iThinkiKhan/gladiator-cad/cad/v2/README.md

# Gladiator v2 frame and body, 2026-10-13 to 2026-10-15 (Claude)

Everything designed in the enclosure/rails chat. Drafts: nothing here has been printed or fitted. Source scripts rebuild every part (`freecadcmd <script>`).
Codex's concept (`cad/enclosure/concept-20261013/`) is the untouched source of the chassis references and stays where it was.

| Folder | What | Status |
|---|---|---|
| `rails/v4-20261015/` | slim arch rails: direct heat-set inserts, deck pegs, shell hard points, switch shelf (right rail) | print-ready plate R |
| `upper-deck/v3-20261015/` | deck that seats on the rail pegs, one retention screw per rail, wire holes, bed-side chamfers | print-ready plate D |
| `print-plates/` | OrcaSlicer plates R (rails) and D (deck), PLA, `START_HERE_v2-plates.txt` | ready for Jim to start |
| `switch-enclosure/v1-20261015/` | open-rear power switch enclosure + bezel, rail-shelf or hood-shelf mount | draft |
| `enclosure/v2-20261013/` | optional shell v2.3: rear hood, two front panels, lens plate; removal sweeps verified | draft |
| `antenna-pylon/v3-20261014/` | replacement SMA pylon (bolt head not recessed) | draft |
| `ina-mount/v3-20261019/` | INA226 upright adapter clipped to the tray's rear wall (header left, terminals right) | draft, plate IM |
| `switch-enclosure/v3-20261016/` | switch holder (rear-open, one M3, M2 side screws) for the rail shelf or the hood cradle | draft, plate SW |
| `upper-deck/v4-20261016/` | deck v4.1 on the measured rails | **printed, fits** |
| `rails/v3-20261014/` | superseded portal rails, kept as record | superseded |
| `images/` (Windows mirror only) | review renders and sections | |

Print order: rails (R), then deck (D). Print the rails first: they carry the inserts and pegs the deck depends on.
