iThinkiKhan/gladiator-cad/cad/mast-base/reprint-20260926/README.md

# Mast base reprint — 2026-09-26

Source: current `cad/master/Gladiator_Master.FCStd`, copied before editing. The master was not changed.

- Spigot below deck: 5.0 → 3.5 mm (1.5 mm shorter); diameter remains 14.0 mm.
- Mast socket upper entry: 0.35 → 0.8 mm by 45°; straight bore remains 20.4 mm.
- Print orientation: upside down with spigot up. The thin collar ring touches the bed; use a brim and support under the outer plate.
- Editable source: `Gladiator_Master_MastBase_short-spigot.FCStd` (whole assembly).
- Print mesh: `Gladiator_MastBase_spigot-3p5_chamfer-0p8_UP.stl`.
- An identical mesh was placed in `~/3D-Printer/Incoming`.
