iThinkiKhan/gladiator-cad/ROUND5_CURRENT.md

# Current Round5 release

cad/v2/enclosure/round5-calibrated-28-20261022/mount-checked-release/DELIVERY/START_HERE.md

Hood9h39m04 and combined panels7h00m34;corrected mounting CAD. Ready files in X:/3D Printer and Incoming Round5_MOUNT_CHECKED_20261022. Earlier hood/CAD superseded. No printer started.
