iThinkiKhan/gladiator-cad/docs/ai/agents/codex-m2-d3-l3-coupon-20261022.md

# M2 D3 L3 coupon — Codex, 2026-10-22

Jim supplied a listing screenshot: M2 x D3 x L3 (100 pcs). Treat 3 mm OD and 3 mm length as nominal listing data pending stock measurement. The listing's 2 mm item diameter / 2.2 mm groove are not pilot-bore dimensions.

New isolated package: cad/coupons/m2-d3-l3-20261022/. 80 x 25 x 9.89 mm coupon, 2.60–3.30 mm diameters in 0.10 steps, 8 vertical + 8 horizontal blind bores, 3.60 depth, 0.15 entry chamfer. Labels over each bore. Existing M2-A and production CAD preserved.

Native/STEP reopen, all 16 bore void/floor/wall checks, manifold STL, 3MF/STL agreement, and OrcaSlicer 2.4.2 slice without warnings passed. EnderNeo PLA profile, 0.20 layers, 4 walls, 25% infill, no supports. New named 3MF copied to Incoming; no print started. Editable builder, README, results CSV and verification JSON included.

Next: check stock OD/length; print and test using intended project material/profile; report separate upright and horizontal winners and installation conditions. Confirm repeatability with fresh inserts before applying bore values. No winner recorded as measured and no project bore changed.

## Simplified at Jim's request, 2026-10-22

Current choice: cad/coupons/m2-d3-l3-mini-20261022/, four upright bores 2.8/2.9/3.0/3.1, depth 3.6, 40 x 13 x 6 mm. Native/STEP/STL and four blind-bore checks pass; Orca slice without warnings. Replaced only the previously generated named Incoming coupon with this smaller version. The earlier full package remains preserved. Physical winner pending; horizontal fit untested by the mini coupon.
