iThinkiKhan/gladiator-cad/cad/v2/switch-enclosure/v2-20261016/README.md

# Switch enclosure v2 - ON HOLD, 2026-10-16

Jim's switch is already wired and cannot be unwired, so the v1 box (switch pushed in from the front, pins through a rear window) cannot take it. I drafted v2 (open top and open rear, wired switch drops in, lid screws over it) and Jim then said he wants the switch box to be
essentially what he already has, with dedicated mount points on the rails and the shell, mounted from the shell interior, and the rails NOT reprinted. v2 is therefore not released: no plate is queued. The geometry is kept (`build_switch_box_v2.py`) in case it is useful.

Superseded by `../v3-20261016/` (the holder Jim already has, slightly stronger, with the new mount).
