iThinkiKhan/gladiator-cad/cad/antenna/v3-screw-access/preview-axo.png

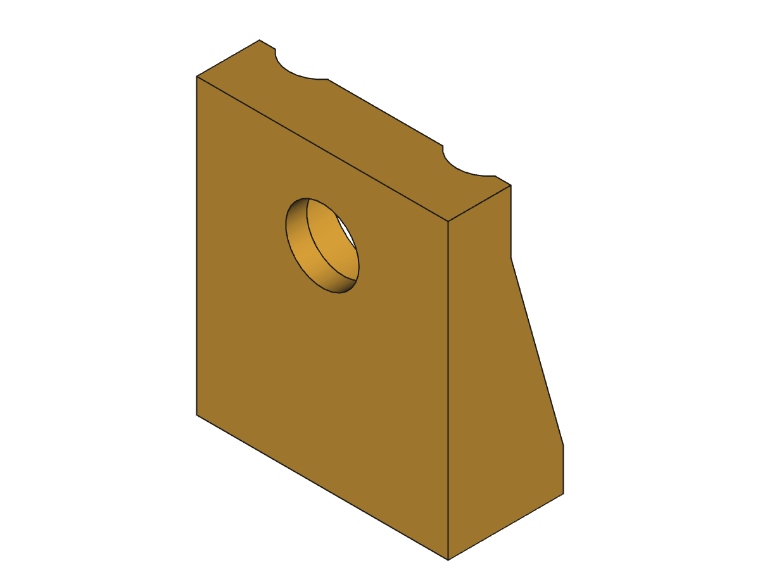
cad/antenna/v3-screw-access/preview-axo.png
