iThinkiKhan/gladiator-cad/cad/antenna/v3-screw-access/preview-screw-access.png

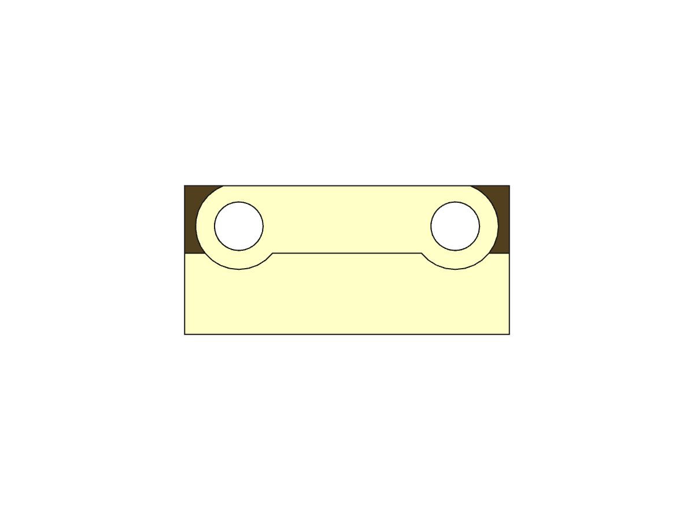
cad/antenna/v3-screw-access/preview-screw-access.png
