iThinkiKhan/gladiator-cad/cad/coupons/m2-d3-l3-20261022/preview.png

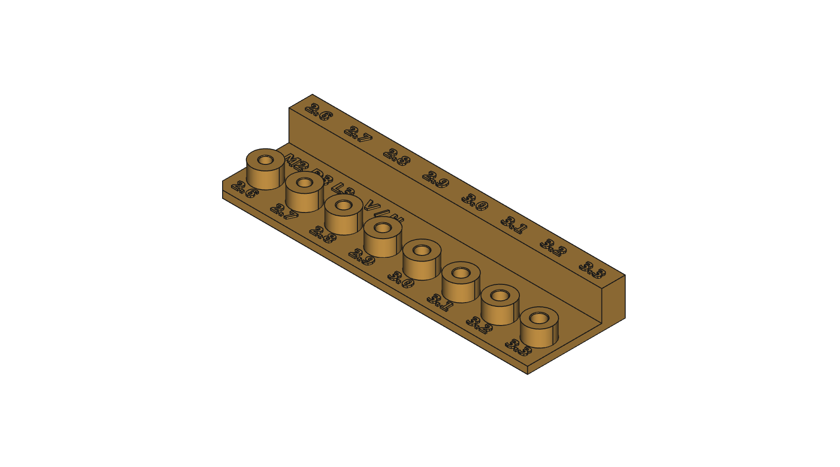
cad/coupons/m2-d3-l3-20261022/preview.png
