iThinkiKhan/gladiator-cad/cad/drivers/v5-interlock/preview-coupon.png

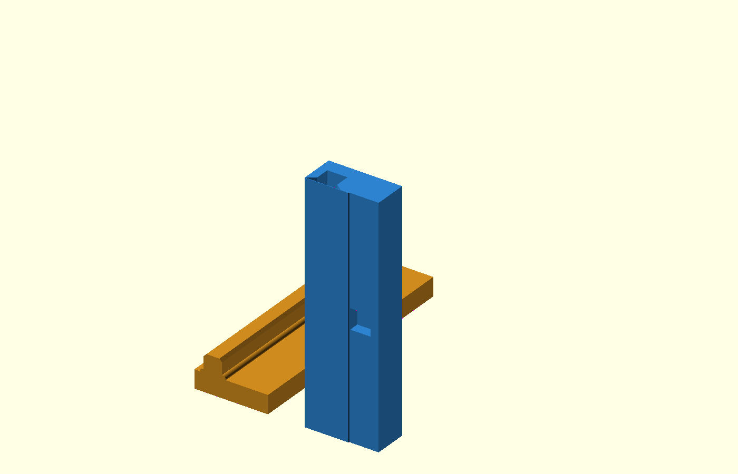
cad/drivers/v5-interlock/preview-coupon.png
