iThinkiKhan/gladiator-cad/cad/drivers/v5-interlock/preview-structural.png

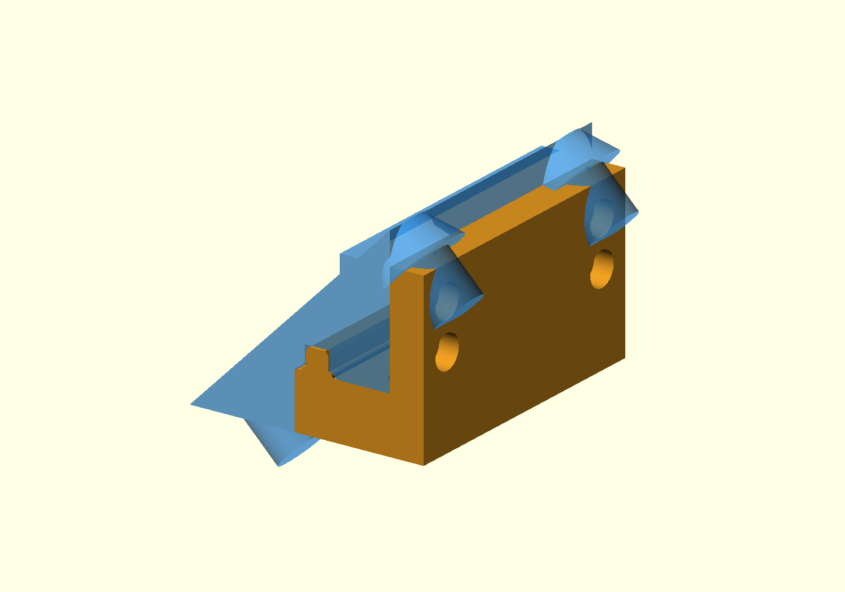
cad/drivers/v5-interlock/preview-structural.png
