iThinkiKhan/gladiator-cad/cad/enclosure/concept-20261013/body.png

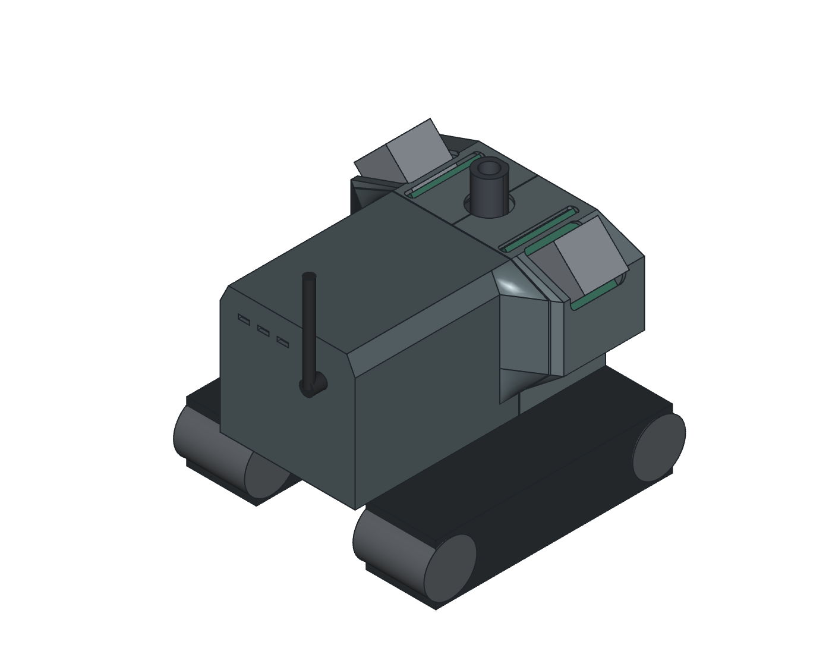
cad/enclosure/concept-20261013/body.png
