iThinkiKhan/gladiator-cad/cad/head/drive-coupons-20260922/preview-section.png

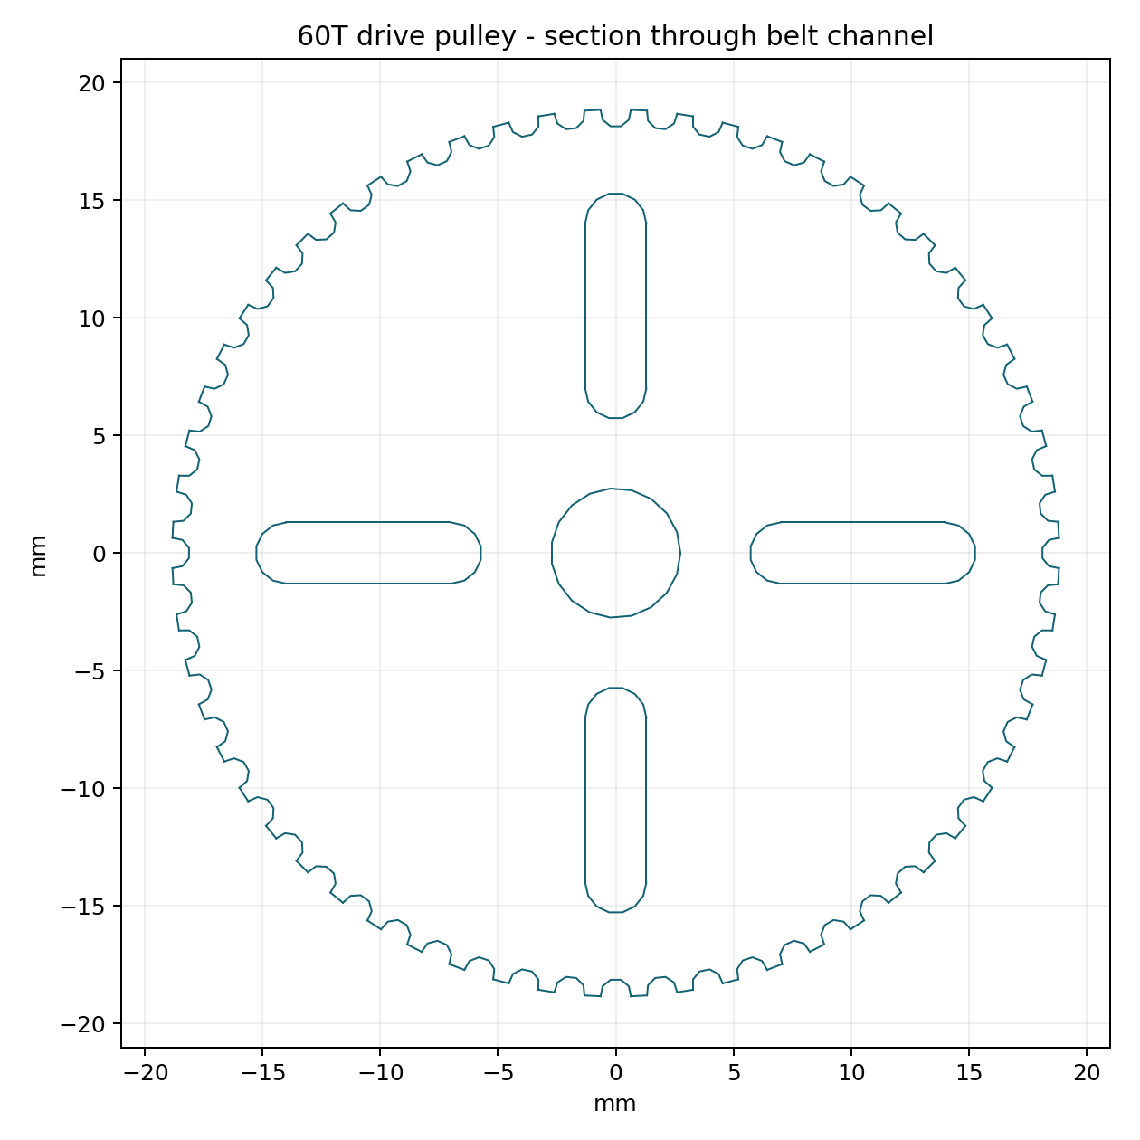
cad/head/drive-coupons-20260922/preview-section.png
