iThinkiKhan/gladiator-cad/cad/head/esp32-cam-case-v4/case_preview.png

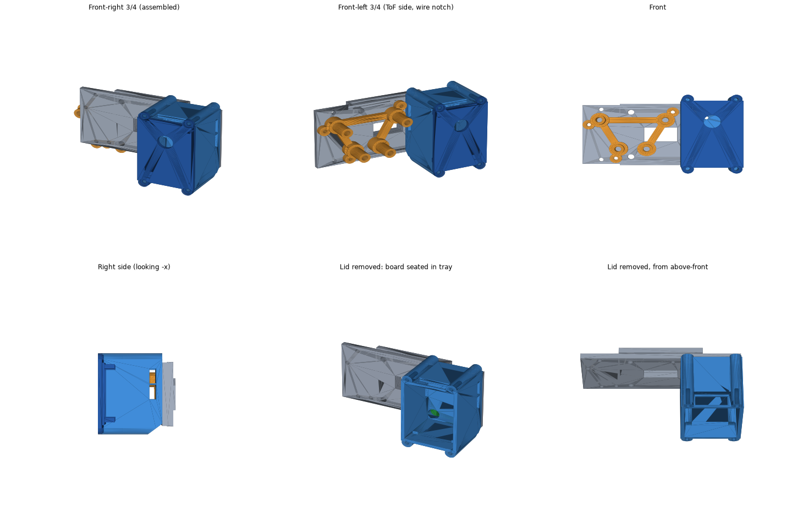
cad/head/esp32-cam-case-v4/case_preview.png
