iThinkiKhan/gladiator-cad/cad/head/master/preview-rear.png

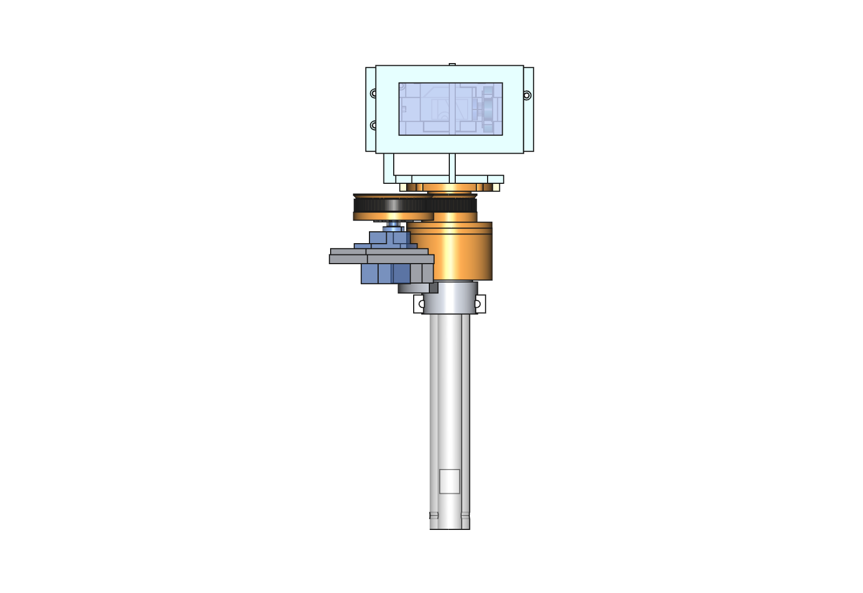
cad/head/master/preview-rear.png
