iThinkiKhan/gladiator-cad/cad/head/master/preview-right.png

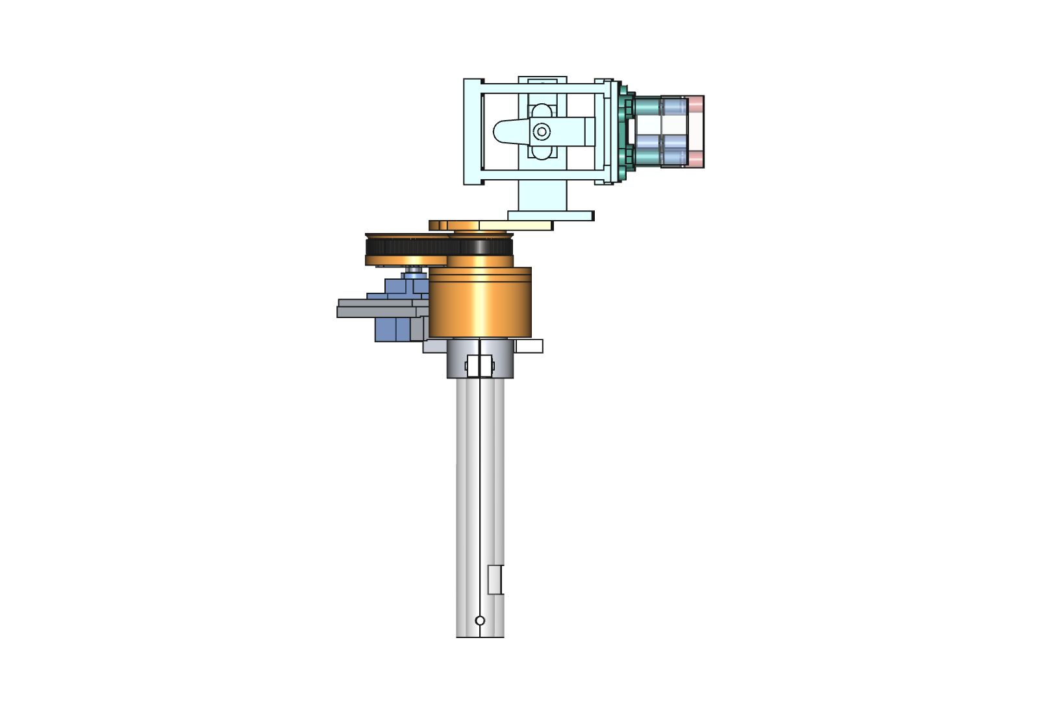
cad/head/master/preview-right.png
