iThinkiKhan/gladiator-cad/cad/head/orca-plates/support-map-A.png

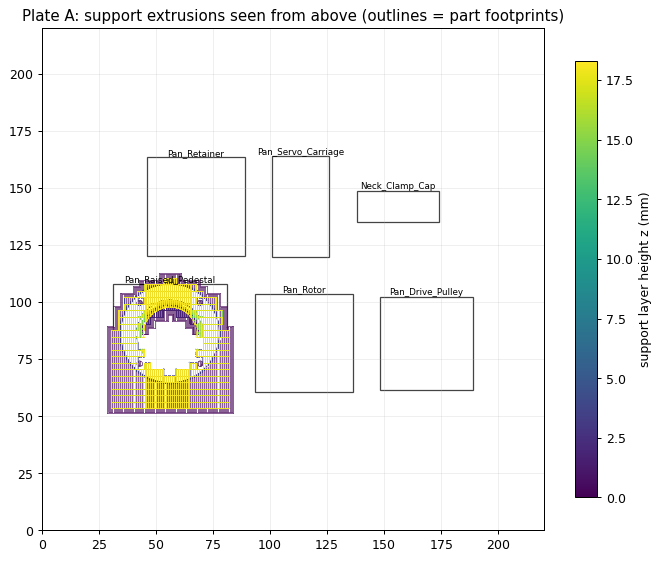
cad/head/orca-plates/support-map-A.png
