iThinkiKhan/gladiator-cad/cad/head/orca-plates/support-map-B.png

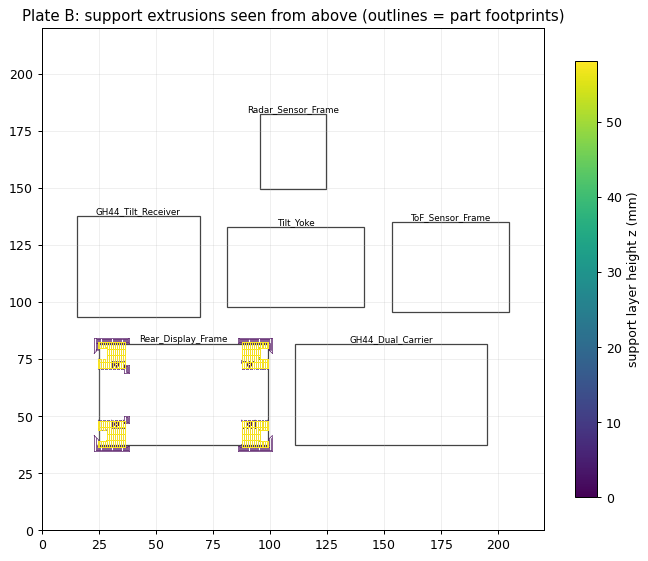
cad/head/orca-plates/support-map-B.png
