iThinkiKhan/gladiator-cad/cad/head/orca-plates/support-map-C.png

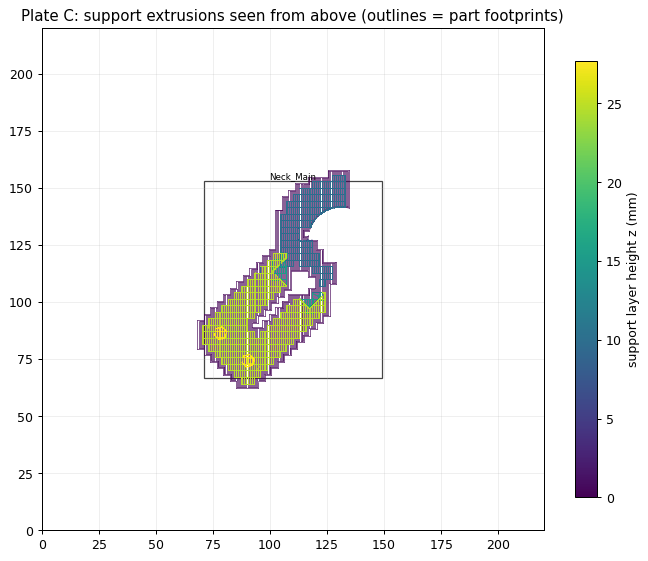
cad/head/orca-plates/support-map-C.png
