iThinkiKhan/gladiator-cad/cad/head/v01/modular-head-preview.png

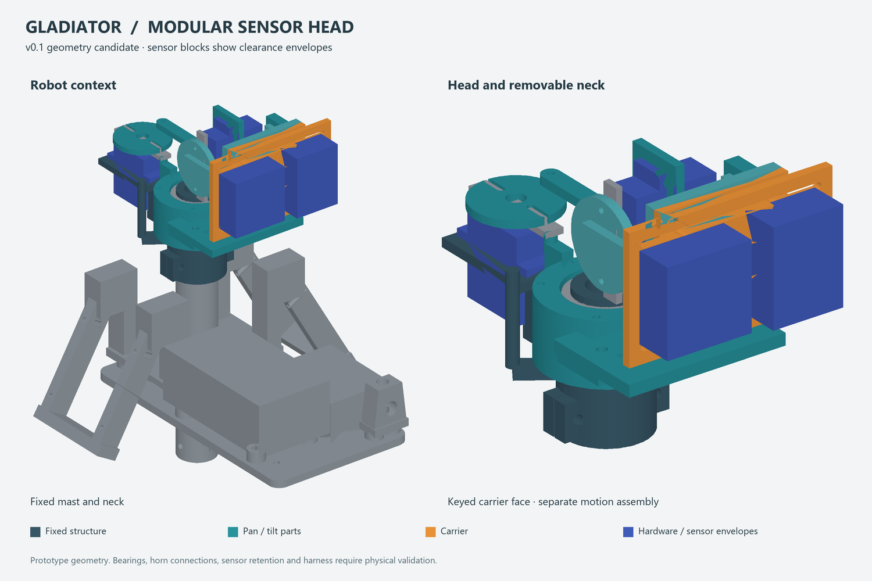
cad/head/v01/modular-head-preview.png
