iThinkiKhan/gladiator-cad/cad/head/v02-screen-180/head-v01-v02-comparison.png

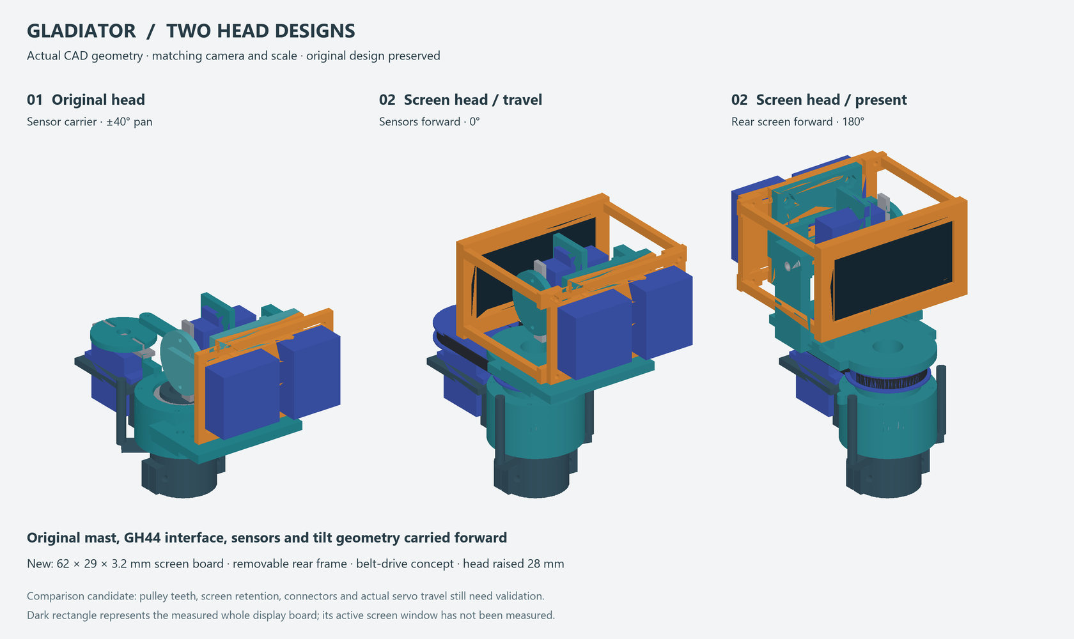
cad/head/v02-screen-180/head-v01-v02-comparison.png
