iThinkiKhan/gladiator-cad/cad/power-board/ina-cassette-v2/ina-cassette-v2.png

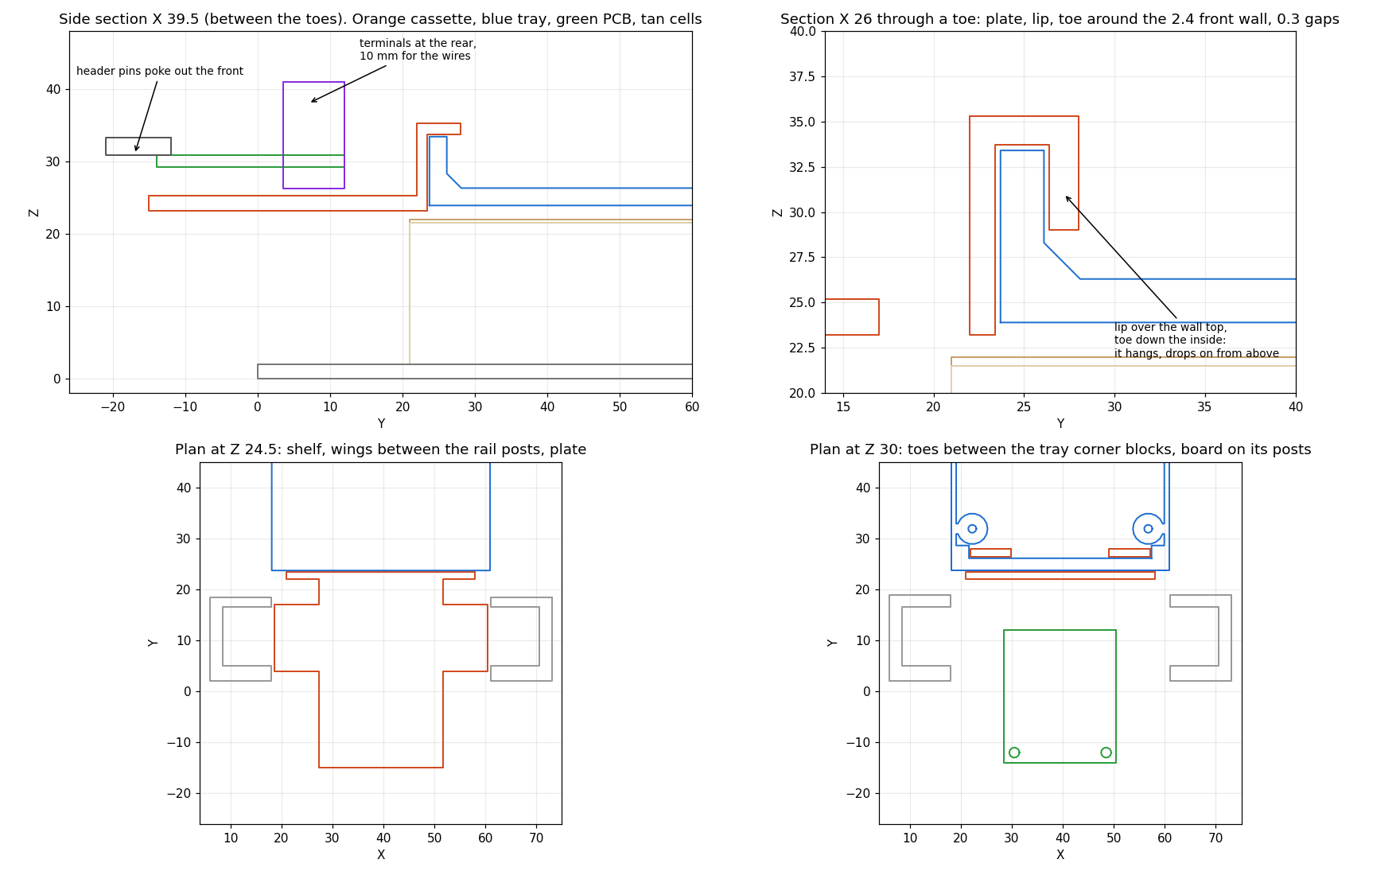
cad/power-board/ina-cassette-v2/ina-cassette-v2.png
