iThinkiKhan/gladiator-cad/cad/power-board/v3-cradle/tray-v3-vs-v2.png

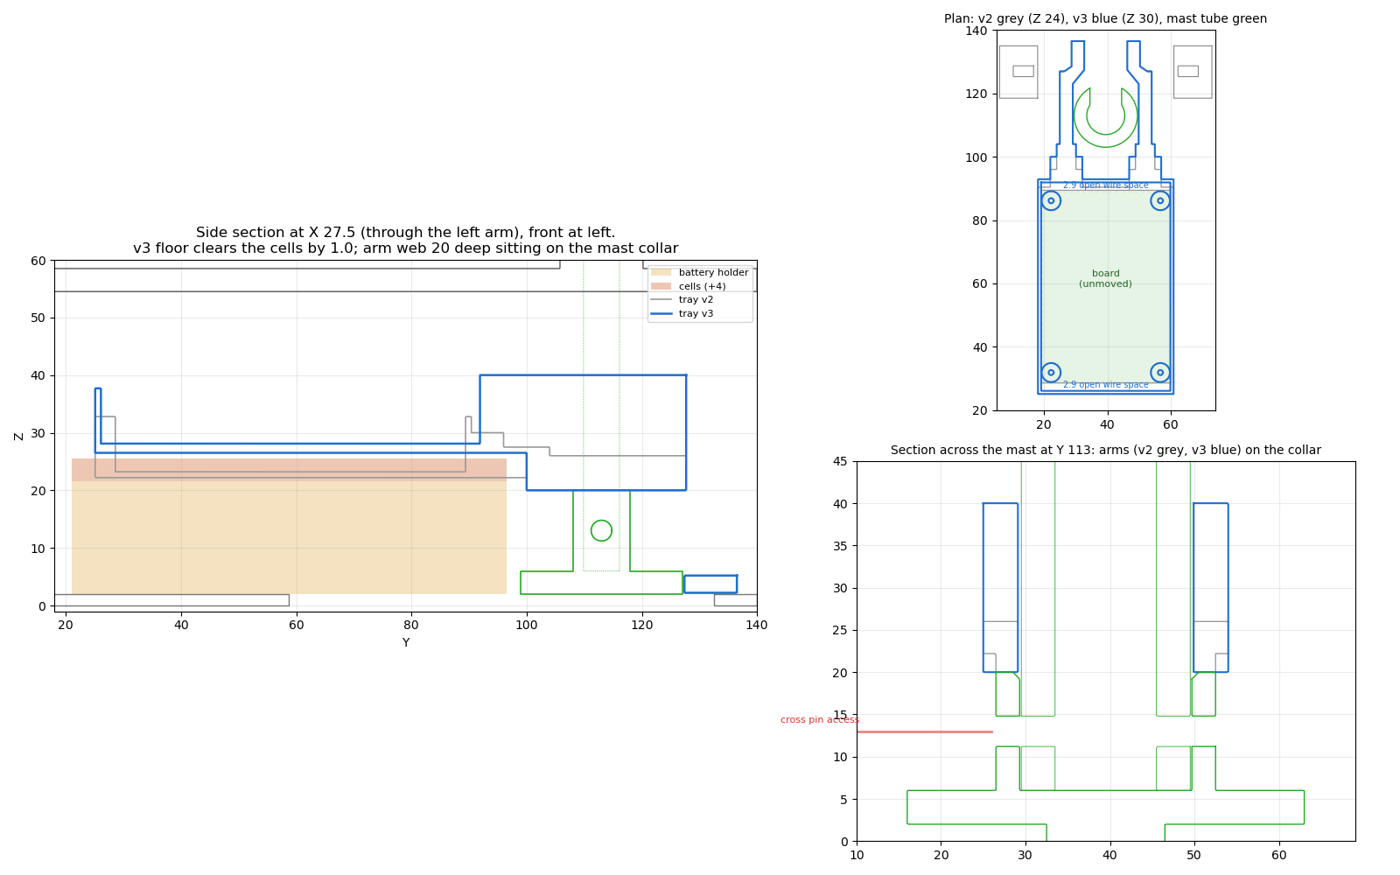
cad/power-board/v3-cradle/tray-v3-vs-v2.png
