iThinkiKhan/gladiator-cad/cad/power-board/v5-tray/tray-v5.png

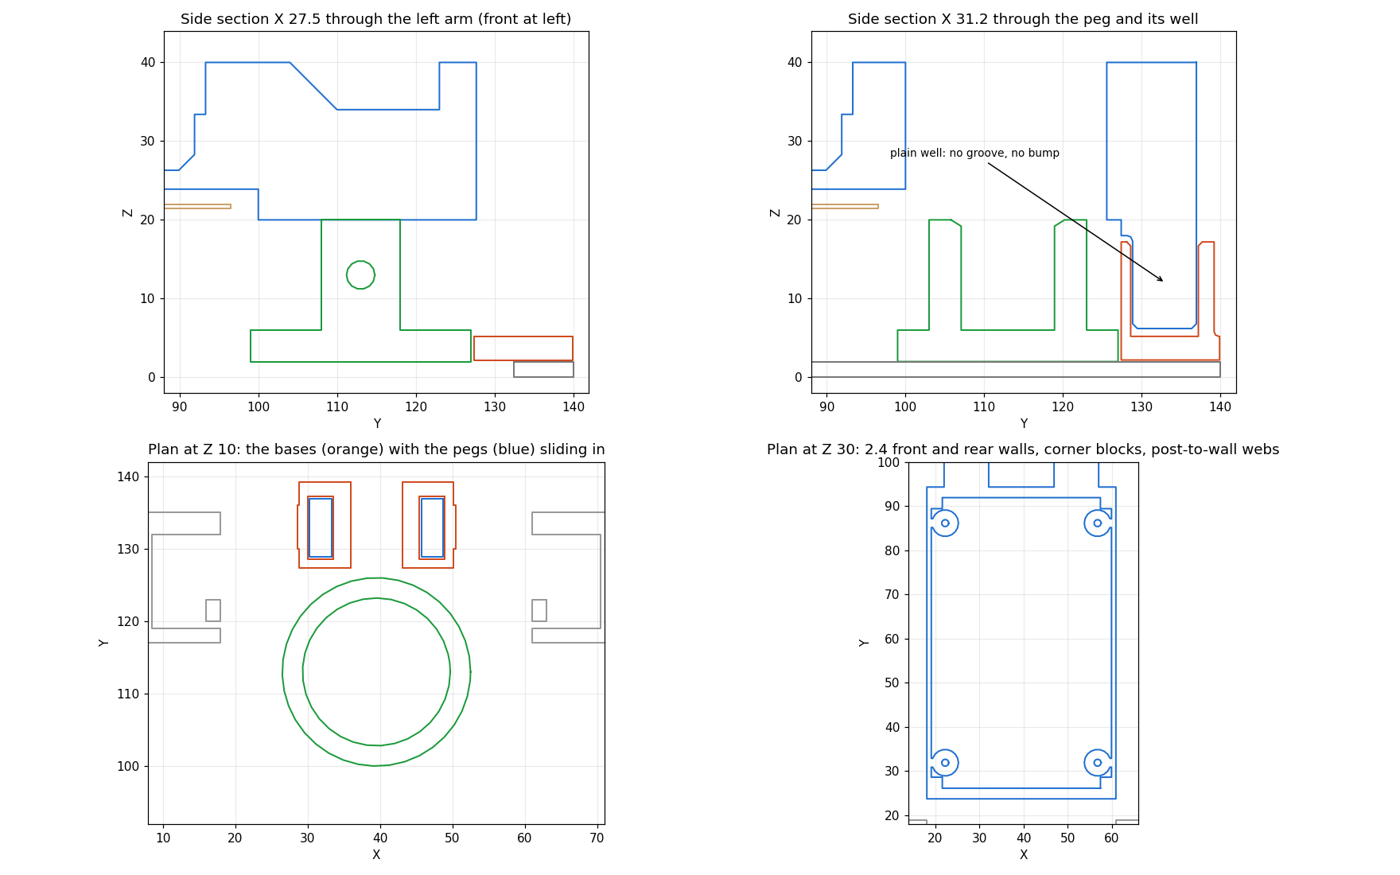
cad/power-board/v5-tray/tray-v5.png
