iThinkiKhan/gladiator-cad/cad/power-switch/v1/switch-holder-v1.png

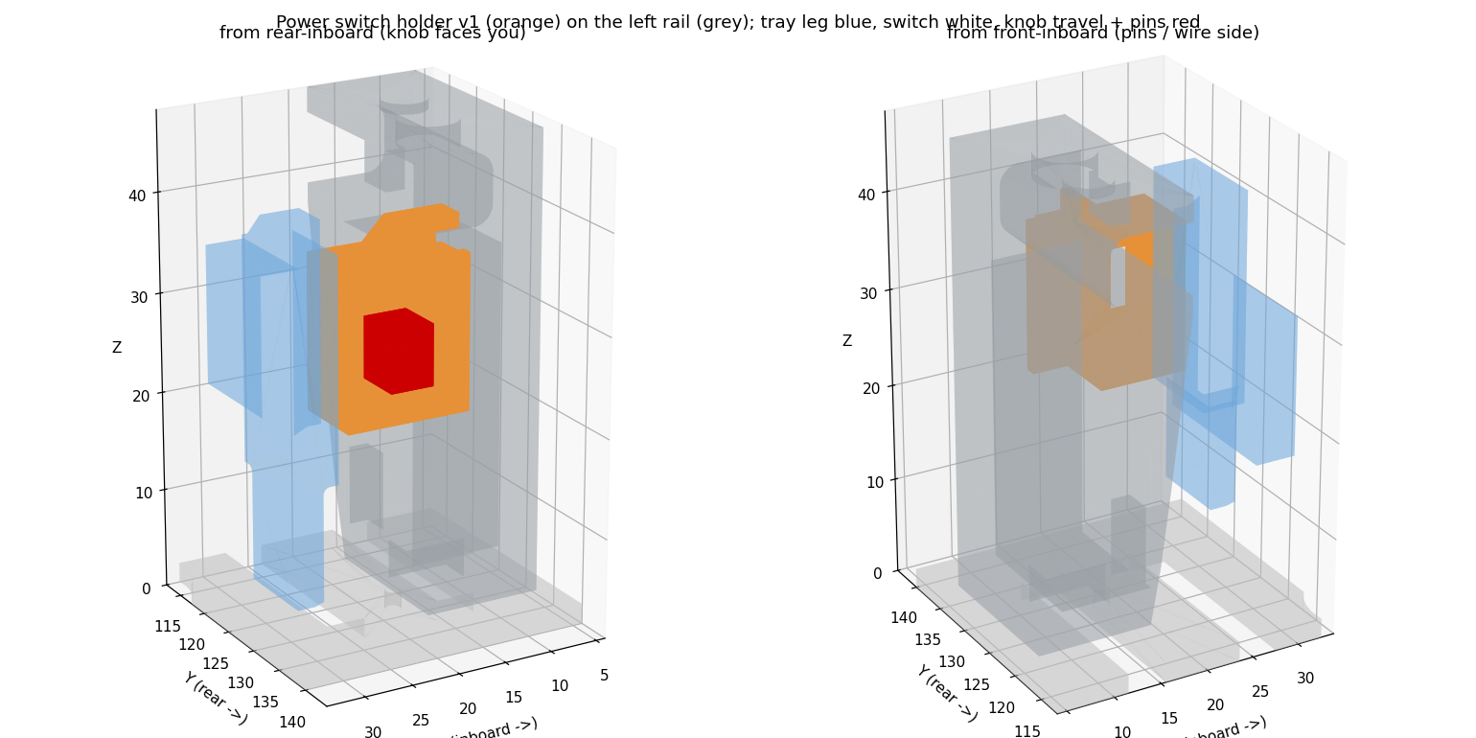
cad/power-switch/v1/switch-holder-v1.png
