iThinkiKhan/gladiator-cad/cad/v2/enclosure/round5-20261021/head-detail.png

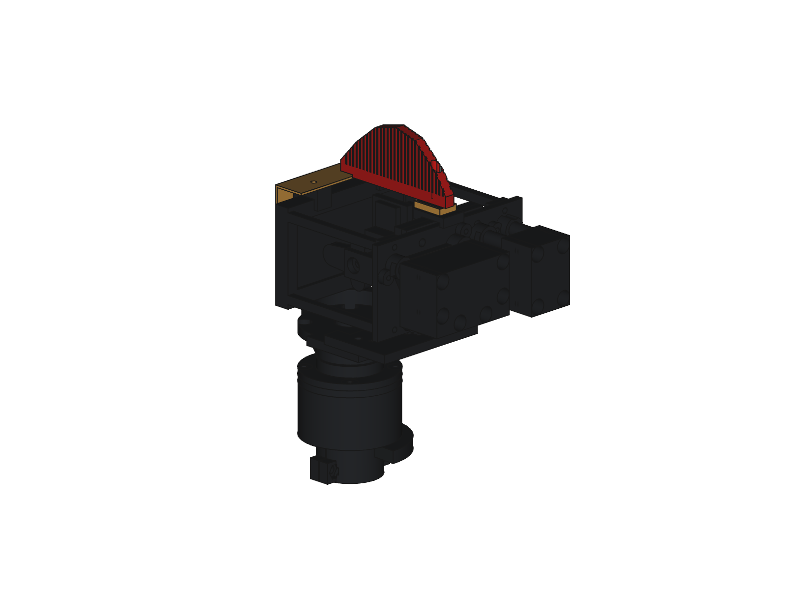
cad/v2/enclosure/round5-20261021/head-detail.png
