iThinkiKhan/gladiator-cad/cad/v2/enclosure/round5-20261021/round5-front.png

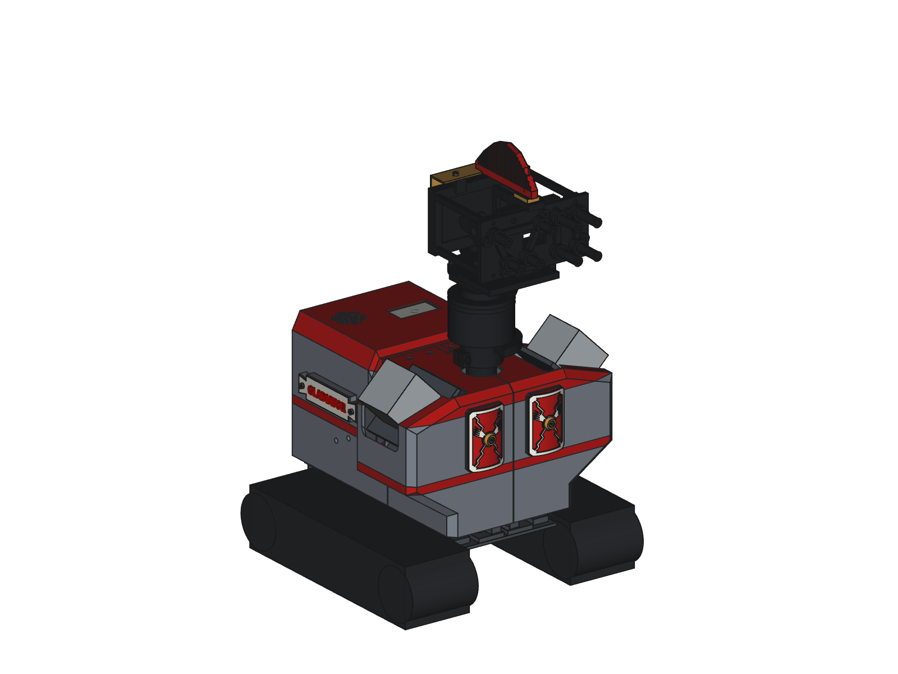
cad/v2/enclosure/round5-20261021/round5-front.png
