iThinkiKhan/gladiator-cad/cad/v2/enclosure/round5-20261021/round5-rear.png

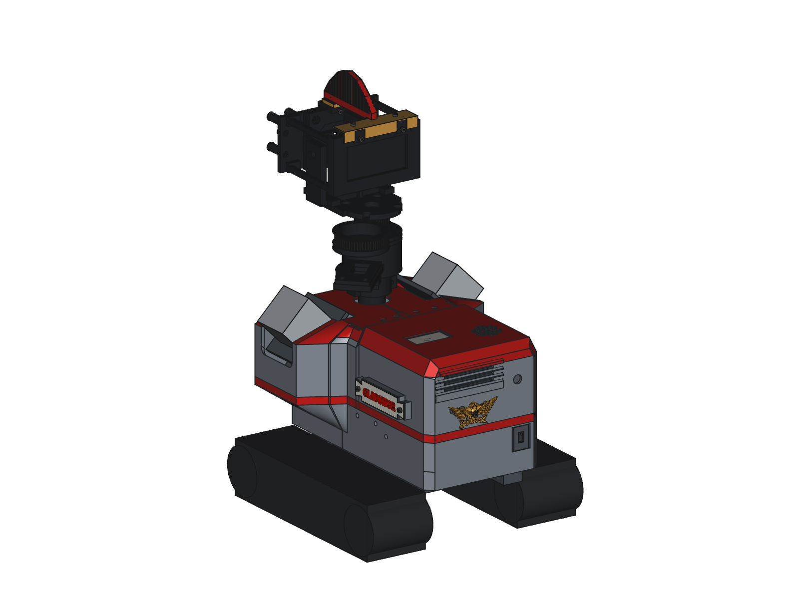
cad/v2/enclosure/round5-20261021/round5-rear.png
