iThinkiKhan/gladiator-cad/cad/v2/enclosure/round5-20261021/round5-side.png

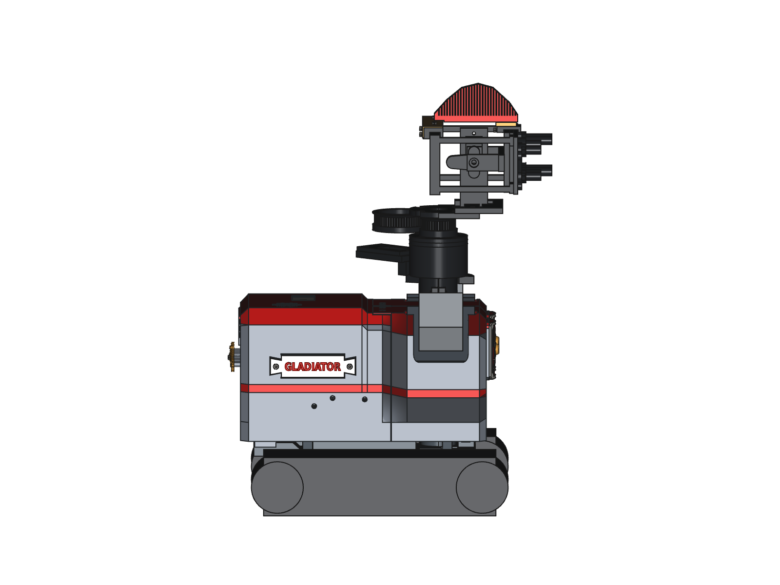
cad/v2/enclosure/round5-20261021/round5-side.png
