iThinkiKhan/gladiator-cad/cad/v2/enclosure/v2-20261013/closeup_left.png

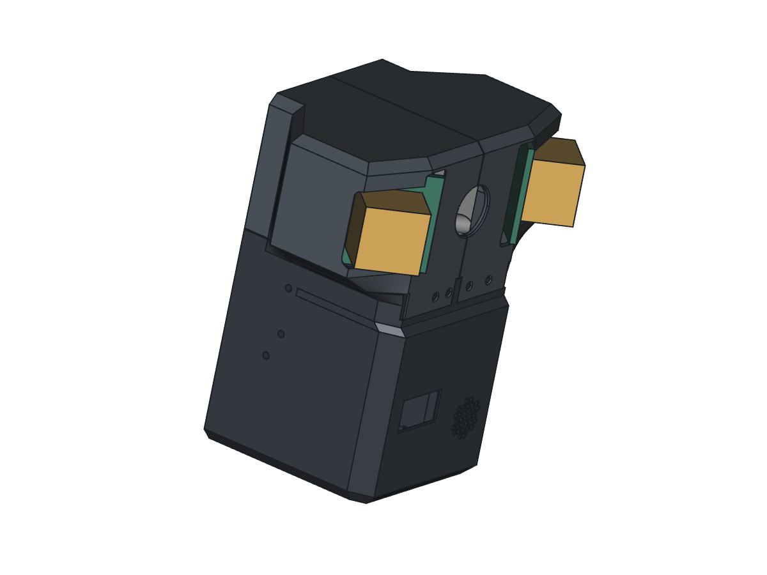
cad/v2/enclosure/v2-20261013/closeup_left.png
