iThinkiKhan/gladiator-cad/cad/v2/enclosure/v2-20261013/closeup_left_low.png

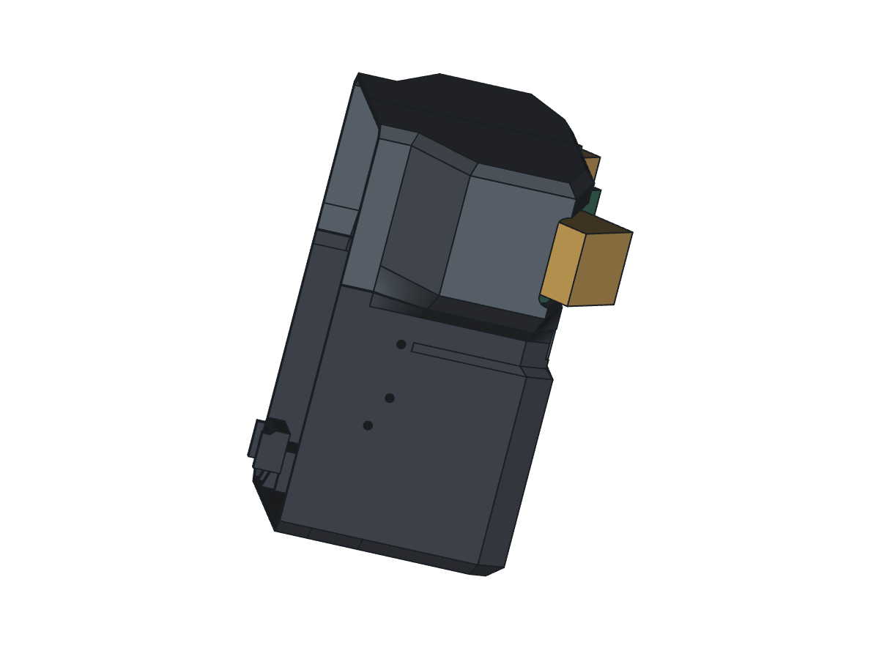
cad/v2/enclosure/v2-20261013/closeup_left_low.png
