iThinkiKhan/gladiator-cad/cad/v2/enclosure/v2-20261013/render_no_head_rear.png

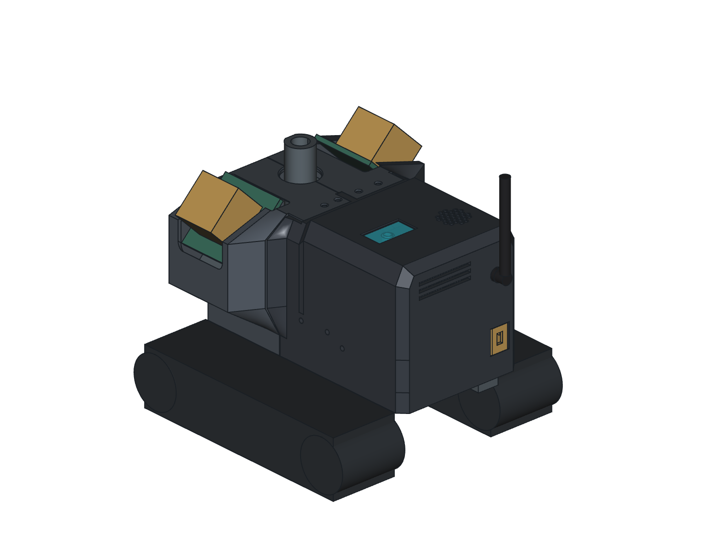
cad/v2/enclosure/v2-20261013/render_no_head_rear.png
