iThinkiKhan/gladiator-cad/cad/v2/enclosure/v2-20261013/render_side_right.png

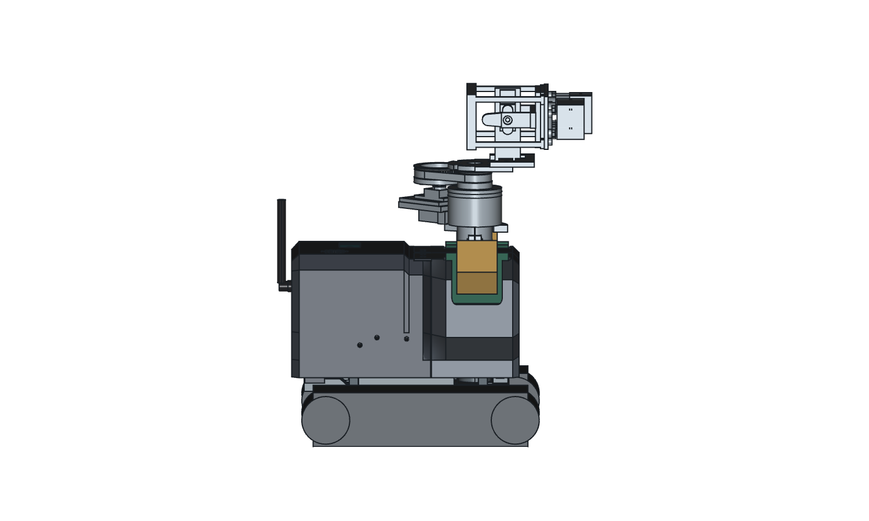
cad/v2/enclosure/v2-20261013/render_side_right.png
