iThinkiKhan/gladiator-cad/cad/v2/enclosure/v2-20261013/render_switch.png

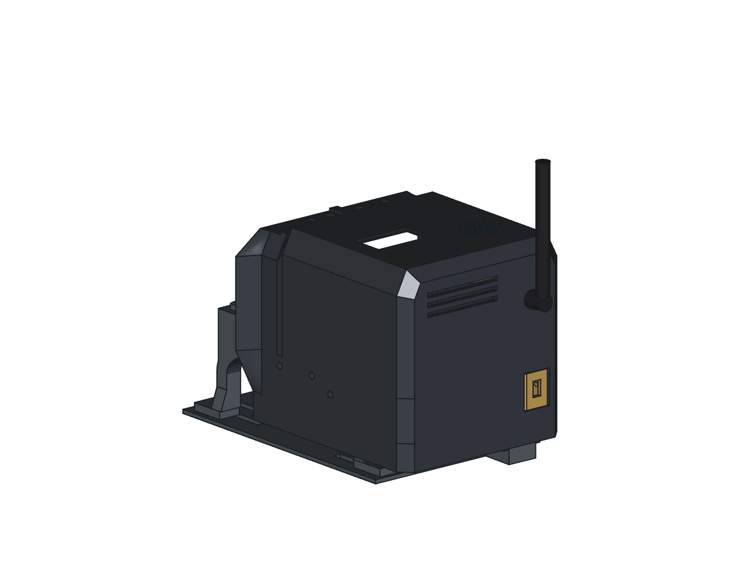
cad/v2/enclosure/v2-20261013/render_switch.png
