iThinkiKhan/gladiator-cad/cad/v2/enclosure/v2-20261013/section_fins_v28.png

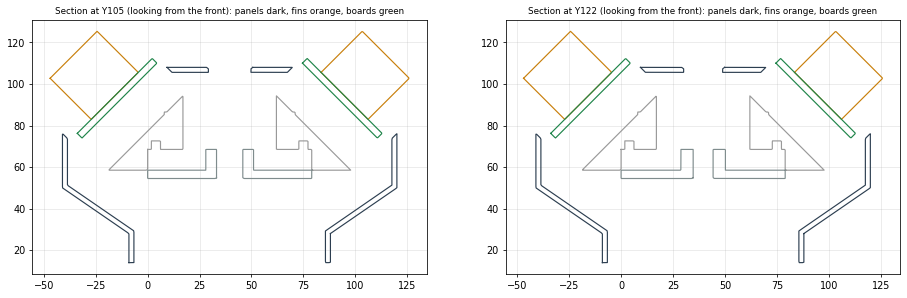
cad/v2/enclosure/v2-20261013/section_fins_v28.png
