iThinkiKhan/gladiator-cad/cad/v2/enclosure/v2-20261013/sections_v2.png

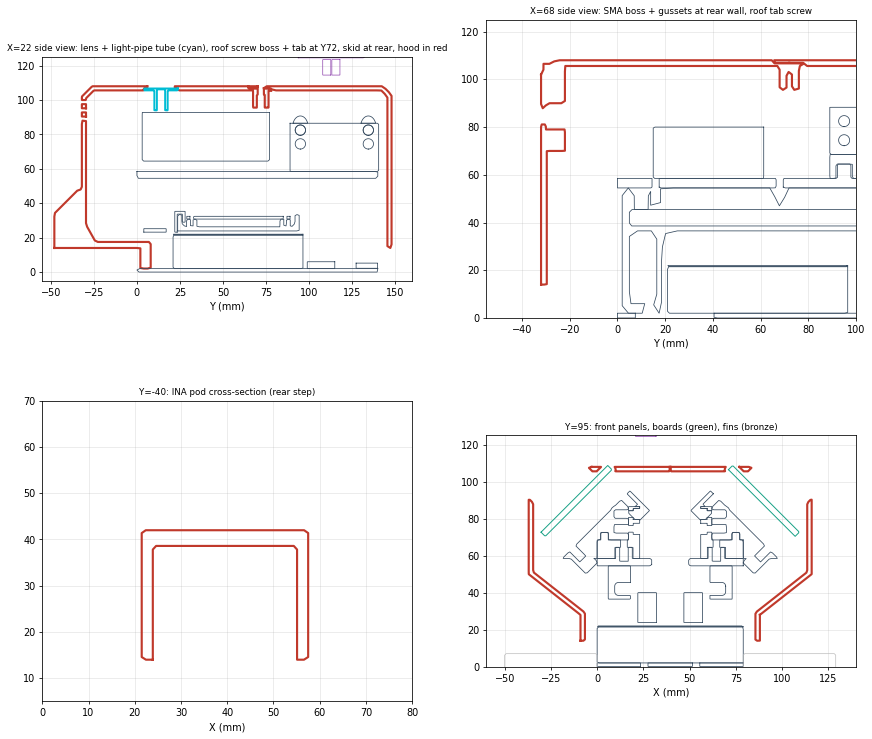
cad/v2/enclosure/v2-20261013/sections_v2.png
