iThinkiKhan/gladiator-cad/cad/v2/enclosure/v2-20261013/sma_mount_v2.png

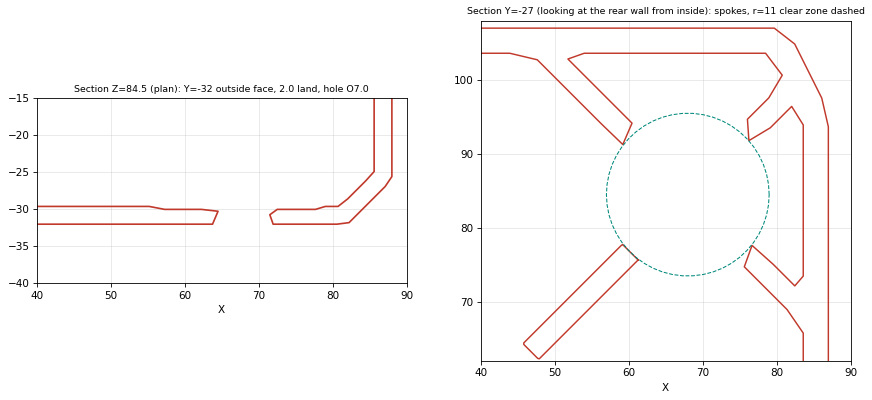
cad/v2/enclosure/v2-20261013/sma_mount_v2.png
