iThinkiKhan/gladiator-cad/cad/v2/ina-mount/v3-20261019/ina_mount_v3_sections.png

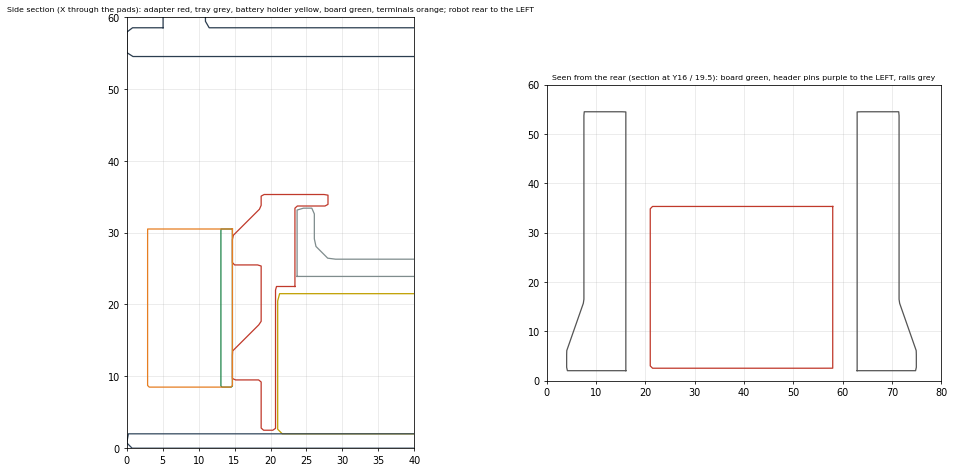
cad/v2/ina-mount/v3-20261019/ina_mount_v3_sections.png
