iThinkiKhan/gladiator-cad/cad/v2/rails/v3-20261014/rails_v3_sections.png

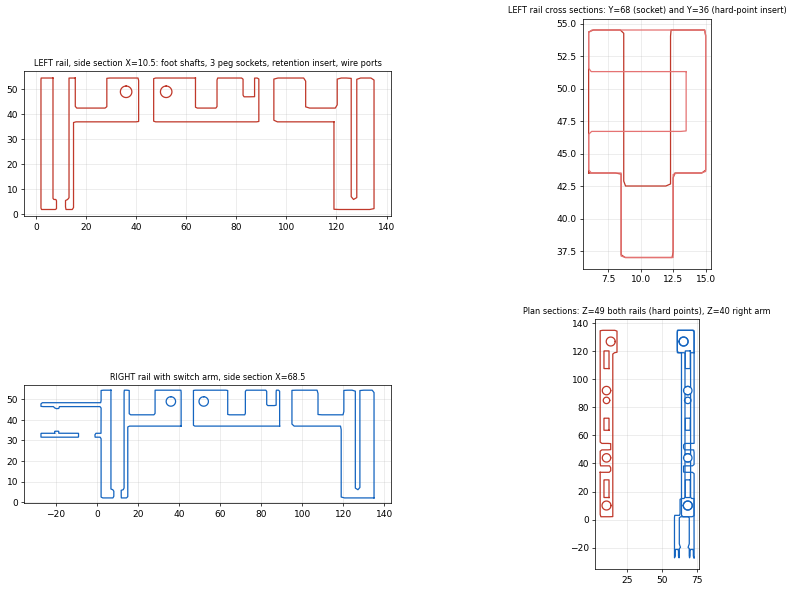
cad/v2/rails/v3-20261014/rails_v3_sections.png
