iThinkiKhan/gladiator-cad/cad/v2/upper-deck/v3-20261015/deck_v3_sections.png

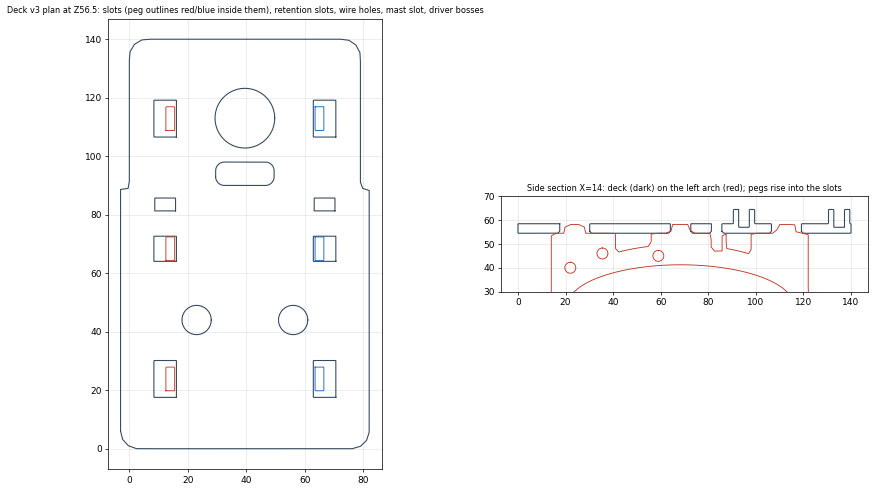
cad/v2/upper-deck/v3-20261015/deck_v3_sections.png
