iThinkiKhan/gladiator-cad/cad/head/camera-service-v2-20261021/preview/assembled_board_local.stl

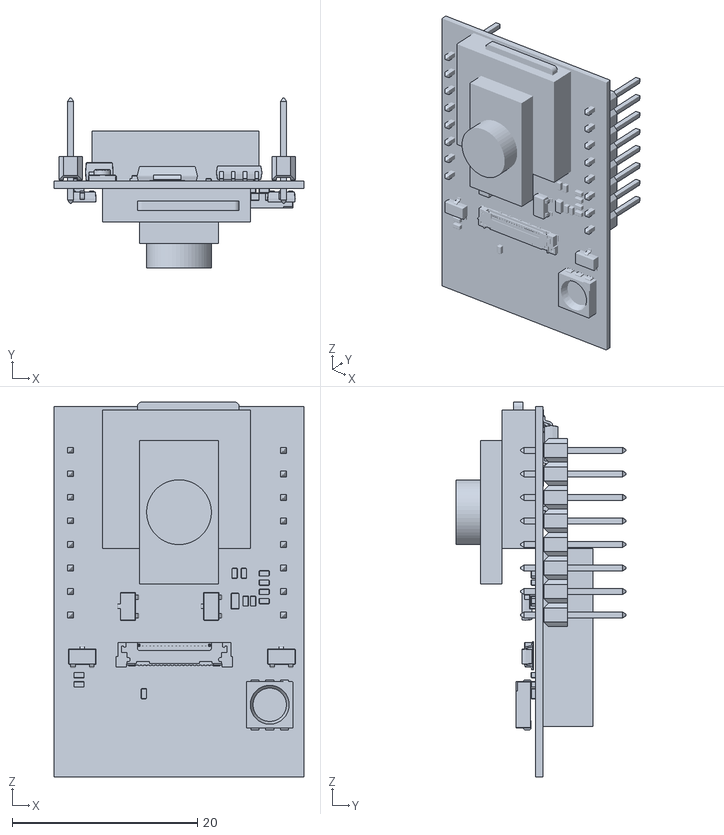
[picture p51: CAD file, 2026-10-22]
cad/head/camera-service-v2-20261021/preview/assembled_board_local.stl
27.0 x 18.4 x 40.5
