iThinkiKhan/gladiator-cad/cad/head/esp32-cam-case-v4/preview/assembled_lid_local.stl

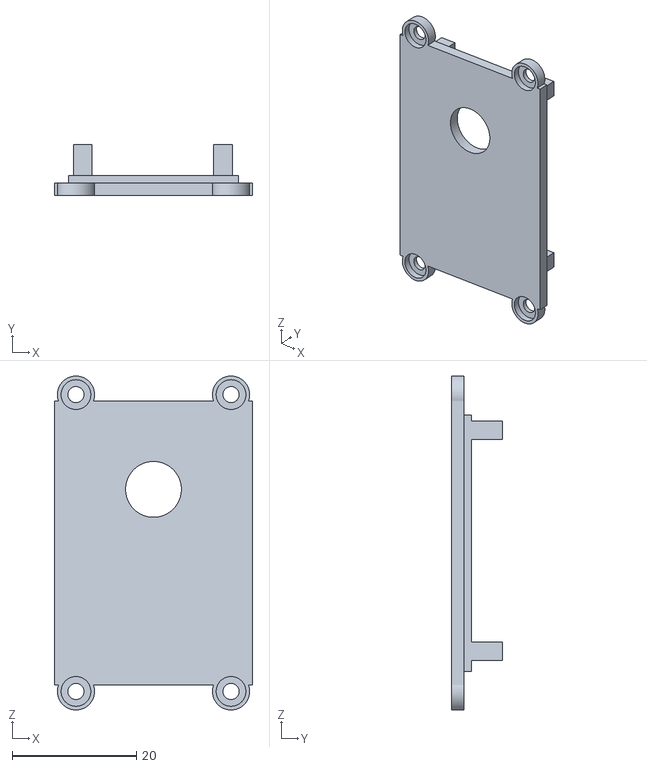
[picture p52: CAD file, 2026-10-22]
cad/head/esp32-cam-case-v4/preview/assembled_lid_local.stl
31.9 x 8.20 x 53.8
