iThinkiKhan/gladiator-cad/cad/head/integration-20261005/delivery/Gladiator_MastHead_v05_20261005/mechanical-plates-v04/Gladiator_Head_v04_PLATE4_Neck_Main.3mf

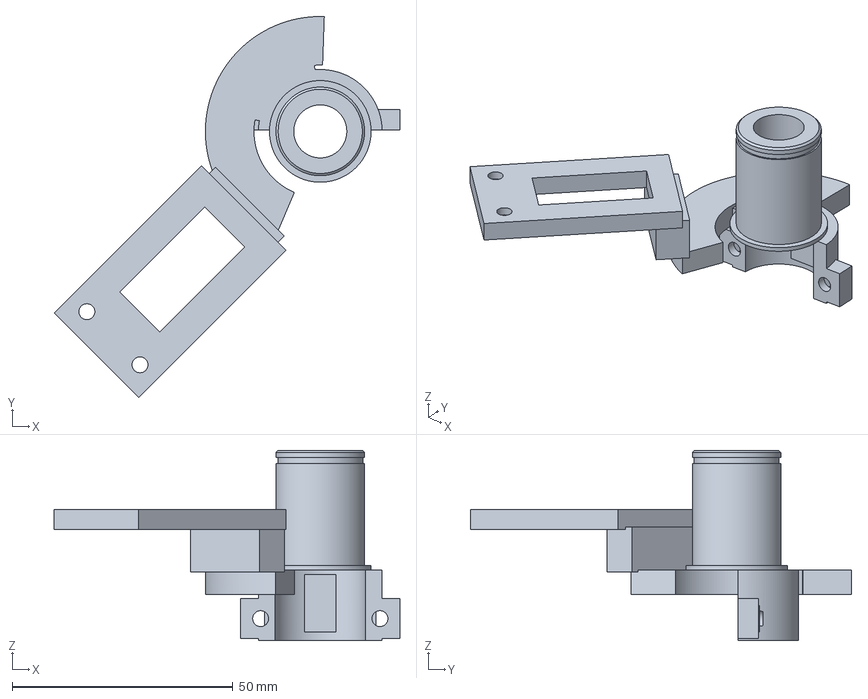
[picture p53: CAD file, 2026-10-22]
cad/head/integration-20261005/delivery/Gladiator_MastHead_v05_20261005/mechanical-plates-v04/Gladiator_Head_v04_PLATE4_Neck_Main.3mf
78.2 x 86.2 x 43.1 mm
