iThinkiKhan/gladiator-cad/cad/head/camera-service-v2-20261021/preview/assembled_tray_local.stl

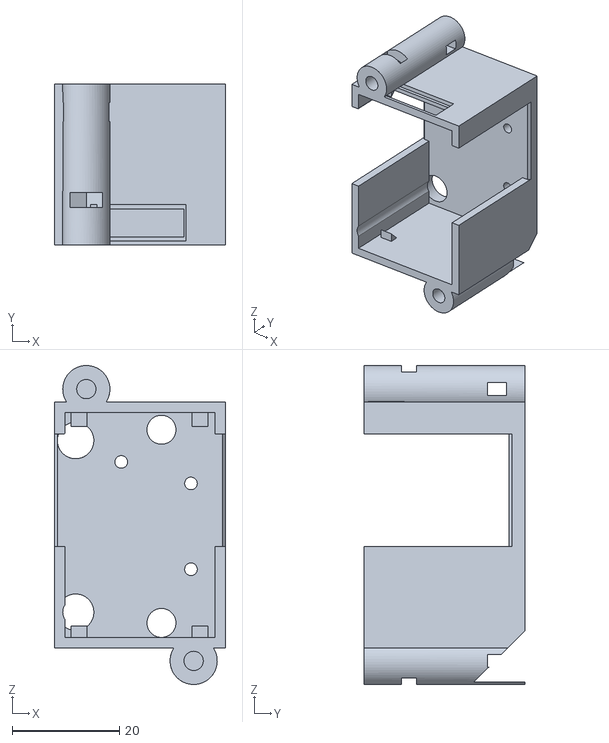
[picture p54: CAD file, 2026-10-22]
cad/head/camera-service-v2-20261021/preview/assembled_tray_local.stl
31.9 x 30.0 x 59.5
