iThinkiKhan/gladiator-cad/cad/enclosure/concept-20261013/Gladiator_Enclosure_Assembly_CONCEPT.step

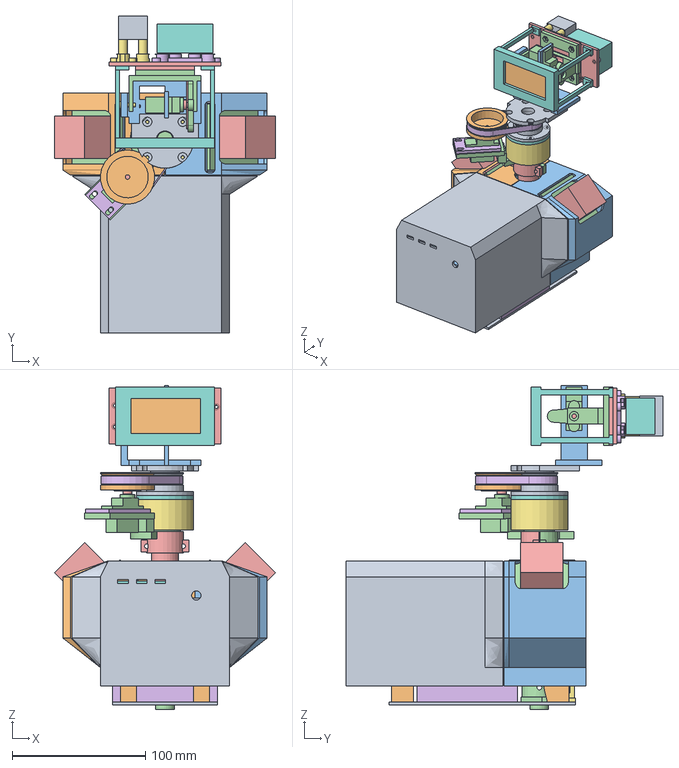
[picture p55: CAD file, 2026-10-21]
cad/enclosure/concept-20261013/Gladiator_Enclosure_Assembly_CONCEPT.step
165.8 x 237.6 x 243.0 mm
