iThinkiKhan/gladiator-cad/cad/head/camera-service-v2-20261021/preview/assembled_lid_local.stl

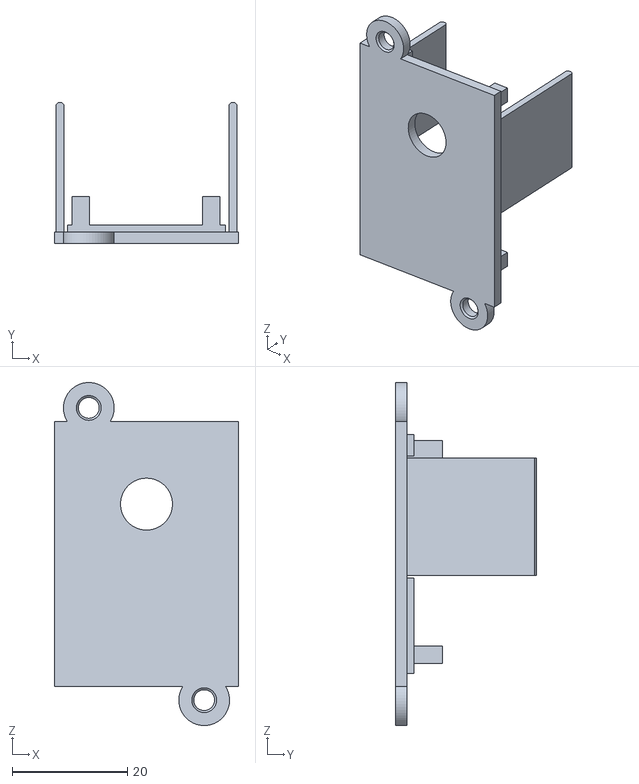
[picture p56: CAD file, 2026-10-22]
cad/head/camera-service-v2-20261021/preview/assembled_lid_local.stl
31.9 x 24.5 x 59.4
