iThinkiKhan/gladiator-cad/cad/head/esp32-cam-case-v4/preview/assembled_tray_local.stl

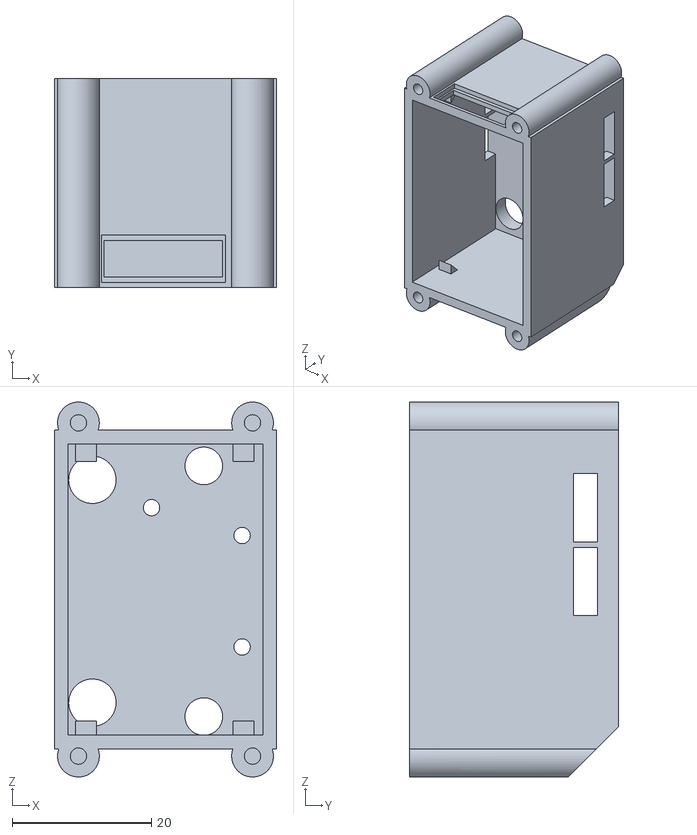
[picture p57: CAD file, 2026-10-22]
cad/head/esp32-cam-case-v4/preview/assembled_tray_local.stl
31.9 x 30.0 x 53.8
