iThinkiKhan/gladiator-cad/cad/head/v03-belt/stl/Gladiator_Head_Neck_Main.stl

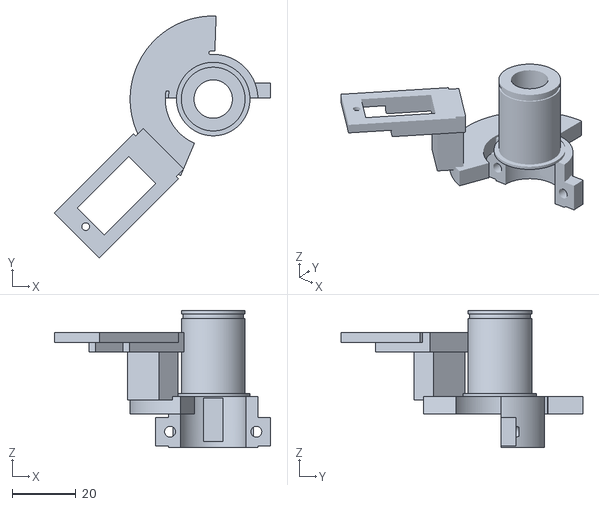
[picture p58: CAD file, 2026-09-19]
cad/head/v03-belt/stl/Gladiator_Head_Neck_Main.stl
67.7 x 75.7 x 43.0
