iThinkiKhan/gladiator-cad/cad/build2-20260927/Gladiator_MastBase_v2-holes-43p4_print-spigot-UP.stl

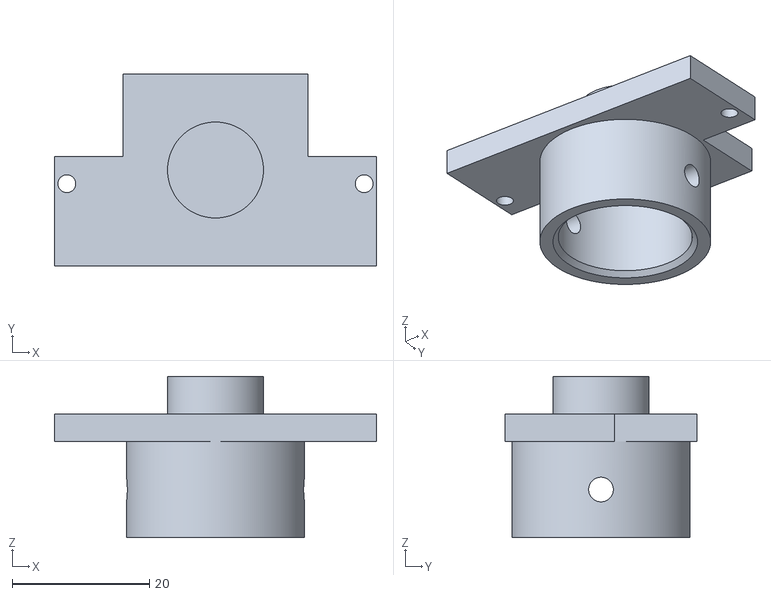
[picture p59: CAD file, 2026-09-27]
cad/build2-20260927/Gladiator_MastBase_v2-holes-43p4_print-spigot-UP.stl
47.0 x 28.0 x 23.5
