iThinkiKhan/gladiator-cad/cad/coupons/Gladiator_Coupon_D_SmaBore.FCStd

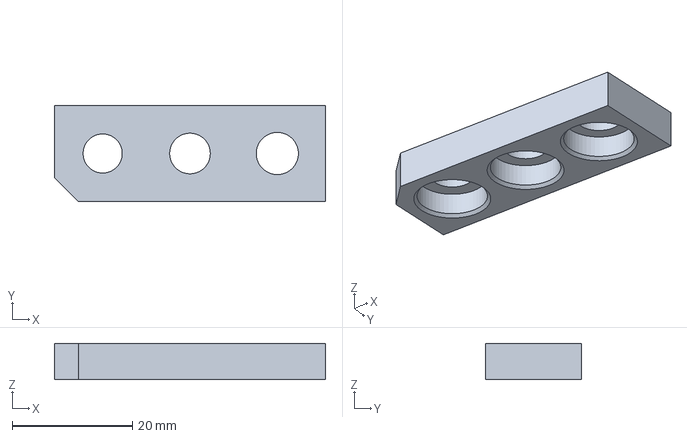
[picture p60: CAD file, 2026-09-20]
cad/coupons/Gladiator_Coupon_D_SmaBore.FCStd
45.0 x 16.0 x 6.00 mm
