iThinkiKhan/gladiator-cad/cad/coupons/m2-d3-l3-20261022/M2_D3_L3_Coupon.step

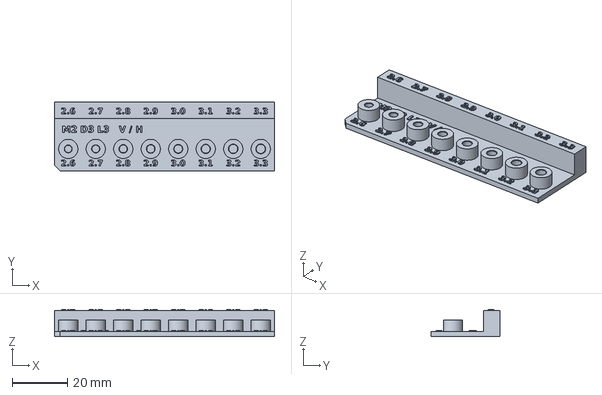
[picture p61: CAD file, 2026-10-22]
cad/coupons/m2-d3-l3-20261022/M2_D3_L3_Coupon.step
80.0 x 25.0 x 9.89 mm
