iThinkiKhan/gladiator-cad/cad/coupons/m2-d3-l3-mini-20261022/M2_D3_L3_Coupon.step

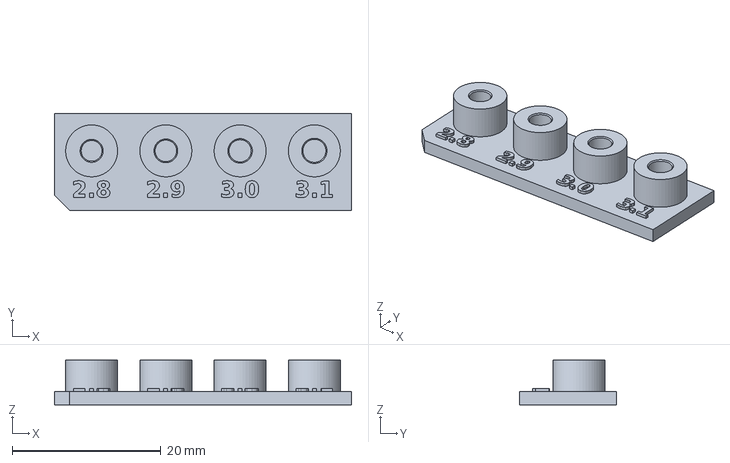
[picture p62: CAD file, 2026-10-22]
cad/coupons/m2-d3-l3-mini-20261022/M2_D3_L3_Coupon.step
40.0 x 13.0 x 6.00 mm
