iThinkiKhan/gladiator-cad/cad/coupons/m2-insert-v1/Gladiator_Coupon_M2_Inserts.FCStd

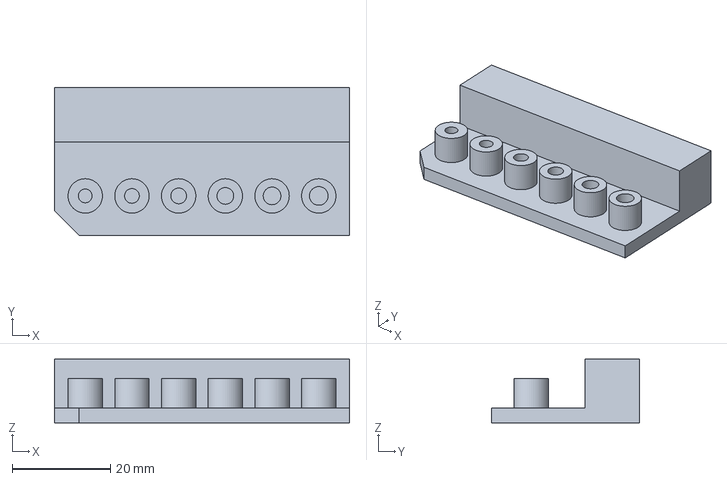
[picture p63: CAD file, 2026-10-22]
cad/coupons/m2-insert-v1/Gladiator_Coupon_M2_Inserts.FCStd
60.0 x 30.0 x 13.0 mm
