iThinkiKhan/gladiator-cad/cad/drivers/v2-standoff/DriverMount_v2.step

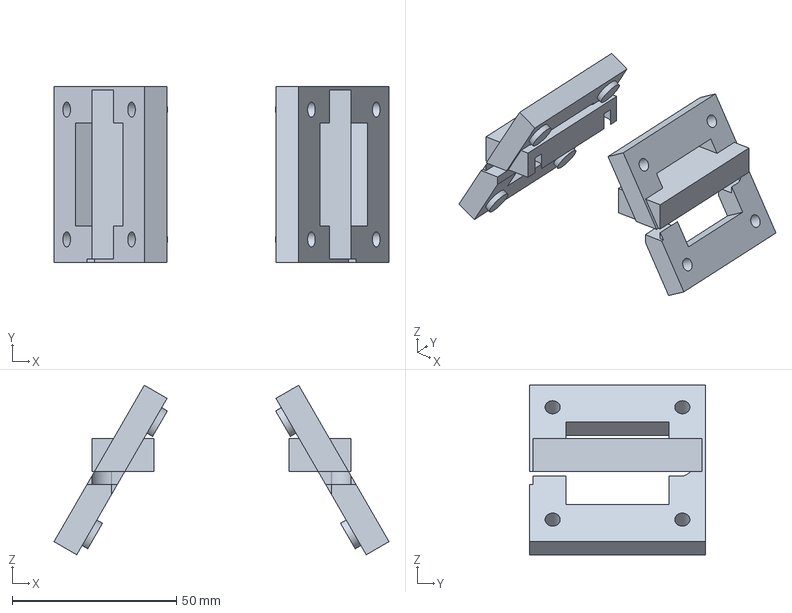
[picture p64: CAD file, 2026-09-21]
cad/drivers/v2-standoff/DriverMount_v2.step
102.0 x 53.5 x 51.6 mm
