iThinkiKhan/gladiator-cad/cad/drivers/v2-standoff/stl/DriverMount_v2_Right.stl

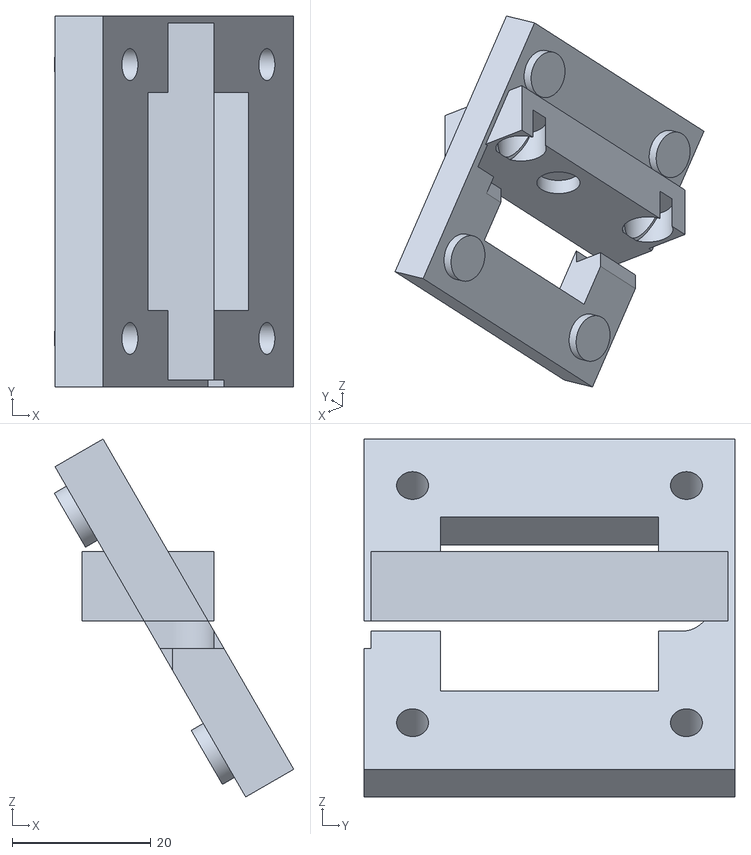
[picture p65: CAD file, 2026-09-21]
cad/drivers/v2-standoff/stl/DriverMount_v2_Right.stl
34.5 x 53.5 x 51.6
