iThinkiKhan/gladiator-cad/cad/drivers/v3-wedge45/DriverMount_v3.step

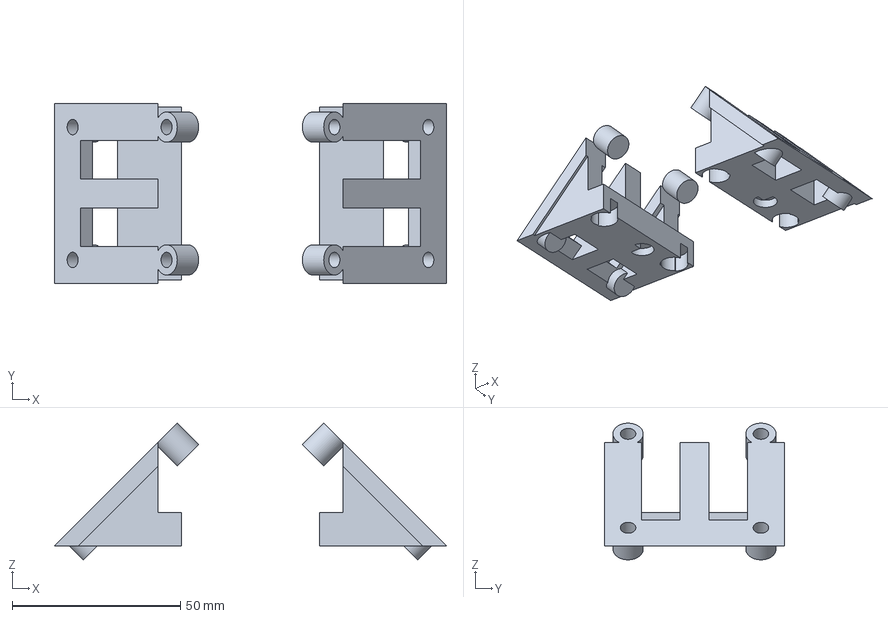
[picture p66: CAD file, 2026-09-21]
cad/drivers/v3-wedge45/DriverMount_v3.step
116.6 x 53.5 x 40.7 mm
