iThinkiKhan/gladiator-cad/cad/drivers/v3-wedge45/stl/DriverMount_v3_Right.stl

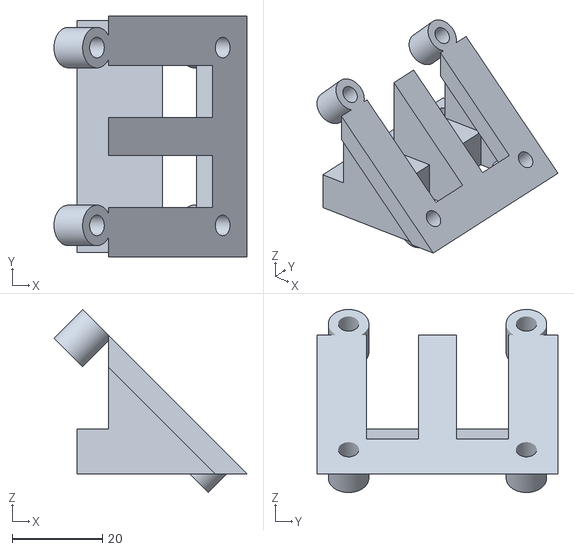
[picture p67: CAD file, 2026-09-21]
cad/drivers/v3-wedge45/stl/DriverMount_v3_Right.stl
42.9 x 53.5 x 40.7
