iThinkiKhan/gladiator-cad/cad/drivers/v5-interlock/DriverMount_v5.step

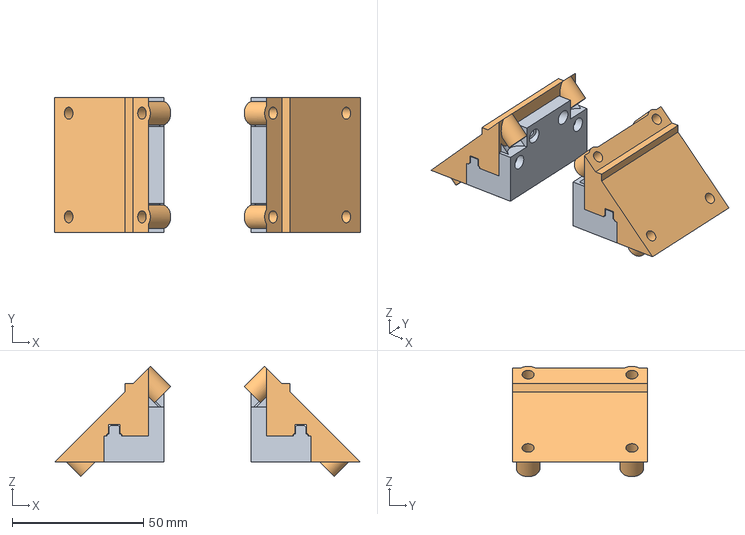
[picture p68: CAD file, 2026-10-22]
cad/drivers/v5-interlock/DriverMount_v5.step
116.6 x 51.5 x 42.1 mm
