iThinkiKhan/gladiator-cad/cad/drivers/v5-interlock/stl/Base_Left.stl

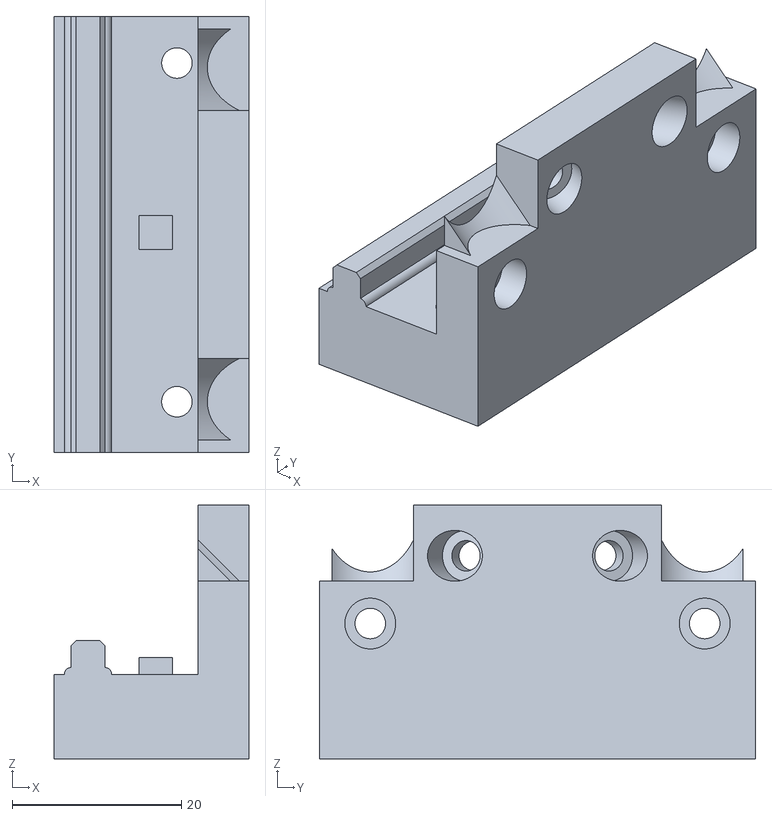
[picture p69: CAD file, 2026-09-24]
cad/drivers/v5-interlock/stl/Base_Left.stl
23.0 x 51.5 x 30.0
