iThinkiKhan/gladiator-cad/cad/head/camera-service-v2-20261021/Gladiator_Camera_Service_v2_EXPLODED.FCStd

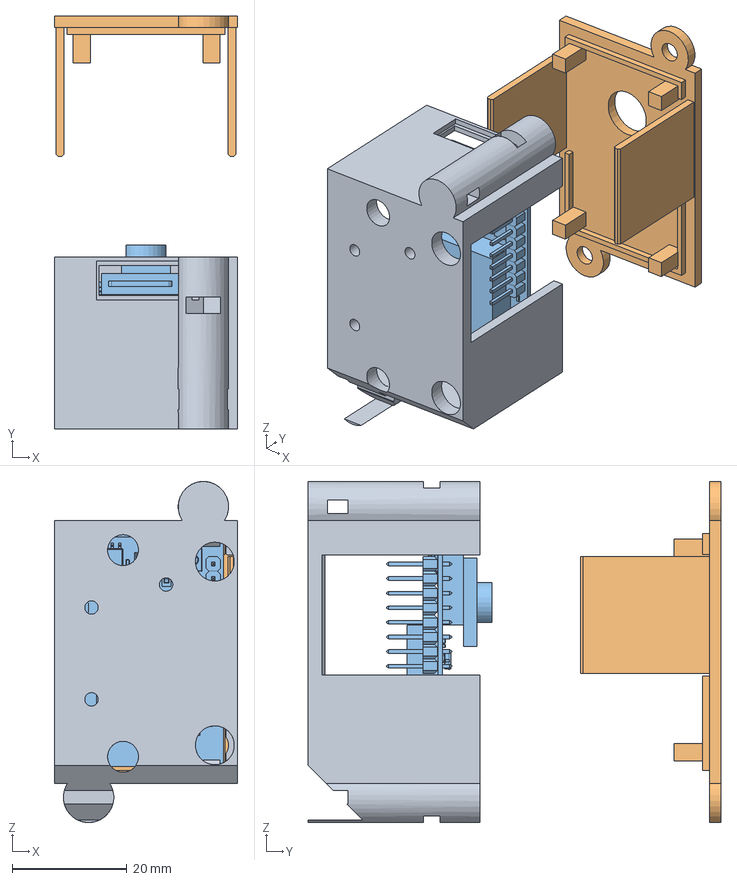
[picture p70: CAD file, 2026-10-22]
cad/head/camera-service-v2-20261021/Gladiator_Camera_Service_v2_EXPLODED.FCStd
31.9 x 72.0 x 59.4 mm
Mount_Tray
Screw_Cover
ESP32_CAM_measured_reference
