iThinkiKhan/gladiator-cad/cad/head/coupons-r2-20260930/Gladiator_HeadR2_FINAL-COUPON-PLATE_6-pieces.3mf

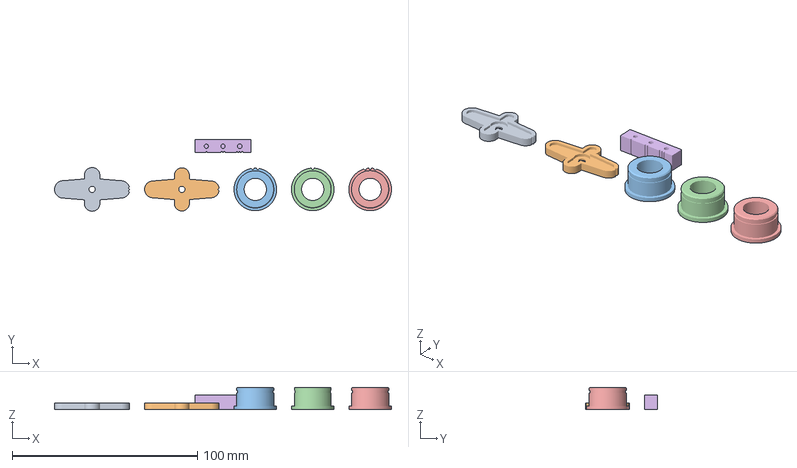
[picture p71: CAD file, 2026-10-01]
cad/head/coupons-r2-20260930/Gladiator_HeadR2_FINAL-COUPON-PLATE_6-pieces.3mf
181.9 x 38.6 x 12.1 mm
H6b_HornPocket_2notch-EASY_pocket-up
H6a_HornPocket_1notch-SNUG_pocket-up
H3b2_BearingPost-2-notch-20.05_shoulder-down
H3b1_BearingPost-1-notch-19.95_shoulder-down
H3b3_BearingPost-3-notch-20.15_shoulder-down
H4b_M2Pilots-BIGGER_flat
