iThinkiKhan/gladiator-cad/cad/head/coupons-r2-20260930/stl/Gladiator_HeadR2_H3b3_BearingPost-3-notch-20.15_shoulder-down.stl

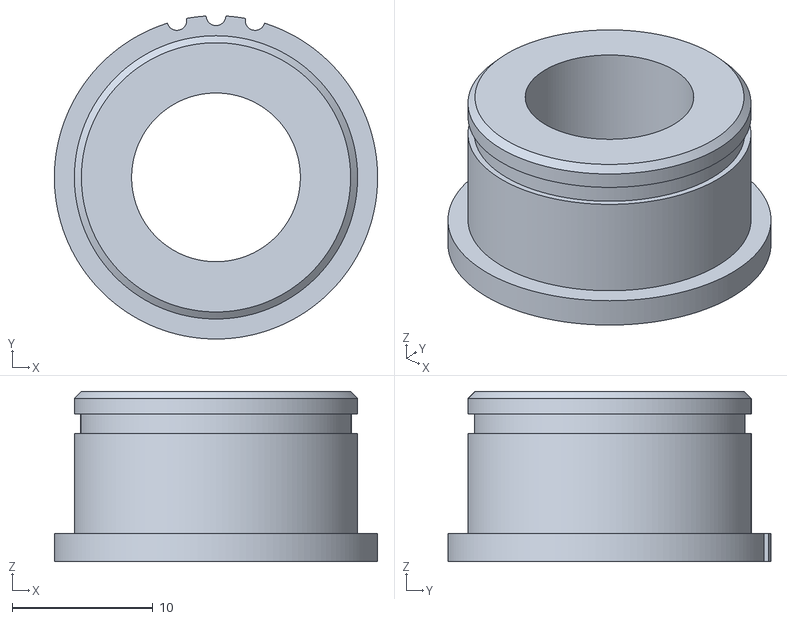
[picture p72: CAD file, 2026-10-01]
cad/head/coupons-r2-20260930/stl/Gladiator_HeadR2_H3b3_BearingPost-3-notch-20.15_shoulder-down.stl
23.0 x 23.0 x 12.1
