iThinkiKhan/gladiator-cad/cad/head/coupons-r3-20261001/Gladiator_HeadR3_CouponPlate_3-pieces.3mf

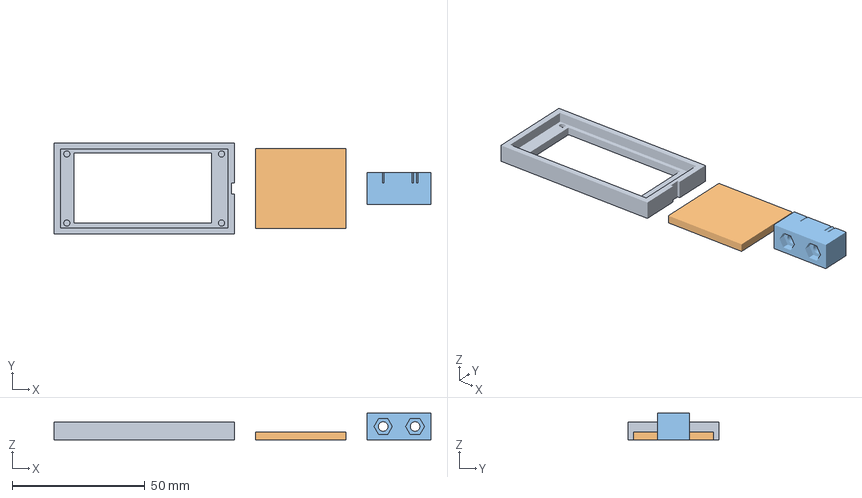
[picture p73: CAD file, 2026-10-02]
cad/head/coupons-r3-20261001/Gladiator_HeadR3_CouponPlate_3-pieces.3mf
141.9 x 34.4 x 10.0 mm
R3a_ScreenSlice_notch-is-PIN-edge_bezel-face-down
R3c_GH44Register_recess-DOWN
R3b_SidewaysNut_1notch-6.0_2notch-6.2_flat
