iThinkiKhan/gladiator-cad/cad/head/coupons-r3-20261001/stl/Gladiator_HeadR3_R3b_SidewaysNut_1notch-6.0_2notch-6.2_flat.stl

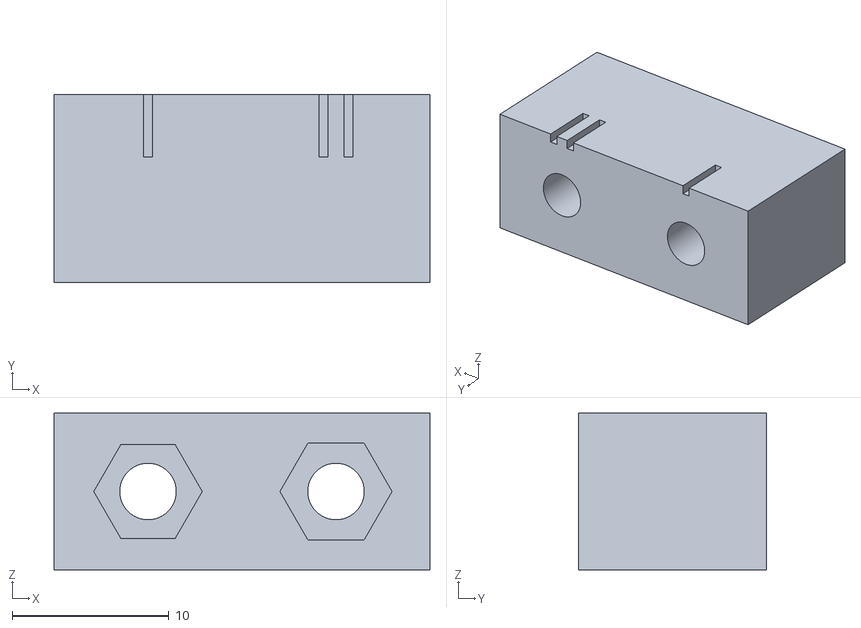
[picture p74: CAD file, 2026-10-02]
cad/head/coupons-r3-20261001/stl/Gladiator_HeadR3_R3b_SidewaysNut_1notch-6.0_2notch-6.2_flat.stl
24.0 x 12.0 x 10.0
