iThinkiKhan/gladiator-cad/cad/head/drive-coupons-20260922/Drive60_HornSlot_Fit_Coupon_print-flat.stl

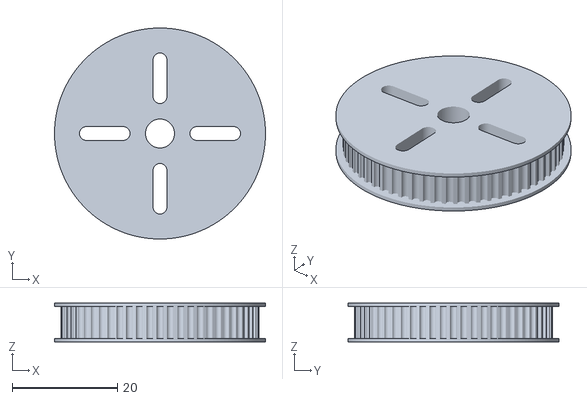
[picture p75: CAD file, 2026-10-01]
cad/head/drive-coupons-20260922/Drive60_HornSlot_Fit_Coupon_print-flat.stl
40.1 x 40.1 x 7.40
