iThinkiKhan/gladiator-cad/cad/head/esp32-cam-case-v4/orca-plate/Gladiator_Head_ORCA-D_ESP32-CAM-Case_v4_Tray-and-Lid.3mf

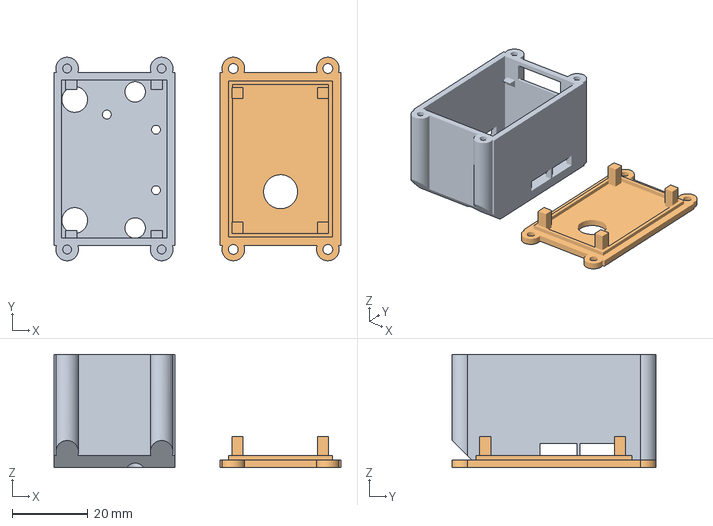
[picture p76: CAD file, 2026-10-22]
cad/head/esp32-cam-case-v4/orca-plate/Gladiator_Head_ORCA-D_ESP32-CAM-Case_v4_Tray-and-Lid.3mf
75.9 x 53.8 x 30.0 mm
ESP32_CAM_Case_Tray
ESP32_CAM_Case_Lid
