iThinkiKhan/gladiator-cad/cad/head/integration-20261005/before/20261005T160338Z/cad/head/v04-pan-stack/Gladiator_Head_v04_PanStack.step

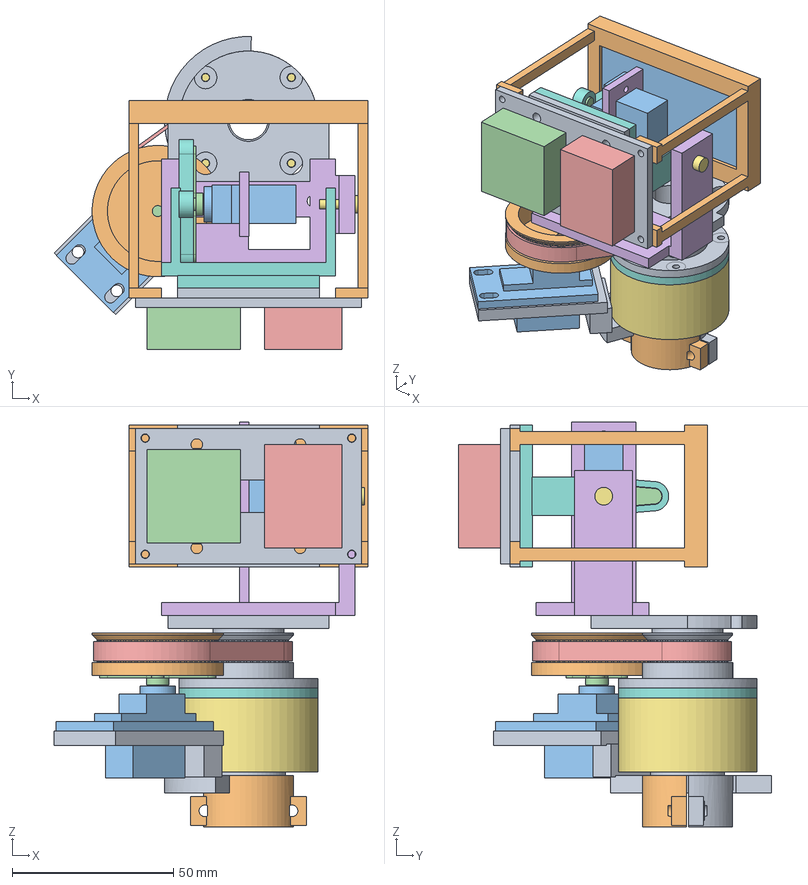
[picture p77: CAD file, 2026-10-22]
cad/head/integration-20261005/before/20261005T160338Z/cad/head/v04-pan-stack/Gladiator_Head_v04_PanStack.step
97.2 x 97.0 x 125.5 mm
