iThinkiKhan/gladiator-cad/cad/head/integration-20261005/before/20261005T160338Z/cad/head/v04-pan-stack/plates/Gladiator_Head_v04_PLATE3_Tilt_Yoke-Receiver-DisplayFrame.3mf

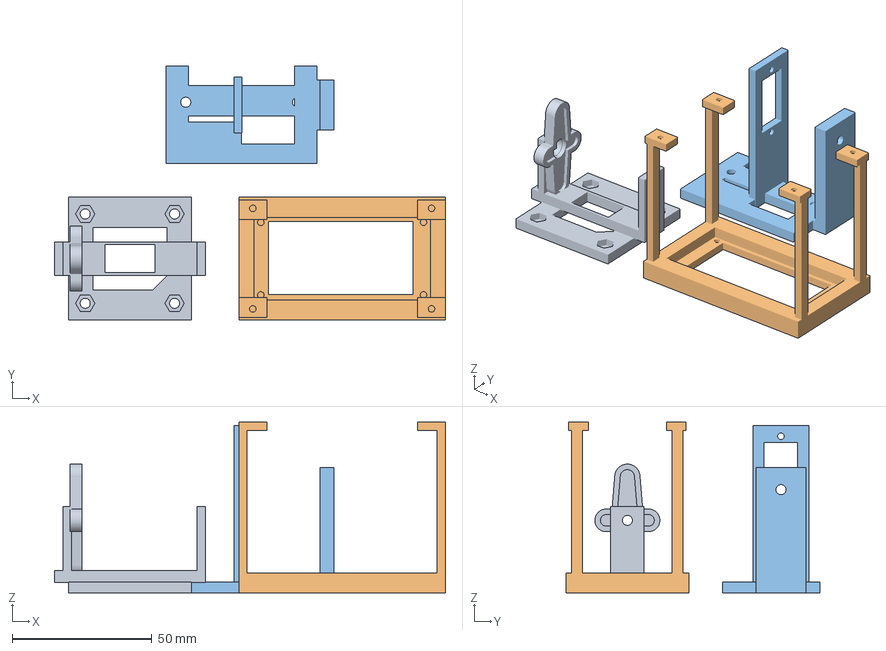
[picture p78: CAD file, 2026-10-22]
cad/head/integration-20261005/before/20261005T160338Z/cad/head/v04-pan-stack/plates/Gladiator_Head_v04_PLATE3_Tilt_Yoke-Receiver-DisplayFrame.3mf
140.0 x 91.0 x 61.2 mm
GH44_Tilt_Receiver
Rear_Display_Frame
Tilt_Yoke
