iThinkiKhan/gladiator-cad/cad/head/integration-20261005/before/20261005T160338Z/cad/head/v04-pan-stack/stl/Gladiator_Head_v04_GH44_Tilt_Receiver.stl

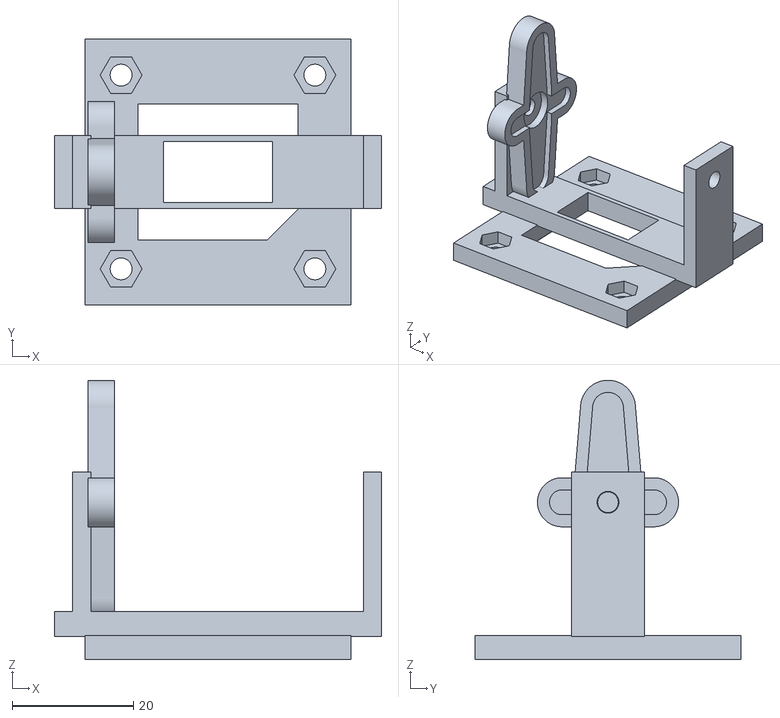
[picture p79: CAD file, 2026-10-22]
cad/head/integration-20261005/before/20261005T160338Z/cad/head/v04-pan-stack/stl/Gladiator_Head_v04_GH44_Tilt_Receiver.stl
54.0 x 44.0 x 46.2
