iThinkiKhan/gladiator-cad/cad/head/integration-20261005/delivery/Gladiator_MastHead_v05_20261005/Gladiator_Head_v05_PanStack.step

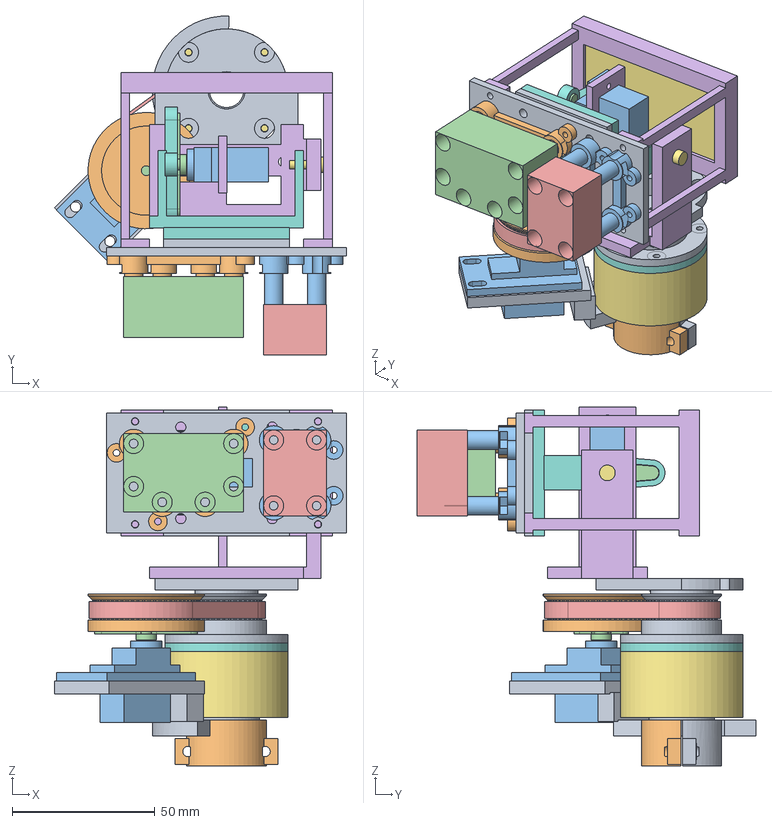
[picture p80: CAD file, 2026-10-22]
cad/head/integration-20261005/delivery/Gladiator_MastHead_v05_20261005/Gladiator_Head_v05_PanStack.step
102.2 x 118.6 x 125.5 mm
