iThinkiKhan/gladiator-cad/cad/head/integration-20261005/v05-before-radar-shift/Gladiator_Head_v05_PanStack.step

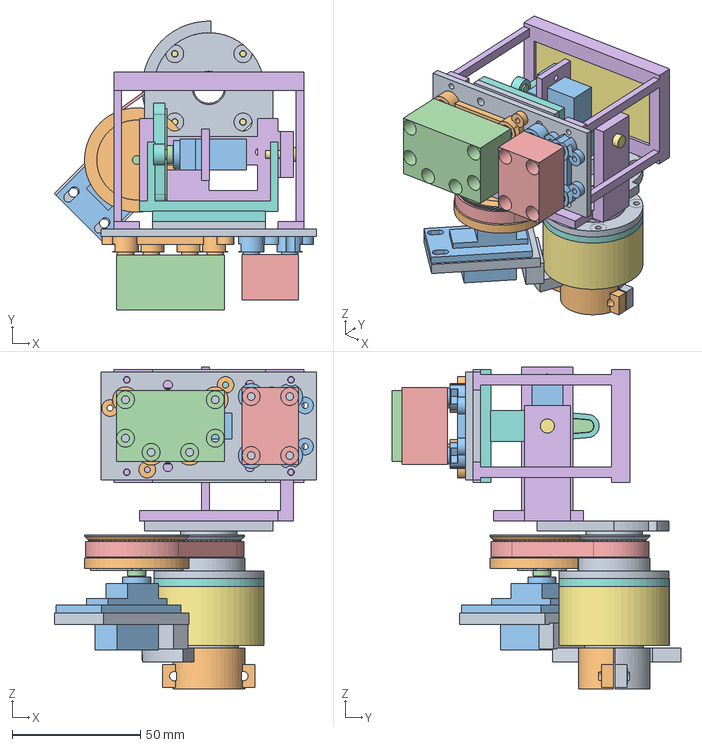
[picture p81: CAD file, 2026-10-22]
cad/head/integration-20261005/v05-before-radar-shift/Gladiator_Head_v05_PanStack.step
102.2 x 112.5 x 125.5 mm
