iThinkiKhan/gladiator-cad/cad/head/integration-20261005/v05-before-radar-shift/stl/Gladiator_Head_v05_Radar_Sensor_Frame.stl

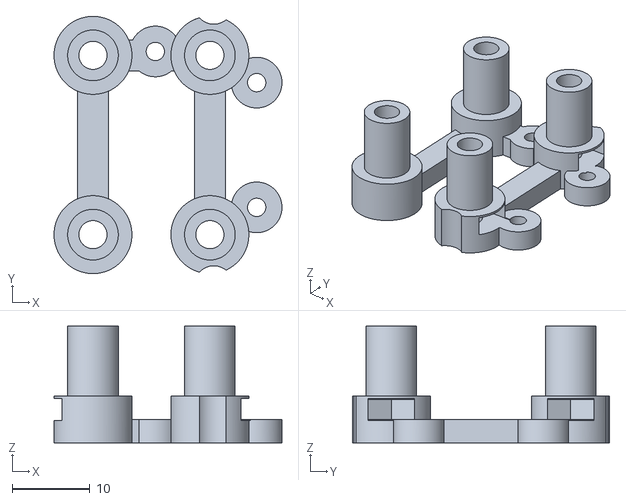
[picture p82: CAD file, 2026-10-22]
cad/head/integration-20261005/v05-before-radar-shift/stl/Gladiator_Head_v05_Radar_Sensor_Frame.stl
29.2 x 33.0 x 15.0
