iThinkiKhan/gladiator-cad/cad/head/master/Gladiator_Head_Master.step

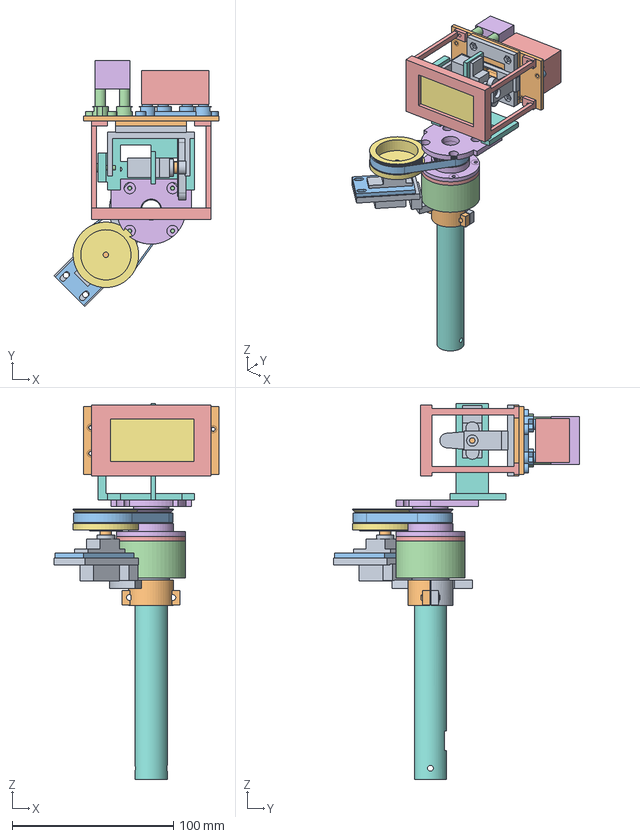
[picture p83: CAD file, 2026-10-09]
cad/head/master/Gladiator_Head_Master.step
102.2 x 152.8 x 233.5 mm
Neck_Main
Neck_Clamp_Cap
Pan_Servo_Carriage
Pan_Rotor
Pan_Retainer
Pan_Raised_Pedestal
Pan_Drive_Pulley
Tilt_Yoke
GH44_Tilt_Receiver
GH44_Dual_Carrier
ToF_Sensor_Frame
Radar_Sensor_Frame
Rear_Display_Frame
Pan_Bearing_Lower
Pan_Bearing_Upper
Pan_Inner_Spacer
Pan_Circlip_Envelope
SG90_Pan_Reference
Pan_Horn_Reference
Pan_Belt_Reference
SG90_Tilt_Reference
Tilt_Horn_Reference
Tilt_Pivot_Bolt
Dual_ToF_Envelope
Dual_Radar_Envelope
ST7789_Board
Mast_Tube (context, Z 6-130)
