iThinkiKhan/gladiator-cad/cad/head/orca-plates/Gladiator_Head_ORCA-A_PanStack_Pedestal-Retainer-Cap_Rotor-Pulley-Carriage.3mf

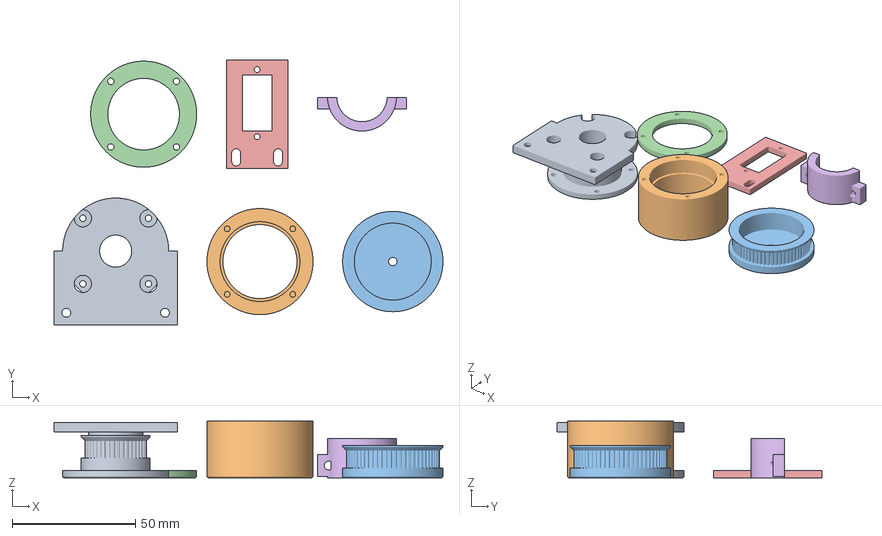
[picture p84: CAD file, 2026-10-06]
cad/head/orca-plates/Gladiator_Head_ORCA-A_PanStack_Pedestal-Retainer-Cap_Rotor-Pulley-Carriage.3mf
157.7 x 107.5 x 23.0 mm
Pan_Raised_Pedestal
Pan_Rotor
Pan_Drive_Pulley
Pan_Retainer
Pan_Servo_Carriage
Neck_Clamp_Cap
