iThinkiKhan/gladiator-cad/cad/head/v01/fit-prototypes/GH44_Receiver_Fit_Coupon.stl

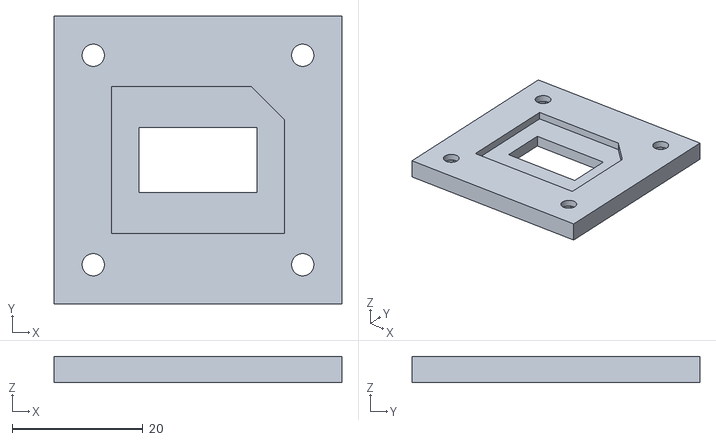
[picture p85: CAD file, 2026-09-19]
cad/head/v01/fit-prototypes/GH44_Receiver_Fit_Coupon.stl
44.0 x 44.0 x 4.00
