iThinkiKhan/gladiator-cad/cad/head/v01/GH44_Carrier_Template.step

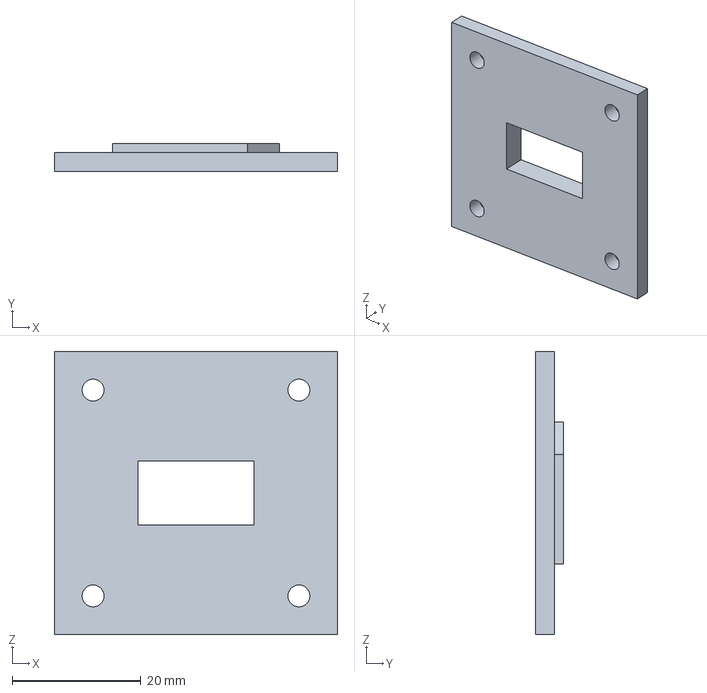
[picture p86: CAD file, 2026-09-19]
cad/head/v01/GH44_Carrier_Template.step
44.0 x 4.40 x 44.0 mm
