iThinkiKhan/gladiator-cad/cad/head/v02-screen-180/Gladiator_Head_v02_Screen180.step

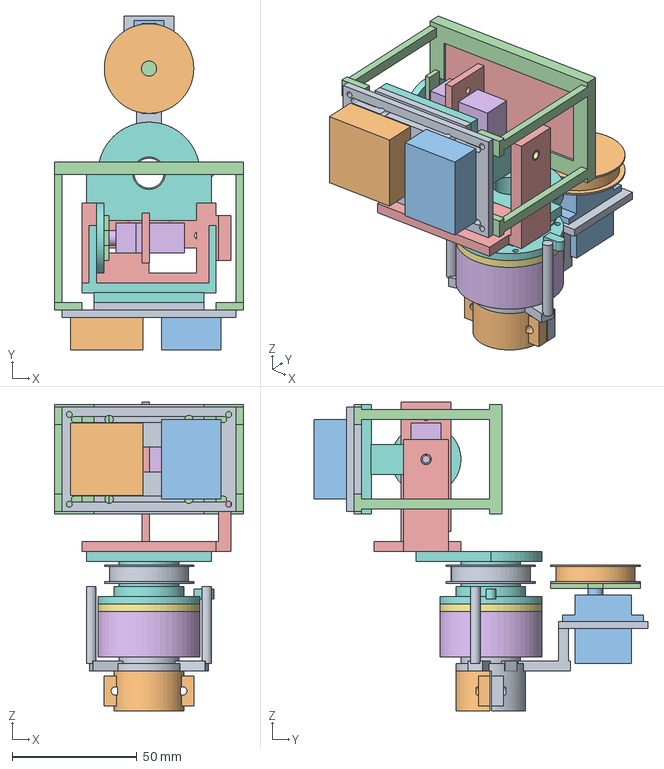
[picture p87: CAD file, 2026-09-19]
cad/head/v02-screen-180/Gladiator_Head_v02_Screen180.step
76.0 x 134.1 x 124.0 mm
