iThinkiKhan/gladiator-cad/cad/head/v02-screen-180/reference/Gladiator_Head_v01.FCStd

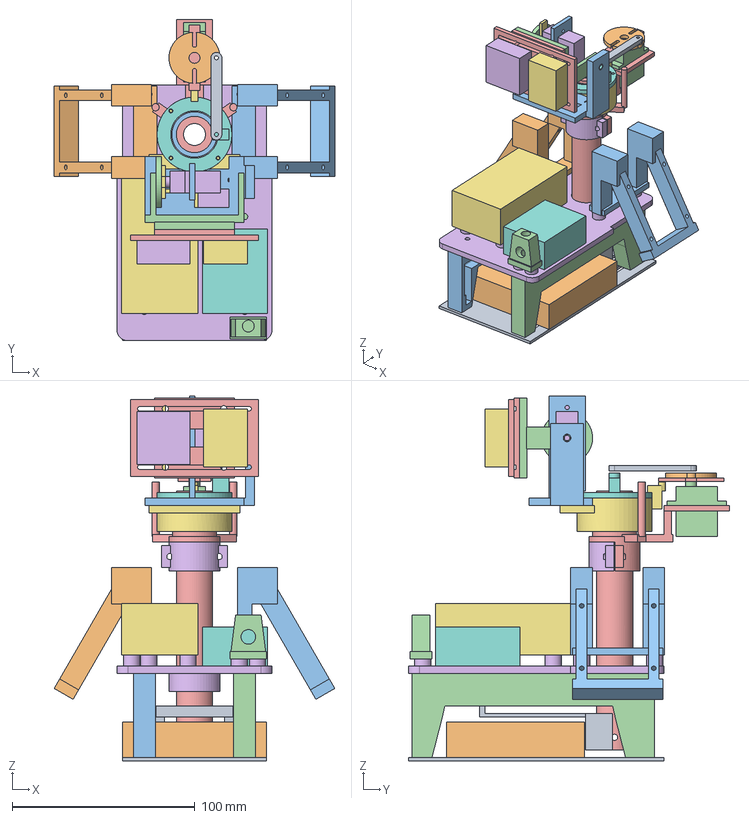
[picture p88: CAD file, 2026-09-19]
cad/head/v02-screen-180/reference/Gladiator_Head_v01.FCStd
153.8 x 176.1 x 200.0 mm
Chassis deck
Battery box (reference, empty)
Side rail, left
Side rail, right
Mast tube
Upper deck
S3 + expander (reference envelope)
Breadboard + C6 + BNO (reference envelope)
Power board shield
Driver mount, left
Driver mount, right
Antenna pylon
Neck Main
Neck Clamp Cap
Pan Rotor
Pan Retainer Crank
Pan Parallel Link
Pan Horn Adapter
Tilt Yoke
GH44 Tilt Receiver
GH44 Dual Carrier
Dual ToF Envelope
Dual Radar Envelope
Pan Bearing Lower
Pan Bearing Upper
Pan Inner Spacer
Pan Circlip Envelope
SG90 Pan Reference
Pan Horn Reference
SG90 Tilt Reference
Tilt Horn Reference
Tilt Idler Bushing
