iThinkiKhan/gladiator-cad/cad/head/v03-belt/Gladiator_Head_v03_Belt.step

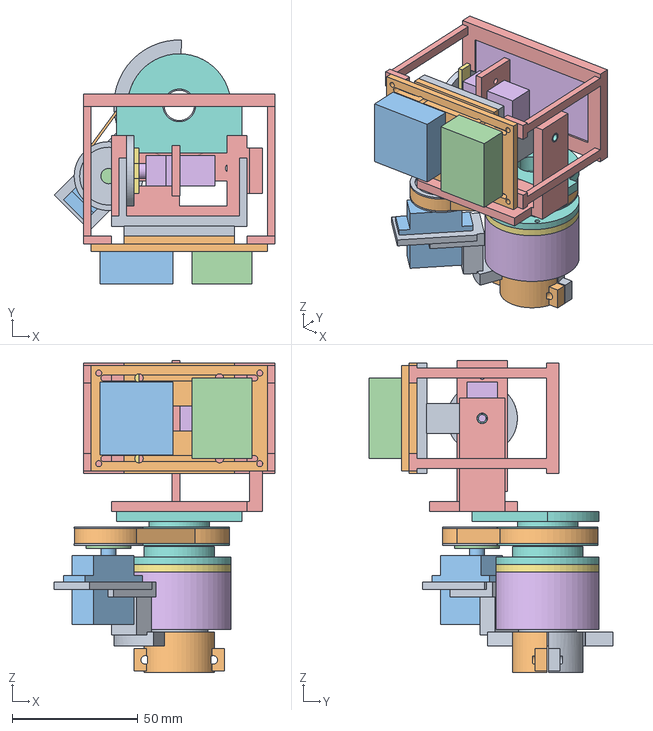
[picture p89: CAD file, 2026-09-19]
cad/head/v03-belt/Gladiator_Head_v03_Belt.step
87.7 x 97.0 x 124.0 mm
