iThinkiKhan/gladiator-cad/cad/head/v03-belt/stl/Gladiator_HeadCoupon_BeltMesh_3up.stl

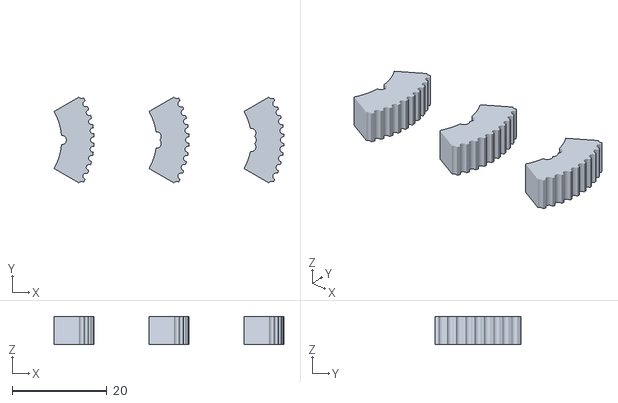
[picture p90: CAD file, 2026-09-20]
cad/head/v03-belt/stl/Gladiator_HeadCoupon_BeltMesh_3up.stl
48.4 x 18.1 x 6.00
