iThinkiKhan/gladiator-cad/cad/head/v04-pan-stack/plates/Gladiator_Head_v04_PLATE2_PanDrive_Rotor-Pulley-Carriage.3mf

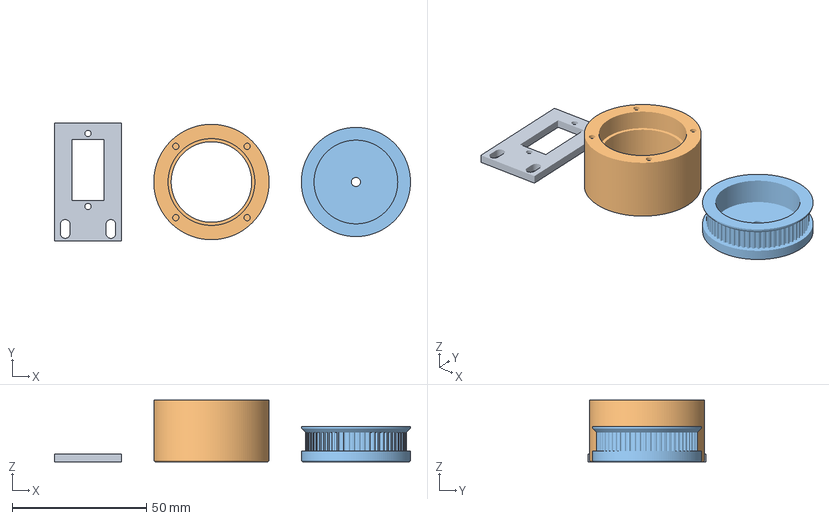
[picture p91: CAD file, 2026-10-22]
cad/head/v04-pan-stack/plates/Gladiator_Head_v04_PLATE2_PanDrive_Rotor-Pulley-Carriage.3mf
132.7 x 44.0 x 23.0 mm
Pan_Servo_Carriage
Pan_Rotor
Pan_Drive_Pulley
