iThinkiKhan/gladiator-cad/cad/head/v04-pan-stack/stl/Gladiator_Head_v04_GH44_Tilt_Receiver.stl

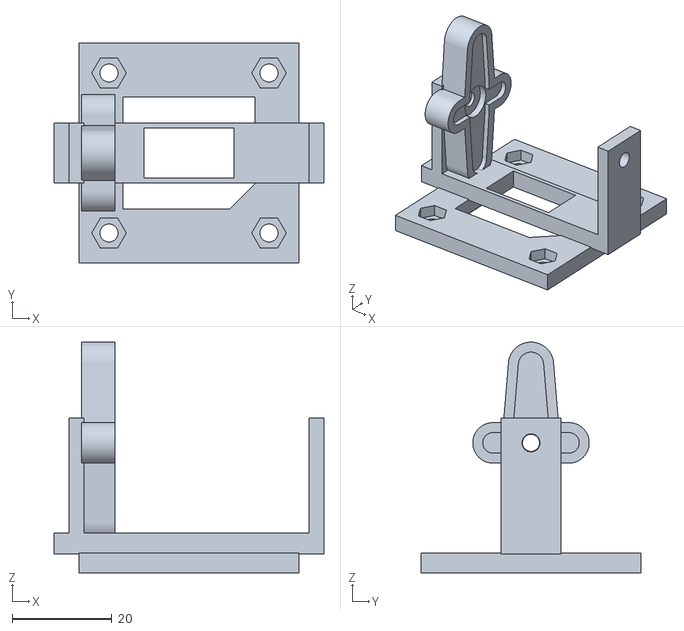
[picture p92: CAD file, 2026-10-04]
cad/head/v04-pan-stack/stl/Gladiator_Head_v04_GH44_Tilt_Receiver.stl
54.0 x 44.0 x 46.2
