iThinkiKhan/gladiator-cad/cad/head/v05-sensor-mounts/plates/Gladiator_Head_v05_PLATE5_SensorCarrier-ToF-Radar.3mf

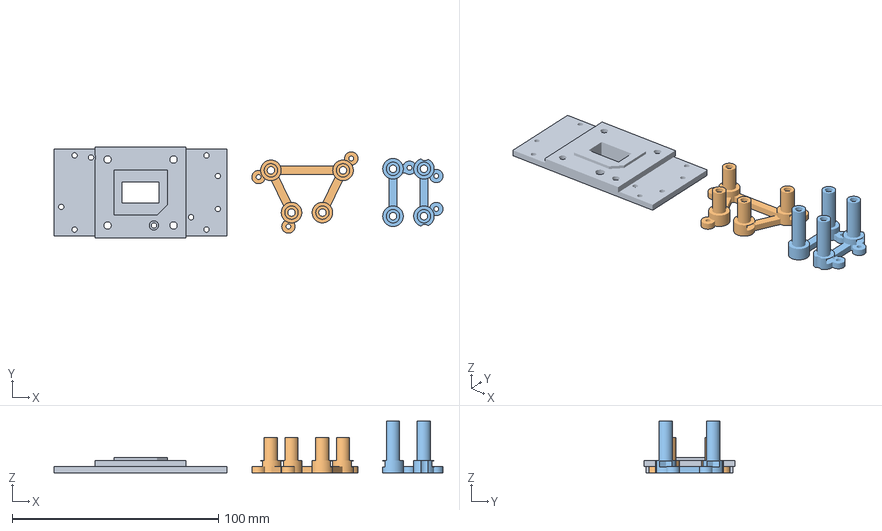
[picture p93: CAD file, 2026-10-22]
cad/head/v05-sensor-mounts/plates/Gladiator_Head_v05_PLATE5_SensorCarrier-ToF-Radar.3mf
188.7 x 44.0 x 25.0 mm
GH44_Dual_Carrier
ToF_Sensor_Frame
Radar_Sensor_Frame
