iThinkiKhan/gladiator-cad/cad/master/drafts/Gladiator_Master.pre-cell-height.20261001-140205.FCStd

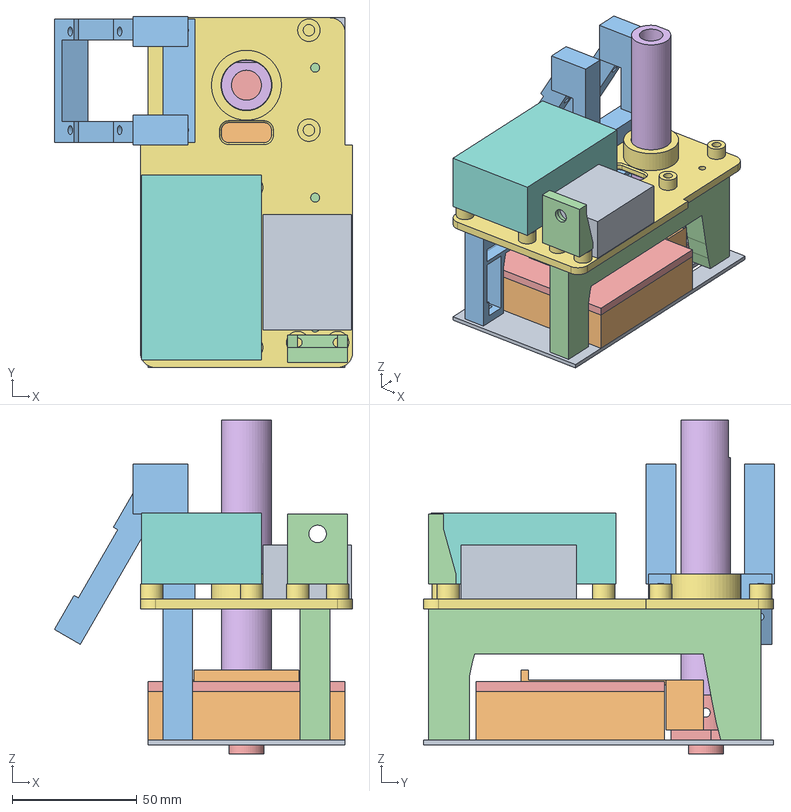
[picture p95: CAD file, 2026-09-27]
cad/master/drafts/Gladiator_Master.pre-cell-height.20261001-140205.FCStd
119.4 x 140.5 x 133.5 mm
Chassis deck
Battery box (reference, empty)
Side rail, left
Side rail, right
Mast base
Mast tube
Upper deck
S3 + expander (reference envelope)
Breadboard + C6 + BNO (reference envelope)
Power board shield
Driver mount, left
Antenna bulkhead mount
Battery cells above holder (reference envelope)
