iThinkiKhan/gladiator-cad/cad/master/Gladiator_Master.step

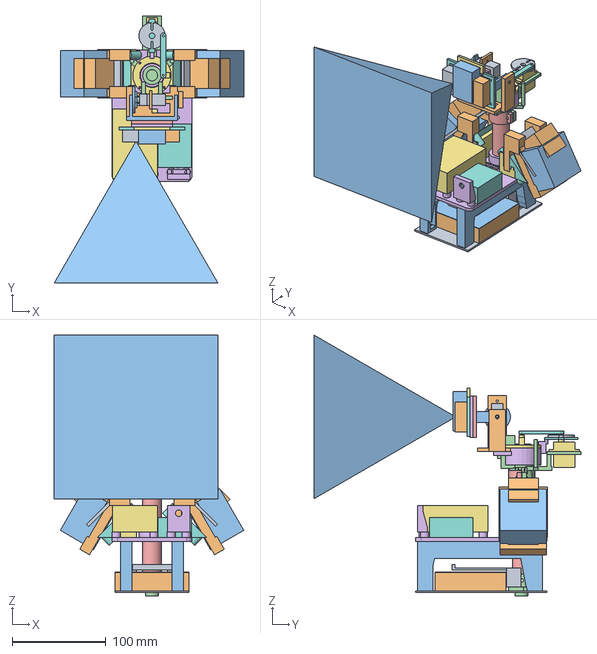
[picture p96: CAD file, 2026-10-01]
cad/master/Gladiator_Master.step
201.7 x 284.1 x 277.6 mm
