iThinkiKhan/gladiator-cad/cad/power-board/ina-cassette-v2/INA226_Cassette_v2.step

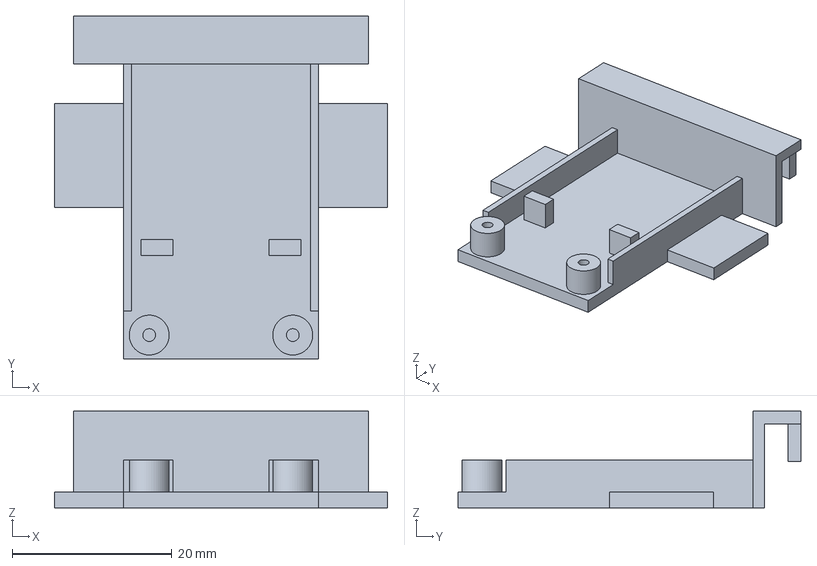
[picture p97: CAD file, 2026-10-03]
cad/power-board/ina-cassette-v2/INA226_Cassette_v2.step
41.8 x 43.0 x 12.1 mm
