iThinkiKhan/gladiator-cad/cad/power-board/v3-cradle/PowerBoardTray_v3.step

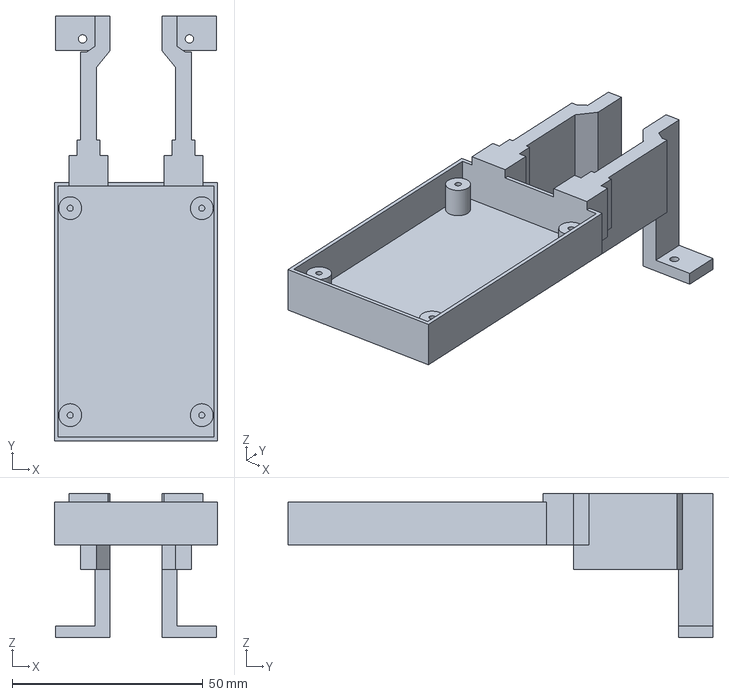
[picture p98: CAD file, 2026-09-27]
cad/power-board/v3-cradle/PowerBoardTray_v3.step
42.8 x 111.4 x 37.8 mm
