iThinkiKhan/gladiator-cad/cad/power-board/v5-tray/PowerBoardTray_v5.step

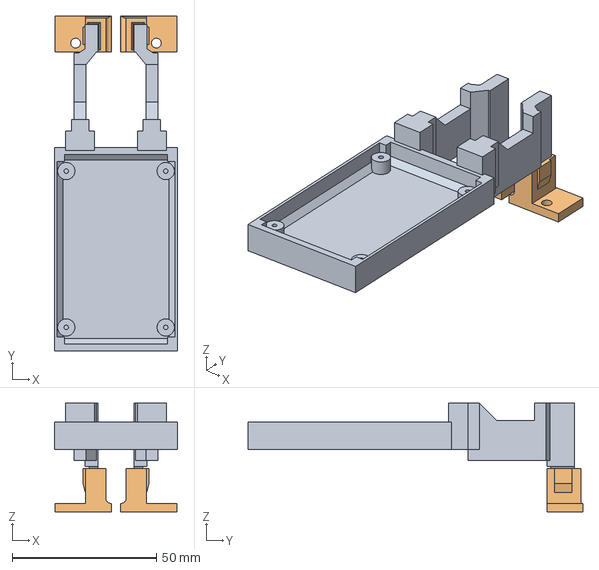
[picture p99: CAD file, 2026-10-03]
cad/power-board/v5-tray/PowerBoardTray_v5.step
42.8 x 116.2 x 37.8 mm
