iThinkiKhan/gladiator-cad/cad/power-board/v5-tray/stl/Gladiator_PowerTray_v5_print-on-rear-face.stl

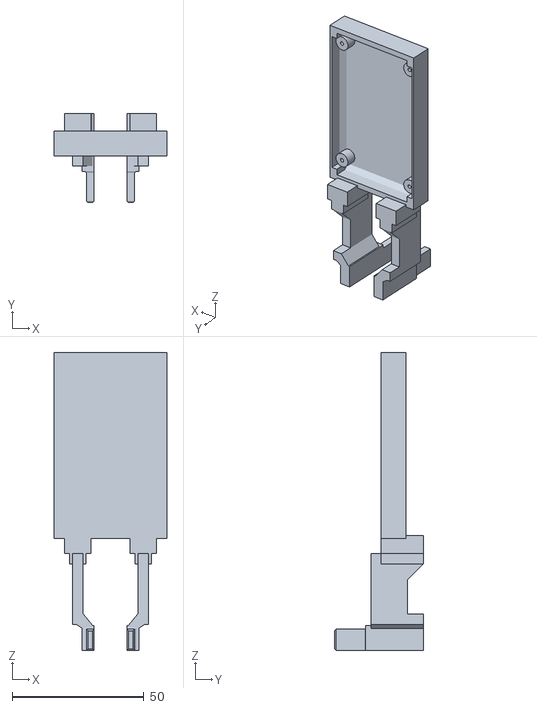
[picture p100: CAD file, 2026-10-03]
cad/power-board/v5-tray/stl/Gladiator_PowerTray_v5_print-on-rear-face.stl
42.8 x 33.8 x 113.2
