iThinkiKhan/gladiator-cad/cad/power-switch/v1/PowerSwitchHolder_v1.step

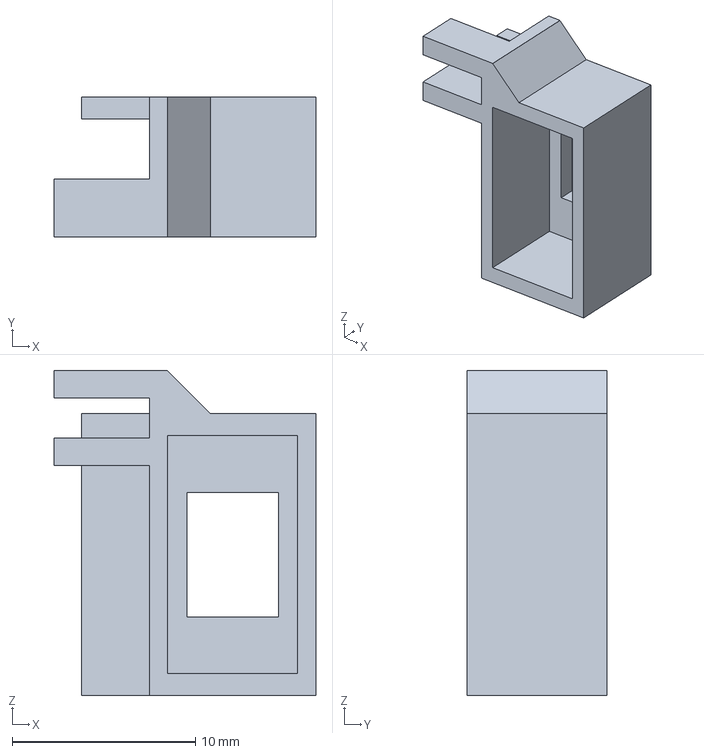
[picture p101: CAD file, 2026-10-05]
cad/power-switch/v1/PowerSwitchHolder_v1.step
14.3 x 7.67 x 17.8 mm
