iThinkiKhan/gladiator-cad/cad/print-ready/Gladiator_PlateL_DRIVER-V5e-BASES-ONLY_countersunk-M3_pocket-supports_deck-face-down.3mf

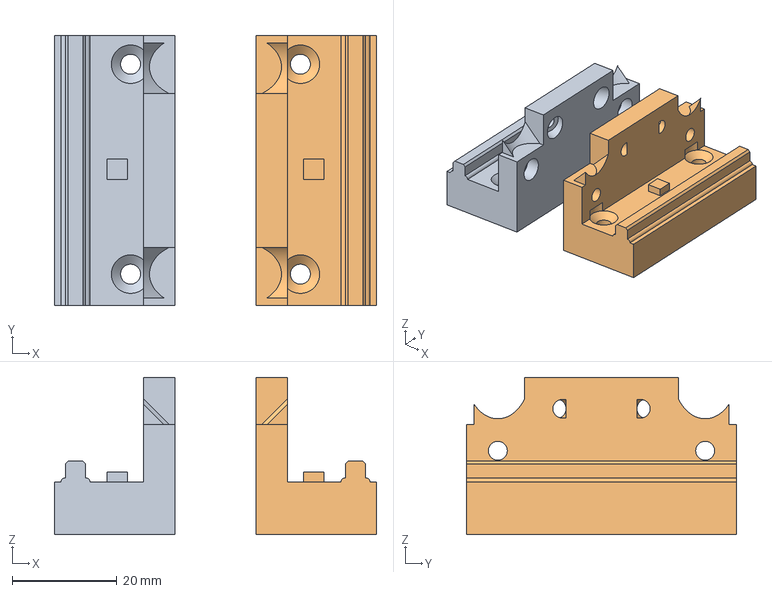
[picture p102: CAD file, 2026-10-22]
cad/print-ready/Gladiator_PlateL_DRIVER-V5e-BASES-ONLY_countersunk-M3_pocket-supports_deck-face-down.3mf
61.4 x 51.5 x 30.0 mm
Base_Left
Base_Right
