iThinkiKhan/gladiator-cad/cad/TestPrint01/05_s3_edge_clips_x4.step

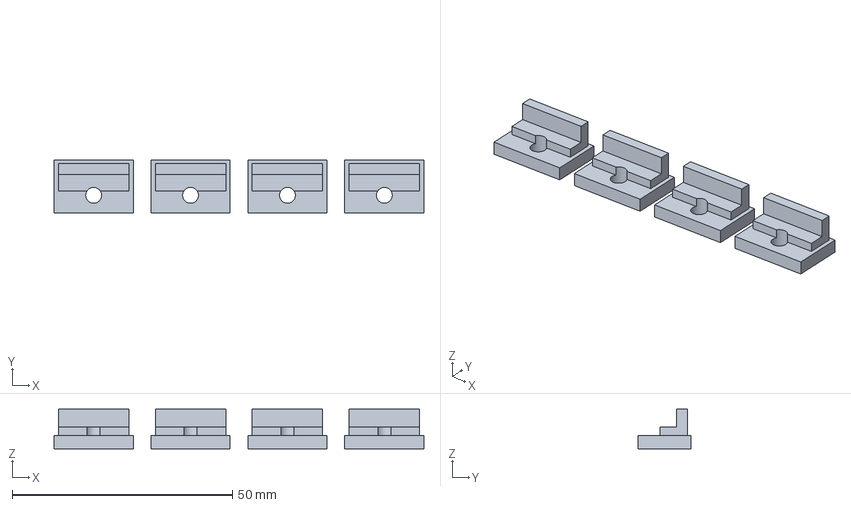
[picture p103: CAD file, 2026-09-15]
cad/TestPrint01/05_s3_edge_clips_x4.step
84.0 x 12.0 x 9.00 mm
