iThinkiKhan/gladiator-cad/cad/v2/antenna-pylon/v3-20261014/Gladiator_AntennaPylon_v3.step

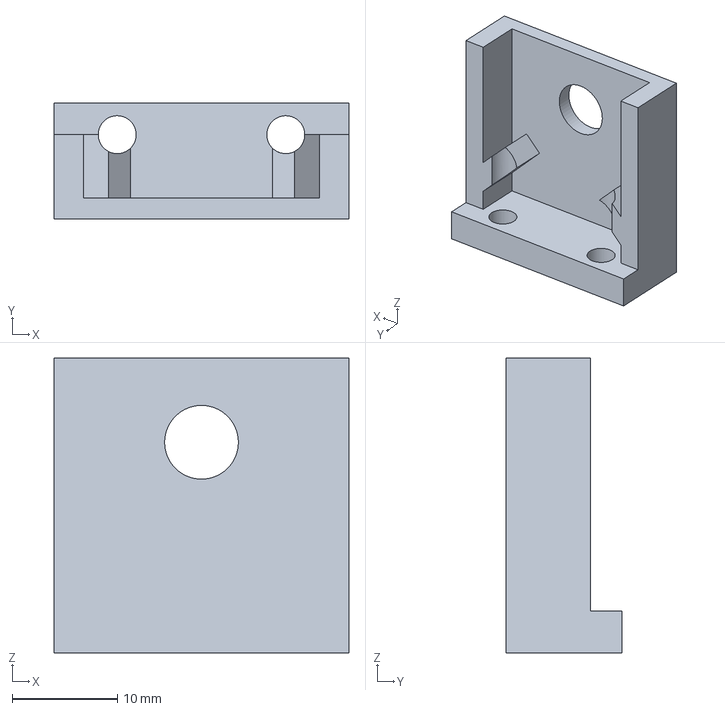
[picture p104: CAD file, 2026-10-21]
cad/v2/antenna-pylon/v3-20261014/Gladiator_AntennaPylon_v3.step
28.0 x 11.0 x 28.0 mm
