iThinkiKhan/gladiator-cad/cad/v2/enclosure/round5-20261021/baseline-v28/Gladiator_Enclosure_v2_Front_Right.stl

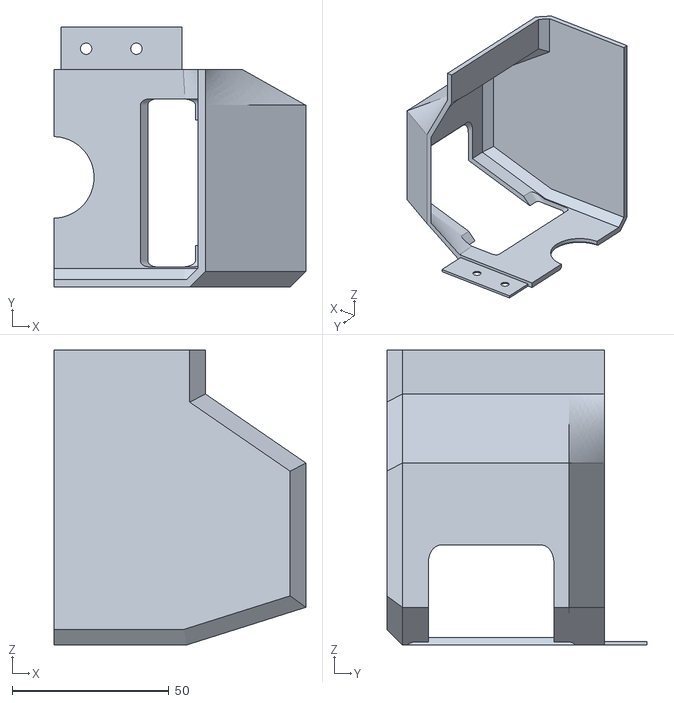
[picture p105: CAD file, 2026-10-22]
cad/v2/enclosure/round5-20261021/baseline-v28/Gladiator_Enclosure_v2_Front_Right.stl
80.2 x 83.0 x 94.0
