iThinkiKhan/gladiator-cad/cad/v2/enclosure/round5-20261021/stl/Front_Left.stl

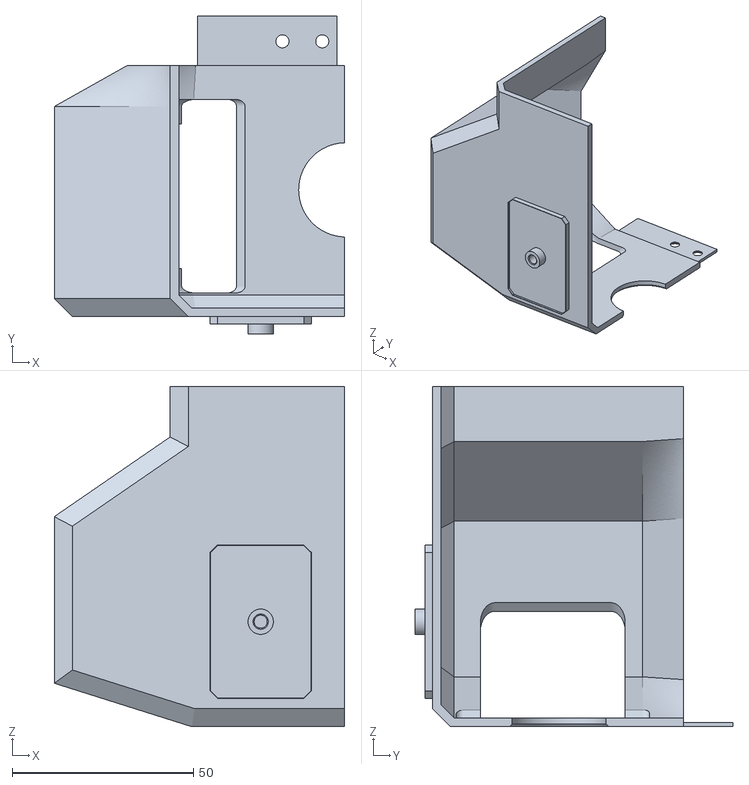
[picture p107: CAD file, 2026-10-22]
cad/v2/enclosure/round5-20261021/stl/Front_Left.stl
80.2 x 87.8 x 94.0
