iThinkiKhan/gladiator-cad/cad/v2/enclosure/round5-calibrated-28-20261022/mount-checked-release/Gladiator_Round5_PrintParts.step

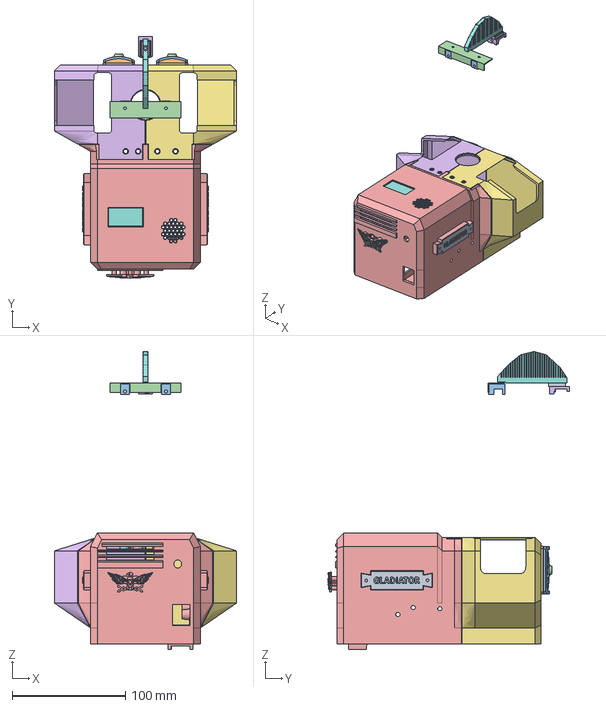
[picture p108: CAD file, 2026-10-23]
cad/v2/enclosure/round5-calibrated-28-20261022/mount-checked-release/Gladiator_Round5_PrintParts.step
161.0 x 213.4 x 263.0 mm
