iThinkiKhan/gladiator-cad/cad/v2/enclosure/round5-calibrated-28-20261022/mount-checked-release/plates/GLAD_04_HOOD_SD_M2_28.3mf

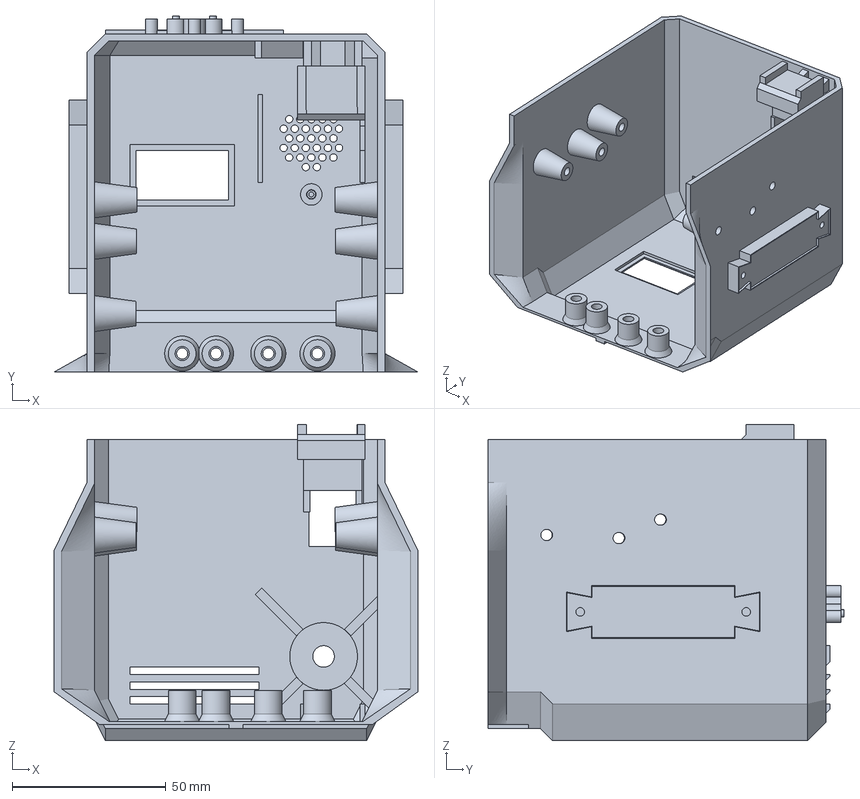
[picture p109: CAD file, 2026-10-23]
cad/v2/enclosure/round5-calibrated-28-20261022/mount-checked-release/plates/GLAD_04_HOOD_SD_M2_28.3mf
118.3 x 115.8 x 102.9 mm
