iThinkiKhan/gladiator-cad/cad/v2/enclosure/round5-calibrated-28-20261022/print/fit-test-stl/FIT_Aquila_Seat.stl

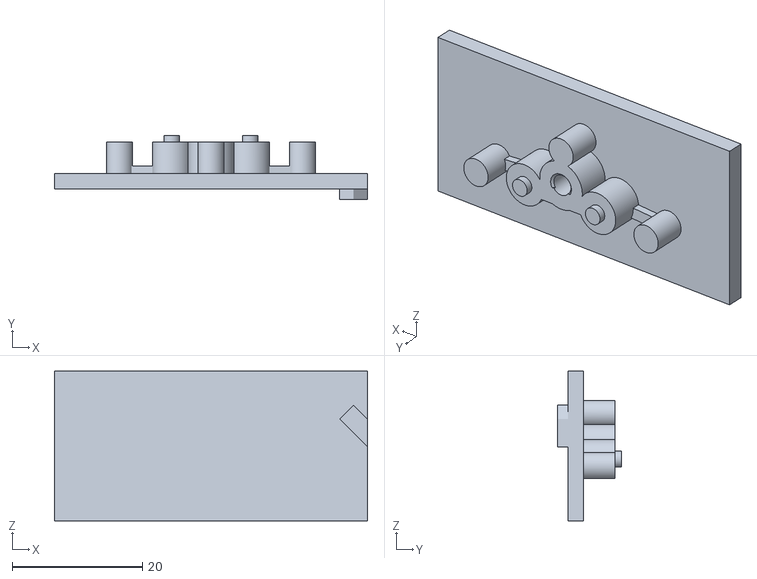
[picture p110: CAD file, 2026-10-23]
cad/v2/enclosure/round5-calibrated-28-20261022/print/fit-test-stl/FIT_Aquila_Seat.stl
48.0 x 9.80 x 23.0
