iThinkiKhan/gladiator-cad/cad/v2/enclosure/round5-calibrated-28-20261022/print/plates/R5_03_Red_Shields_and_Crest.3mf

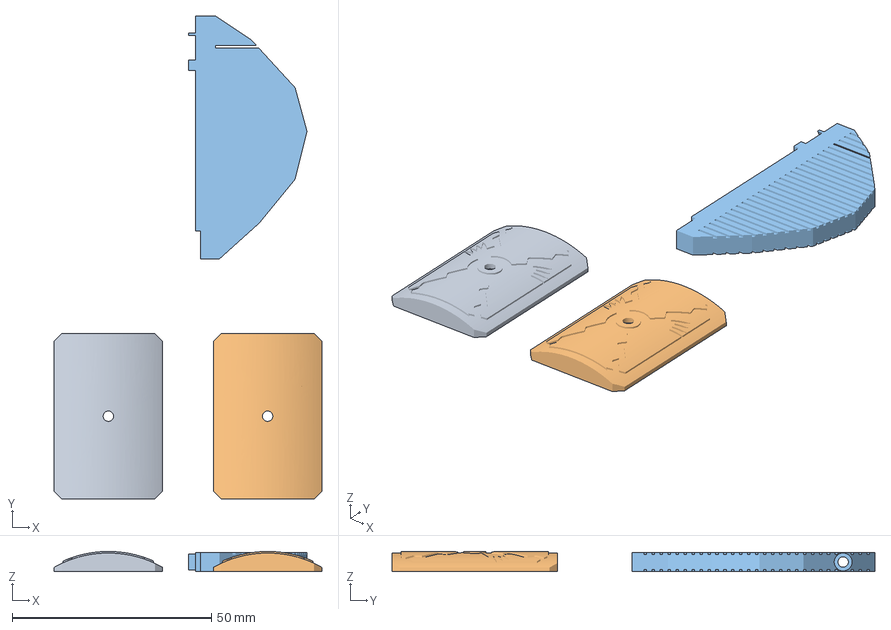
[picture p112: CAD file, 2026-10-23]
cad/v2/enclosure/round5-calibrated-28-20261022/print/plates/R5_03_Red_Shields_and_Crest.3mf
67.3 x 121.3 x 5.05 mm
Scutum_Field_L
Scutum_Field_R
Galea_Crest
