iThinkiKhan/gladiator-cad/cad/v2/enclosure/round5-calibrated-28-20261022/print/slice-check/00H/slice-input.3mf

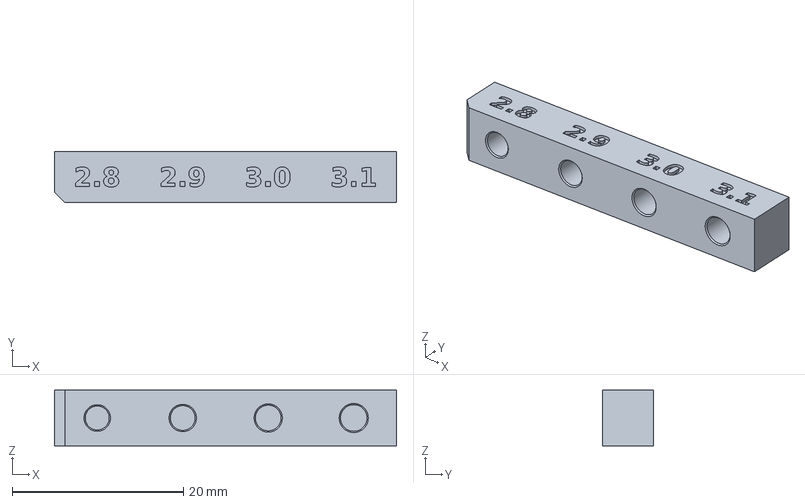
[picture p113: CAD file, 2026-10-23]
cad/v2/enclosure/round5-calibrated-28-20261022/print/slice-check/00H/slice-input.3mf
40.0 x 6.00 x 6.50 mm
