iThinkiKhan/gladiator-cad/cad/v2/enclosure/round5-calibrated-28-20261022/print/slice-check/01/slice-input.3mf

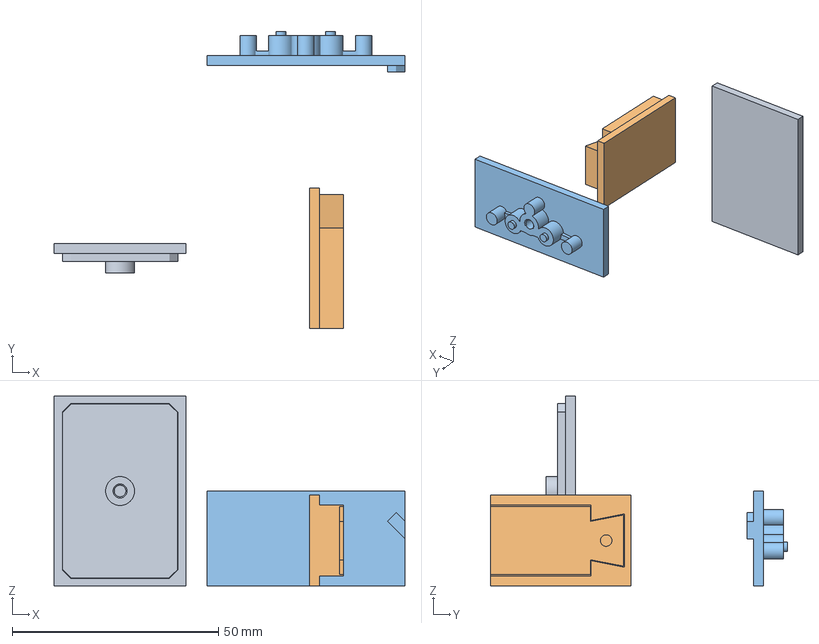
[picture p114: CAD file, 2026-10-23]
cad/v2/enclosure/round5-calibrated-28-20261022/print/slice-check/01/slice-input.3mf
85.0 x 71.9 x 46.0 mm
FIT_Scutum_Seat
FIT_Tablet_End
FIT_Aquila_Seat
