iThinkiKhan/gladiator-cad/cad/v2/enclosure/round5-calibrated-28-20261022/print/slice-check/02/slice-input.3mf

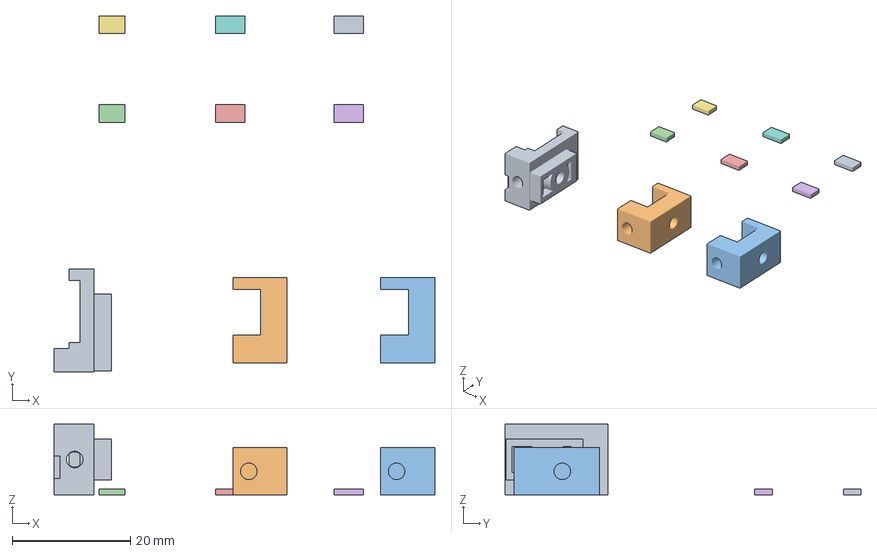
[picture p115: CAD file, 2026-10-23]
cad/v2/enclosure/round5-calibrated-28-20261022/print/slice-check/02/slice-input.3mf
64.4 x 60.2 x 12.0 mm
Crest_Clamp
Neck_Clamp_0
Neck_Clamp_1
Crest_Clamp_Shoe
Neck_Clamp_Shoe_21_5
Neck_Clamp_Shoe_57_5
SPARE_Crest_Shoe
SPARE_Neck_Shoe_A
SPARE_Neck_Shoe_B
