iThinkiKhan/gladiator-cad/cad/v2/enclosure/round5-calibrated-28-20261022/print/slice-check/04/slice-input.3mf

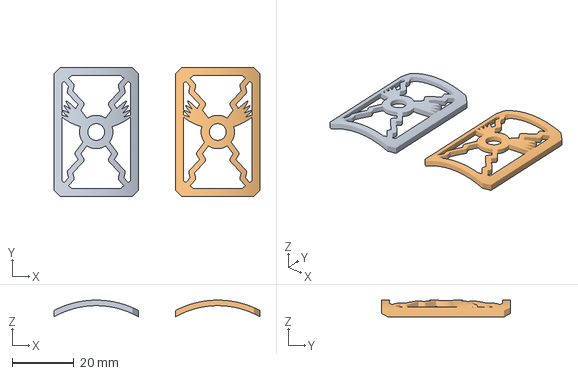
[picture p116: CAD file, 2026-10-23]
cad/v2/enclosure/round5-calibrated-28-20261022/print/slice-check/04/slice-input.3mf
66.6 x 41.6 x 5.41 mm
Scutum_Emblem_v2_L
Scutum_Emblem_v2_R
