iThinkiKhan/gladiator-cad/cad/v2/enclosure/round5-calibrated-28-20261022/print/slice-check/05/slice-input.3mf

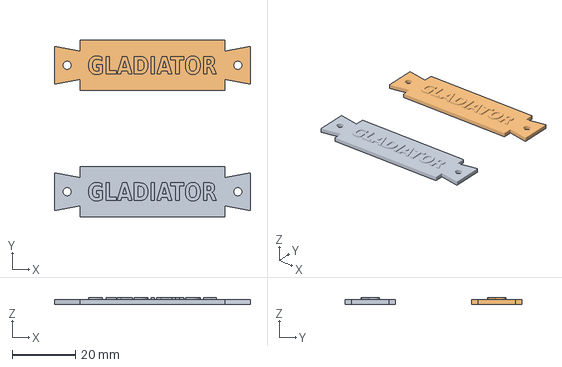
[picture p117: CAD file, 2026-10-23]
cad/v2/enclosure/round5-calibrated-28-20261022/print/slice-check/05/slice-input.3mf
62.0 x 56.0 x 2.10 mm
Tablet_L
Tablet_R
