iThinkiKhan/gladiator-cad/cad/v2/enclosure/round5-calibrated-28-20261022/print/slice-check/06/slice-input.3mf

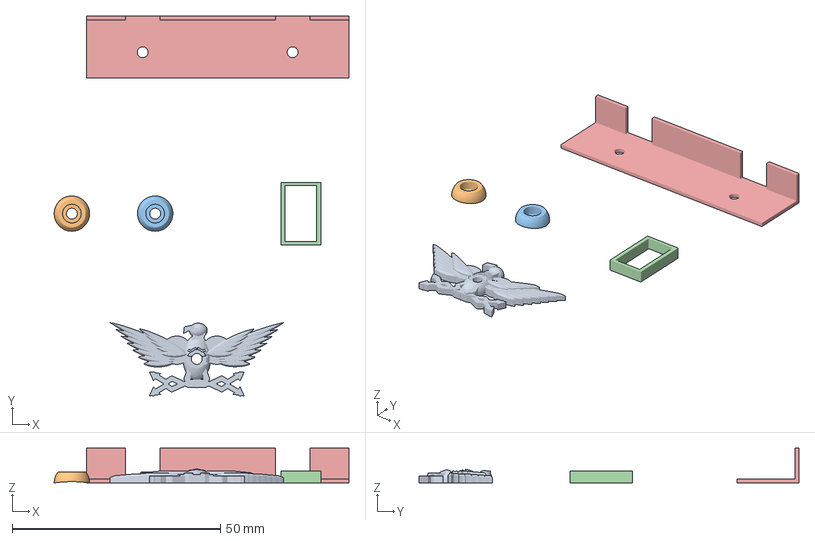
[picture p118: CAD file, 2026-10-23]
cad/v2/enclosure/round5-calibrated-28-20261022/print/slice-check/06/slice-input.3mf
70.7 x 91.2 x 8.40 mm
Aquila_Relief
Scutum_Boss_L
Scutum_Boss_R
Crest_Holder_Trim
Neck_Guard
