iThinkiKhan/gladiator-cad/cad/v2/enclosure/round5-calibrated-28-20261022/print/slice-check/08/slice-input.3mf

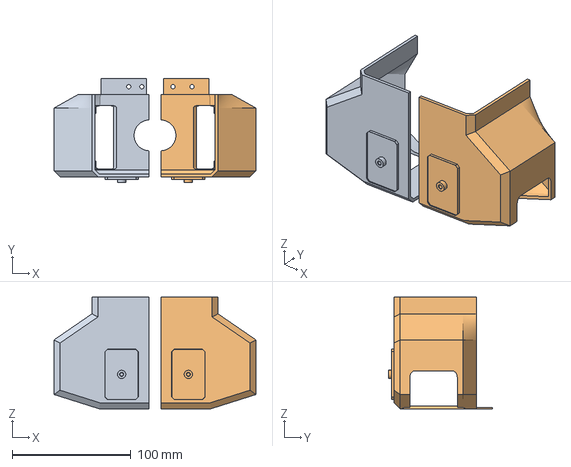
[picture p119: CAD file, 2026-10-23]
cad/v2/enclosure/round5-calibrated-28-20261022/print/slice-check/08/slice-input.3mf
170.2 x 87.8 x 94.0 mm
Front_Left
Front_Right
