iThinkiKhan/gladiator-cad/cad/v2/enclosure/round5-calibrated-28-20261022/print/slice-check/09/slice-input.3mf

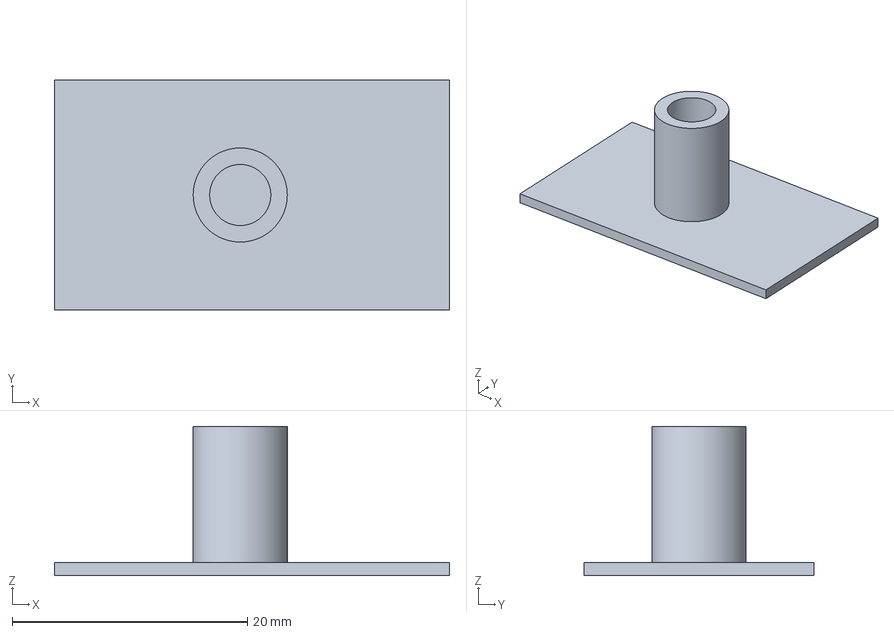
[picture p120: CAD file, 2026-10-23]
cad/v2/enclosure/round5-calibrated-28-20261022/print/slice-check/09/slice-input.3mf
33.6 x 19.6 x 12.7 mm
