iThinkiKhan/gladiator-cad/cad/v2/enclosure/round5-calibrated-28-20261022/style/stl/Crest_Clamp.stl

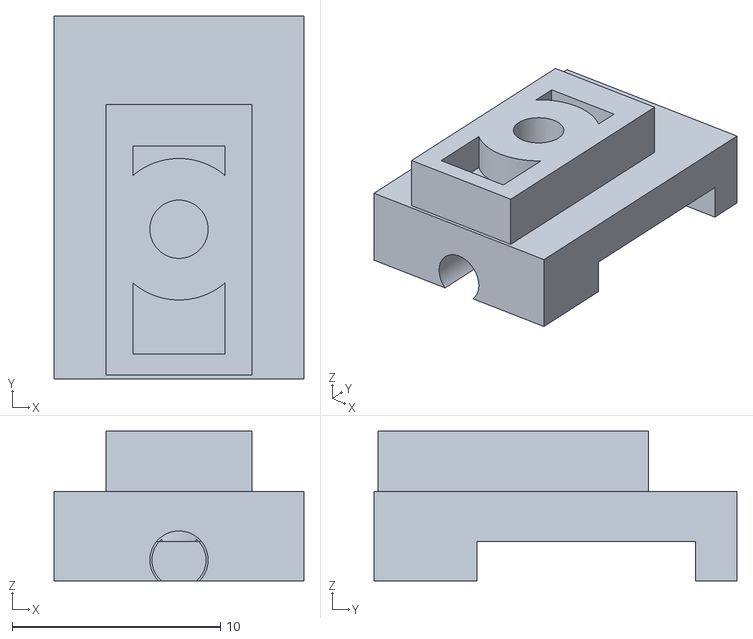
[picture p121: CAD file, 2026-10-23]
cad/v2/enclosure/round5-calibrated-28-20261022/style/stl/Crest_Clamp.stl
12.0 x 17.5 x 7.20
