iThinkiKhan/gladiator-cad/cad/v2/enclosure/round5-print-20261022/fit-test-stl/FIT_Tablet_End.stl

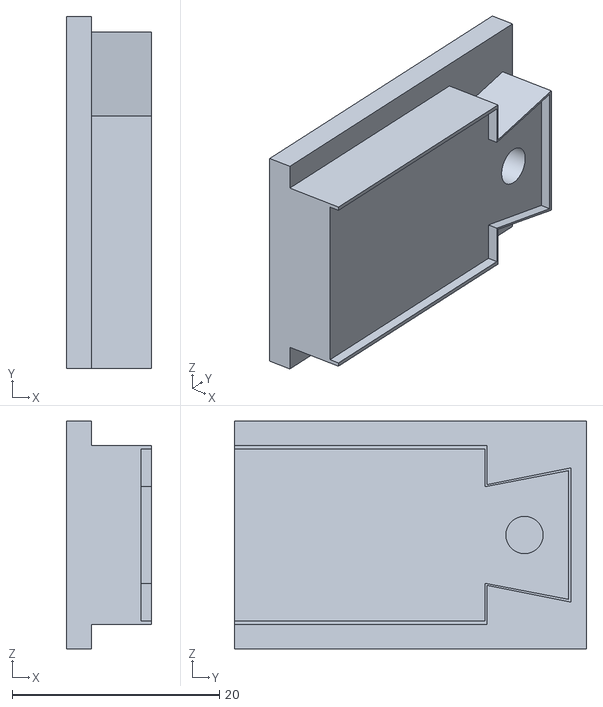
[picture p122: CAD file, 2026-10-22]
cad/v2/enclosure/round5-print-20261022/fit-test-stl/FIT_Tablet_End.stl
8.20 x 34.0 x 22.0
