iThinkiKhan/gladiator-cad/cad/v2/enclosure/round5-print-20261022/print-stl/Crest_Clamp.stl

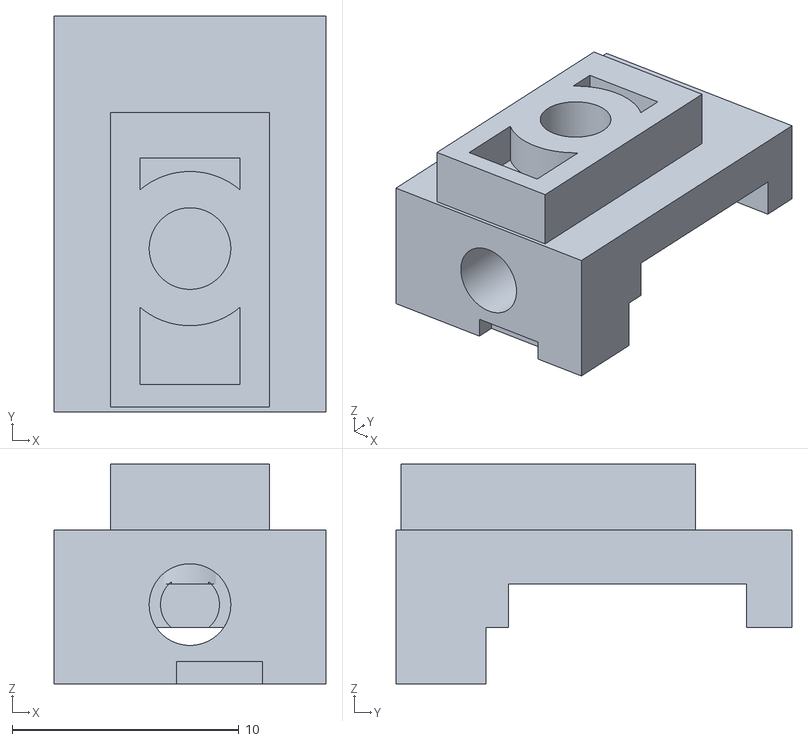
[picture p123: CAD file, 2026-10-22]
cad/v2/enclosure/round5-print-20261022/print-stl/Crest_Clamp.stl
12.0 x 17.4 x 9.70
