iThinkiKhan/gladiator-cad/cad/v2/enclosure/v2-20261013/Gladiator_Enclosure_v2_Panels.step

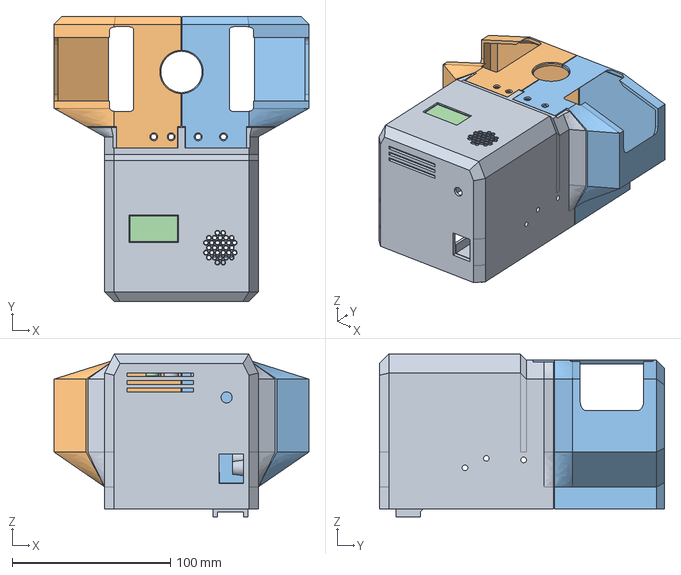
[picture p124: CAD file, 2026-10-21]
cad/v2/enclosure/v2-20261013/Gladiator_Enclosure_v2_Panels.step
161.0 x 180.0 x 102.9 mm
