iThinkiKhan/gladiator-cad/cad/v2/ina-mount/v3-20261019/Gladiator_INA_Mount_v3.step

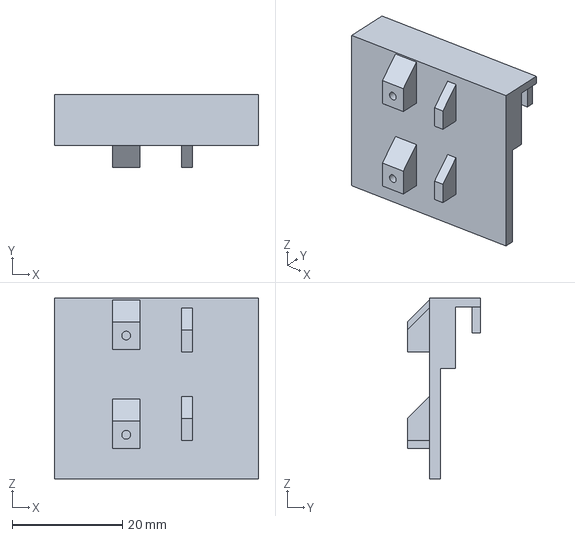
[picture p125: CAD file, 2026-10-21]
cad/v2/ina-mount/v3-20261019/Gladiator_INA_Mount_v3.step
37.0 x 13.3 x 32.8 mm
