iThinkiKhan/gladiator-cad/cad/v2/print-plates/Gladiator_v2_ORCA-R_Arch_Rails_Left-Right.3mf

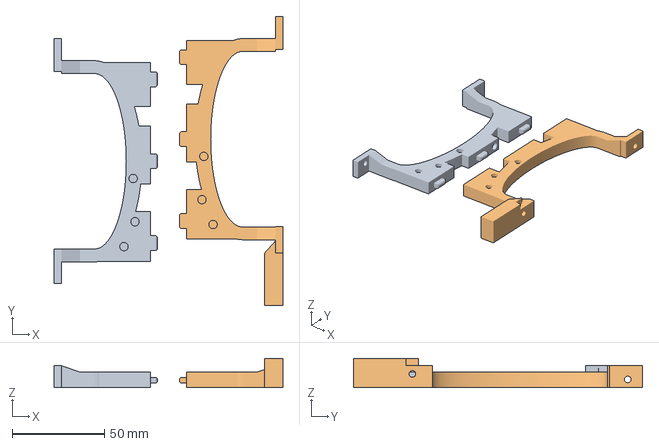
[picture p126: CAD file, 2026-10-22]
cad/v2/print-plates/Gladiator_v2_ORCA-R_Arch_Rails_Left-Right.3mf
124.4 x 157.0 x 16.0 mm
Arch_Rail_Left_v4
Arch_Rail_Right_v4
