iThinkiKhan/gladiator-cad/cad/v2/rails/v3-20261014/Gladiator_SideRail_Left_v3.stl

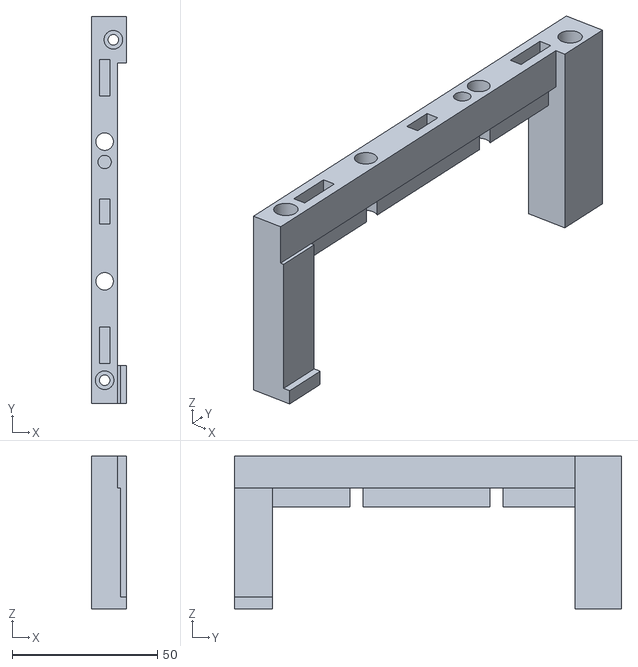
[picture p127: CAD file, 2026-10-21]
cad/v2/rails/v3-20261014/Gladiator_SideRail_Left_v3.stl
12.0 x 133.0 x 52.5
