iThinkiKhan/gladiator-cad/cad/v2/rails/v4-20261015/Gladiator_ArchRails_v4.step

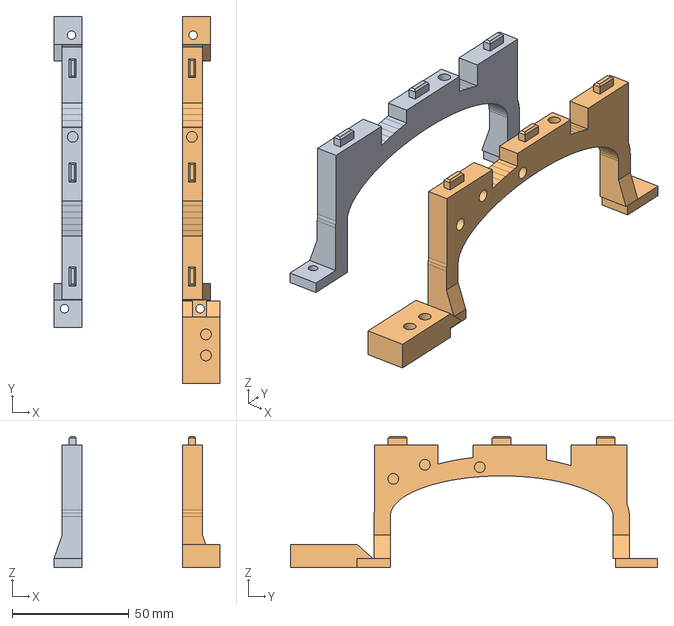
[picture p128: CAD file, 2026-10-21]
cad/v2/rails/v4-20261015/Gladiator_ArchRails_v4.step
71.0 x 157.0 x 56.2 mm
