iThinkiKhan/gladiator-cad/cad/v2/speaker-mount/v1-20261020/Gladiator_Speaker_Rail_Bracket_v1.step

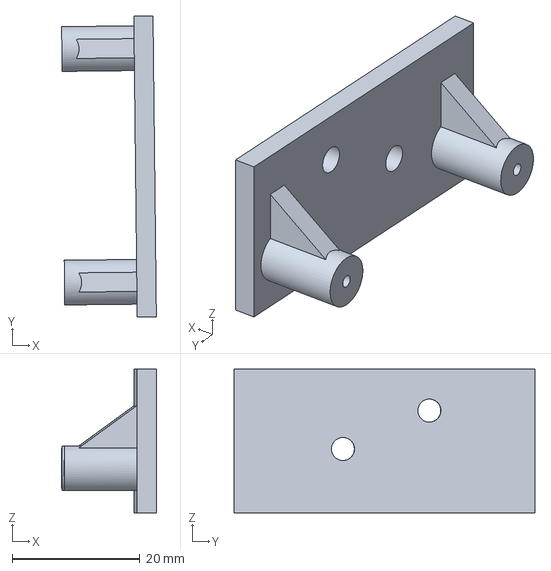
[picture p129: CAD file, 2026-10-21]
cad/v2/speaker-mount/v1-20261020/Gladiator_Speaker_Rail_Bracket_v1.step
14.8 x 47.0 x 22.5 mm
