iThinkiKhan/gladiator-cad/cad/v2/switch-enclosure/v1-20261015/Gladiator_SwitchEnclosure_v1.step

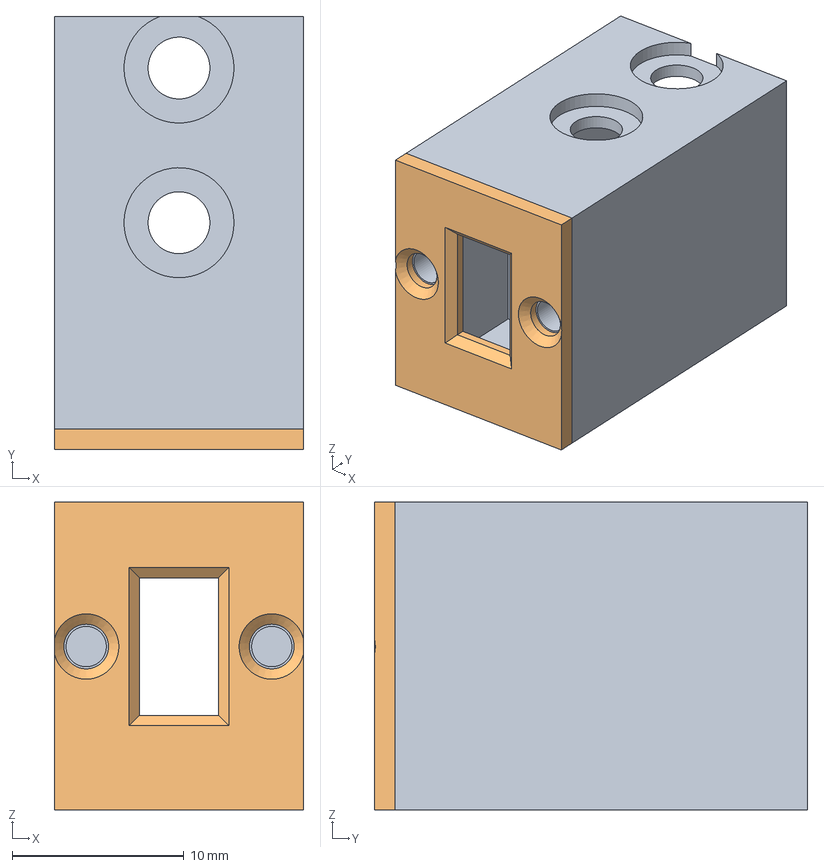
[picture p130: CAD file, 2026-10-21]
cad/v2/switch-enclosure/v1-20261015/Gladiator_SwitchEnclosure_v1.step
14.5 x 25.2 x 17.9 mm
