iThinkiKhan/gladiator-cad/cad/v2/switch-enclosure/v3-20261016/Gladiator_SwitchHolder_v3.step

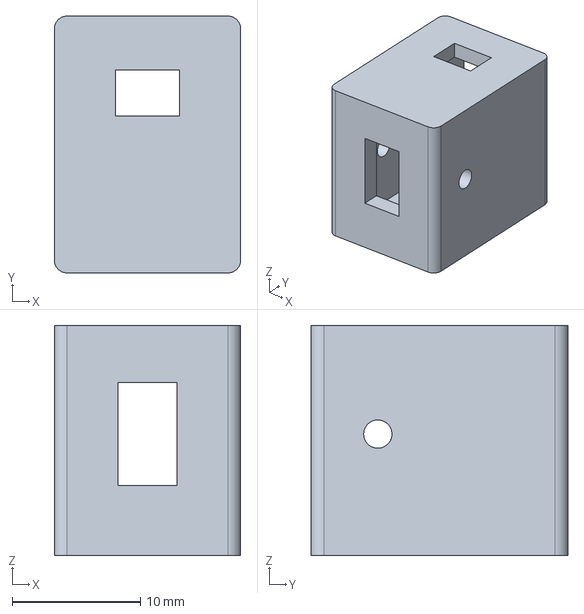
[picture p131: CAD file, 2026-10-21]
cad/v2/switch-enclosure/v3-20261016/Gladiator_SwitchHolder_v3.step
14.5 x 20.0 x 17.9 mm
