iThinkiKhan/gladiator-cad/cad/v2/upper-deck/_withdrawn-v5-20261019/Gladiator_UpperDeck_v5.step

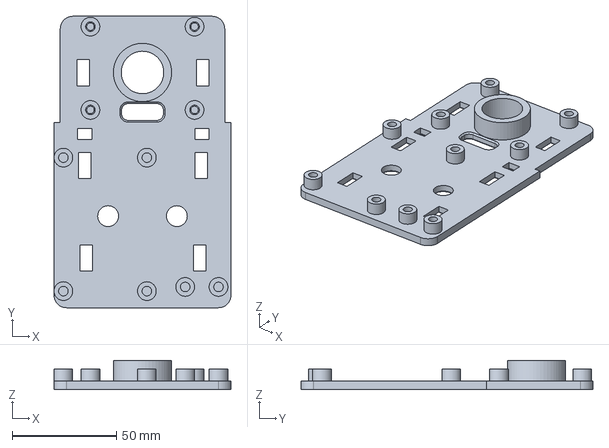
[picture p132: CAD file, 2026-10-21]
cad/v2/upper-deck/_withdrawn-v5-20261019/Gladiator_UpperDeck_v5.step
85.0 x 140.0 x 14.0 mm
