iThinkiKhan/gladiator-cad/cad/v2/upper-deck/v3-20261015/Gladiator_UpperDeck_v3.step

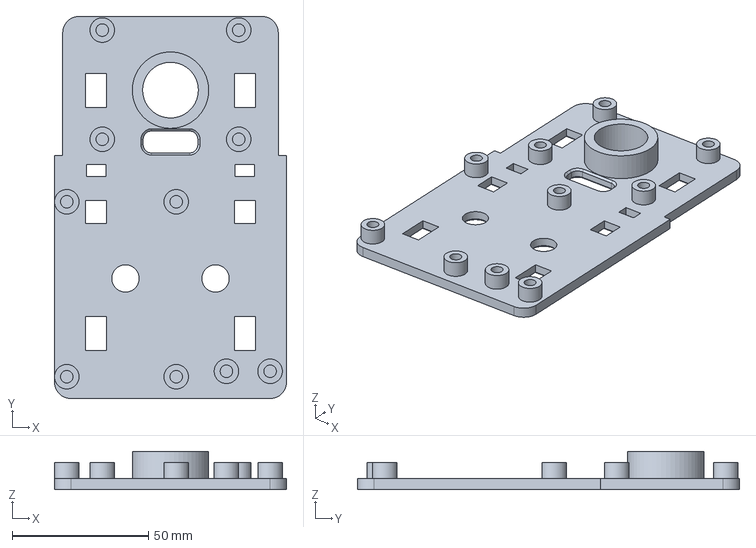
[picture p133: CAD file, 2026-10-21]
cad/v2/upper-deck/v3-20261015/Gladiator_UpperDeck_v3.step
85.0 x 140.0 x 14.0 mm
