iThinkiKhan/gladiator-cad/reference/esp32-cam/ESP3-CAM.STEP

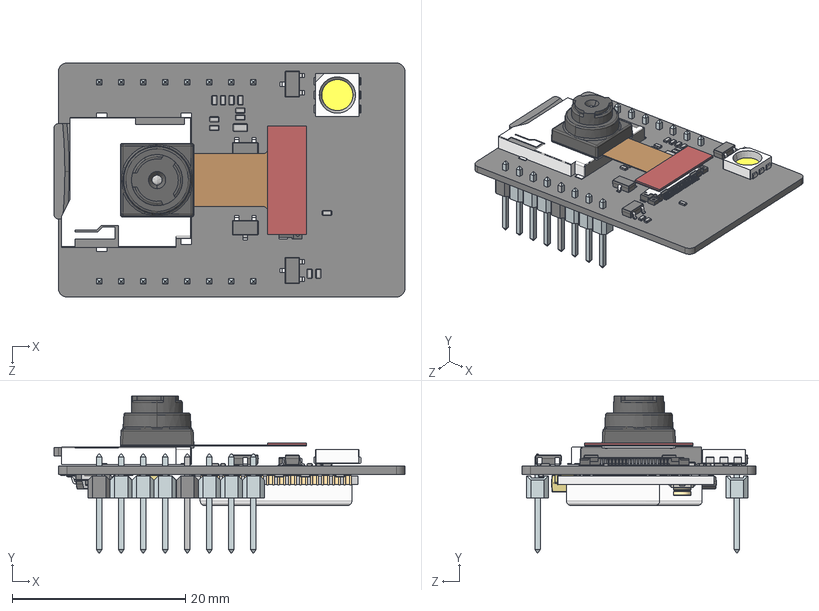
[picture p134: CAD file, 2026-10-22]
reference/esp32-cam/ESP3-CAM.STEP
40.5 x 18.1 x 27.0 mm
