iThinkiKhan/gladiator-cad/reference/test-batch-01/04_s3_expander_deck_fit_v06.step

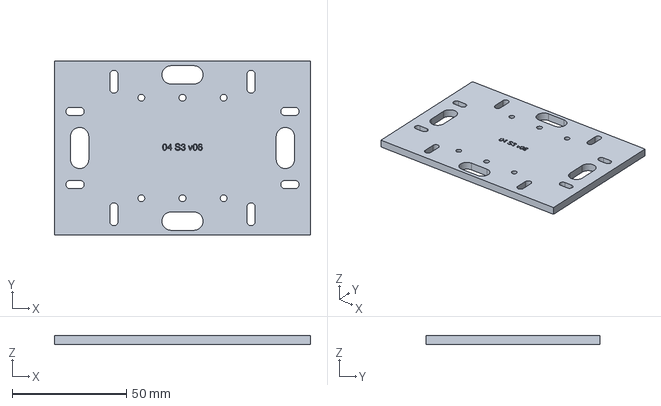
[picture p135: CAD file, 2026-09-15]
reference/test-batch-01/04_s3_expander_deck_fit_v06.step
112.0 x 76.0 x 4.00 mm
