iThinkiKhan/gladiator-cad/cad/build2-20260927/Gladiator_SideRail_L_v2-tall_print-on-outboard-face.stl

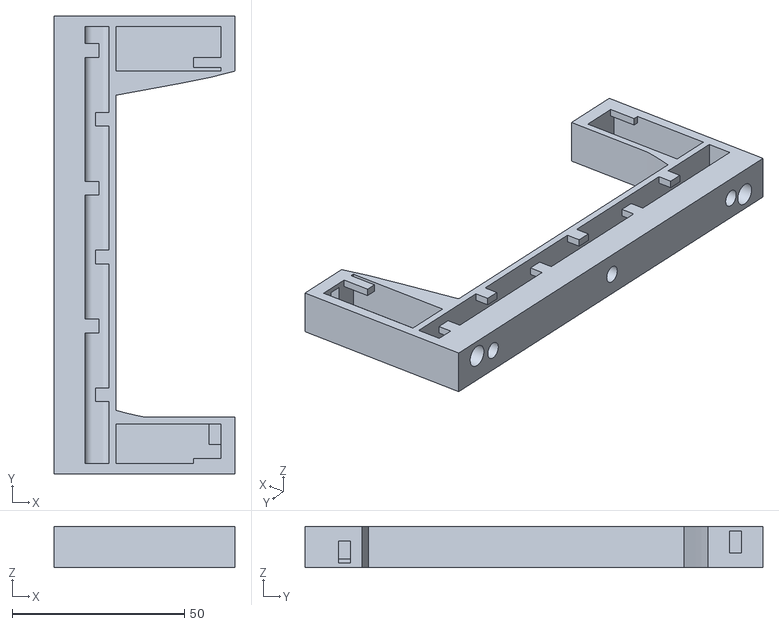
[picture p136: CAD file, 2026-09-27]
cad/build2-20260927/Gladiator_SideRail_L_v2-tall_print-on-outboard-face.stl
52.5 x 133.0 x 12.0
