iThinkiKhan/gladiator-cad/cad/coupons/Gladiator_Coupon_C_SelfTapPilots.FCStd

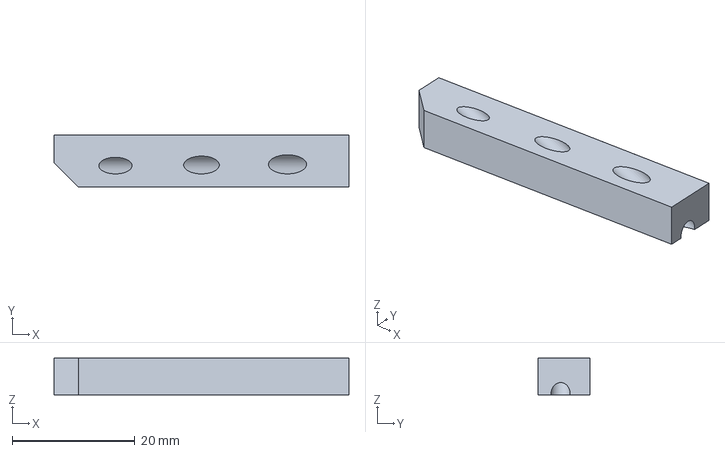
[picture p137: CAD file, 2026-09-19]
cad/coupons/Gladiator_Coupon_C_SelfTapPilots.FCStd
48.0 x 8.50 x 6.00 mm
