iThinkiKhan/gladiator-cad/cad/drivers/v5-interlock/stl/Wedge_Left.stl

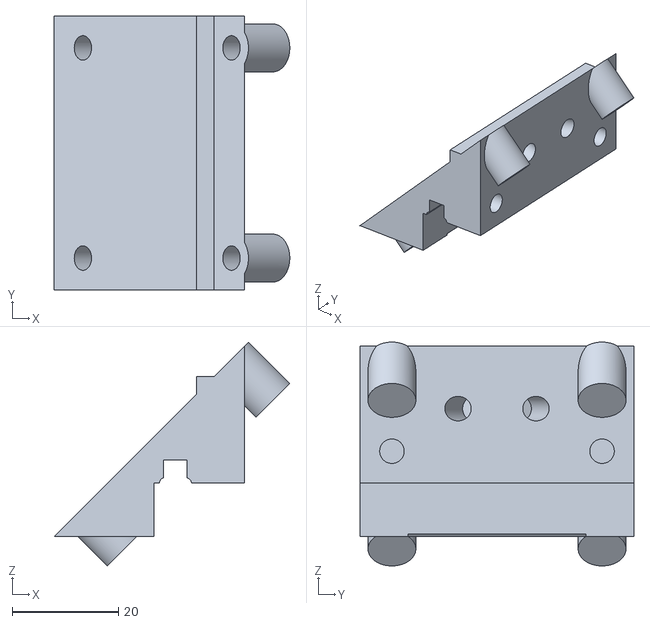
[picture p138: CAD file, 2026-09-23]
cad/drivers/v5-interlock/stl/Wedge_Left.stl
44.3 x 51.5 x 42.1
