iThinkiKhan/gladiator-cad/cad/enclosure/concept-20261013/Gladiator_Enclosure_Shell_CONCEPT.step

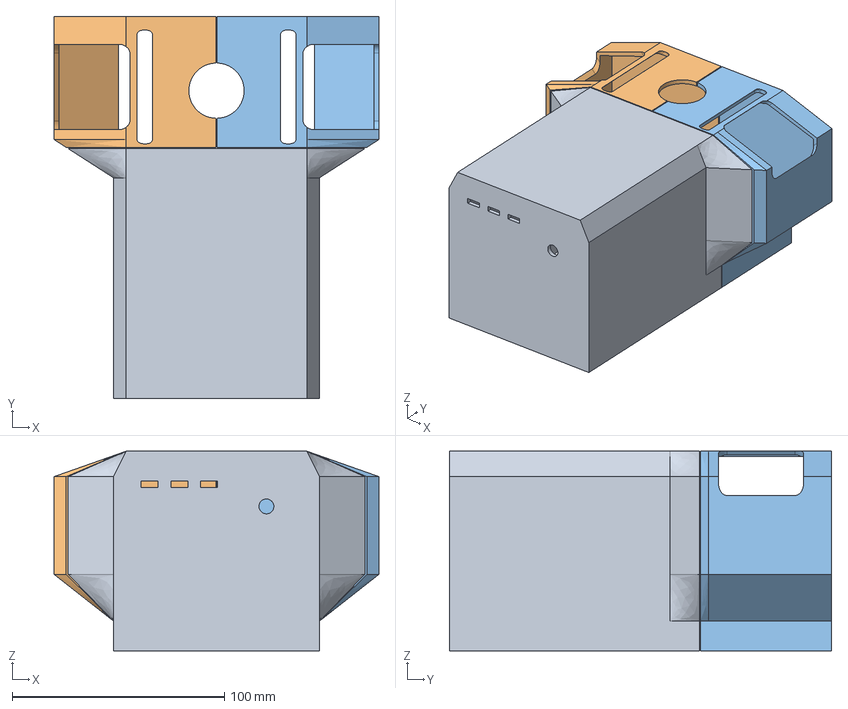
[picture p139: CAD file, 2026-10-21]
cad/enclosure/concept-20261013/Gladiator_Enclosure_Shell_CONCEPT.step
153.0 x 180.0 x 94.0 mm
