iThinkiKhan/gladiator-cad/cad/head/camera-service-v2-20261021/Gladiator_Camera_Service_v2.step

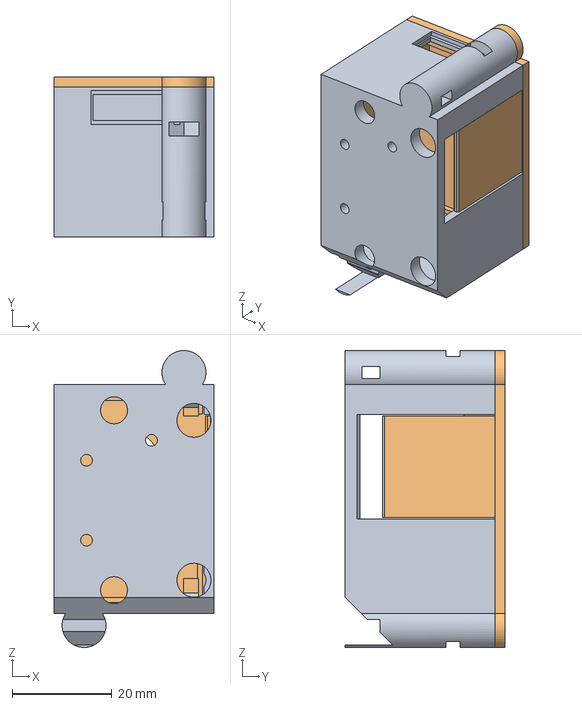
[picture p140: CAD file, 2026-10-22]
cad/head/camera-service-v2-20261021/Gladiator_Camera_Service_v2.step
32.0 x 32.0 x 59.4 mm
Mount_Tray
Screw_Cover
