iThinkiKhan/gladiator-cad/cad/head/coupons-r2-20260930/Gladiator_HeadCoupons_R2.step

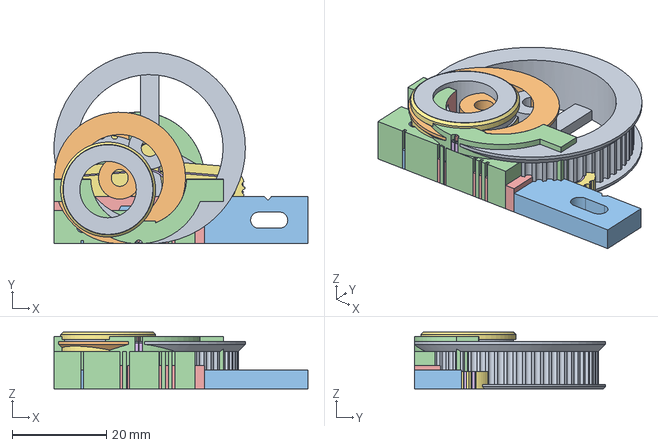
[picture p141: CAD file, 2026-10-01]
cad/head/coupons-r2-20260930/Gladiator_HeadCoupons_R2.step
54.0 x 40.7 x 12.1 mm
