iThinkiKhan/gladiator-cad/cad/head/coupons-r2-20260930/stl/Gladiator_HeadR2_H6b_HornPocket_2notch-EASY_pocket-up.stl

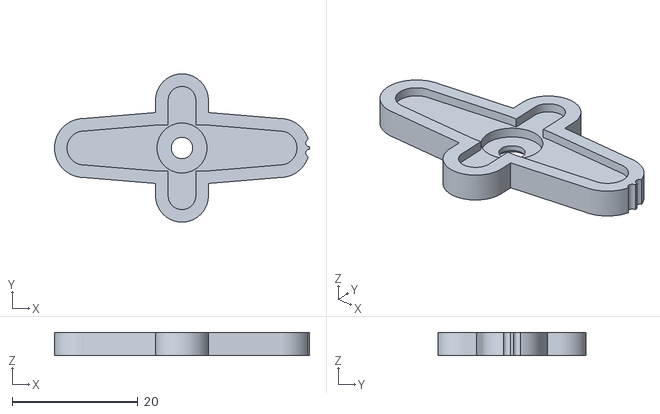
[picture p142: CAD file, 2026-10-01]
cad/head/coupons-r2-20260930/stl/Gladiator_HeadR2_H6b_HornPocket_2notch-EASY_pocket-up.stl
40.6 x 23.6 x 3.70
