iThinkiKhan/gladiator-cad/cad/head/coupons-r3-20261001/stl/Gladiator_HeadR3_R3c_GH44Register_recess-DOWN.stl

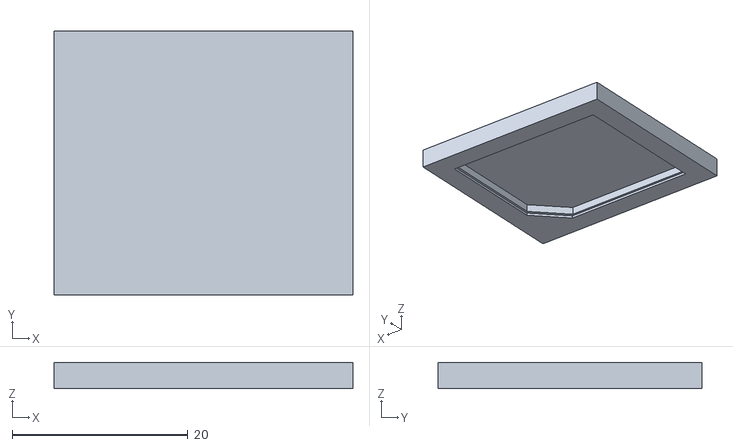
[picture p143: CAD file, 2026-10-02]
cad/head/coupons-r3-20261001/stl/Gladiator_HeadR3_R3c_GH44Register_recess-DOWN.stl
34.0 x 30.0 x 3.00
