iThinkiKhan/gladiator-cad/cad/head/integration-20261005/before/20261005T160338Z/cad/head/v04-pan-stack/stl/Gladiator_Head_v04_GH44_Dual_Carrier.stl

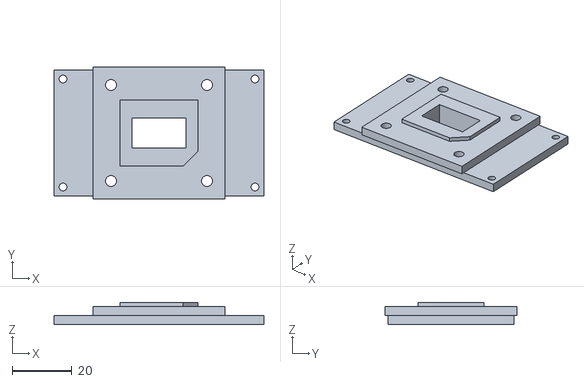
[picture p144: CAD file, 2026-10-01]
cad/head/integration-20261005/before/20261005T160338Z/cad/head/v04-pan-stack/stl/Gladiator_Head_v04_GH44_Dual_Carrier.stl
70.0 x 44.0 x 7.40
