iThinkiKhan/gladiator-cad/cad/head/orca-plates/Gladiator_Head_ORCA-B_TiltAndSensors_Yoke-Receiver-DisplayFrame-Carrier-ToF-Radar.3mf

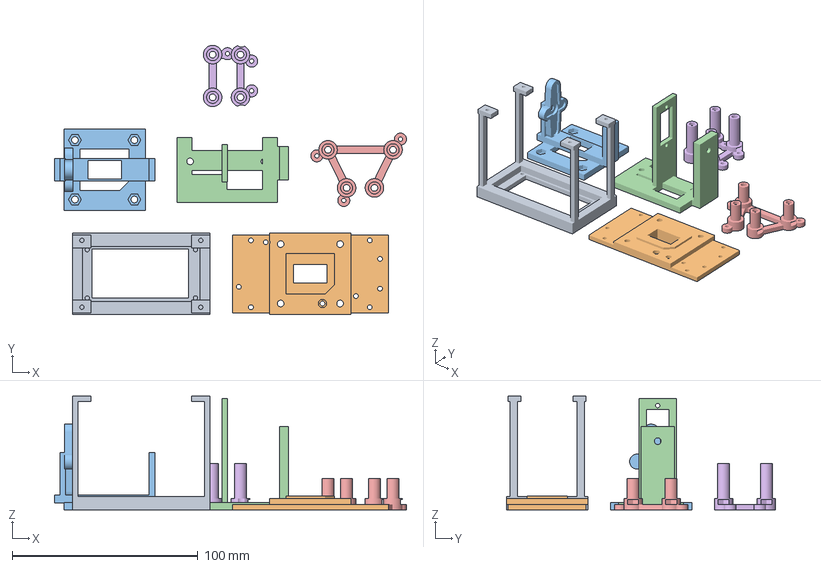
[picture p145: CAD file, 2026-10-06]
cad/head/orca-plates/Gladiator_Head_ORCA-B_TiltAndSensors_Yoke-Receiver-DisplayFrame-Carrier-ToF-Radar.3mf
189.5 x 145.0 x 61.2 mm
Rear_Display_Frame
GH44_Dual_Carrier
GH44_Tilt_Receiver
Tilt_Yoke
ToF_Sensor_Frame
Radar_Sensor_Frame
