iThinkiKhan/gladiator-cad/cad/head/v01/Gladiator_Head_v01.step

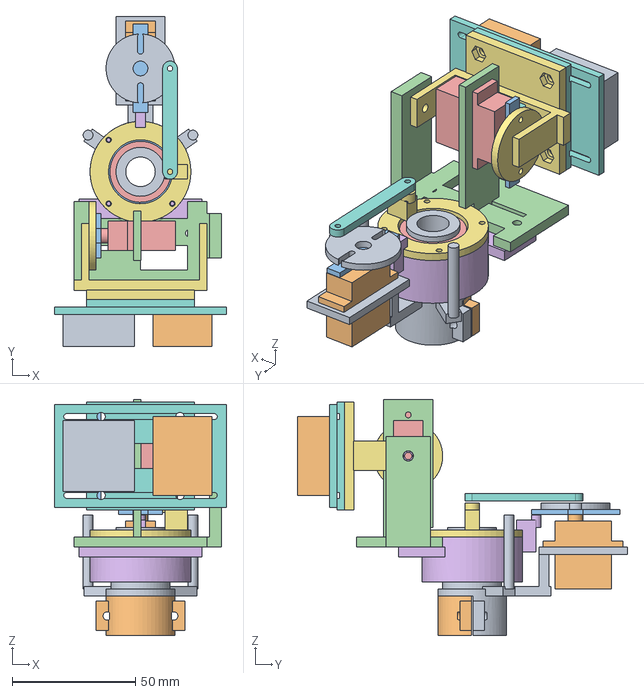
[picture p146: CAD file, 2026-09-19]
cad/head/v01/Gladiator_Head_v01.step
70.0 x 134.1 x 96.0 mm
