iThinkiKhan/gladiator-cad/cad/head/v02-screen-180/Gladiator_Head_v02_Screen180_Presented.step

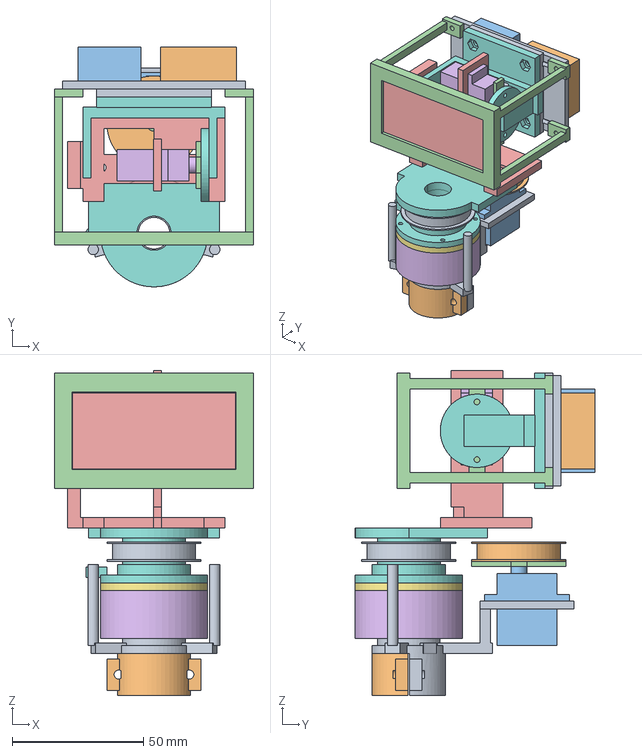
[picture p147: CAD file, 2026-09-19]
cad/head/v02-screen-180/Gladiator_Head_v02_Screen180_Presented.step
76.0 x 91.5 x 124.0 mm
