iThinkiKhan/gladiator-cad/cad/head/v03-belt/stl/Gladiator_Head_Neck_Clamp_Cap.stl

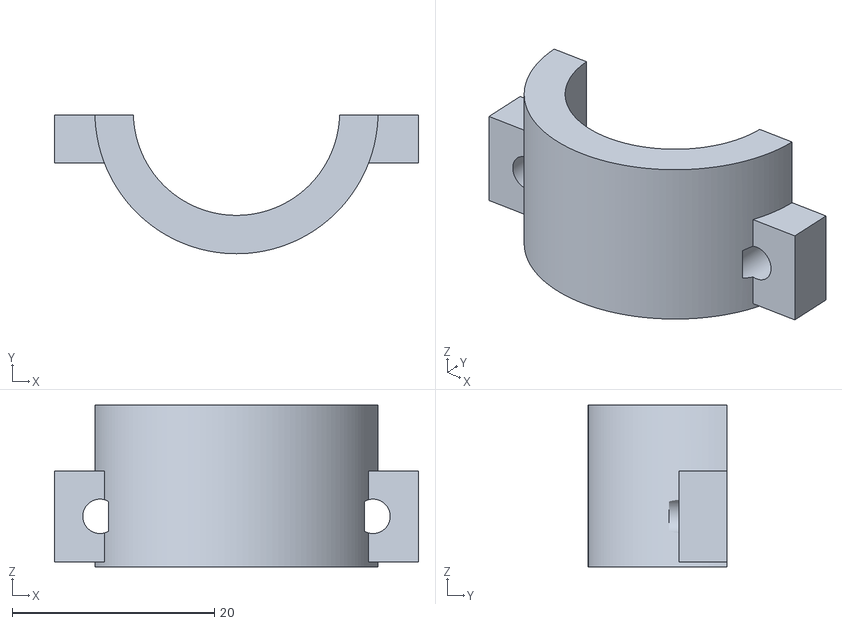
[picture p148: CAD file, 2026-09-19]
cad/head/v03-belt/stl/Gladiator_Head_Neck_Clamp_Cap.stl
36.0 x 13.7 x 16.0
