iThinkiKhan/gladiator-cad/cad/head/v04-pan-stack/stl/Gladiator_Head_v04_Rear_Display_Frame.stl

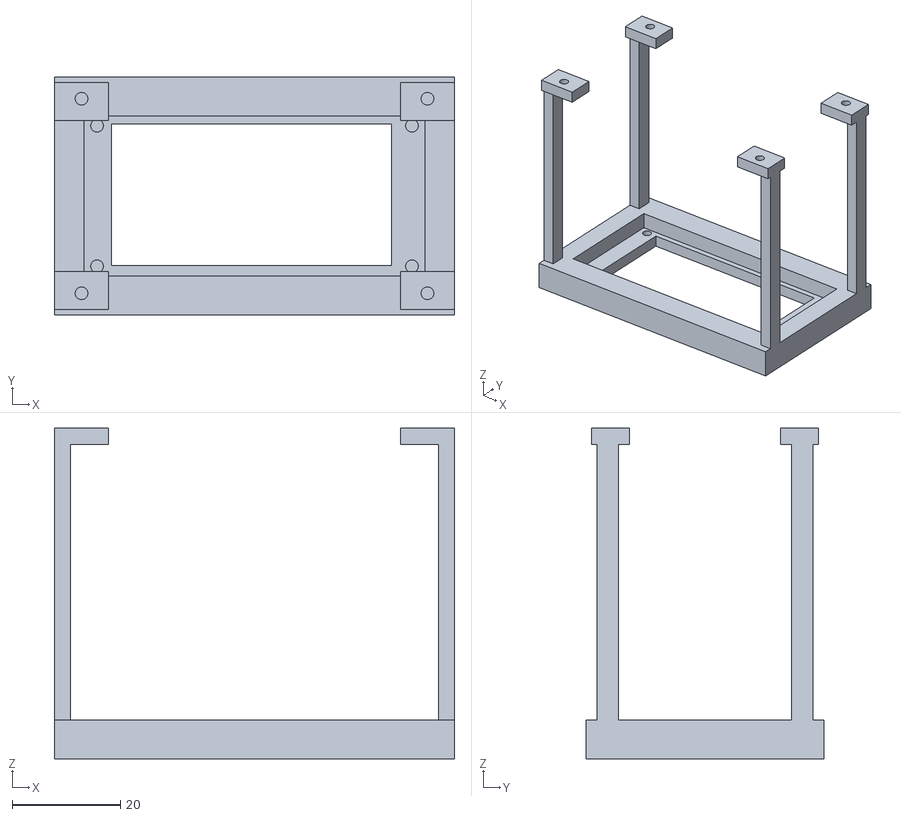
[picture p149: CAD file, 2026-10-01]
cad/head/v04-pan-stack/stl/Gladiator_Head_v04_Rear_Display_Frame.stl
74.0 x 44.0 x 61.2
