iThinkiKhan/gladiator-cad/(list of files, cad)

Other CAD files:
cad/head/esp32-cam-case-v4/preview/assembled_board_local.stl
cad/head/integration-20261005/before/20261005T160338Z/cad/head/v04-pan-stack/plates/Gladiator_Head_v04_PLATE4_Neck_Main.3mf
cad/head/orca-plates/Gladiator_Head_ORCA-C_Neck_Main_brim-and-supports.3mf
cad/head/v04-pan-stack/stl/Gladiator_Head_v04_Neck_Main.stl
cad/enclosure/concept-20261013/Gladiator_Enclosure_Concept.FCStd
cad/head/esp32-cam-case-v4/stl/ESP32_CAM_Case_v4_Tray.stl
cad/head/integration-20261005/geometry-preflight.FCStd
cad/head/review-20261005/candidate/Gladiator_Head_v04_PanStack.step
cad/head/v04-pan-stack/Gladiator_Head_v04_PanStack.step
cad/power-board/ina-cassette-v2/stl/INA226_Cassette_v2_installed.stl
cad/power-board/v3-cradle/stl/Gladiator_PowerBoardTray_v3_print-on-rear-face.stl
cad/power-switch/v1/stl/Gladiator_PowerSwitchHolder_v1_LEFT-rail_print-on-inboard-face_no-supports.stl
cad/power-switch/v1b/PowerSwitchHolder_v1b.step
cad/power-switch/v1b/stl/Gladiator_PowerSwitchHolder_v1b_robot-LEFT-rail_print-on-inboard-face_no-supports.stl
cad/v2/enclosure/round5-calibrated-28-20261022/mount-checked-release/slice-check/07/slice-input.3mf
cad/v2/enclosure/round5-calibrated-28-20261022/print/slice-check/00/slice-input.3mf
cad/v2/enclosure/round5-calibrated-28-20261022/print/slice-check/03/slice-input.3mf
cad/v2/enclosure/round5-calibrated-28-20261022/print/slice-check/07/slice-input.3mf
cad/v2/enclosure/round5-calibrated-28-20261022/SD_PACKAGE/CAD/Gladiator_Round5_PrintParts.step
cad/v2/enclosure/round5-calibrated-28-20261022/SD_PACKAGE/CAD/stl/Rear_Hood.stl
cad/v2/enclosure/round5-calibrated-28-20261022/SD_PACKAGE/plates/GLAD_01_WHITE_EMBLEMS_V2.3mf
cad/v2/enclosure/round5-calibrated-28-20261022/shell-time-optimized/DELIVERY/plates/GLAD_04_HOOD_SD_M2_28.3mf
cad/v2/enclosure/round5-calibrated-28-20261022/shell-time-optimized/slice-check/07/slice-input.3mf
cad/v2/enclosure/round5-calibrated-28-20261022/shell-time-optimized/slice-check/08/slice-input.3mf
cad/v2/enclosure/round5-calibrated-28-20261022/single-panels-5h/DELIVERY/plates/GLAD_05L_PANEL_SD_M2_28.3mf
cad/v2/enclosure/round5-calibrated-28-20261022/single-panels-5h/slice-check/08L/slice-input.3mf
cad/v2/enclosure/round5-calibrated-28-20261022/single-panels-5h/slice-check/08R/slice-input.3mf
cad/v2/enclosure/round5-calibrated-28-20261022/style/baseline-v28/Gladiator_Enclosure_v2_Lens_Plate.stl
cad/v2/enclosure/round5-calibrated-28-20261022/style/Gladiator_Round5_PrintParts.step
cad/v2/enclosure/round5-calibrated-28-20261022/support-time-comparison/hood_base35/slice-input.3mf
cad/v2/enclosure/round5-calibrated-28-20261022/support-time-comparison/hood_base35_speed80/hood_base35_speed80.3mf
cad/v2/enclosure/round5-calibrated-28-20261022/support-time-comparison/hood_support80/slice-input.3mf
cad/v2/enclosure/round5-calibrated-28-20261022/support-time-comparison/panels_normal/slice-input.3mf
cad/v2/enclosure/round5-calibrated-28-20261022/support-time-comparison/panels_normal_base35/slice-input.3mf
cad/v2/enclosure/round5-calibrated-28-20261022/support-time-comparison/panels_support80/panels_support80.3mf
cad/v2/enclosure/round5-calibrated-28-20261022/support-time-comparison/panels_tree_base35/slice-input.3mf
cad/v2/enclosure/round5-calibrated-28-20261022/support-time-comparison/panels_tree_base35_speed80/slice-input.3mf
cad/v2/enclosure/round5-print-20261022/Gladiator_Round5_Print.FCStd
cad/v2/enclosure/round5-print-20261022/jim-settings-reslice/3MF_open_in_Orca/GLAD_05_PANELS_SD_JIM.3mf
cad/v2/enclosure/round5-print-20261022/jim-settings-reslice/final_3MF/GLAD_02_SILK_BRIM_JIM.3mf
cad/v2/upper-deck/v4-20261016/Gladiator_UpperDeck_v4.step
cad/coupons/m2-d3-l3-20261022/M2_D3_L3_Coupon_EnderNeo_PLA.3mf
cad/coupons/m2-d3-l3-mini-20261022/M2_D3_L3_Coupon_EnderNeo_PLA.3mf
cad/drivers/v2-standoff/stl/DriverMount_v2_Left.stl
cad/drivers/v3-wedge45/stl/DriverMount_v3_Left.stl
cad/head/drive-coupons-20260922/Drive60_HornSlot_Fit_Coupon.step
cad/head/esp32-cam-case-v4/stl/ESP32_CAM_Case_v4_Lid.stl
cad/head/integration-20261005/delivery/Gladiator_MastHead_v05_20261005/mechanical-plates-v04/Gladiator_Head_v04_PLATE3_Tilt_Yoke-Receiver-DisplayFrame.3mf
cad/head/v01/fit-prototypes/GH44_Blank_Carrier.stl
cad/head/v04-pan-stack/plates/Gladiator_Head_v04_PLATE3_Tilt_Yoke-Receiver-DisplayFrame.3mf
cad/mast-base/reprint-20260926/Gladiator_MastBase_spigot-3p5_chamfer-0p8_UP.stl
cad/TestPrint01/01_insert_clearance_gauge.step
cad/TestPrint01/02_gladiator_crossbar_coupon.step
cad/TestPrint01/03_side_rail_wire_coupon.step
cad/TestPrint01/04_s3_expander_deck_fit.step
cad/TestPrint01/06_bts7960_vertical_cassette_fit.step
cad/TestPrint01/06_bts7960_vertical_cassette_fit_v06.step
cad/TestPrint01/07_bts7960_spacers_x4.step
cad/TestPrint01/08_tower_collar_19.0mm.step
cad/TestPrint01/08_tower_collar_19.5mm.step
cad/TestPrint01/08_tower_collar_20.0mm.step
cad/TestPrint01/08_tower_collar_20.5mm.step
cad/TestPrint01/08_tower_collar_21.0mm.step
cad/TestPrint01/09_microservo_clearance_gauge.step
cad/TestPrint01/10_wire_management_gauge.step
cad/antenna/v3-screw-access/AntennaMount_v3_print-on-front-face.stl
cad/antenna/v3-screw-access/AntennaMount_v3_screw-access.step
cad/antenna/v3-screw-access/Gladiator_Master_antenna_v3_candidate.FCStd
cad/build2-20260927/Gladiator_Coupon_RailFrontFoot_R_v2_deck-face-down.stl
cad/build2-20260927/Gladiator_MastTube_v2-Z130_print-vertical.stl
cad/build2-20260927/Gladiator_SideRail_R_v2-tall_print-on-outboard-face.stl
cad/coupons/Gladiator_Coupon_A_InsertBores.FCStd
cad/coupons/Gladiator_Coupon_A_InsertBores.stl
cad/coupons/Gladiator_Coupon_B_Fits.FCStd
cad/coupons/Gladiator_Coupon_B_Fits.stl
cad/coupons/Gladiator_FitCoupon_v1.FCStd
cad/coupons/Gladiator_FitCoupon_v1.step
cad/coupons/Gladiator_FitCoupon_v2.FCStd
cad/coupons/Gladiator_FitCoupon_v2.step
cad/coupons/Gladiator_FitCoupon_v2.stl
cad/coupons/m2-d3-l3-20261022/M2_D3_L3_Coupon.FCStd
cad/coupons/m2-d3-l3-20261022/M2_D3_L3_Coupon.stl
cad/coupons/m2-insert-v1/Gladiator_Coupon_M2_Inserts.stl
cad/drivers/v2-standoff/DriverMount_v2.FCStd
cad/drivers/v3-wedge45/DriverMount_v3.FCStd
cad/drivers/v4-twopiece/DriverMount_v4.FCStd
cad/drivers/v4-twopiece/DriverMount_v4.step
cad/drivers/v4-twopiece/stl/Base_Left.stl
cad/drivers/v4-twopiece/stl/Wedge_Left.stl
cad/drivers/v5-interlock/DriverMount_v4.step
cad/drivers/v5-interlock/DriverMount_v5.FCStd
cad/head/coupons-r2-20260930/Gladiator_HeadCoupons_R2.FCStd
cad/head/coupons-r2-20260930/Gladiator_HeadR2_CouponPlate_ALL-9-pieces.3mf
cad/head/coupons-r2-20260930/stl/Gladiator_HeadR2_H1a_BeltPulley-60T_flange-down.stl
cad/head/coupons-r2-20260930/stl/Gladiator_HeadR2_H1b_BeltPulley-40T_flange-down.stl
cad/head/coupons-r2-20260930/stl/Gladiator_HeadR2_H1c_BeltBar_flat.stl
cad/head/coupons-r2-20260930/stl/Gladiator_HeadR2_H2a_NeckCollar_key-1notch-TIGHT_seat-disc-down.stl
cad/head/coupons-r2-20260930/stl/Gladiator_HeadR2_H2b_NeckCollar_key-2notch-LOOSE_seat-disc-down.stl
cad/head/coupons-r2-20260930/stl/Gladiator_HeadR2_H2c_NeckCollarCap_standing.stl
cad/head/coupons-r2-20260930/stl/Gladiator_HeadR2_H3_CirclipPost_shoulder-down.stl
cad/head/coupons-r2-20260930/stl/Gladiator_HeadR2_H3b1_BearingPost-1-notch-19.95_shoulder-down.stl
cad/head/coupons-r2-20260930/stl/Gladiator_HeadR2_H3b2_BearingPost-2-notch-20.05_shoulder-down.stl
cad/head/coupons-r2-20260930/stl/Gladiator_HeadR2_H4_M2Pilots_flat.stl
cad/head/coupons-r2-20260930/stl/Gladiator_HeadR2_H4b_M2Pilots-BIGGER_flat.stl
cad/head/coupons-r2-20260930/stl/Gladiator_HeadR2_H5_M3NutSockets_flat.stl
cad/head/coupons-r2-20260930/stl/Gladiator_HeadR2_H6a_HornPocket_1notch-SNUG_pocket-up.stl
cad/head/coupons-r3-20261001/stl/Gladiator_HeadR3_R3a_ScreenSlice_notch-is-PIN-edge_bezel-face-down.stl
cad/head/drive-coupons-20260922/Drive60_HornSlot_Fit_Coupon.FCStd
cad/head/integration-20261005/before/20261005T160338Z/cad/head/v04-pan-stack/Gladiator_Head_v04_PanStack.FCStd
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
