iThinkiKhan/gladiator-cad/docs/print-coupon.md

# Fit + calibration coupon v2

`cad/coupons/Gladiator_FitCoupon_v2.stl` — 88 x 62 x 11 mm, ~31 g, prints flat with **no support**.

One print answers the questions that would otherwise be answered by scrapping a rail or a deck.
There are 16 heat-set insert bores across the rails and the upper deck, worth about 133 g of
filament between them, and all of them ride on one unverified number.

## What is on it

Features are identified by a **tick mark** beside each one: the tick gets longer as the size
goes up (3 / 6 / 9 / 12 mm). Compare lengths rather than counting dots.

| Tick | Feature | Nominal | What it tells you |
| ---: | --- | ---: | --- |
| shortest | Insert boss | bore **4.0** | Heat-set insert fit. Bosses are 9 dia x 6 tall on 4 of plate, bored 7.5 deep leaving a 2.5 floor — **identical to the real deck bosses**, which are the tightest case in the design. |
| 2 | Insert boss | bore **4.2** | |
| 3 | Insert boss | bore **4.4** | This is what every part currently uses. |
| longest | Insert boss | bore **4.6** | |
| 1 | Spigot peg | **13.6** dia | Try these in the **real aluminium deck's 14.0 tower hole**. The mast base's spigot is 13.8 and drops through with only **1 mm to the motor** underneath — worth knowing before printing MastBase. |
| 2 | Spigot peg | **13.8** dia | Current design value. |
| 3 | Spigot peg | **14.0** dia | |

Unpipped features, left to right, smallest first:

- **M3 clearance holes** — 3.2 / 3.4 / 3.6 through the full 4 mm (the deck's thickness). Design uses 3.4.
- **M2 clearance holes** — 2.2 / 2.4 / 2.6. Design uses 2.4.
- **Rail foot slot** — 3.4 wide with 3.0 of travel, exactly as built into the rail feet. Check that an
  M3 screw passes *and* that an M3 nut sits under it, and that it actually slides.

## Using it as printer calibration

The plate's own outline is the reference — **88.00 x 62.00 x 4.00** is a longer, more sensitive
baseline than a 20 mm test cube.

Measure both of these, because **they will not match**, and the difference is the useful part:

1. **An outside feature** — the plate's 88.00 and 62.00, and the peg diameters (13.60 / 13.80 / 14.00).
   Outside features usually print **oversize** by roughly 0.05–0.2 mm.
2. **An inside feature** — the clearance holes (3.20 / 3.40 / 3.60) and the bores.
   Holes usually print **undersize** by a similar amount.

Knowing both numbers separately is what lets you pick a nominal for every other part on the robot,
rather than guessing. If, say, your holes come out 0.15 small and your pegs 0.1 large, then the
4.4 bore is really behaving like a 4.25 and the 13.8 peg like a 13.9.

Measure the plate near its **top face**, not at the bed. The first layer squashes out (elephant's
foot) and will read a few tenths over regardless of how well the printer is calibrated.

## Reading the results

- **Insert bores** — heat an insert into each. The right one pulls in square, sits flush or a hair
  proud, and does not split the boss or push a bulge out the side. Too tight splits it; too loose
  spins under torque. Note the winning number.
- **Pegs** — the right one enters the aluminium hole with light finger pressure and no rock. If 13.8
  is tight, that is your printer running oversize on outside features and it applies to every other
  outside dimension too.
- **Slot** — if a nut will not sit, the slot needs widening before the rails are printed, not after.

If the winning bore is not 4.4, tell me the number and I will change it in one place — it is a
single spreadsheet parameter (`rail_insert_dia`) feeding all 16 bores.

## PLA now, PETG later

Printing the first batch in PLA is sensible for fit checking, with three caveats.

- **Heat-set inserts run cooler in PLA** — roughly 200 C on the iron versus 240–250 for PETG. PLA is
  less forgiving: let the insert sink under its own weight rather than pushing, or it will bulge the
  boss.
- **Reprint this coupon when you switch to PETG.** PETG shrinks more than PLA, so holes tend to come
  out tighter and the winning bore may well be a size up. It is 25 g to re-check and it protects the
  real parts again.
- **PLA softens around 60 C.** Fine for fit-checking and for driving gently, but the rails and deck
  sit near the motor drivers and the battery, which is exactly why the design specifies PETG. Do not
  treat PLA structural parts as final.

## After this, print in this order

1. **One side rail** — easiest print in the set (on its outboard face, 12 mm tall, ~159 mm2 of
   support) and it bolts straight to the real aluminium deck, so it tests the insert bores and the
   slot alignment against hardware that cannot be adjusted.
2. **Mast base** — small, and it proves the spigot and the 1 mm motor clearance.
3. Second rail, then the **upper deck** (now prints flat with zero support).
4. Antenna mount, power shield.

Not yet: the **mast tube** (buy a 20/12 aluminium or carbon tube instead — printed vertically its
layer lines run perpendicular to the bending load), the **driver mounts** (check the 2.7 self-tap
holes against a real board first), and anything under **`HeadCandidate_v01`** (that interface is not
frozen).

## v1 is superseded

v1 packed its features too tightly: the identification dots sat **1.50 mm** apart and 22 feature
pairs were closer than 3.5 mm. At this profile a wall loop is 0.4-0.45 mm and there are four of
them, so ~1.75 mm of perimeter grows in from each side — adjacent dots would have merged into a
blur and been uncountable, defeating the point of marking them.

v2 spreads everything out (88 x 62 rather than 80 x 52, +6 g) and swaps the counted dots for a
single length-coded tick per feature. Measured on the solid, the tightest gap anywhere is now
**4.05 mm** and nothing is under 3.5. The v1 STL has been removed from the incoming folder so there
is no chance of slicing the cramped one.

## Which coupon was actually printed

**The all-in-one v2 (88 x 62, ~31 g) is the one physically printed on 2026-09-17.** It is kept in
`cad/coupons/` for traceability even though it has been superseded, so that when measurements come
back there is no ambiguity about what geometry produced them.

It remains fully valid: its insert bosses reproduce the real deck stack exactly (9 dia boss, 6 tall
on 4 of plate, bored 7.5 deep leaving a 2.5 floor), identical to Coupon A, and it was exported at
0.01 mm deflection so the holes are true size. It also covers the peg, clearance-hole and slot
tests, so **Coupon B is not needed for this round**.

## Going forward: one coupon per question

The all-in-one was too slow to print - 86% of its volume was base plate that existed only to hold
unrelated tests far enough apart not to merge, so every test added made every other test slower.
Future coupons are split:

| Coupon | Size | Answers |
| --- | --- | --- |
| `Gladiator_Coupon_A_InsertBores` | 62 x 17, ~6.5 g | Heat-set insert bore size - gates the rails and upper deck |
| `Gladiator_Coupon_B_Fits` | 68 x 34, ~15 g | Spigot pegs, screw clearances, rail slot - needed before the mast base |

Both use a **clipped corner** for orientation rather than tick marks or counted pips, which is what
forced the old plate to be so large. On A the clipped end is the 4.0 bore; sizes increase away from
it.
