iThinkiKhan/gladiator-cad/docs/ai/agents/codex-round5-print-20261022.md

# Round 5 print preparation — Codex, 2026-10-22

User needs the event build in two days. User confirmed SD card, EnderNeo SAFE, and distinct silk settings. M2 inserts arrive today; user will measure them. Newer shared note identifies nominal listing data M2 D3 L3 (3mmOD,3mmlength), not a measured stock/bore result. Jim selected a four-hole upright mini coupon. No insert OD/length or physical bore/inset-fit result is accepted yet. Original enclosure physical fit over the assembled wiring was asked but not confirmed.

Current print native: cad/v2/enclosure/round5-print-20261022/Gladiator_Round5_Print.FCStd; matching22-solid STEP alongside. Original v2.8 and the earlier Round5 styling native remain untouched and hash-checked. Added material on the NEW Crest_Clamp encloses its formerly open-bottom side insert; a small lower-front yoke relief clears51 tilt samples, one degree apart. Original clamp material/contact surfaces retained. Added108.047mm3;0.5mm complete material surround sampled432times over assumed3mm insert engagement. Lower web1.7mm nominal wall except local0.7mm lip at yoke relief: test real insert retention on this clamp, not only the generic coupon. No old robot frame part changed. STEP22validsolids and new-clamp volume error1.42e-7mm3.

Print preparation:11 Orca plates, including the selected four-hole D3L3 upright mini (10m33), a separate optional four-hole sideways strip (9m52), and three exact clipped seat samples. Older generic M2-A plan is superseded for this package. Existing other-workstream coupon files preserved. Full inherited user EnderNeo SAFE machine and the appropriate user PLA/silk filament settings independently compare exactly. Process bases:0.20mm Standard - FIrst Layer Comp and0.20mm Silk Toys @ First Print - SAFE. Bed selects High Temp Plate/60C; SAFE declares235mm, actual extrusion bounds independently constrained to220x220. No global presets edited. Silk220/215C, flow0.98, volumetric7.5mm3/s and filament retraction0.5mm retained. Layer heights/support/brims/detail speeds are explicit per-plate process changes. Existing SAFE start checker retained and passed all11slices plus13delivered printing files; the LCD-only diagnostic is a nonprinting exception.

Hood:normal(auto),snug,closing-radius0,45deg threshold; front panels:tree(auto),45deg. Local support blockers use full vertical columns because grid supports from higher overhangs otherwise pass through bores. New clamp meshes lie on broad sides, supports off. Red shield fields lie on flat backs; white curved emblems stand with brim/tree support; neck guard top down. Every source part is included; no lost-branch/slicer errors. Support finite-segment/cylinder tests with0.20mm bead allowance clear all seven body bores; six head bores are on a plate with no support extrusion.

Source placement bounds must come from actual meshing/vertices. FreeCAD cached BREP bounds can be very conservative after Booleans (hood native YMax90 vs actual78); using those cached centres misplaces support modifiers. The corrected native-mount-envelopes.json uses mesh extrema.

SD G-code has M0 two-stage LCD changes:click when present,reheat,then change/purge/wipe/reengage idler/click. ParkX10Y180,+5Z,restoreXYZ/E/feed/G90/M83. Axes held withM84S0 during pause,120s runtime idle restored after resume; noEEPROM. Original bytes outside pause blocks preserved. Independent interpreter confirms saved coordinate/feed/mode/temperature state restoration and all moves within220x220x250. Real firmware/LCD/manual-purge result still requires supplied no-heat/no-motion two-click diagnostic and first short tablet print. Three colour stops per shell; one on tablets. Stops keyed to model layers, not intermediate support layers.

Package:SD_PACKAGE/ (generated,ignored), ZIP Gladiator_Round5_SD_PRINT_PREP_20261022.zip, copy ~/3D-Printer/Incoming/Gladiator/Round5_SD_20261022/. Local delivery X:/Projects/Gladiator/print-release-round5-20261022/package/. PRINT_FIRST contains diagnostics,mini/optional sideways coupons,decorative parts/tablets/lens. HOLD_INSERTS contains fit seats,clamps and shells with .pending suffix; optional same-geometry single-colour shells for painting bands if attended swaps are impractical. Do not release long jobs before actual M2 OD/length and coupon/joint checks. Current3.6mm bore/4mm depth/assumed3mm inserts remain provisional and are NOT approved for nominalD3 hardware. Apply the actual winning bore before releasing production or fit-seat jobs. If hardware differs, revise a NEW production derivative and all affected native/STL/plates; do not overwrite the old source styling/v2.8.

Final total roughly25h printing; shells18h13m, excluding waiting at7colour stops,warmups,cooling,manual purge,support removal,assembly. Reserve6-8hhandling/assembly plus correction margin. All printing is started by Jim; no jobs queued/started and no printer settings written viaAPI. Read-only OctoPrint query confirmed220x220x250 and disconnected; SD route makes that connection irrelevant.

Rebuild order: prepare_fit_samples.py (FreeCAD), native_mount_envelopes.py (FreeCAD), build_print_variant.py (FreeCAD), build_sideways_coupon.py (FreeCAD), build_print_plates.py, add_support_blockers.py, slice_and_check.py, verify_print_release.py, make_sd_release.py, verify_sd_states.py. make_sd_release.py retains SAFE guard and adds colour hook to3MF process for05/07/08; those script paths are Linux/cad-lab. Use provided G-code on SD from Windows. Slice CLI rejects post_process: work copies strip hooks, then original guard is executed independently on results. Generated raw slices/comparisons/ZIP/package are ignored; source/reports/plates/CAD/previews are durable.

Final package budget: 24h 28m including optional sideways test. Mini geometry is read from cad/coupons/m2-d3-l3-mini-20261022/ without changing that workstream. Both mini tests are sliced with full Jim SAFE/PLA presets. Fit-seat01 now held to avoid spending an hour printing unapproved3.6mm retention samples.
