iThinkiKhan/gladiator-cad/cad/build2-20260927/rail-v2-vs-first-build.png

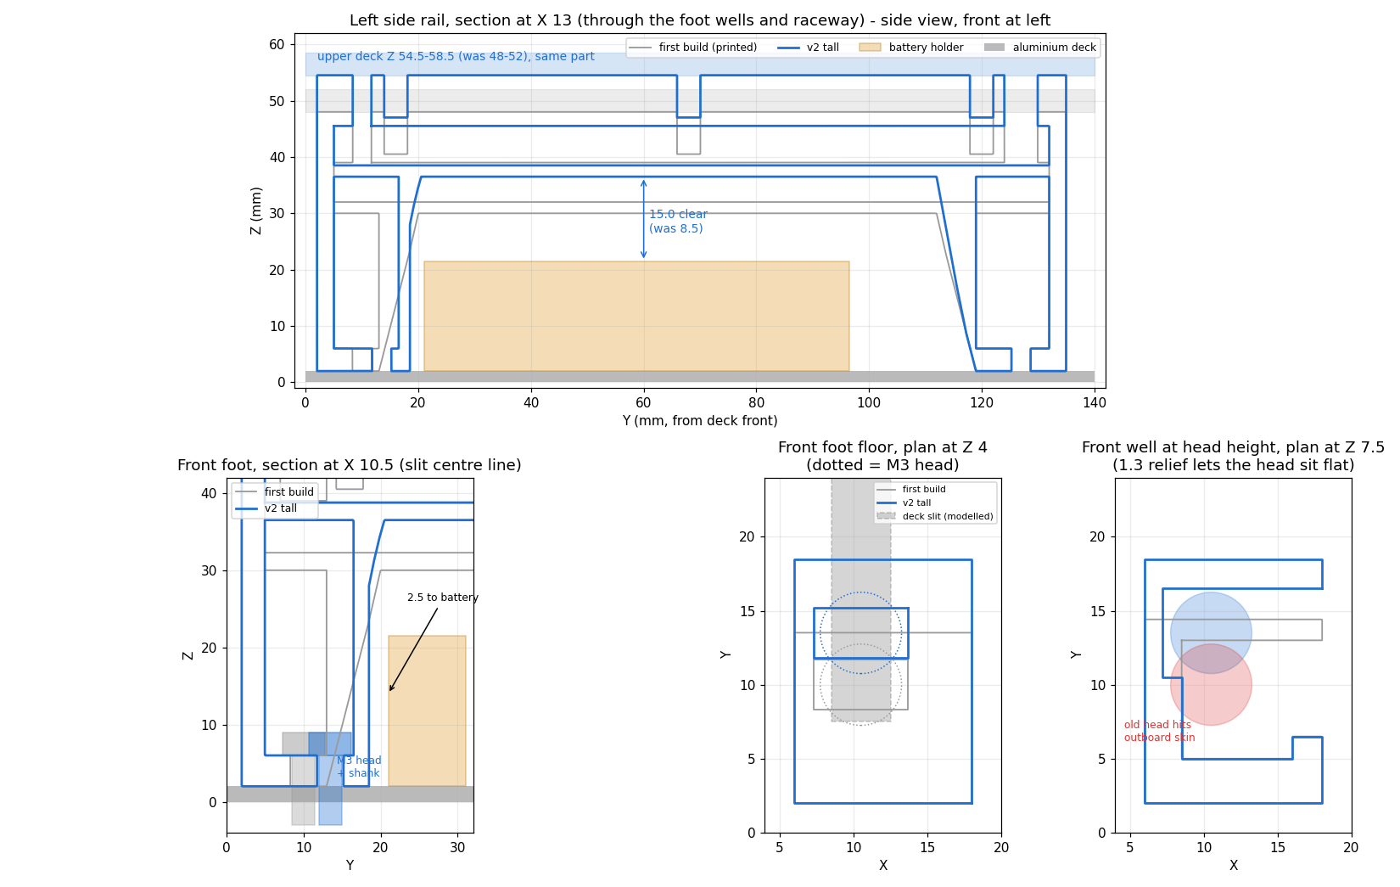
cad/build2-20260927/rail-v2-vs-first-build.png
