iThinkiKhan/gladiator-cad/cad/enclosure/concept-20261013/assembled.png

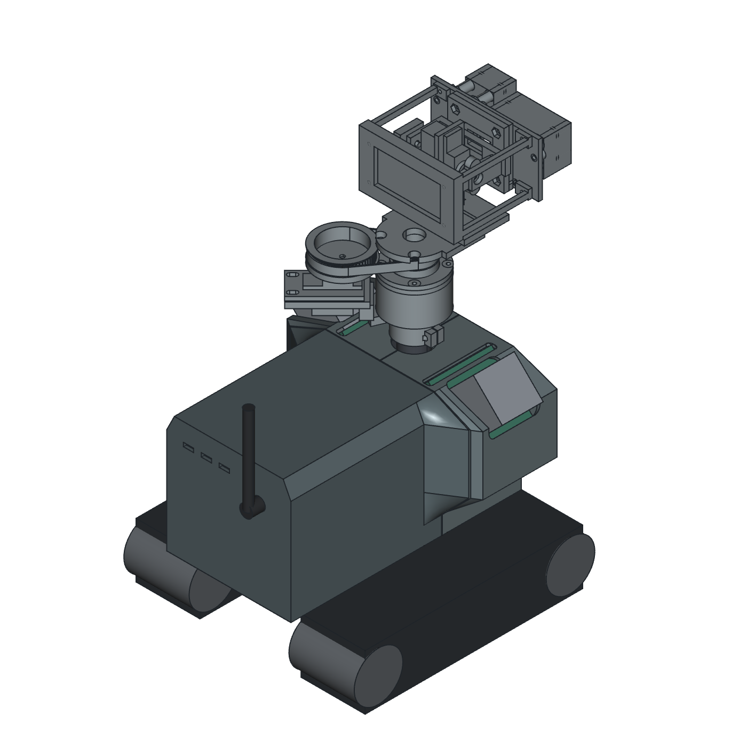
cad/enclosure/concept-20261013/assembled.png
