iThinkiKhan/gladiator-cad/cad/v2/enclosure/round5-calibrated-28-20261022/print/previews/08-toolpaths.png

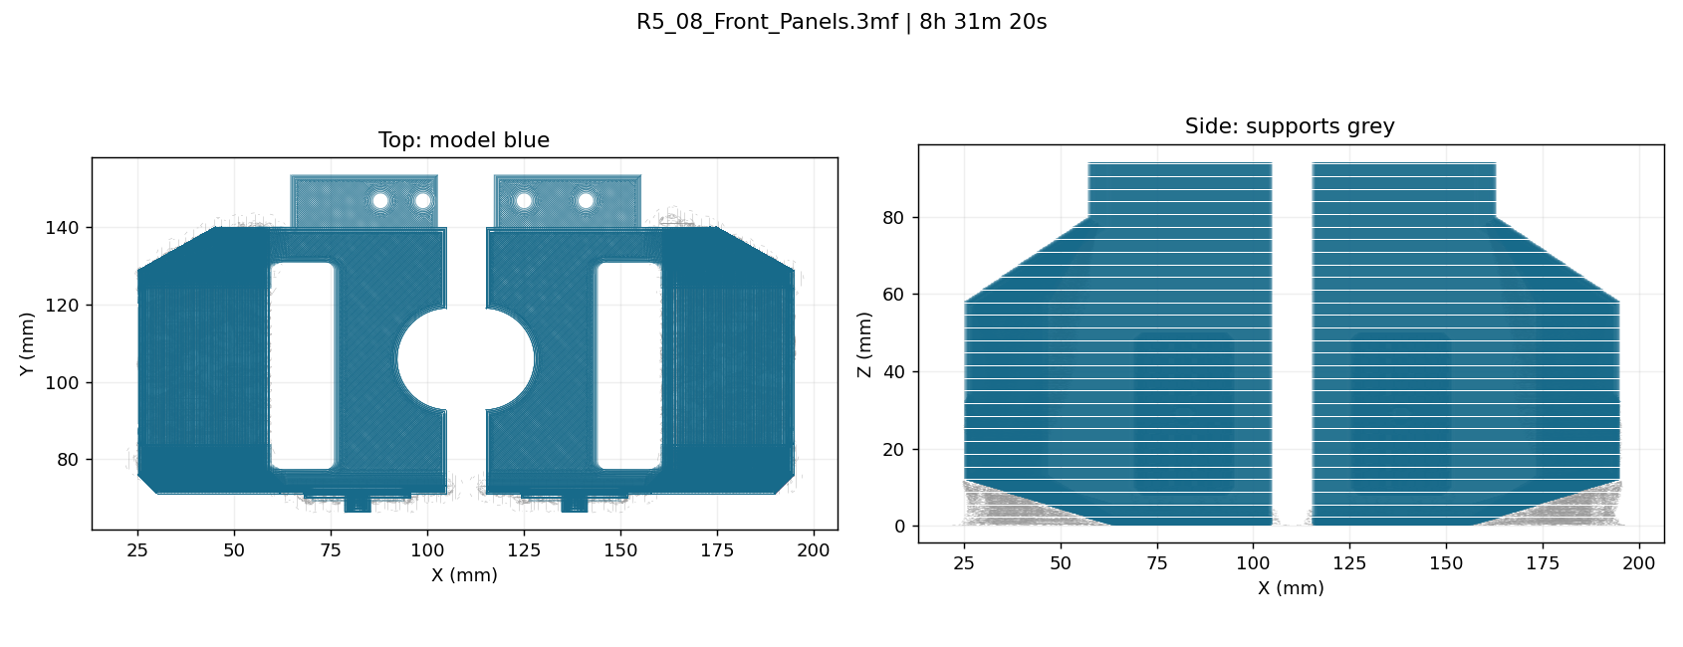
cad/v2/enclosure/round5-calibrated-28-20261022/print/previews/08-toolpaths.png
