iThinkiKhan/gladiator-cad/cad/v2/enclosure/round5-calibrated-28-20261022/print/previews/crest-clamp-reinforced.png

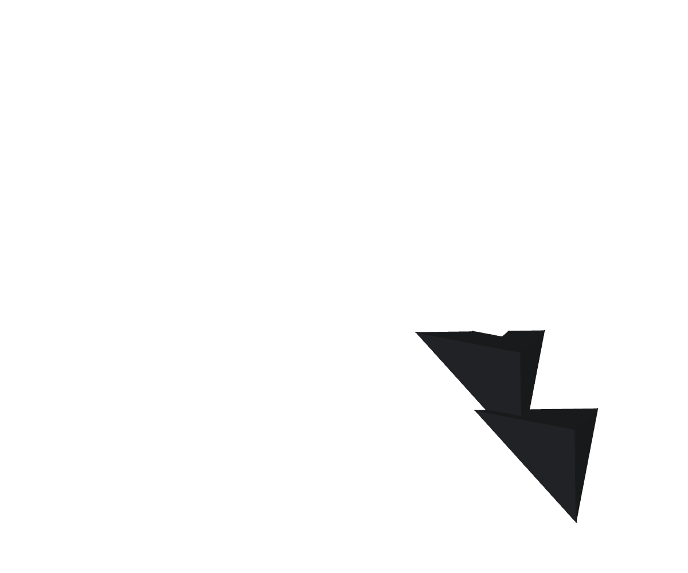
cad/v2/enclosure/round5-calibrated-28-20261022/print/previews/crest-clamp-reinforced.png
