iThinkiKhan/gladiator-cad/cad/v2/enclosure/round5-print-20261022/jim-settings-reslice/final_pictures/1_WHITE_SHIELD_EMBLEMS_on_cradle.png

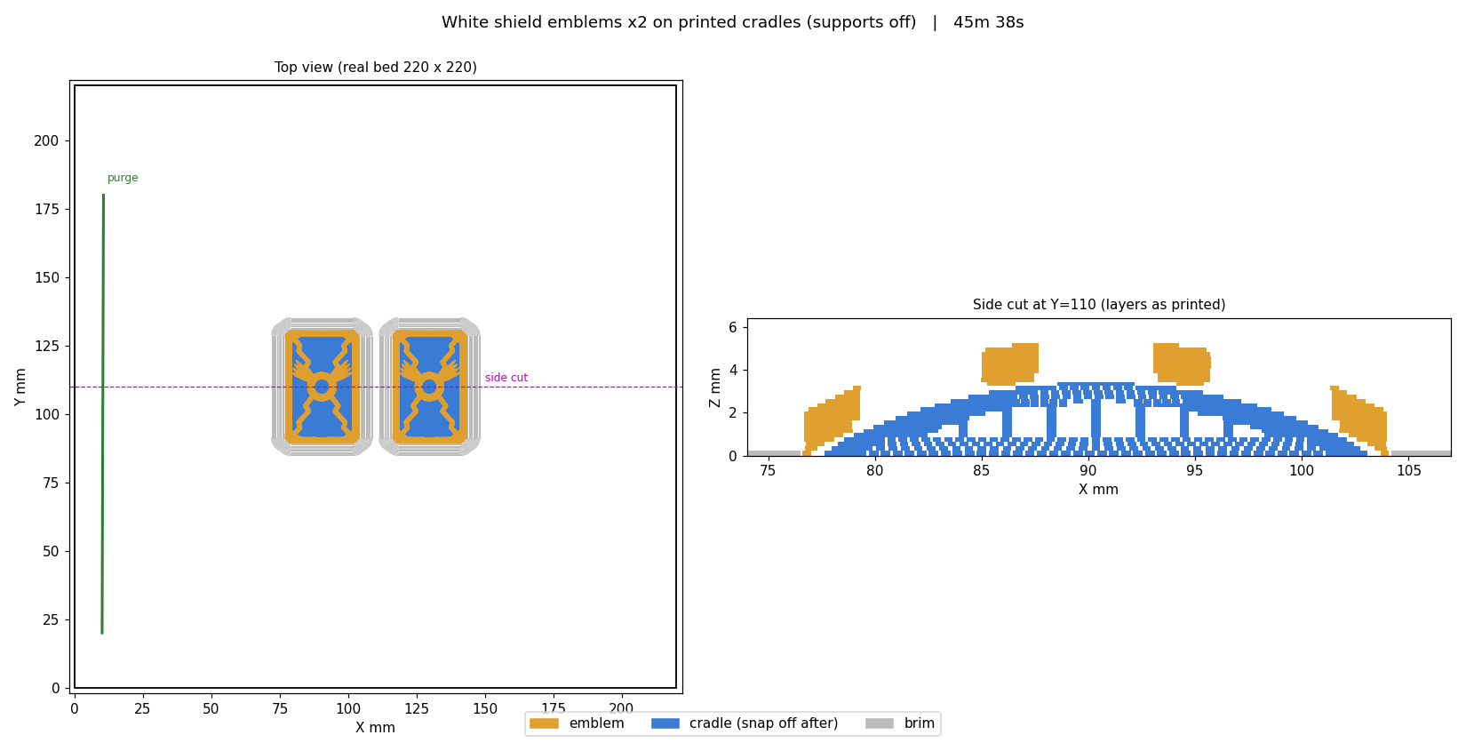
cad/v2/enclosure/round5-print-20261022/jim-settings-reslice/final_pictures/1_WHITE_SHIELD_EMBLEMS_on_cradle.png
