iThinkiKhan/gladiator-cad/cad/v2/enclosure/round5-print-20261022/jim-settings-reslice/final_pictures/2_SILK_aquila_bosses_trim_neckguard_BRIM.png

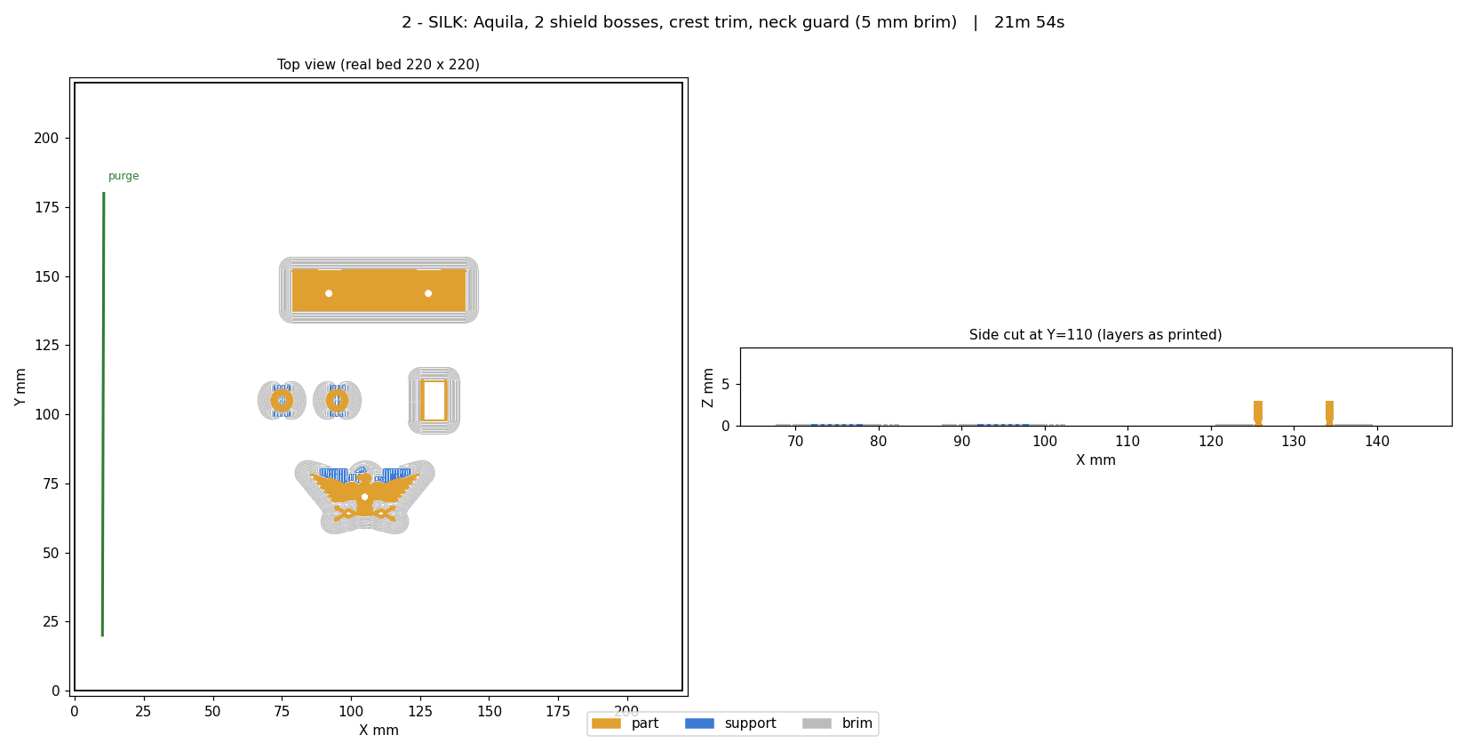
cad/v2/enclosure/round5-print-20261022/jim-settings-reslice/final_pictures/2_SILK_aquila_bosses_trim_neckguard_BRIM.png
