iThinkiKhan/gladiator-cad/cad/v2/enclosure/round5-print-20261022/jim-settings-reslice/final_pictures/3_BLACK_crest_and_neck_clamps.png

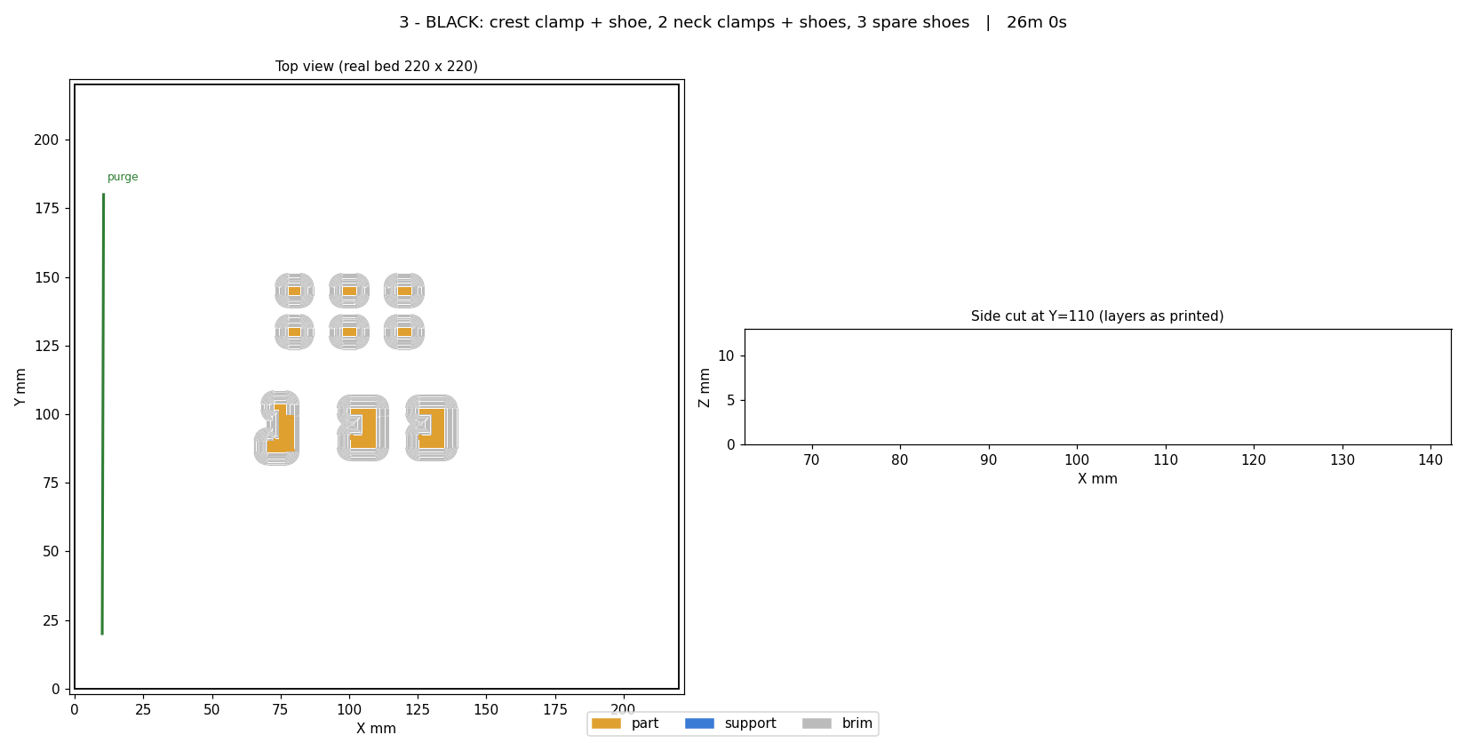
cad/v2/enclosure/round5-print-20261022/jim-settings-reslice/final_pictures/3_BLACK_crest_and_neck_clamps.png
