iThinkiKhan/gladiator-cad/cad/v2/enclosure/round5-print-20261022/jim-settings-reslice/final_pictures/5_FRONT_PANELS_028_start_RED_3x_M600.png

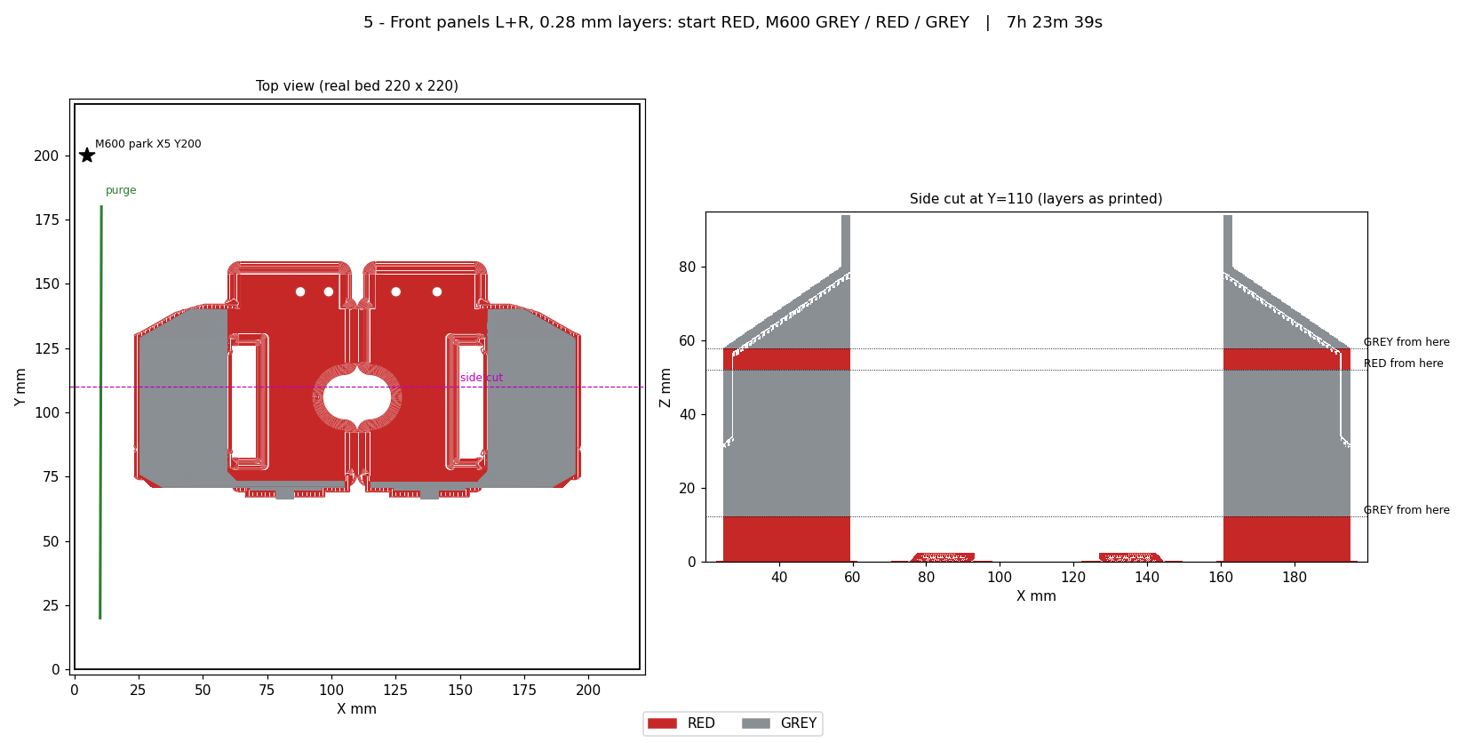
cad/v2/enclosure/round5-print-20261022/jim-settings-reslice/final_pictures/5_FRONT_PANELS_028_start_RED_3x_M600.png
