iThinkiKhan/gladiator-cad/cad/v2/enclosure/round5-print-20261022/previews/06-toolpaths.png

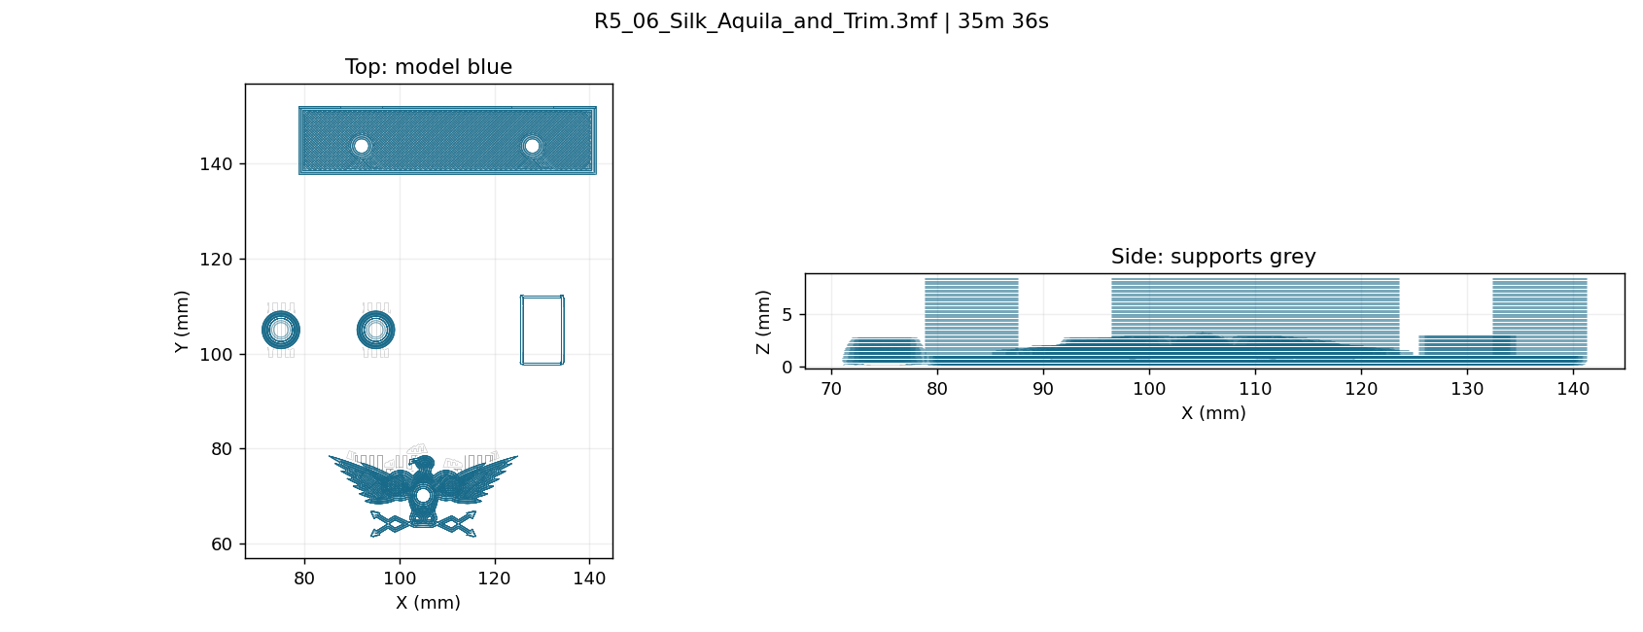
cad/v2/enclosure/round5-print-20261022/previews/06-toolpaths.png
