iThinkiKhan/gladiator-cad/cad/v2/enclosure/round5-print-20261022/previews/crest-clamp-reinforced.png

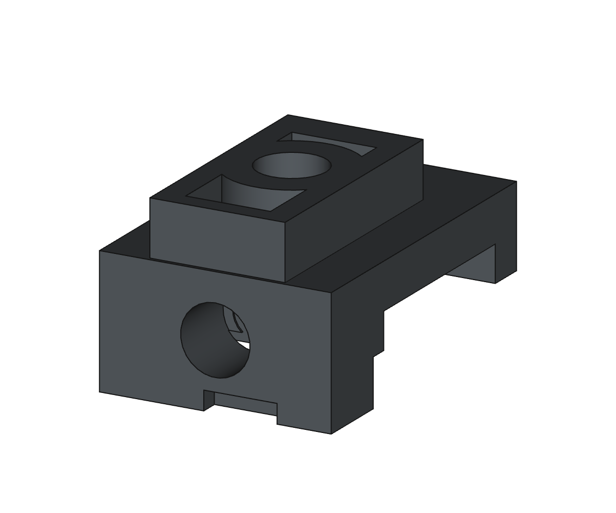
cad/v2/enclosure/round5-print-20261022/previews/crest-clamp-reinforced.png
