iThinkiKhan/gladiator-cad/cad/v2/print-plates/support-map-ALL.png

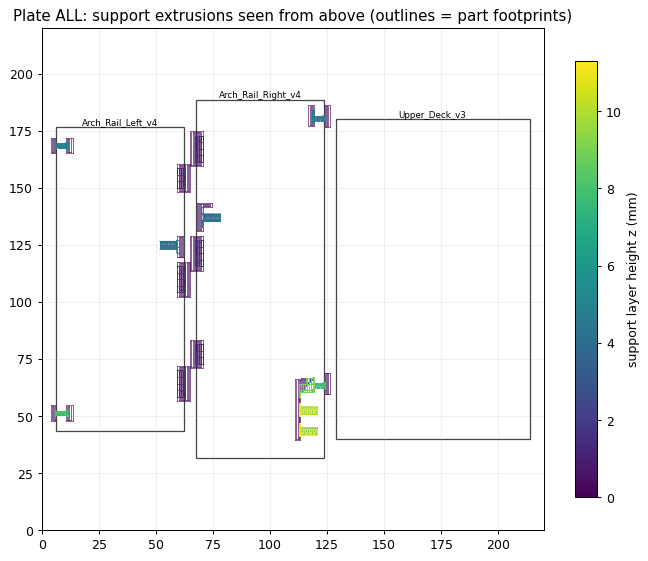
cad/v2/print-plates/support-map-ALL.png
