iThinkiKhan/gladiator-cad/cad/v2/print-plates/support-map-CM2.png

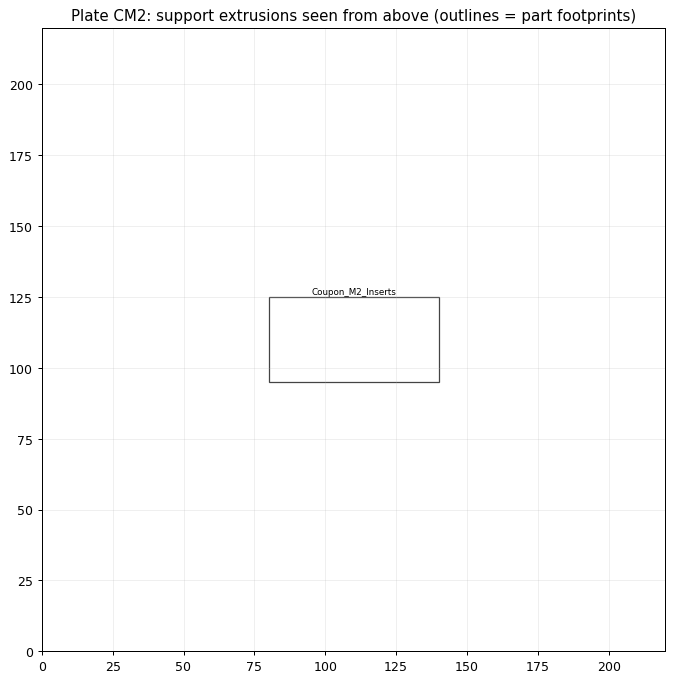
cad/v2/print-plates/support-map-CM2.png
