iThinkiKhan/gladiator-cad/cad/v2/print-plates/support-map-D.png

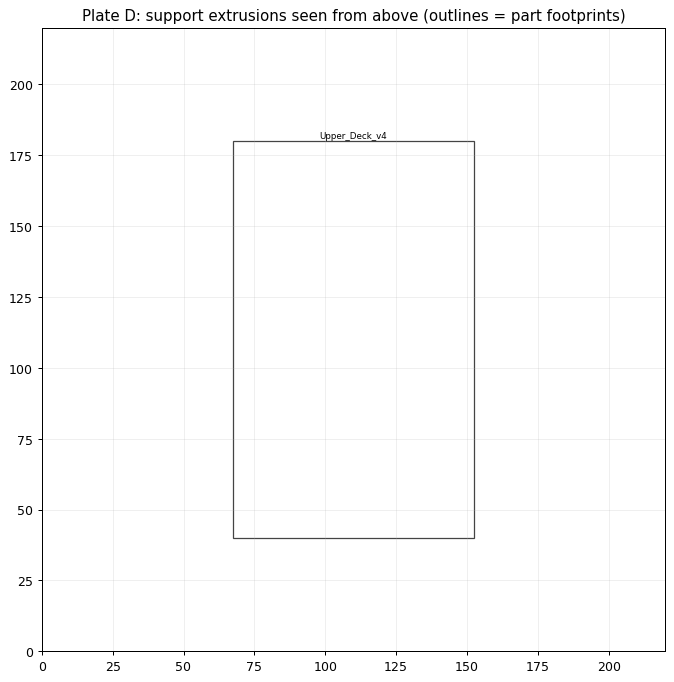
cad/v2/print-plates/support-map-D.png
