iThinkiKhan/gladiator-cad/cad/v2/print-plates/support-map-IM.png

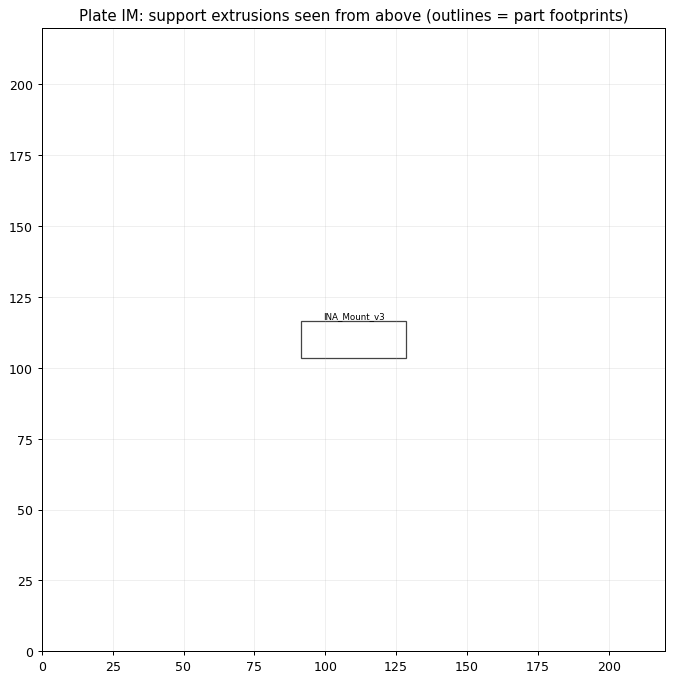
cad/v2/print-plates/support-map-IM.png
