iThinkiKhan/gladiator-cad/cad/v2/print-plates/support-map-R.png

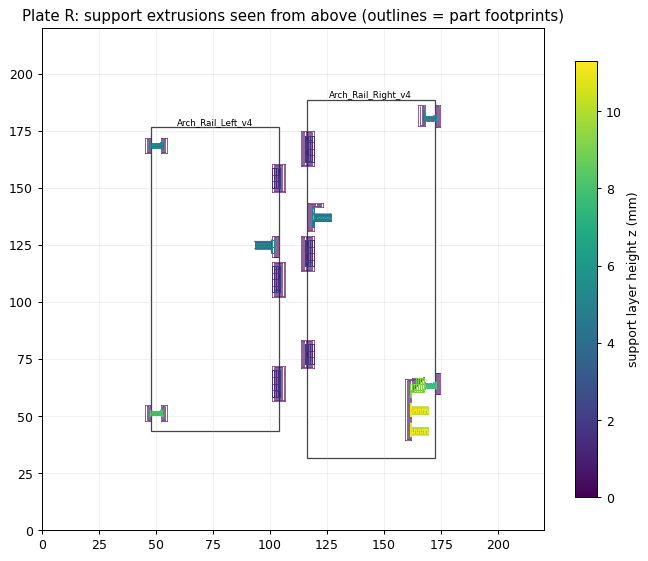
cad/v2/print-plates/support-map-R.png
