iThinkiKhan/gladiator-cad/cad/v2/enclosure/round5-calibrated-28-20261022/shell-time-optimized/START_HERE.md

# Shell time reduction - combined front panels retained

Current combined front panels: 7h 00m 34s (was 8h31m20s). Hood unchanged at9h43m33s. Total16h44m07s; saving1h30m46s. Times exclude warm-up, waiting at pauses, purging and handling.

Only the panel support layout changes: snug normal supports, base spacing3.5mm instead of2.5. Dense contact interfaces, gaps, support speed, all model geometry and printed shell extrusion centerlines/material remain unchanged. Four walls,30% crosshatch infill,0.28mm layers,four top/bottom layers,calibrated2.8mm bores,Neo SAFE and original PLA/material/machine settings retained. No physical strength test newly claimed.

The hood stays at its original settings. Other benchmark variants are recorded but not released. Individual split-panel files are optional; the main queue uses both panels together.

Both shell jobs start RED, then SD pauses for GREY, RED, GREY. Two clicks per change: acknowledge/reheat, then swap and hand-purge/wipe/reengage idler/resume. Keep head and bed still. No LCD test required.

GLAD_04_HOOD_SD_M2_28.gcode
  GREY at about 2h56m; colour boundary 12.01mm
  RED at about 7h04m; colour boundary 55.97mm
  GREY at about 7h25m; colour boundary 61.85mm
GLAD_05_PANELS_SD_M2_28.gcode
  GREY at about 2h09m; colour boundary 12.01mm
  RED at about 4h42m; colour boundary 52.05mm
  GREY at about 5h04m; colour boundary 57.93mm
