iThinkiKhan/gladiator-cad/cad/v2/enclosure/round5-calibrated-28-20261022/mount-checked-release/DELIVERY/START_HERE.md

# Mount-checked shell release - 22 October 2026

Use the hood file in this release; earlier hood files are superseded. Both front panels remain together, unchanged at7h00m34s. Hood: 9h 39m 4s. Estimates exclude heating, pauses and handling.

Antenna:7mm through-hole in2mm flat mounting land;22mm clear flat zone. CAD nut/flange12mm and short20mm tool-envelope checks pass. X ribs reinforce the surrounding wall. Actual antenna hardware dimensions remain as recorded; no new physical fit claimed.

Speaker:two previously retained1.6mm pilots corrected to tested2.8mm M2 heat-set pockets,4mm usable depth with0.15mm lead-in. Install inserts flush; measured ears2.8mm use M2x6. Install speaker with hood OFF:breadboard blocks one assembled driver path.7mm pads and roof retained.

Rails:six mount positions verified against saved installed rail CAD. Local3.6mm clearance relief follows actual0.644degree splay, retaining round-hole calibration. Six M3x20 screws clear; M3x25 bottoms against blind rail bores. Head bearing and6mm driver access pass. Existing rail M3 insert bores remain unchanged. Front panels mount to the hood via four roof tabs, not directly to rails.

All22 checked hood fastener cylinders have zero support intersections, including0.20mm bead allowance. Machine, material and process settings are byte-identical to the previous hood project; only geometry corrections and local support exclusions changed.4walls,30%infill,0.28mm layers retained. New native and22-solid reopened STEP,manifold STL,SAFE start,220mm bounds and actual SD pause replays pass.

Both jobs start RED, then GREY, RED, GREY. Two clicks per change:acknowledge/reheat,then swap and hand-purge/wipe,reengage idler,resume. Keep head and bed still. No diagnostic test required.

GLAD_04_HOOD_SD_M2_28.gcode
  GREY at about 2h56m
  RED at about 7h04m
  GREY at about 7h24m
GLAD_05_PANELS_SD_M2_28.gcode
  GREY at about 2h09m
  RED at about 4h42m
  GREY at about 5h04m

Printed:tablets,red shields/crest,coupon. Remaining accessories:stronger white emblems v2,silk,black clamps. LED window open. No printer started.
