iThinkiKhan/gladiator-cad/cad/coupons/m2-d3-l3-mini-20261022/results.csv

orientation | CAD_bore_mm | insert_OD_mm | insert_length_mm | iron_C | flush | bulge_or_split | cold_spin | cold_pullout | notes
vertical | 2.80 |  |  |  |  |  |  |  | ACCEPTED 2026-10-22: Jim reports 2.8 is the right size for M2 heat sets.
vertical | 2.90
vertical | 3.00
vertical | 3.10
