iThinkiKhan/gladiator-cad/cad/coupons/m2-d3-l3-20261022/results.csv

orientation | CAD_bore_mm | insert_OD_mm | insert_length_mm | iron_C | flush | bulge_or_split | cold_spin | cold_pullout | notes
vertical | 2.60
vertical | 2.70
vertical | 2.80
vertical | 2.90
vertical | 3.00
vertical | 3.10
vertical | 3.20
vertical | 3.30
horizontal | 2.60
horizontal | 2.70
horizontal | 2.80
horizontal | 2.90
horizontal | 3.00
horizontal | 3.10
horizontal | 3.20
horizontal | 3.30
