iThinkiKhan/gladiator-cad/cad/v2/enclosure/round5-calibrated-28-20261022/SD_PACKAGE/previews/04-toolpaths.png

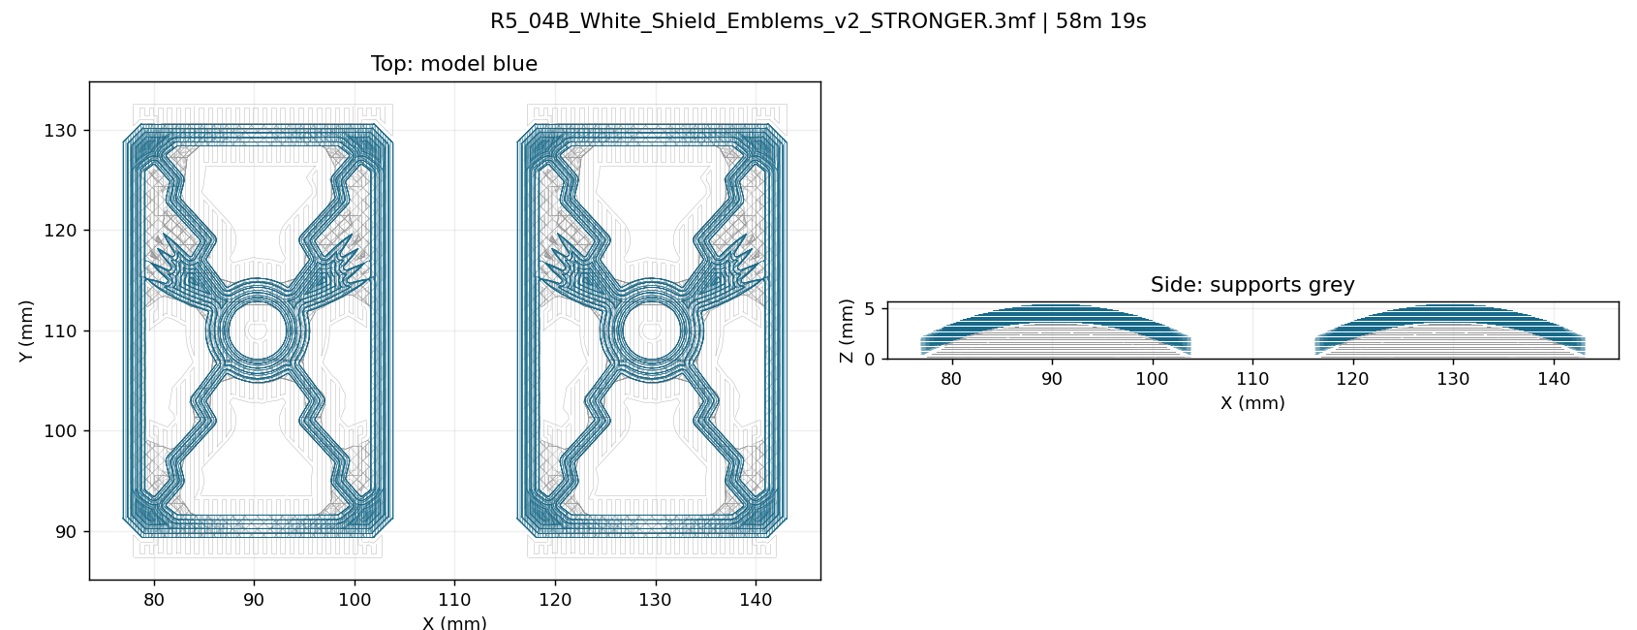
cad/v2/enclosure/round5-calibrated-28-20261022/SD_PACKAGE/previews/04-toolpaths.png
