iThinkiKhan/gladiator-cad/measurements/photos/sg90-body-side-view_20261001.jpg

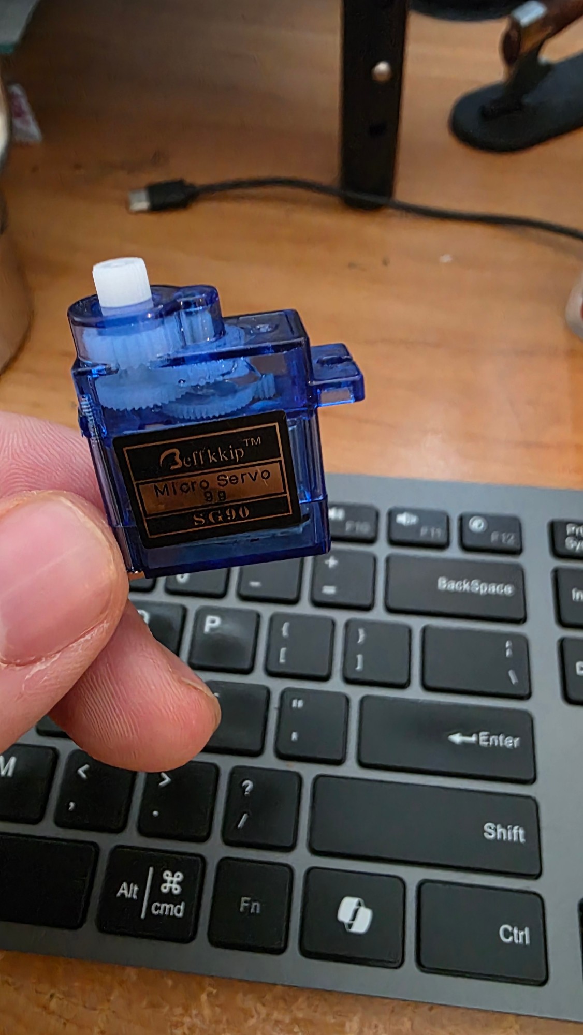
measurements/photos/sg90-body-side-view_20261001.jpg
