iThinkiKhan/gladiator-cad/measurements/photos/sg90-cross-horn-with-rule_20261001.jpg

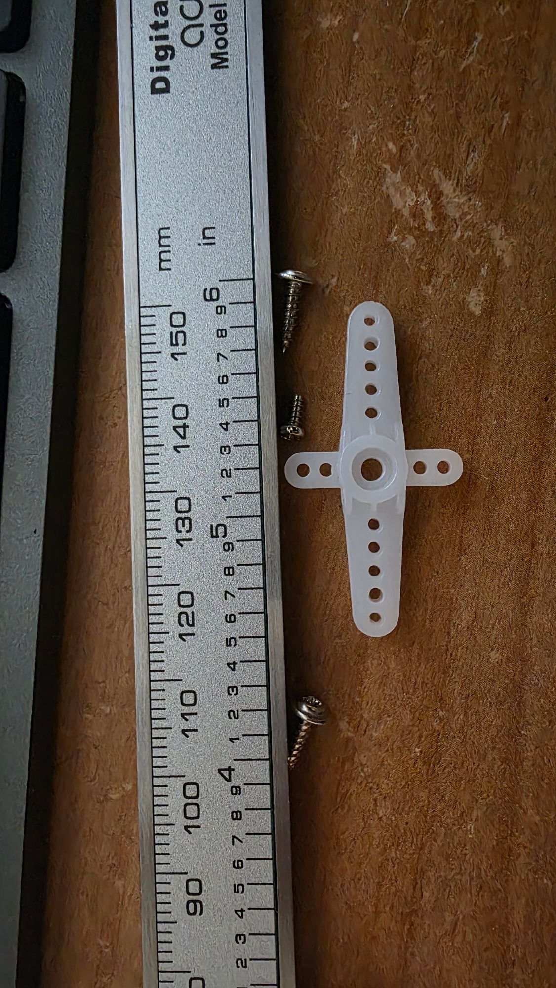
measurements/photos/sg90-cross-horn-with-rule_20261001.jpg
