iThinkiKhan/gladiator-cad/firmware/src/main.cpp

#include <Arduino.h>
#include <ArduinoJson.h>
#include <ArduinoOTA.h>
#include <BLE2902.h>
#include <BLEDevice.h>
#include <BLEServer.h>
#include <Update.h>
#include <WebServer.h>
#include <WiFi.h>
#include <rom/rtc.h>
#include <esp_ota_ops.h>
#include "BoardConfig.h"
#include "Orientation.h"
#include "sensors/SensorManager.h"
#include "status/StatusLed.h"
#include "gateway/RobotLink.h"
#include "gateway/ControlJson.h"
#include "../shared/FieldPage.h"
#include "../shared/ServicePage.h"

namespace {

// Robot-relative mast-front pin map. The LEFT driver's enables are tied on GPIO2.
constexpr uint8_t LEFT_R_EN_PIN = board::LEFT_R_EN;
constexpr uint8_t LEFT_RPWM_PIN = board::LEFT_RPWM;
constexpr uint8_t LEFT_L_EN_PIN = board::LEFT_L_EN;
constexpr uint8_t LEFT_LPWM_PIN = board::LEFT_LPWM;

constexpr uint8_t RIGHT_R_EN_PIN = board::RIGHT_R_EN;
constexpr uint8_t RIGHT_L_EN_PIN = board::RIGHT_L_EN;
constexpr uint8_t RIGHT_RPWM_PIN = board::RIGHT_RPWM;
constexpr uint8_t RIGHT_LPWM_PIN = board::RIGHT_LPWM;

constexpr uint8_t LEFT_RPWM_CHANNEL = 0;
constexpr uint8_t LEFT_LPWM_CHANNEL = 1;
constexpr uint8_t RIGHT_RPWM_CHANNEL = 2;
constexpr uint8_t RIGHT_LPWM_CHANNEL = 3;

constexpr uint32_t PWM_FREQUENCY_HZ = 18000;
constexpr uint8_t PWM_RESOLUTION_BITS = 8;
constexpr uint16_t PWM_MAX_DUTY = (1U << PWM_RESOLUTION_BITS) - 1U;

// Both tracks reverse relative to the former mast-rear frame. Together with
// the L/R swap above this preserves robot-relative turn directions.
constexpr bool LEFT_MOTOR_INVERTED = orientation::MOTOR_INVERTED;
constexpr bool RIGHT_MOTOR_INVERTED = orientation::MOTOR_INVERTED;

constexpr uint32_t COMMAND_TIMEOUT_MS = 350;
constexpr uint32_t STATUS_INTERVAL_MS = 250;
constexpr uint32_t RAMP_INTERVAL_MS = 20;
constexpr int8_t RAMP_STEP_PERCENT = 5;
constexpr uint32_t POWER_LOG_INTERVAL_MS = 1000;
// Historical carpet calibration (2026-09-08, mast-rear frame): forward
// favored old right by 22% (39/61 at 50%), reverse by 14% (43/57).
// Orientation.h preserves these physical corrections after the frame flip:
// new forward L/R=57/43; new reverse=-61/-39. Equal commands only; no trim
// for turns or Overdrive. Other speeds/surfaces still need physical validation.

constexpr uint8_t FRAME_MAGIC_COMMAND = 0x47; // 'G'
constexpr uint8_t FRAME_MAGIC_STATUS = 0x53;  // 'S'
constexpr uint8_t PROTOCOL_VERSION = 1;
constexpr size_t FRAME_SIZE = 8;
constexpr uint8_t CHECKSUM_SEED = 0xA5;
constexpr uint8_t POWER_FRAME_MAGIC = 0x50; // 'P'
constexpr size_t POWER_FRAME_SIZE = 20;

constexpr uint8_t FLAG_ARMED = 0x01;
constexpr uint8_t FLAG_DEADMAN = 0x02;
constexpr uint8_t FLAG_OVERDRIVE = 0x04;

constexpr char DEVICE_NAME[] = "Gladiator";
constexpr char SERVICE_UUID[] = "2b7e0001-8c8f-4f6c-b8f8-47a117d1e001";
constexpr char COMMAND_UUID[] = "2b7e0002-8c8f-4f6c-b8f8-47a117d1e001";
constexpr char STATUS_UUID[] = "2b7e0003-8c8f-4f6c-b8f8-47a117d1e001";
constexpr char POWER_UUID[] = "2b7e0004-8c8f-4f6c-b8f8-47a117d1e001";

constexpr char MAINTENANCE_AP_NAME[] = "Gladiator-Setup";
constexpr char MAINTENANCE_AP_PASSWORD[] = GLADIATOR_MAINTENANCE_AP_PASSWORD;
constexpr char OTA_PASSWORD[] = GLADIATOR_OTA_PASSWORD;
constexpr size_t WEB_LOG_MAX_CHARS = 12000;

struct Motor {
  uint8_t enablePinA;
  uint8_t enablePinB;
  bool separateEnablePins;
  uint8_t forwardPwmPin;
  uint8_t reversePwmPin;
  uint8_t forwardPwmChannel;
  uint8_t reversePwmChannel;
  bool inverted;
  int8_t currentPercent;
};

enum class ControlSource : uint8_t { NONE, BLE, WEB, LINK, FIELD };
const char *controlSourceName(ControlSource source){
  switch(source){case ControlSource::BLE:return "BLE";case ControlSource::WEB:return "WEB";
    case ControlSource::LINK:return "LINK";case ControlSource::FIELD:return "FIELD";default:return "NONE";}
}

Motor leftMotor = {
    LEFT_R_EN_PIN,
    LEFT_L_EN_PIN,
    board::LEFT_SEPARATE_ENABLES,
    LEFT_RPWM_PIN,
    LEFT_LPWM_PIN,
    LEFT_RPWM_CHANNEL,
    LEFT_LPWM_CHANNEL,
    LEFT_MOTOR_INVERTED,
    0,
};

Motor rightMotor = {
    RIGHT_R_EN_PIN,
    RIGHT_L_EN_PIN,
    board::RIGHT_SEPARATE_ENABLES,
    RIGHT_RPWM_PIN,
    RIGHT_LPWM_PIN,
    RIGHT_RPWM_CHANNEL,
    RIGHT_LPWM_CHANNEL,
    RIGHT_MOTOR_INVERTED,
    0,
};

BLEServer *bleServer = nullptr;
BLECharacteristic *statusCharacteristic = nullptr;
BLECharacteristic *powerCharacteristic = nullptr;
WebServer maintenanceServer(80);
String webLog;

volatile bool bleConnected = false;
volatile bool commandArmed = false;
volatile bool commandDeadman = false;
volatile bool commandOverdrive = false;
volatile bool watchdogStopped = false;
volatile bool overdrivePending = false;
volatile ControlSource activeControlSource = ControlSource::NONE;
volatile int8_t targetLeftPercent = 0;
volatile int8_t targetRightPercent = 0;
volatile uint8_t selectedPowerMode = 25;
volatile uint8_t lastSequence = 0;
volatile uint32_t lastCommandMs = 0;
SemaphoreHandle_t commandMutex=nullptr;
struct ControlGuard {
  ControlGuard(){if(commandMutex)xSemaphoreTakeRecursive(commandMutex,portMAX_DELAY);}
  ~ControlGuard(){if(commandMutex)xSemaphoreGiveRecursive(commandMutex);}
};

uint32_t lastRampMs = 0;
uint32_t lastStatusMs = 0;
sensors::SensorManager sensorManager;
sensors::RobotSensors sensorData;
gateway::RobotLink gatewayLink;
robotlink::Session remoteSession;
uint32_t linkGeneration=0;
std::atomic<bool> revokeRemote{false};
bool webMustRelease=false;
volatile bool bleMustRelease=false;
bool sensorTaskStarted = false;
uint32_t loopMaxUs = 0;
uint32_t lastPowerLogMs = 0;

// Reset diagnostics. RTC_NOINIT survives a reset but not a power cycle, so a
// climbing count on a battery that never left the chassis means the controller
// is restarting itself rather than being restarted by someone.
RTC_NOINIT_ATTR uint32_t rtcBootMagic;
RTC_NOINIT_ATTR uint32_t rtcBootCount;
constexpr uint32_t BOOT_MAGIC = 0x474C4144; // 'GLAD'
esp_reset_reason_t bootReason = ESP_RST_UNKNOWN;
uint32_t bootRawReason = 0;
uint32_t bootCount = 0;

// OTA slot identity and confirmation state. With rollback enabled, an app that
// is still PENDING_VERIFY makes esp_ota_set_boot_partition refuse the next
// image, which surfaces only as a generic activation failure at the far end of
// a completed upload. Record it so the cause is visible without a cable.
char otaPartition[8] = "?";
const char *otaStateName = "UNKNOWN";
bool otaMarkedValid = false;

status::StatusLed statusLed;
bool maintenanceApActive = false;
uint8_t apStationCount = 0;
uint32_t lastApPollMs = 0;

using BatteryState = interfacev1::Battery;
const char *batteryStateName(BatteryState state);
void coastAll();
BatteryState batteryState = BatteryState::UNKNOWN;
bool batteryLockout = false;
bool batteryRadiosShed = false;
uint32_t batteryAboveLockoutMs = 0, batteryBelowReleaseMs = 0, batteryAboveCriticalMs = 0;
bool benchPowerActive = false;
bool benchPowerCandidate = false;
bool benchPowerViaPin = false;
bool benchPowerViaUsb = false;
uint32_t benchPowerCandidateSinceMs = 0;

bool batteryInhibitsMotion() {
  return !benchPowerActive && (batteryLockout || batteryRadiosShed);
}

const char *benchPowerSourceName() {
  if (benchPowerViaPin && benchPowerViaUsb) return "GPIO7+USB";
  if (benchPowerViaPin) return "GPIO7";
  if (benchPowerViaUsb) return "USB_LOW_VOLTAGE";
  return "NONE";
}

bool ina226Present = false;
bool ina226SampleValid = false;
uint8_t ina226Address = 0;
uint8_t ina226SampleSequence = 0;
uint16_t busMillivolts = 0;
int32_t currentMilliamps = 0;
int32_t powerMilliwatts = 0;
uint16_t minimumBusMillivolts = UINT16_MAX;
uint16_t peakCurrentMilliamps = 0;

void appendLog(const String &message) {
  ControlGuard guard;
  const String line = String('[') + millis() + "] " + message + '\n';
  Serial.print(line);
  webLog += line;
  if (webLog.length() > WEB_LOG_MAX_CHARS) {
    const int newline = webLog.indexOf('\n', webLog.length() - WEB_LOG_MAX_CHARS);
    webLog.remove(0, newline >= 0 ? newline + 1
                                 : webLog.length() - WEB_LOG_MAX_CHARS);
  }
}

void appendLogf(const char *format, ...) {
  char message[224];
  va_list args;
  va_start(args, format);
  vsnprintf(message, sizeof(message), format, args);
  va_end(args);
  appendLog(message);
}

uint8_t checksum(const uint8_t *bytes, size_t count) {
  uint8_t value = CHECKSUM_SEED;
  for (size_t i = 0; i < count; ++i) {
    value ^= bytes[i];
  }
  return value;
}

void writeLe16(uint8_t *bytes, size_t offset, uint16_t value) {
  bytes[offset] = static_cast<uint8_t>(value & 0xFF);
  bytes[offset + 1] = static_cast<uint8_t>((value >> 8) & 0xFF);
}

void writeLe32(uint8_t *bytes, size_t offset, int32_t value) {
  const uint32_t bits = static_cast<uint32_t>(value);
  bytes[offset] = static_cast<uint8_t>(bits & 0xFF);
  bytes[offset + 1] = static_cast<uint8_t>((bits >> 8) & 0xFF);
  bytes[offset + 2] = static_cast<uint8_t>((bits >> 16) & 0xFF);
  bytes[offset + 3] = static_cast<uint8_t>((bits >> 24) & 0xFF);
}

// Compatibility projection for the existing BLE/phone protocol. Native data
// remains in sensorData; rounding is confined to the legacy wire format.
void updateSensors() {
  sensorManager.snapshot(sensorData);
  const auto &p = sensorData.power;
  ina226Present = p.meta.online;
  ina226SampleValid = p.meta.hasSample && p.meta.health == sensors::SensorHealth::OK;
  ina226Address = p.meta.address;
  ina226SampleSequence = static_cast<uint8_t>(p.meta.updateCount);
  busMillivolts = static_cast<uint16_t>(constrain(lroundf(p.derived.busVolts * 1000), 0L, long(UINT16_MAX)));
  currentMilliamps = lroundf(p.derived.currentAmps * 1000);
  powerMilliwatts = lroundf(p.derived.watts * 1000);
  minimumBusMillivolts = p.derived.hasMinimum ? lroundf(p.derived.minimumVolts * 1000) : UINT16_MAX;
  peakCurrentMilliamps = static_cast<uint16_t>(constrain(lroundf(p.derived.peakAbsAmps * 1000), 0L, long(UINT16_MAX)));
}

String sensorStatusJson() {
  String json = sensors::sensorJson(sensorData);
  json.remove(json.length()-1);
  json += ",\"controller\":{\"state\":\"";
  json += commandArmed ? ((leftMotor.currentPercent || rightMotor.currentPercent) ? "DRIVE" : "ARMED") : "SAFE";
  json += "\",\"leftPercent\":" + String(leftMotor.currentPercent);
  json += ",\"rightPercent\":" + String(rightMotor.currentPercent);
  json += ",\"watchdogStopped\":" + String(watchdogStopped ? "true" : "false");
  json += ",\"sensorTaskStarted\":" + String(sensorTaskStarted ? "true" : "false");
  json += ",\"loopMaxUs\":" + String(loopMaxUs);
  json += ",\"led\":\"" + String(status::conditionName(statusLed.condition())) + "\"";
  json += ",\"apUp\":" + String(maintenanceApActive ? "true" : "false");
  json += ",\"apStations\":" + String(apStationCount);
  json += ",\"resetReason\":\"" + String(status::resetReasonName(bootReason)) + "\"";
  json += ",\"resetRaw\":" + String(bootRawReason);
  json += ",\"resetBlinkCode\":" + String(statusLed.code());
  json += ",\"bootCount\":" + String(bootCount);
  json += ",\"battery\":\"" + String(batteryStateName(batteryState)) + "\"";
  json += ",\"batteryLockout\":" + String(batteryLockout ? "true" : "false");
  json += ",\"benchPower\":" + String(benchPowerActive ? "true" : "false");
  json += ",\"benchPowerSource\":\"" + String(benchPowerSourceName()) + "\"}}";
  return json;
}

// USB commands are deliberately read-only. No command here can arm or move.
void updateSerialConsole() {
  static String command;
  for (uint8_t budget=0; budget<64 && Serial.available(); ++budget) {
    char c=Serial.read();
    if (c=='\r') continue;
    if (c=='\n') {
      command.trim();
      if (command == "sensors" || command == "status") {
        if (commandArmed) Serial.println("BUSY: disarm before USB snapshot.");
        else Serial.println(sensorStatusJson());
      } else if (command.length()) Serial.println("Read-only commands: sensors | status");
      command="";
    } else if (command.length()<64) command += c;
    else command="";
  }
}

void logIna226() {
  const uint32_t now = millis();
  if (now - lastPowerLogMs < POWER_LOG_INTERVAL_MS) {
    return;
  }
  lastPowerLogMs = now;
  appendLogf("Sensors | POWER_MAIN %s %.1f Hz | IMU_BODY %s %.1f reports/s | state=%s | outputs=%d,%d",
             sensors::healthName(sensorData.power.meta.health), sensorData.power.meta.rateHz,
             sensors::healthName(sensorData.imu.meta.health), sensorData.imu.meta.rateHz,
             commandArmed ? "ARMED" : "SAFE", leftMotor.currentPercent, rightMotor.currentPercent);
  if (!ina226Present) {
    appendLog("INA226 not detected");
    return;
  }
  if (!ina226SampleValid) {
    appendLog("Runtime healthy | INA226 sample unavailable");
    return;
  }
  appendLogf(
      "VBUS: %.3f V | CURRENT: %.3f A | POWER: %.2f W | MIN: %.3f V | PEAK: %.3f A",
      busMillivolts / 1000.0F,
      currentMilliamps / 1000.0F,
      powerMilliwatts / 1000.0F,
      minimumBusMillivolts == UINT16_MAX ? 0.0F
                                         : minimumBusMillivolts / 1000.0F,
      peakCurrentMilliamps / 1000.0F);
}

const char *batteryStateName(BatteryState state) { return interfacev1::name(state); }
interfacev1::State currentInterfaceState() {
  return interfacev1::controllerState(commandArmed,leftMotor.currentPercent,rightMotor.currentPercent);
}

void updateBenchPower(uint32_t now) {
  benchPowerViaPin = digitalRead(board::BENCH_POWER_DETECT_PIN) ==
                     (board::BENCH_POWER_DETECT_ACTIVE_LOW ? LOW : HIGH);
  const float volts = sensorData.power.derived.busVolts;
  benchPowerViaUsb = Serial.isPlugged() && ina226SampleValid &&
                     volts >= board::USB_BENCH_MIN_V &&
                     volts <= board::USB_BENCH_MAX_V;
  const bool asserted = benchPowerViaPin || benchPowerViaUsb;
  if (asserted != benchPowerCandidate) {
    benchPowerCandidate = asserted;
    benchPowerCandidateSinceMs = now;
    return;
  }
  if (asserted == benchPowerActive ||
      now - benchPowerCandidateSinceMs < board::BENCH_POWER_DEBOUNCE_MS) return;

  benchPowerActive = asserted;
  batteryAboveLockoutMs = batteryBelowReleaseMs = batteryAboveCriticalMs = now;
  if (benchPowerActive) {
    batteryLockout = false;
    batteryState = BatteryState::BENCH;
    appendLogf("Bench power detected via %s; LiPo voltage protection bypassed",
               benchPowerSourceName());
  } else {
    batteryState = BatteryState::UNKNOWN;
    appendLog("Bench power signal released; LiPo voltage protection active");
  }
}

// Pack protection. Motors are the only load this firmware can actually remove,
// and they are by far the largest: idle draw is under a watt, a 70% spin pulled
// 0.8 A. At CRITICAL the radios go too, since below 3 V/cell the pack is being
// damaged and the light is a better use of the remaining energy than an AP.
void updateBatteryGuard(uint32_t now) {
  if (benchPowerActive) {
    batteryAboveLockoutMs = batteryBelowReleaseMs = batteryAboveCriticalMs = now;
    batteryLockout = false;
    batteryState = BatteryState::BENCH;
    return;
  }
  if (!ina226SampleValid) {
    // No trustworthy measurement: hold every timer at now so a missing monitor
    // cannot strand the robot. It also means the pack is unprotected meanwhile.
    batteryAboveLockoutMs = batteryBelowReleaseMs = batteryAboveCriticalMs = now;
    return;
  }
  const float volts = sensorData.power.derived.busVolts;
  const float perCell = volts / board::BATTERY_CELLS;
  if (volts > board::BATTERY_LOCKOUT_V) batteryAboveLockoutMs = now;
  if (volts < board::BATTERY_RELEASE_V) batteryBelowReleaseMs = now;
  if (volts > board::BATTERY_CRITICAL_V) batteryAboveCriticalMs = now;

  if (!batteryLockout && now - batteryAboveLockoutMs >= board::BATTERY_LOCKOUT_MS) {
    batteryLockout = true;
    appendLogf("Battery lockout: %.2f V (%.2f V/cell) held below %.2f V; motors disabled",
               volts, perCell, board::BATTERY_LOCKOUT_V);
  } else if (batteryLockout && now - batteryBelowReleaseMs >= board::BATTERY_RELEASE_MS) {
    batteryLockout = false;
    appendLogf("Battery recovered: %.2f V (%.2f V/cell); motors re-enabled", volts, perCell);
  }

  if (batteryLockout &&
      (commandArmed || commandDeadman || leftMotor.currentPercent || rightMotor.currentPercent)) {
    ControlGuard guard;
    // Applies regardless of which source is holding the command.
    remoteSession.invalidate();webMustRelease=true;bleMustRelease=true;
    activeControlSource = ControlSource::NONE;
    commandArmed = commandDeadman = commandOverdrive = false;
    watchdogStopped = true;
    coastAll();
  }

  if (!batteryRadiosShed && now - batteryAboveCriticalMs >= board::BATTERY_CRITICAL_MS) {
    batteryRadiosShed = true;
    appendLogf("Battery CRITICAL: %.2f V (%.2f V/cell). Shedding Wi-Fi and BLE. "
               "Charge the pack, then power cycle to restore them.", volts, perCell);
    delay(60); // let that line reach USB before the radios stop
    BLEDevice::deinit(true);
    bleConnected = false;
    maintenanceServer.stop();
    WiFi.softAPdisconnect(true);
    WiFi.mode(WIFI_OFF);
    maintenanceApActive = false;
    apStationCount = 0;
  }

  batteryState = batteryRadiosShed ? BatteryState::CRITICAL
                 : batteryLockout ? BatteryState::LOCKOUT
                 : volts < board::BATTERY_WARN_V ? BatteryState::WARN
                                                 : BatteryState::OK;
}

// The onboard light is the only status channel that survives having no cable,
// no phone and no Wi-Fi client. Priority order is documented in StatusLed.h.
void updateStatusLed(uint32_t now) {
  // Reading the station list is not free; the light does not need it at 500 Hz.
  if (now - lastApPollMs >= 500) {
    lastApPollMs = now;
    apStationCount = maintenanceApActive
                         ? static_cast<uint8_t>(WiFi.softAPgetStationNum())
                         : 0;
  }
  status::Inputs inputs;
  inputs.batteryLockout = batteryLockout;
  inputs.apUp = maintenanceApActive || gatewayLink.online();
  inputs.webClient = apStationCount > 0;
  inputs.bleConnected = bleConnected;
  inputs.armed = commandArmed;
  inputs.driving = leftMotor.currentPercent != 0 || rightMotor.currentPercent != 0;
  inputs.sensorFault = !sensorTaskStarted || !sensorData.busStarted ||
                       sensorData.power.meta.health == sensors::SensorHealth::OFFLINE;
  statusLed.update(inputs, now);
}

int dutyFromPercent(int percent) {
  percent = constrain(abs(percent), 0, 100);
  return map(percent, 0, 100, 0, PWM_MAX_DUTY);
}

void setMotorEnabled(const Motor &motor, bool enabled) {
  digitalWrite(motor.enablePinA, enabled ? HIGH : LOW);
  if (motor.separateEnablePins) {
    digitalWrite(motor.enablePinB, enabled ? HIGH : LOW);
  }
}

void applyMotor(Motor &motor, int8_t signedPercent) {
  signedPercent = constrain(signedPercent, -100, 100);
  if (motor.inverted) {
    signedPercent = -signedPercent;
  }

  if (signedPercent == 0) {
    ledcWrite(motor.forwardPwmChannel, 0);
    ledcWrite(motor.reversePwmChannel, 0);
    setMotorEnabled(motor, false);
    motor.currentPercent = 0;
    return;
  }

  const int duty = dutyFromPercent(signedPercent);
  setMotorEnabled(motor, true);
  if (signedPercent > 0) {
    ledcWrite(motor.reversePwmChannel, 0);
    ledcWrite(motor.forwardPwmChannel, duty);
  } else {
    ledcWrite(motor.forwardPwmChannel, 0);
    ledcWrite(motor.reversePwmChannel, duty);
  }

  // Store logical, not electrically inverted, direction for telemetry.
  motor.currentPercent = motor.inverted ? -signedPercent : signedPercent;
}

void coastAll() {
  targetLeftPercent = 0;
  targetRightPercent = 0;
  overdrivePending = false;
  applyMotor(leftMotor, 0);
  applyMotor(rightMotor, 0);
}



void forceSafeForUpdate() {
  ControlGuard guard;
  remoteSession.invalidate();
  activeControlSource = ControlSource::NONE;
  commandArmed = false;
  commandDeadman = false;
  commandOverdrive = false;
  watchdogStopped = true;
  coastAll();
}

robotlink::Result applyFieldControl(const robotlink::Control &c,bool viaLink) {
  ControlGuard guard;
  const ControlSource source=viaLink?ControlSource::LINK:ControlSource::FIELD;
  if(batteryInhibitsMotion()){remoteSession.invalidate();return robotlink::Result::INVALID;}
  const bool busy=activeControlSource!=source&&commandArmed&&commandDeadman&&(targetLeftPercent||targetRightPercent);
  auto result=remoteSession.validate(c,millis(),busy);
  if(result!=robotlink::Result::ACCEPTED){
    if(!remoteSession.armed&&activeControlSource==source)forceSafeForUpdate();
    return result;
  }
  activeControlSource=remoteSession.armed?source:ControlSource::NONE;
  commandArmed=remoteSession.armed;commandDeadman=c.operation==2&&c.deadman;
  commandOverdrive=c.overdrive;selectedPowerMode=c.overdrive?0xff:c.power;
  targetLeftPercent=c.left;targetRightPercent=c.right;lastCommandMs=millis();
  watchdogStopped=false;overdrivePending=commandOverdrive&&commandDeadman;
  if(!commandArmed||!commandDeadman)coastAll();
  return result;
}
void serviceFieldControl(uint32_t now){
  ControlGuard guard;
  if(remoteSession.armed&&activeControlSource!=ControlSource::LINK&&activeControlSource!=ControlSource::FIELD)remoteSession.invalidate();
  const uint32_t generation=gatewayLink.generation();
  const bool changed=generation!=linkGeneration;linkGeneration=generation;
  if(revokeRemote.exchange(false)||(changed&&(activeControlSource==ControlSource::LINK||!remoteSession.armed))){
    remoteSession.invalidate();
    if(activeControlSource==ControlSource::LINK){forceSafeForUpdate();appendLog("Gladiator Link changed; field session revoked");}
  }
  if(remoteSession.expire(now)&&(activeControlSource==ControlSource::LINK||activeControlSource==ControlSource::FIELD))forceSafeForUpdate();
  gateway::PendingControl pending;
  for(unsigned budget=0;budget<6&&gatewayLink.takeControl(pending);++budget){
    auto result=robotlink::Result::OFFLINE;
    if(gatewayLink.online()&&pending.generation==linkGeneration&&uint32_t(now-pending.receivedMs)<=150)
      result=applyFieldControl(pending.command,true);
    gatewayLink.result(pending.command,result,remoteSession.epoch);
  }
}
String fieldStateJson(){
  JsonDocument doc;doc["requiresKey"]=false;doc["connected"]=true;doc["interface"]="s3-recovery";
  auto c=doc["controller"].to<JsonObject>();c["s3Ms"]=millis();c["epoch"]=remoteSession.epoch;c["client"]=remoteSession.client;
  c["armed"]=commandArmed;c["deadman"]=commandDeadman;c["owner"]=uint8_t(activeControlSource);
  c["state"]=interfacev1::name(currentInterfaceState());
  c["battery"]=batteryStateName(batteryState);c["power"]=selectedPowerMode;
  c["leftPercent"]=leftMotor.currentPercent;c["rightPercent"]=rightMotor.currentPercent;
  c["watchdogStopped"]=watchdogStopped;c["batteryLockout"]=batteryLockout;
  c["benchPower"]=benchPowerActive;
  c["benchPowerSource"]=benchPowerSourceName();
  doc["volts"]=sensorData.power.derived.busVolts;doc["amps"]=sensorData.power.derived.currentAmps;
  doc["powerValid"]=ina226SampleValid;
  doc["transport"]="WIFI";doc["telemetryAgeMs"]=0;
  auto robot=doc["sensors"].to<JsonObject>();
  auto meta=[&](const char *key,const sensors::SensorMeta &m){
    auto o=robot[key]["meta"].to<JsonObject>();o["health"]=sensors::healthName(m.health);
    o["hasSample"]=m.hasSample;if(m.hasSample)o["ageMs"]=uint32_t(millis()-m.lastUpdateMs);else o["ageMs"]=nullptr;
  };
  meta("power",sensorData.power.meta);meta("imu",sensorData.imu.meta);
  meta("tofFront",sensorData.tofFront.meta);meta("presence",sensorData.presence.meta);
  robot["imu"]["derived"]["headingValid"]=sensors::headingValid(sensorData.imu,millis());
  robot["imu"]["derived"]["yawDeg"]=sensorData.imu.derived.yawDeg;
  robot["tofFront"]["derived"]["valid"]=sensorData.tofFront.derived.valid;
  robot["tofFront"]["derived"]["nearestMm"]=sensorData.tofFront.derived.nearestMm;
  robot["presence"]["derived"]["presenceValid"]=sensorData.presence.derived.presenceValid;
  robot["presence"]["derived"]["present"]=sensorData.presence.derived.present;
  String s;serializeJson(doc,s);return s;
}
// Radio policy stays on the S3. Recovery AP is independent of association to C6.
void updateLinkRadios(uint32_t now){
  static uint32_t checked=0,lastAttempt=0;static bool stationMode=false;
  if(batteryRadiosShed||now-checked<500)return;checked=now;
  const bool wanted=gatewayLink.needsWifi();
  if(wanted&&!stationMode&&now>robotlink::LOSS_MS){
    // BLE stays active during fallback; the S3 radio requires modem sleep.
    WiFi.setSleep(true);WiFi.mode(WIFI_AP_STA);
    if(!maintenanceApActive){maintenanceApActive=WiFi.softAP(MAINTENANCE_AP_NAME,MAINTENANCE_AP_PASSWORD);maintenanceServer.begin();ArduinoOTA.begin();}
    stationMode=true;lastAttempt=now;WiFi.begin(robotlink::FIELD_SSID,robotlink::FIELD_PASSWORD);
    appendLog("Gladiator Link: seeking C6 field network; S3 recovery AP available");
  }else if(wanted&&stationMode&&WiFi.status()!=WL_CONNECTED&&now-lastAttempt>=10000){lastAttempt=now;WiFi.begin(robotlink::FIELD_SSID,robotlink::FIELD_PASSWORD);}
  if(!wanted&&now>15000&&apStationCount==0&&activeControlSource!=ControlSource::WEB&&activeControlSource!=ControlSource::FIELD){
    if(maintenanceApActive||stationMode){maintenanceServer.stop();WiFi.disconnect();WiFi.softAPdisconnect(false);WiFi.mode(WIFI_OFF);maintenanceApActive=false;stationMode=false;appendLog("Stable UART: S3 Wi-Fi off; BLE service remains available");}
  }
}

void setupMaintenanceWifi() {
  WiFi.mode(WIFI_AP);
  WiFi.setSleep(true); // Keep STA fallback compatible with the BLE controller.
  if (!WiFi.softAP(MAINTENANCE_AP_NAME, MAINTENANCE_AP_PASSWORD)) {
    maintenanceApActive = false;
    appendLog("Maintenance Wi-Fi AP failed to start");
    return;
  }
  maintenanceApActive = true;

  maintenanceServer.on("/", HTTP_GET, []() {
    maintenanceServer.sendHeader("Location","/service");maintenanceServer.send(302,"text/plain","S3 recovery service");
  });
  maintenanceServer.on("/field", HTTP_GET, []() {maintenanceServer.send_P(200,"text/html",FIELD_PAGE);});
  maintenanceServer.on("/service", HTTP_GET, []() {
    maintenanceServer.send_P(200, "text/html", SERVICE_PAGE);
  });
  maintenanceServer.on("/api/field",HTTP_GET,[](){maintenanceServer.sendHeader("Cache-Control","no-store");maintenanceServer.send(200,"application/json",fieldStateJson());});
  maintenanceServer.on("/api/control",HTTP_POST,[](){
    JsonDocument doc;robotlink::Control c;
    if(maintenanceServer.arg("plain").length()>512||deserializeJson(doc,maintenanceServer.arg("plain"))||!robotlink::controlFromJson(doc,c)){
      maintenanceServer.send(400,"text/plain","Invalid field command");return;
    }
    auto r=applyFieldControl(c,false);JsonDocument reply;reply["result"]=uint8_t(r);reply["epoch"]=remoteSession.epoch;
    String text;serializeJson(reply,text);maintenanceServer.send(r==robotlink::Result::ACCEPTED?200:409,"application/json",text);
  });
  maintenanceServer.on("/api/sensors", HTTP_GET, []() {
    maintenanceServer.sendHeader("Cache-Control", "no-store");
    maintenanceServer.send(200, "application/json", sensorStatusJson());
  });
  maintenanceServer.on("/api/gateway", HTTP_GET, []() {
    maintenanceServer.sendHeader("Cache-Control", "no-store");
    maintenanceServer.send(200, "application/json", gatewayLink.statusJson());
  });
  maintenanceServer.on("/api/logs", HTTP_GET, []() {
    maintenanceServer.send(200, "text/plain", webLog);
  });
  maintenanceServer.on("/api/status", HTTP_GET, []() {
    String json;
    json.reserve(512);
    json = "{\"state\":\"" + String(interfacev1::name(currentInterfaceState())) + "\",\"armed\":";
    json += commandArmed ? "true" : "false";
    json += ",\"controlSource\":\"";
    json += controlSourceName(activeControlSource);
    json += '"';
    json += ",\"inaPresent\":";
    json += ina226Present ? "true" : "false";
    json += ",\"inaValid\":" + String(ina226SampleValid ? "true" : "false");
    json += ",\"inaAddress\":" + String(ina226Address);
    json += ",\"volts\":" + String(busMillivolts / 1000.0F, 3);
    json += ",\"amps\":" + String(currentMilliamps / 1000.0F, 3);
    json += ",\"watts\":" + String(powerMilliwatts / 1000.0F, 3);
    json += ",\"minimumVolts\":" +
            String(minimumBusMillivolts == UINT16_MAX
                       ? 0.0F
                       : minimumBusMillivolts / 1000.0F,
                   3);
    json += ",\"peakAmps\":" + String(peakCurrentMilliamps / 1000.0F, 3);
    json += ",\"led\":\"";
    json += status::conditionName(statusLed.condition());
    json += "\",\"apUp\":";
    json += maintenanceApActive ? "true" : "false";
    json += ",\"apStations\":" + String(apStationCount);
    json += ",\"resetReason\":\"";
    json += status::resetReasonName(bootReason);
    json += "\",\"resetRaw\":" + String(bootRawReason);
    json += ",\"bootCount\":" + String(bootCount);
    json += ",\"otaPartition\":\"" + String(otaPartition) + "\"";
    json += ",\"otaStateAtBoot\":\"" + String(otaStateName) + "\"";
    json += ",\"otaMarkedValid\":" + String(otaMarkedValid ? "true" : "false");
    json += ",\"battery\":\"" + String(batteryStateName(batteryState)) + "\"";
    json += ",\"batteryLockout\":" + String(batteryLockout ? "true" : "false");
    json += ",\"benchPower\":" + String(benchPowerActive ? "true" : "false");
    json += ",\"benchPowerSource\":\"" + String(benchPowerSourceName()) + "\"";
    json += ",\"powerSource\":\"" + String(benchPowerActive ? "BENCH" : "LIPO") + "\"";
    json += ",\"benchDetectPin\":" + String(board::BENCH_POWER_DETECT_PIN);
    json += ",\"batteryCells\":" + String(board::BATTERY_CELLS);
    json += ",\"voltsPerCell\":" + String(ina226SampleValid ? busMillivolts / 1000.0F / board::BATTERY_CELLS : 0.0F, 3);
    json += ",\"lockoutVolts\":" + String(board::BATTERY_LOCKOUT_V, 2);
    json += ",\"orientation\":\"" + String(orientation::NAME) + "\"";
    json += ",\"motorPins\":{\"left\":{\"rEn\":" + String(board::LEFT_R_EN);
    json += ",\"lEn\":" + String(board::LEFT_L_EN) + ",\"rPwm\":" + String(board::LEFT_RPWM);
    json += ",\"lPwm\":" + String(board::LEFT_LPWM) + ",\"inverted\":true}";
    json += ",\"right\":{\"rEn\":" + String(board::RIGHT_R_EN) + ",\"lEn\":" + String(board::RIGHT_L_EN);
    json += ",\"rPwm\":" + String(board::RIGHT_RPWM) + ",\"lPwm\":" + String(board::RIGHT_LPWM);
    json += ",\"inverted\":true}}";
    json += '}';
    maintenanceServer.send(200, "application/json", json);
  });
  maintenanceServer.on("/api/drive", HTTP_POST, []() {
    ControlGuard guard;
    if (batteryInhibitsMotion()) {
      coastAll();
      maintenanceServer.send(503, "text/plain",
                             "Battery lockout: pack too low, motors disabled");
      return;
    }
    if (activeControlSource != ControlSource::WEB && activeControlSource != ControlSource::NONE && commandArmed &&
        commandDeadman &&
        (targetLeftPercent != 0 || targetRightPercent != 0)) {
      maintenanceServer.send(409, "text/plain",
                             "BLE controller is actively driving");
      return;
    }

    const int left = maintenanceServer.arg("left").toInt();
    const int right = maintenanceServer.arg("right").toInt();
    const int requestedPower = maintenanceServer.arg("power").toInt();
    const bool armed = maintenanceServer.arg("armed") == "1";
    const bool deadman = maintenanceServer.arg("deadman") == "1";
    const bool overdrive = maintenanceServer.arg("overdrive") == "1";
    if(!armed)webMustRelease=false;
    if(webMustRelease&&armed){maintenanceServer.send(409,"text/plain","Release and arm again after timeout");return;}
    if (left < -100 || left > 100 || right < -100 || right > 100 ||
        requestedPower < 0 || requestedPower > 100) {
      forceSafeForUpdate();
      maintenanceServer.send(400, "text/plain", "Invalid drive command");
      return;
    }

    remoteSession.invalidate();
    activeControlSource = ControlSource::WEB;
    commandArmed = armed;
    commandDeadman = deadman;
    commandOverdrive = overdrive;
    targetLeftPercent = static_cast<int8_t>(left);
    targetRightPercent = static_cast<int8_t>(right);
    selectedPowerMode = overdrive ? 0xFF : requestedPower;
    ++lastSequence;
    lastCommandMs = millis();
    watchdogStopped = false;
    overdrivePending = overdrive && deadman;
    if (!armed || !deadman || (left == 0 && right == 0)) {
      coastAll();
    }
    if (!armed) {
      activeControlSource = ControlSource::NONE;
    }
    maintenanceServer.send(200, "application/json", "{\"accepted\":true}");
  });
  maintenanceServer.on("/api/command", HTTP_POST, []() {
    ControlGuard guard;
    String command = maintenanceServer.arg("command");
    command.trim();
    command.toLowerCase();
    if (command.isEmpty() || command.length() > 64) {
      maintenanceServer.send(400, "text/plain", "Enter a command up to 64 characters.");
      return;
    }

    if (command == "sensors") {
      maintenanceServer.send(200, "application/json", sensorStatusJson());
      return;
    }
    if (command == "help") {
      maintenanceServer.send(
          200, "text/plain",
          "help | status | sensors | stop | power 25|50|75|100|overdrive | "
          "pulse forward|reverse|left|right [power] | drive <left> <right>\n"
          "Motion is a single watchdog-limited pulse; use the buttons for held driving.");
      return;
    }
    if (command == "status") {
      String reply = commandArmed ? "ARMED" : "SAFE";
      reply += " | source=";
      reply += activeControlSource == ControlSource::WEB
                   ? "WEB"
                   : (activeControlSource == ControlSource::BLE ? "BLE" : "NONE");
      reply += " | left=" + String(leftMotor.currentPercent);
      reply += "% right=" + String(rightMotor.currentPercent);
      reply += "% | INA226=";
      reply += ina226Present ? "0x" + String(ina226Address, HEX) : "not found";
      maintenanceServer.send(200, "text/plain", reply);
      return;
    }
    if (command == "stop" || command == "disarm") {
      forceSafeForUpdate();
      appendLog("Web console STOP; motors coasted and disarmed");
      maintenanceServer.send(200, "text/plain", "SAFE: motors coasted and disarmed.");
      return;
    }

    if (activeControlSource != ControlSource::WEB && activeControlSource != ControlSource::NONE && commandArmed &&
        commandDeadman &&
        (targetLeftPercent != 0 || targetRightPercent != 0)) {
      maintenanceServer.send(409, "text/plain",
                             "BLE controller is actively driving.");
      return;
    }

    auto parsePower = [](String value, uint8_t &percent,
                         bool &overdrive) -> bool {
      value.trim();
      overdrive = value == "overdrive";
      if (overdrive) {
        percent = 100;
        return true;
      }
      const int parsed = value.toInt();
      if ((parsed != 25 && parsed != 50 && parsed != 75 && parsed != 100) ||
          value != String(parsed)) {
        return false;
      }
      percent = static_cast<uint8_t>(parsed);
      return true;
    };

    if (command.startsWith("power ")) {
      uint8_t percent = 0;
      bool overdrive = false;
      if (!parsePower(command.substring(6), percent, overdrive)) {
        maintenanceServer.send(400, "text/plain",
                               "Power must be 25, 50, 75, 100, or overdrive.");
        return;
      }
      selectedPowerMode = overdrive ? 0xFF : percent;
      commandOverdrive = overdrive;
      coastAll();
      appendLog("Web console power set to " +
                String(overdrive ? "OVERDRIVE" : String(percent) + "%"));
      maintenanceServer.send(200, "text/plain",
                             overdrive ? "Power set to OVERDRIVE."
                                       : "Power set to " + String(percent) + "%.");
      return;
    }

    int left = 0;
    int right = 0;
    uint8_t pulsePower = selectedPowerMode == 0xFF ? 100 : selectedPowerMode;
    bool pulseOverdrive = selectedPowerMode == 0xFF;
    bool validMotion = false;
    if (command.startsWith("pulse ")) {
      String arguments = command.substring(6);
      arguments.trim();
      const int separator = arguments.indexOf(' ');
      const String direction =
          separator < 0 ? arguments : arguments.substring(0, separator);
      if (separator >= 0 &&
          !parsePower(arguments.substring(separator + 1), pulsePower,
                      pulseOverdrive)) {
        maintenanceServer.send(400, "text/plain",
                               "Pulse power must be 25, 50, 75, 100, or overdrive.");
        return;
      }
      if (direction == "forward") {
        left = pulsePower;
        right = pulsePower;
        validMotion = true;
      } else if (direction == "reverse") {
        left = -pulsePower;
        right = -pulsePower;
        validMotion = true;
      } else if (direction == "left") {
        left = pulsePower;
        right = -pulsePower;
        validMotion = true;
      } else if (direction == "right") {
        left = -pulsePower;
        right = pulsePower;
        validMotion = true;
      }
    } else if (command.startsWith("drive ")) {
      String values = command.substring(6);
      values.trim();
      const int separator = values.indexOf(' ');
      if (separator > 0 && values.indexOf(' ', separator + 1) < 0) {
        const String leftText = values.substring(0, separator);
        const String rightText = values.substring(separator + 1);
        left = leftText.toInt();
        right = rightText.toInt();
        validMotion = left >= -100 && left <= 100 && right >= -100 &&
                      right <= 100 && leftText == String(left) &&
                      rightText == String(right);
        pulseOverdrive = false;
      }
    }

    if (!validMotion) {
      maintenanceServer.send(400, "text/plain",
                             "Unknown or invalid command. Send 'help' for syntax.");
      return;
    }
    if (left == 0 && right == 0) {
      forceSafeForUpdate();
      maintenanceServer.send(200, "text/plain", "SAFE: zero command coasted both motors.");
      return;
    }

    if (batteryInhibitsMotion()) {
      coastAll();
      maintenanceServer.send(503, "text/plain",
                             "Battery lockout: pack too low, motion refused");
      return;
    }

    activeControlSource = ControlSource::WEB;
    commandArmed = true;
    commandDeadman = true;
    commandOverdrive = pulseOverdrive;
    targetLeftPercent = static_cast<int8_t>(left);
    targetRightPercent = static_cast<int8_t>(right);
    selectedPowerMode = pulseOverdrive ? 0xFF : pulsePower;
    ++lastSequence;
    lastCommandMs = millis();
    watchdogStopped = false;
    overdrivePending = pulseOverdrive;
    appendLog("Web console pulse: left=" + String(left) +
              "% right=" + String(right) + "%" +
              (pulseOverdrive ? " OVERDRIVE" : ""));
    maintenanceServer.send(
        200, "text/plain",
        "Motion accepted for one 350 ms watchdog-limited pulse.");
  });
  maintenanceServer.on(
      "/update", HTTP_POST,
      []() {
        const bool okay = !Update.hasError();
        maintenanceServer.send(okay ? 200 : 500, "text/plain",
                               okay ? "Update complete. Gladiator is rebooting."
                                    : "Update failed; current firmware retained.");
        if (okay) {
          delay(250);
          ESP.restart();
        }
      },
      []() {
        HTTPUpload &upload = maintenanceServer.upload();
        if (upload.status == UPLOAD_FILE_START) {
          forceSafeForUpdate();
          appendLogf("Web OTA starting: %s", upload.filename.c_str());
          Update.begin(UPDATE_SIZE_UNKNOWN);
        } else if (upload.status == UPLOAD_FILE_WRITE) {
          Update.write(upload.buf, upload.currentSize);
          feedLoopWDT(); // HTTP upload runs inside one handleClient() call.
        } else if (upload.status == UPLOAD_FILE_END) {
          if (Update.end(true)) {
            appendLogf("Web OTA complete: %u bytes", upload.totalSize);
          } else {
            appendLogf("Web OTA failed: error %u", Update.getError());
          }
        } else if (upload.status == UPLOAD_FILE_ABORTED) {
          Update.abort();
          appendLog("Web OTA upload aborted");
        }
      });
  maintenanceServer.begin();

  ArduinoOTA.setHostname("gladiator-s3");
  ArduinoOTA.setPassword(OTA_PASSWORD);
  ArduinoOTA.onStart([]() {
    forceSafeForUpdate();
    appendLog("PlatformIO OTA starting; motors coasted and disarmed");
  });
  ArduinoOTA.onEnd([]() { appendLog("PlatformIO OTA complete; rebooting"); });
  ArduinoOTA.onProgress([](unsigned int, unsigned int) { feedLoopWDT(); });
  ArduinoOTA.onError([](ota_error_t error) {
    appendLogf("PlatformIO OTA failed: error %u", error);
  });
  ArduinoOTA.begin();

  appendLogf("Maintenance Wi-Fi: %s at http://%s", MAINTENANCE_AP_NAME,
             WiFi.softAPIP().toString().c_str());
}

int8_t rampToward(int8_t current, int8_t target) {
  if (current == target) {
    return current;
  }

  // A direction reversal always crosses zero before energizing the other PWM
  // input, which avoids commanding both halves of a BTS7960 during transition.
  if ((current > 0 && target < 0) || (current < 0 && target > 0)) {
    target = 0;
  }

  if (current < target) {
    return min<int>(current + RAMP_STEP_PERCENT, target);
  }
  return max<int>(current - RAMP_STEP_PERCENT, target);
}

// Straight-line trim for both directions. Only equal, non-zero commands are
// straight-ahead; turns carry their own differential and Overdrive is untrimmed
// by design.
void applyStraightTrim(int8_t &left, int8_t &right) {
  orientation::straightTrim(left, right, commandOverdrive);
}

void updateMotorOutputs() {
  ControlGuard guard;
  if(batteryInhibitsMotion()){coastAll();return;}
  const bool controlSourceOnline =
      activeControlSource == ControlSource::WEB ||
      (activeControlSource == ControlSource::FIELD && remoteSession.armed) ||
      (activeControlSource == ControlSource::LINK && gatewayLink.online() && remoteSession.armed) ||
      (activeControlSource == ControlSource::BLE && bleConnected);
  if (!controlSourceOnline || !commandArmed || !commandDeadman) {
    if (leftMotor.currentPercent != 0 || rightMotor.currentPercent != 0) {
      coastAll();
    }
    return;
  }

  int8_t outputLeft = targetLeftPercent;
  int8_t outputRight = targetRightPercent;
  applyStraightTrim(outputLeft, outputRight);

  // Overdrive intentionally bypasses soft start and commands full-duty values
  // immediately. Direction and magnitude still come from the signed frame.
  if (commandOverdrive && overdrivePending) {
    overdrivePending = false;
    applyMotor(leftMotor, outputLeft);
    applyMotor(rightMotor, outputRight);
    return;
  }

  const uint32_t now = millis();
  if (now - lastRampMs < RAMP_INTERVAL_MS) {
    return;
  }
  lastRampMs = now;

  const int8_t nextLeft = rampToward(leftMotor.currentPercent, outputLeft);
  const int8_t nextRight = rampToward(rightMotor.currentPercent, outputRight);
  applyMotor(leftMotor, nextLeft);
  applyMotor(rightMotor, nextRight);
}

void publishStatus(bool force = false) {
  if (!bleConnected || statusCharacteristic == nullptr) {
    return;
  }

  const uint32_t now = millis();
  if (!force && now - lastStatusMs < STATUS_INTERVAL_MS) {
    return;
  }
  lastStatusMs = now;

  uint8_t frame[FRAME_SIZE] = {};
  frame[0] = FRAME_MAGIC_STATUS;
  frame[1] = PROTOCOL_VERSION;
  frame[2] = (bleConnected ? 0x01 : 0x00) |
             (commandArmed ? 0x02 : 0x00) |
             ((leftMotor.currentPercent != 0 || rightMotor.currentPercent != 0) ? 0x04 : 0x00) |
             (watchdogStopped ? 0x08 : 0x00) |
             (commandOverdrive ? 0x10 : 0x00);
  frame[3] = static_cast<uint8_t>(leftMotor.currentPercent);
  frame[4] = static_cast<uint8_t>(rightMotor.currentPercent);
  frame[5] = selectedPowerMode;
  frame[6] = lastSequence;
  frame[7] = checksum(frame, FRAME_SIZE - 1);

  statusCharacteristic->setValue(frame, sizeof(frame));
  statusCharacteristic->notify();
}

void publishPowerTelemetry(bool force = false) {
  if (!bleConnected || powerCharacteristic == nullptr) {
    return;
  }

  const uint32_t now = millis();
  if (!force && now - lastStatusMs < STATUS_INTERVAL_MS) {
    return;
  }

  uint8_t frame[POWER_FRAME_SIZE] = {};
  frame[0] = POWER_FRAME_MAGIC;
  frame[1] = PROTOCOL_VERSION;
  frame[2] = (ina226Present ? 0x01 : 0x00) |
             (ina226SampleValid ? 0x02 : 0x00) |
             (currentMilliamps < 0 ? 0x04 : 0x00) |
             ((leftMotor.currentPercent != 0 || rightMotor.currentPercent != 0)
                  ? 0x08
                  : 0x00);
  frame[3] = ina226Address;
  writeLe16(frame, 4, busMillivolts);
  writeLe32(frame, 6, currentMilliamps);
  writeLe32(frame, 10, powerMilliwatts);
  writeLe16(frame, 14,
            minimumBusMillivolts == UINT16_MAX ? 0 : minimumBusMillivolts);
  writeLe16(frame, 16, peakCurrentMilliamps);
  frame[18] = ina226SampleSequence;
  frame[19] = checksum(frame, POWER_FRAME_SIZE - 1);

  powerCharacteristic->setValue(frame, sizeof(frame));
  powerCharacteristic->notify();
}

class CommandCallbacks final : public BLECharacteristicCallbacks {
  void rejectInput(){
    bleMustRelease=true;
    if(activeControlSource==ControlSource::BLE){
      commandArmed=commandDeadman=commandOverdrive=false;activeControlSource=ControlSource::NONE;
      targetLeftPercent=targetRightPercent=0;watchdogStopped=true;coastAll();
    }
  }
  void onWrite(BLECharacteristic *characteristic) override {
    ControlGuard guard;
    const std::string value = characteristic->getValue();
    if (value.size() != FRAME_SIZE) {
      rejectInput();
      return;
    }

    const auto *frame = reinterpret_cast<const uint8_t *>(value.data());
    if (frame[0] != FRAME_MAGIC_COMMAND ||
        frame[1] != PROTOCOL_VERSION ||
        frame[7] != checksum(frame, FRAME_SIZE - 1)) {
      rejectInput();
      return;
    }

    const int8_t left = static_cast<int8_t>(frame[4]);
    const int8_t right = static_cast<int8_t>(frame[5]);
    if (left < -100 || left > 100 || right < -100 || right > 100) {
      rejectInput();
      return;
    }

    if (activeControlSource != ControlSource::BLE && activeControlSource != ControlSource::NONE && commandArmed &&
        commandDeadman &&
        (targetLeftPercent != 0 || targetRightPercent != 0)) {
      appendLog("BLE command rejected while web controller is actively driving");
      return;
    }
    if (batteryInhibitsMotion()) {
      coastAll();
      return; // guard already logged; do not spam per frame
    }
    if(!(frame[3]&FLAG_ARMED))bleMustRelease=false;
    if(bleMustRelease&&(frame[3]&FLAG_ARMED))return;
    revokeRemote=true;
    activeControlSource = ControlSource::BLE;

    lastSequence = frame[2];
    commandArmed = (frame[3] & FLAG_ARMED) != 0;
    commandDeadman = (frame[3] & FLAG_DEADMAN) != 0;
    commandOverdrive = (frame[3] & FLAG_OVERDRIVE) != 0;
    targetLeftPercent = left;
    targetRightPercent = right;
    selectedPowerMode = frame[6];
    lastCommandMs = millis();
    watchdogStopped = false;
    overdrivePending = commandOverdrive && commandDeadman;

    if (!commandArmed || !commandDeadman || (left == 0 && right == 0)) {
      coastAll();
    }
    publishStatus(true);
    publishPowerTelemetry(true);
  }
};

class ServerCallbacks final : public BLEServerCallbacks {
  void onConnect(BLEServer *) override {
    ControlGuard guard;
    bleConnected = true;
    if ((activeControlSource != ControlSource::WEB && activeControlSource != ControlSource::LINK && activeControlSource != ControlSource::FIELD) || !commandArmed) {
      commandArmed = false;
      commandDeadman = false;
      commandOverdrive = false;
      watchdogStopped = false;
      lastCommandMs = millis();
      coastAll();
    }
    appendLog("Phone connected; motors remain disarmed unless web control is active.");
  }

  void onDisconnect(BLEServer *server) override {
    ControlGuard guard;
    bleConnected = false;
    if (activeControlSource == ControlSource::BLE) {
      bleMustRelease=true;
      activeControlSource = ControlSource::NONE;
      commandArmed = false;
      commandDeadman = false;
      commandOverdrive = false;
      watchdogStopped = true;
      coastAll();
      appendLog("Phone disconnected; motors coasted and disarmed.");
    } else {
      appendLog("Phone disconnected; web controller ownership unchanged.");
    }
    delay(40);
    server->getAdvertising()->start();
  }
};

CommandCallbacks commandCallbacks;
ServerCallbacks serverCallbacks;

void setupPwmPin(uint8_t pin, uint8_t channel) {
  ledcSetup(channel, PWM_FREQUENCY_HZ, PWM_RESOLUTION_BITS);
  ledcAttachPin(pin, channel);
  ledcWrite(channel, 0);
}

void setupMotors() {
  pinMode(LEFT_R_EN_PIN, OUTPUT);
  pinMode(LEFT_L_EN_PIN, OUTPUT);
  pinMode(RIGHT_R_EN_PIN, OUTPUT);
  pinMode(RIGHT_L_EN_PIN, OUTPUT);

  digitalWrite(LEFT_R_EN_PIN, LOW);
  digitalWrite(LEFT_L_EN_PIN, LOW);
  digitalWrite(RIGHT_R_EN_PIN, LOW);
  digitalWrite(RIGHT_L_EN_PIN, LOW);

  setupPwmPin(LEFT_RPWM_PIN, LEFT_RPWM_CHANNEL);
  setupPwmPin(LEFT_LPWM_PIN, LEFT_LPWM_CHANNEL);
  setupPwmPin(RIGHT_RPWM_PIN, RIGHT_RPWM_CHANNEL);
  setupPwmPin(RIGHT_LPWM_PIN, RIGHT_LPWM_CHANNEL);
  coastAll();
}

void setupBle() {
  BLEDevice::init(DEVICE_NAME);
  BLEDevice::setMTU(64);

  bleServer = BLEDevice::createServer();
  bleServer->setCallbacks(&serverCallbacks);

  BLEService *service = bleServer->createService(SERVICE_UUID);
  BLECharacteristic *commandCharacteristic = service->createCharacteristic(
      COMMAND_UUID,
      BLECharacteristic::PROPERTY_WRITE | BLECharacteristic::PROPERTY_WRITE_NR);
  commandCharacteristic->setCallbacks(&commandCallbacks);

  statusCharacteristic = service->createCharacteristic(
      STATUS_UUID,
      BLECharacteristic::PROPERTY_READ | BLECharacteristic::PROPERTY_NOTIFY);
  statusCharacteristic->addDescriptor(new BLE2902());

  powerCharacteristic = service->createCharacteristic(
      POWER_UUID,
      BLECharacteristic::PROPERTY_READ | BLECharacteristic::PROPERTY_NOTIFY);
  powerCharacteristic->addDescriptor(new BLE2902());

  uint8_t initialStatus[FRAME_SIZE] = {
      FRAME_MAGIC_STATUS, PROTOCOL_VERSION, 0, 0, 0, 25, 0, 0};
  initialStatus[7] = checksum(initialStatus, FRAME_SIZE - 1);
  statusCharacteristic->setValue(initialStatus, sizeof(initialStatus));

  uint8_t initialPower[POWER_FRAME_SIZE] = {};
  initialPower[0] = POWER_FRAME_MAGIC;
  initialPower[1] = PROTOCOL_VERSION;
  initialPower[2] = ina226Present ? 0x01 : 0;
  initialPower[3] = ina226Address;
  initialPower[19] = checksum(initialPower, POWER_FRAME_SIZE - 1);
  powerCharacteristic->setValue(initialPower, sizeof(initialPower));

  service->start();

  BLEAdvertising *advertising = BLEDevice::getAdvertising();
  advertising->addServiceUUID(SERVICE_UUID);
  advertising->setScanResponse(true);
  advertising->setMinPreferred(0x06);
  advertising->setMaxPreferred(0x12);
  advertising->start();
}

} // namespace

void setup() {
  // Nothing in this project subscribed to the platform task watchdog before
  // this line, despite the SDK shipping one (5 s, panic-reboot) by default:
  // a hang anywhere in loop() - motors, Wi-Fi, BLE, the web server - froze
  // the board forever with no automatic recovery. Enable it first so it also
  // covers a hang during the rest of setup() itself.
  enableLoopWDT();
  commandMutex=xSemaphoreCreateRecursiveMutex();configASSERT(commandMutex);
  pinMode(board::BENCH_POWER_DETECT_PIN, INPUT_PULLUP);
  benchPowerViaPin = digitalRead(board::BENCH_POWER_DETECT_PIN) ==
                     (board::BENCH_POWER_DETECT_ACTIVE_LOW ? LOW : HIGH);
  benchPowerCandidate = benchPowerActive = benchPowerViaPin;
  benchPowerCandidateSinceMs = millis();
  setupMotors();

  // Read why the controller restarted before anything else can overwrite it.
  bootReason = esp_reset_reason();
  bootRawReason = static_cast<uint32_t>(rtc_get_reset_reason(0));
  if (rtcBootMagic != BOOT_MAGIC) {
    rtcBootMagic = BOOT_MAGIC;
    rtcBootCount = 0;
  }
  bootCount = ++rtcBootCount;
  statusLed.begin(bootReason, bootRawReason, bootCount);

  // Confirm this image unconditionally. Leaving it PENDING_VERIFY blocks every
  // later OTA at activation, which is indistinguishable from a bad image.
  const esp_partition_t *running = esp_ota_get_running_partition();
  if (running) {
    strlcpy(otaPartition, running->label, sizeof(otaPartition));
    esp_ota_img_states_t state = ESP_OTA_IMG_UNDEFINED;
    if (esp_ota_get_state_partition(running, &state) == ESP_OK) {
      switch (state) {
        case ESP_OTA_IMG_NEW: otaStateName = "NEW"; break;
        case ESP_OTA_IMG_PENDING_VERIFY: otaStateName = "PENDING_VERIFY"; break;
        case ESP_OTA_IMG_VALID: otaStateName = "VALID"; break;
        case ESP_OTA_IMG_INVALID: otaStateName = "INVALID"; break;
        case ESP_OTA_IMG_ABORTED: otaStateName = "ABORTED"; break;
        default: otaStateName = "UNDEFINED"; break;
      }
    }
    otaMarkedValid = esp_ota_mark_app_valid_cancel_rollback() == ESP_OK;
  }

  Serial.begin(115200);
  delay(500);
  Serial.println();
  appendLog("Gladiator tracked robot controller starting");
  appendLogf("Boot #%u since power-on | reset=%s (esp %d, raw 0x%02X) | blink code %u",
             bootCount, status::resetReasonName(bootReason), int(bootReason),
             bootRawReason, statusLed.code());
  appendLogf("OTA slot %s was %s at boot; mark-valid %s", otaPartition, otaStateName,
             otaMarkedValid ? "OK" : "FAILED");
  appendLog("Safety state: outputs disabled, waiting for BLE + ARM + held direction");
  appendLog(benchPowerActive
                ? "Bench power detected at boot on GPIO7; LiPo voltage protection bypassed"
                : "LiPo power policy active; ground GPIO7 only with the bench-power harness");

  sensorTaskStarted = sensorManager.begin();
  remoteSession.epoch=esp_random()|1;
  appendLog(gatewayLink.begin(sensorManager) ? "C6 UART link started on TX4/RX5 at 460800 baud" : "C6 UART task failed to start");
  appendLog(sensorTaskStarted ? "Sensor Core v1: I2C GPIO8/9 worker started" : "Sensor task failed to start");
  setupMaintenanceWifi();
  setupBle();

  appendLog("BLE advertising as Gladiator");
}

void loop() {
  const uint32_t loopStartedUs = micros();
  const uint32_t now = millis();
  if (commandArmed && now - lastCommandMs > COMMAND_TIMEOUT_MS) {
    ControlGuard guard;
    webMustRelease=true;bleMustRelease=true;remoteSession.invalidate();
    activeControlSource = ControlSource::NONE;
    commandArmed = false;
    commandDeadman = false;
    commandOverdrive = false;
    watchdogStopped = true;
    coastAll();
    appendLog("Command watchdog expired; motors coasted and disarmed.");
    publishStatus(true);
  }

  updateSensors();
  updateBenchPower(now);
  updateBatteryGuard(now);
  serviceFieldControl(now);
  updateMotorOutputs();
  updateSerialConsole();
  logIna226();
  publishPowerTelemetry();
  publishStatus();
  maintenanceServer.handleClient();
  ArduinoOTA.handle();
  updateLinkRadios(now);
  updateStatusLed(now);
  gateway::ControllerState linkController;
  linkController.armed=commandArmed;
  linkController.state=currentInterfaceState();linkController.battery=batteryState;
  linkController.deadman=commandDeadman;linkController.owner=uint8_t(activeControlSource);linkController.power=selectedPowerMode;
  linkController.batteryLockout=batteryLockout;linkController.radiosShed=batteryRadiosShed;linkController.benchPower=benchPowerActive;
  linkController.epoch=remoteSession.epoch;linkController.client=remoteSession.client;
  linkController.leftPercent=leftMotor.currentPercent;
  linkController.rightPercent=rightMotor.currentPercent;
  linkController.watchdogStopped=watchdogStopped;
  linkController.sensorTaskStarted=sensorTaskStarted;
  linkController.loopMaxUs=loopMaxUs;
  linkController.bootCount=bootCount;
  gatewayLink.setController(linkController);
  static uint32_t lastSystem=0;
  if(now-lastSystem>=1000){ControlGuard guard;lastSystem=now;JsonDocument system;
    system["firmware"]="Gladiator S3 Interface v1 / Link v2";system["build"]=__DATE__ " " __TIME__;system["freeHeap"]=ESP.getFreeHeap();
    system["orientation"]=orientation::NAME;
    system["resetReason"]=status::resetReasonName(bootReason);system["bootCount"]=bootCount;system["otaSlot"]=otaPartition;
    system["batteryState"]=batteryStateName(batteryState);system["powerSource"]=benchPowerActive?"BENCH":"LIPO";
    system["benchPower"]=benchPowerActive;system["benchPowerSource"]=benchPowerSourceName();
    system["benchDetectPin"]=board::BENCH_POWER_DETECT_PIN;
    system["radioShed"]=batteryRadiosShed;system["apUp"]=maintenanceApActive;
    system["logTail"]=webLog.substring(webLog.length()>450?webLog.length()-450:0);
    String s;serializeJson(system,s);gatewayLink.setSystem(s,webLog);
  }
  loopMaxUs = max(loopMaxUs, uint32_t(micros()-loopStartedUs));
  delay(2);
}
