iThinkiKhan/gladiator-cad/firmware/src/sensors/SensorManager.cpp

#include "SensorManager.h"
#include <esp_task_wdt.h>
#include <esp_timer.h>

namespace sensors {
SensorManager::SensorManager() : power_(bus_, working_.power), imu_(bus_, working_.imu),
    tof_(bus_, working_.tofFront), presence_(bus_, working_.presence) {
  published_ = working_;
}
bool SensorManager::begin() {
  mutex_ = xSemaphoreCreateMutex();
  if (!mutex_) return false;
  // Core 0 owns sensor I/O. The Arduino motor/control loop runs on core 1.
  if (xTaskCreatePinnedToCore(taskEntry, "sensors", 8192, this, 1, &task_, 0) != pdPASS) return false;
  // A driver call that blocks on a wedged I2C device must not freeze silently
  // forever; subscribe to the platform task watchdog so a genuine hang panics
  // and reboots instead of requiring someone to find and pull the power.
  esp_task_wdt_add(task_);
  return true;
}
bool SensorManager::snapshot(RobotSensors &out) {
  if (!mutex_ || xSemaphoreTake(mutex_, 0) != pdTRUE) return false;
  out = published_;
  xSemaphoreGive(mutex_);
  // Age the consumer copy as well: a stalled worker must not leave an OK badge.
  const uint32_t now = millis();
  out.power.meta.age(now, 250, 1500);
  out.imu.meta.age(now, 300, 2000);
  out.tofFront.meta.age(now,500,2500);
  out.presence.meta.age(now,800,2500);
  if(!out.tofFront.meta.hasSample || now-out.tofFront.meta.lastUpdateMs>500) out.tofFront.derived.valid=false;
  if(!out.presence.meta.hasSample || now-out.presence.meta.lastUpdateMs>800) {
    out.presence.derived.presenceValid=false; out.presence.derived.targetValid=false;
  }
  if (!out.imu.reports[0].hasSample || now-out.imu.reports[0].lastUpdateMs>300) out.imu.derived.valid=false;
  return true;
}
void SensorManager::taskEntry(void *context) { static_cast<SensorManager *>(context)->run(); }
void SensorManager::run() {
  working_.busStarted = bus_.begin();
  for (;;) {
    const uint64_t start = esp_timer_get_time();
    if (working_.busStarted) { power_.update(); imu_.update(); tof_.update(); presence_.update(); }
    else {
      working_.power.meta.health = working_.imu.meta.health = SensorHealth::ERROR;
    }
    working_.workerMaxUs = max(working_.workerMaxUs, uint32_t(esp_timer_get_time()-start));
    working_.snapshotUs = esp_timer_get_time();
    if (xSemaphoreTake(mutex_, 0) == pdTRUE) {
      published_ = working_;
      xSemaphoreGive(mutex_);
    }
    esp_task_wdt_reset();
    vTaskDelay(pdMS_TO_TICKS(1));
  }
}
}
