iThinkiKhan/gladiator-cad/(commit log)

2026-09-14 Initialize Gladiator CAD workspace
2026-09-15 Add front slots, mounting/pilot holes, and updated measurements
    [01_insert_clearance_gauge.step, 02_gladiator_crossbar_coupon.step, 03_side_rail_wire_coupon.step, 04_s3_expander_deck_fit.step, 04_s3_expander_deck_fit_v06.step, 05_s3_edge_clips_x4.step, 06_bts7960_vertical_cassette_fit.step, 06_bts7960_vertical_cassette_fit_v06.step]
2026-09-15 Export STEP alongside master FCStd for easier viewing
    [Gladiator_Master.step]
2026-09-15 Add battery box reference solid; export all solids to STEP
    [Gladiator_Master.FCStd, Gladiator_Master.pre-batterybox.20260915-154746.FCStd, Gladiator_Master.step]
2026-09-15 Resolve S3 hole pattern and heatsink orientation; record canted driver mounting
2026-09-15 Resolve driver stack height and fin orientation; record mast as structural; flag upper deck area problem
2026-09-15 Record mast anchored at lower deck; add proposed rail cross-section and slot-mounting consequence
2026-09-15 Add parametric arched side rails with raceway and foot adjustment slots
    [Gladiator_Master.FCStd, Gladiator_Master.pre-rails.20260915-165556.FCStd, Gladiator_Master.step]
2026-09-16 Rebuild rails as slender faceted arches, 12mm wide
    [Gladiator_Master.FCStd, Gladiator_Master.pre-archrails.20260915-203234.FCStd, Gladiator_Master.step]
2026-09-16 Rails: solid arch with raceway groove, retention tabs and M3 insert bores
    [Gladiator_Master.FCStd, Gladiator_Master.pre-solidrail.20260916-082756.FCStd, Gladiator_Master.step]
2026-09-16 Rails: steep rear post instead of diagonal, deeper raceway, sixth tab
    [Gladiator_Master.FCStd, Gladiator_Master.pre-v4.20260916-085132.FCStd, Gladiator_Master.step]
2026-09-16 Rails: seal end faces, raise soffit and deck for battery clearance
    [Gladiator_Master.FCStd, Gladiator_Master.pre-v5.20260916-091130.FCStd, Gladiator_Master.pre-v6.20260916-091359.FCStd, Gladiator_Master.step]
2026-09-16 Rails v7: fix front post undercut, round raceway corners, add well tabs
    [Gladiator_Master.FCStd, Gladiator_Master.pre-v7.20260916-092302.FCStd, Gladiator_Master.step]
2026-09-16 Add upper deck pass 1: 100x140x4 plate with rail fixing holes
    [Gladiator_Master.FCStd, Gladiator_Master.pre-deck.20260916-092613.FCStd, Gladiator_Master.step]
2026-09-16 Size insert bores to the real 7.05mm inserts; raise rail top to Z 48
    [Gladiator_Master.FCStd, Gladiator_Master.pre-v8.20260916-093030.FCStd, Gladiator_Master.step]
2026-09-16 Record mast brief, 6mm motor clearance, track extent; correct blocked rear pilots
2026-09-16 Add mast base, tube and upper deck bearing collar
    [Gladiator_Master.FCStd, Gladiator_Master.pre-mast.20260916-094531.FCStd, Gladiator_Master.step]
2026-09-16 Add S3 standoff bosses with M3 inserts; record adhesive-mount decision and cradle constraint
    [Gladiator_Master.FCStd, Gladiator_Master.pre-s3.20260916-111153.FCStd, Gladiator_Master.step]
2026-09-16 Correct power board protection concept: clip-on backing shield, position deferred
2026-09-16 Narrow upper deck to 79mm flush with lower deck; record track height
    [Gladiator_Master.FCStd, Gladiator_Master.pre-deck79.20260916-113559.FCStd, Gladiator_Master.step]
2026-09-16 Clean up stale track and mast entries in measurements
2026-09-16 Lay out S3 and breadboard side by side on the 79mm deck; add board reference envelopes
    [Gladiator_Master.FCStd, Gladiator_Master.step]
2026-09-16 Add canted driver mounts, power board shield and antenna post; notch deck for driver clearance
    [Gladiator_Master.FCStd, Gladiator_Master.pre-drivers.20260916-122203.FCStd, Gladiator_Master.step]
2026-09-16 Rebuild driver mounts as open frames on PCB standoffs; remove deck notches
    [Gladiator_Master.FCStd, Gladiator_Master.pre-drvframe.20260916-125645.FCStd, Gladiator_Master.step]
2026-09-16 Driver mounts: closed frame, PCB bolts flat, no free-standing spacers
    [Gladiator_Master.FCStd, Gladiator_Master.step]
2026-09-16 Stiffen driver frames to 12mm beams; replace antenna block with tapered pylon
    [Gladiator_Master.FCStd, Gladiator_Master.pre-stiffen.20260916-141426.FCStd, Gladiator_Master.step]
2026-09-16 Fix driver mount root: match upright/shoulder thickness to frame, add missing deck fixing holes
    [Gladiator_Master.FCStd, Gladiator_Master.pre-jointfix.20260916-151235.FCStd, Gladiator_Master.step]
2026-09-16 Gusset driver mount joint; rebuild antenna with real through-panel bulkhead mount and cable exit
    [Gladiator_Master.FCStd, Gladiator_Master.pre-gusset-antenna.20260916-152159.FCStd, Gladiator_Master.step]
2026-09-16 Taper upper deck: 85 through the board zone, 79 through the driver zone; redistribute S3/breadboard
    [Gladiator_Master.FCStd, Gladiator_Master.pre-taper.20260916-154039.FCStd, Gladiator_Master.step]
2026-09-16 Fix mast wire window direction/depth bug (found by mast-head audit); add DriverBoard reference envelopes; correct earlier deck-widen analysis
    [Gladiator_Master.FCStd, Gladiator_Master.pre-driverboard.20260916-162059.FCStd, Gladiator_Master.pre-windowfix.20260916-161809.FCStd, Gladiator_Master.step]
2026-09-16 Consolidate chassis/upper-structure/mast design docs into one, with a summary of the mast-head workstream
2026-09-16 Import head v0.1 candidate into the master; add mast anti-rotation index flat; fix STEP export to exclude group compounds and consumed boolean tools
    [Gladiator_Master.FCStd, Gladiator_Master.pre-headimport.20260916-163251.FCStd, Gladiator_Master.step]
2026-09-17 Print-readiness fixes: antenna insert bore floor 0.5->2.5mm, rail raceway floor restored, driver screw walls 1.7->2.2mm; document print orientations
    [Gladiator_Master.FCStd, Gladiator_Master.pre-printfix.20260917-044432.FCStd, Gladiator_Master.step]
2026-09-17 Antenna: proper SMA bulkhead mount sized to real connector dims (2mm clamped web via rear counterbore, tail runs straight out to the C6); move deck mast collar above the plate so the deck prints supp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
    [Gladiator_Master.FCStd, Gladiator_Master.pre-antenna-v2.20260917-080104.FCStd, Gladiator_Master.step]
2026-09-17 Add fit + calibration coupon: insert bore sizes, mast spigot pegs, clearance holes, rail slot
    [Gladiator_FitCoupon_v1.FCStd, Gladiator_FitCoupon_v1.step, Gladiator_FitCoupon_v1.stl]
2026-09-17 Re-export STLs at 0.01mm deflection: default tessellation made every round feature 0.2mm undersize, exactly one step of the coupon test
    [Gladiator_FitCoupon_v1.stl, Gladiator_SideRail_L_print-on-outboard-face.stl]
2026-09-17 Coupon v2: respace features so nothing merges at 4 wall loops
    v1 had 22 feature pairs under 3.5mm, worst 1.50mm between identification dots -
    they would have merged into an uncountable blur. v2 is 88x62, swaps counted dots
    for length-coded ticks, minimum gap now 4.05mm measured on the solid.
    [Gladiator_FitCoupon_v1.stl, Gladiator_FitCoupon_v2.FCStd, Gladiator_FitCoupon_v2.step, Gladiator_FitCoupon_v2.stl]
2026-09-17 Split the coupon: A (insert bores, 6.5g) and B (fits, 15g), replacing the 31g all-in-one
    The single slab was 86% base plate, existing only to hold unrelated tests apart.
    A alone answers the question blocking the rails and deck and prints in roughly a
    fifth of the time. Also fixed a 1.8mm slot-to-edge sliver found in B.
    [Gladiator_Coupon_A_InsertBores.FCStd, Gladiator_Coupon_A_InsertBores.stl, Gladiator_Coupon_B_Fits.FCStd, Gladiator_Coupon_B_Fits.stl, Gladiator_FitCoupon_v2.FCStd, Gladiator_FitCoupon_v2.step, Gladiator_FitCoupon_v2.stl]
2026-09-17 Keep the v2 coupon as the printed-artifact record; document the A/B split
    [Gladiator_FitCoupon_v2.FCStd, Gladiator_FitCoupon_v2.step, Gladiator_FitCoupon_v2.stl]
2026-09-18 Print-ready plates for the body and mast; fix a silent export orientation bug
    The rail STL in the incoming folder was laid on its INBOARD face while being
    named print-on-outboard-face. The exporter picked between the two candidate
    rotations by testing for a 12mm build height -- both pass -- and took the first.
    Raceway opening downward, 1448mm2 of support instead of 320, identical bounding
    box, so nothing downstream could catch it.
    The exporter now names the direction that must face the bed, derives the
    rotation, and asserts the resulting bed-contact area matches the intended face
    (outboard 3350mm2 vs inboard 2089mm2). All nine parts go through that one path.
    Also re-measured every print or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
    [Gladiator_P1_CouponA_InsertBores_flat.stl, Gladiator_P2_AntennaPost_print-on-front-face.stl, Gladiator_P2_MastBase_print-spigot-UP.stl, Gladiator_P2_PowerShield_print-on-side.stl, Gladiator_P3_SideRail_L_print-on-outboard-face.stl, Gladiator_P3_SideRail_R_print-on-outboard-face.stl, Gladiator_P4_UpperDeck_print-flat-bosses-up.stl, Gladiator_P5_MastTube_print-vertical.stl]
2026-09-18 Record the first printer calibration measurements; gate plate 2 as a result
    First real-world coupon measurements off the new printer, in PLA. Recorded in
    measurements/printer-calibration.md, which is now the authoritative record of
    how the printer actually prints.
    Headline: outside features come out about 0.25mm UNDERSIZE, consistently across
    five measurements. That is backwards from the normal case - a printer usually
    runs outside features over nominal because the bead squashes outward. A constant
    -0.26 offset fits the data better than a scale factor; the plate outline
    measurement (88.00 x 62.00) would settle it decisively and has not been taken.
    Two consequences that were not visible bef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
2026-09-18 Readiness review: only the power shield and mast tube are clear to print
    Re-checked all six plates against the first calibration round, and did a full
    part census of the master to confirm the nine exported STLs are every printed
    part except the head (the rest is the aluminium deck, five reference envelopes
    for bought hardware, and one boolean cutting tool).
    Clear today: the power shield (two M2 holes are its only fitted features) and
    the mast tube (everything on it mates with printed parts, so it scales with
    them). Coupon A is not needed - the v2 coupon in hand has the same four bosses
    on the same stack.
    New risk found this pass: 14 M3 and 4 M2 clearance holes across the set print
    3.00-3.2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
2026-09-18 Apply the coupon fit results; relieve the bores that start on the bed
    Coupon v2 measured and fits tested (PLA, new printer). The diagnosis from the
    partial data was wrong and is corrected in the calibration log: flat walls print
    slightly OVER (88.00 plate measured 88.25), while every curved feature prints
    about 0.25 UNDER, convex and concave alike. Not a scale error, not flow. The
    rail slot proves it - 3.4 wide with flat walls takes an M3 comfortably, while a
    3.4 round hole on the same plate will not pass one.
    Tested winners applied, one step up on every fit-critical round feature:
    rail_insert_dia 4.4 -> 4.6 insert flush, will not pull out
    deck2_screw_dia 3.4 -> 3.6 M3 clearance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
    [Gladiator_Master.20260918-165211.pre-calibration.FCStd, Gladiator_Master.20260918-165637.pre-chamfer.FCStd, Gladiator_Master.FCStd, Gladiator_Master.step, Gladiator_P2_AntennaPost_print-on-front-face.stl, Gladiator_P2_MastBase_print-spigot-UP.stl, Gladiator_P2_PowerShield_print-on-side.stl, Gladiator_P3_SideRail_L_print-on-outboard-face.stl]
2026-09-18 Build actual arranged plates as 3MF, not a list of loose STLs
    What shipped before was nine oriented STLs plus a document explaining which ones
    belonged together. That is a reading order, not a build plate - Jim reasonably
    expected to open something and print. This produces the real thing.
    Four 3MF files, each a complete plate with the parts already laid out on the bed:
    A upper deck + both side rails 193 x 140, tallest 14, 105 cm3 ready
    B mast base, shield, antenna 134 x 28, tallest 73, 22 cm3 ready
    C mast tube alone 20 x 20, tallest 114, 22 cm3 ready
    D both driver mounts 121 x 52, tallest 72, 64 cm3 blocked
    Plate A is the head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
    [Gladiator_PlateA_BODY_rails-and-upper-deck.3mf, Gladiator_PlateB_MAST-AND-FITTINGS.3mf, Gladiator_PlateC_MAST-TUBE.3mf, Gladiator_PlateD_DRIVER-MOUNTS_BLOCKED.3mf]
2026-09-19 Driver mount gate: record what was never measured, add the self-tap coupon
    Tracing the driver mount's interface found that three numbers it depends on have
    no measurement behind them anywhere in the repo:
    hole pitch across the board 39.5 assumed; one design-doc sentence is the
    only mention in the entire repo
    hole pitch along the board 39.5 assumed, AND assumed equal to the other,
    on a board that is 49.5 x 51
    heatsink length 32 assumed; components.md records the
    heatsink width and protrusion, never its
    len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
    [Gladiator_CouponC_SelfTapPilots_flat.stl, Gladiator_Coupon_C_SelfTapPilots.FCStd]
2026-09-19 Record that plate A is printed; the power board needs a mount that works around it
    Both side rails and the upper deck were printed 2026-09-18 in PLA. They are
    physical hardware now, so the rule that has always applied to the aluminium deck
    applies to them too: do not solve new problems by adding features to them.
    That closes off the standing plan for the power distribution board. It was to
    hang from the upper deck underside, and that underside is bare - 0.000 mm3 below
    the plate plane, verified - which is precisely why the deck prints support-free
    and how it was printed.
    Recorded what the printed deck actually offers from below (four corner bores, the
    bare bed face between the rails) so a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
2026-09-19 Bring the mast-head workstream into the repo
    Both head candidates and their design record have lived only on the CAD
    server disk until now. Nothing here changes geometry; it is the v01 and v02
    work as it already stands, plus the direction/measurement documents the
    review depends on.
    - cad/head/v01 - modular head candidate, GH44 carrier interface, fit prototypes
    - cad/head/v02-screen-180 - rear screen and 180 degree belt pan comparison,
    with its generator scripts
    - docs/MAST_HEAD_DIRECTION.md, docs/mast-head/ - design direction and the
    saved-master audit that found the reversed mast wire window
    - measurements/mast-head.md - servo and sensor measurement log
    Excluded from tracking: Gladia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
    [GH44_Blank_Carrier.stl, GH44_Carrier_Template.FCStd, GH44_Carrier_Template.step, GH44_Fixed_Head_Adapter.stl, GH44_Receiver_Fit_Coupon.stl, Gladiator_Head_v01.FCStd, Gladiator_Head_v01.step, Gladiator_Head_v02_Screen180.FCStd]
2026-09-19 Head v0.3: fix the belt drive so it can actually be built
    The belt stays. What changed is everything that made the v0.2 version
    unbuildable.
    The 1:1 ratio was the real flaw: it asked an SG90 for a full, repeatable
    180 degrees with hard stops 5.44 degrees outside it, against a usable travel
    that has never been measured and varies unit to unit. v0.3 steps up 1.5:1
    on 60T/40T, so the servo swings 133 degrees in its reliable middle band.
    Ratio, tooth counts and travel are now parameters.
    Other corrections:
    - Pulleys were pitch cylinders and flange envelopes. They now have cut 2GT
    grooves, and the driven ring is integral with the printed pedestal rather
    than a hub with nothing to fasten it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
    [Gladiator_HeadCoupon_BeltMesh_60deg.stl, Gladiator_Head_GH44_Dual_Carrier.stl, Gladiator_Head_GH44_Tilt_Receiver.stl, Gladiator_Head_Neck_Clamp_Cap.stl, Gladiator_Head_Neck_Main.stl, Gladiator_Head_Pan_Raised_Pedestal.stl, Gladiator_Head_Pan_Retainer_Crank.stl, Gladiator_Head_Pan_Rotor.stl]
2026-09-20 The S3 hole pattern was inferred, not measured, and it is wrong
    The printed upper deck's four S3 bosses sit at 30.9 x 55.0 c-t-c and the real
    board does not fit them. Verified the printed part matches the model exactly
    (boss tops read back out of the print-ready STL), so this is not an export or
    print bug -- the input measurement was wrong and the model built it faithfully.
    The 30.9 x 55.0 figure came from reinterpreting an ambiguous caliper reading
    (35.5 / 59.6, reported "from nearest edges of the circles") and was then marked
    "Confirmed 2026-09-15" without any confirming measurement, which is what let it
    reach a print.
    Un-confirm the pattern, record the three candidate readings, and add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
2026-09-20 S3 spans re-measured: the original readings were inside-edge after all
    Two-reading measurement on 2026-09-19 gives width I=35.5 O=48 and length
    I=59.5 O=72. Both directions independently derive the same hole diameter,
    6.25, which is the cross-check working.
    This settles the direction of the error: the 2026-09-15 figures were
    inside-edge-to-inside-edge exactly as originally described, and the
    reinterpretation to outer-edge was backwards. The true pattern is ~10 larger
    than the printed 30.9 x 55.0 in both directions, so the deck's bosses cannot be
    re-drilled -- an adapter plate is the only route that leaves the printed parts
    alone.
    It also disproves the recorded 42 board width: the holes alo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
2026-09-20 Driver frame: the arms lie along the 51 axis, not across the 49.5 ends
    Both this repo's design doc and the measurement request built on it said the
    frame arms land on the 8.75mm of bare board the heatsink leaves at each end of
    the 49.5 axis. Probing the built solid at its board contact face shows the
    geometry does nothing of the kind:
    frame touches the board two strips, B 0.76..9.26 and B 41.76..50.26,
    i.e. along the 51 axis
    each strip 8.5 wide, running the full 49.5 length
    opening between them 32.5 wide in B - what the heatsink passes through
    So drv_hs_len = 32 is the heatsink's width across the 51 direction despite its
    name, the bar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
2026-09-20 Heatsink confirmed at 32 and centred; arms verified to fit; header tails are the new blocker
    Jim measured the heatsink: 32 across the 51 axis, dead centre. That closes
    items 5 and 6. Strips are therefore 9.5 each - derived from 51 and 32, not
    measured directly, and labelled as such.
    Verified against the built solid rather than the arithmetic: the two arms occupy
    B 0.76..9.26 and B 41.76..50.26, 8.5 wide each, sitting inside the 9.5 strips
    with 0.24mm clearance to the heatsink on one side and 0.26 on the other. The
    arms fit - on a perfectly flat board face.
    Which they will not have. Jim reports the mounting face carries the bottoms of
    the header pins: some fatter than others, all the same l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
2026-09-20 Driver mount is rear-face only; two pin zones to relieve, depth still unknown
    Jim, 2026-09-20: the component/GPIO face cannot be mounted to at all. The mount
    must bear on the rear face in the two 9.5 strips flanking the heatsink, with the
    heatsink passing through the frame opening from the underside. The frame already
    works this way, so this confirms the architecture rather than changing it. The
    front of the board will not be held.
    The rear face is not clear. It carries header undersides in two distinct zones,
    one per strip, since the terminals and the GPIO header sit on opposite long
    edges:
    screw-terminal side a straight shallow line of tails, dead centre of the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
2026-09-20 Terminal-side pin line lands 0.20mm from the mounting hole edge
    Correction from Jim: the screw-terminal pin line is not dead centre of the
    strip, it is 5.3 from the heatsink edge. Checked against the solid rather than
    carried as arithmetic, in strip coordinates with the board edge at B=0:
    arm contact face B 0.76 .. 9.26
    mounting hole centre B 5.75, edges 4.40 .. 7.10
    pin line at 5.3 B 4.20
    gap to the hole edge 0.20mm
    So a relief channel over that line undercuts the screw at every plausible row
    width. Even a 1.0 row puts the channel edge at 4.70, past the hole edge at 4.40.
    The board would be unsupported on the outer side of each screw, and tightening
    would bend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
2026-09-20 Belt coupon: three groove widths on one plate, and confirm the printed mast
    Verified the coupon before committing anyone to a print session:
    - Tooth geometry measured off the solid, not the parameters. Arc pitch at the
    pitch diameter is 2.0000 mm, OD is 37.6892 against a spec 37.6892, depth is
    the 2GT nominal 0.75. Mesh is watertight, no self-intersections or
    non-manifolds, and the 0.01 mm export loses 0.0007 percent of volume.
    - The single arc has only 103 mm2 of bed contact for a 6 mm tall part, less
    than the mast base that already calls for a brim. Noted in the README.
    - The tooth land is 0.69 mm, one to two extrusion widths on a 0.4 mm nozzle.
    That is the marginal feature, so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
    [Gladiator_HeadCoupon_BeltMesh_3up.stl]
2026-09-20 Relieve the driver arms for the header tails; four bearing pads instead of flat faces
    Jim's measurements, 2026-09-20, close every open item on the board interface:
    tail height 1.5 - 1.7, all the same length
    terminal row 27.2 long, centred between the holes, 2.0 wide,
    near edge 5.3 from the heatsink
    GPIO block 8.6 long, 3.75 from one hole and 23 from the other
    the 5.3 measured to the near edge
    The collision flagged yesterday is resolved by the first of those. A 27.2 row
    centred between holes 39.5 apart spans A 11.15..38.35 and clears each screw hole
    edge by 4.65mm, so the relief can stop short and the screws keep full bearing.
    Ra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
    [Gladiator_Master.20260920-081352.pre-drvrelief.FCStd, Gladiator_Master.FCStd, Gladiator_Master.step, Gladiator_P6_DriverMount_L_print-inverted.stl, Gladiator_P6_DriverMount_R_print-inverted.stl, Gladiator_PlateD_DRIVER-MOUNTS_BLOCKED.3mf]
2026-09-20 Record the screen and servo readings; flag what does not reconcile
    Jim supplied ST7789 board and mounting-hole measurements and confirmed about
    six SG90s in stock, which closes the open servo-count question.
    The screen readings are logged raw but are NOT in the CAD, because the same
    hole comes out three different diameters depending on which pair you use:
    2.50 widthwise, 2.625 from the lengthwise outside-to-outside, and 1.825 from
    the stated 1.3 mm edge gap. Outside-to-outside 61.5 on a 62.5 board implies a
    0.5 mm gap, not 1.3, so one of those two numbers is wrong, and the candidate
    centre spacings differ by 0.8 mm. Separately, the widthwise outside-to-outside
    equals the board width exactly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
2026-09-20 Coupon D: SMA bore, the last guessed dimension on plate B
    ant_sma_dia is 6.75 and that number is pure extrapolation - derived from this
    printer 0.25 curve shrink against a 6.35 thread spec, never tested against a
    connector. It is the only guessed value left on plate B, which is otherwise
    ready to print.
    41 x 16 x 6, 3.1g, flat, no support. Three bores at 6.5 / 6.75 / 7.0, each with
    the real stack rather than a plain drilled plate: the 11 counterbore 4 deep from
    the rear, leaving the 2.0 clamping web the nut actually tightens against. A
    coupon without the counterbore would answer a different question, since the
    connector seats its shoulder in it.
    Parameters are read from the master at build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
    [Gladiator_CouponD_SmaBore_counterbore-DOWN.stl, Gladiator_Coupon_D_SmaBore.FCStd]
2026-09-20 Plate E: all remaining coupons, and the calibration gap in the head
    One bed, 13 pieces, 24.5 cm3. Belt mesh x3, bearing seat x3, spindle post x3,
    screen mount gauge, coupon C, and the two GH44 fit prototypes. Checked for
    plan-view overlap and bed envelope, not assumed: no overlaps, nothing off bed.
    Found while picking the coupon ranges: the head candidates were built on the
    16th and 17th, printer-calibration.md landed on the 18th, and it was applied to
    the master only. The head never inherited it. On this printer round features
    come out about 0.25 mm under, and the fit coupon already established that a
    modelled 3.4 and 2.4 will not pass an M3 or M2 screw at all. So every fastener
    hole in v0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
    [Gladiator_PlateE_ALL-COUPONS.3mf]
2026-09-20 No self-tappers, power board has no mounting holes, and the pitch flag is withdrawn
    Three things from Jim, 2026-09-20.
    No self-tapping screws. The four 2.7 pilots were drawn for them, so that route
    is out. Checked against the solid, with the arm at B 0.76..9.26, hole centre
    5.75 and heatsink edge 9.50:
    heat-set insert 4.6 1.21 wall out - the working coupon boss had 2.2, and
    an insert expands as it seats
    M3 clear 3.4 + nut 1.81 wall recommended - a nut loads the wall in
    compression instead of expanding it
    M3 into plastic 2.7 2.16 wall works, strips after a few removals
    The space behind every pilot is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
2026-09-20 Nuts and washers: driver pilots to 3.6 clearance; plate F; tidy the print queue
    Jim settled the fastener question: nuts and washers, no self-tappers.
    The four 2.7 self-tap pilots become 3.6 M3 clearance holes. 3.6 rather than the
    textbook 3.4 to match deck2_screw_dia - round features print about 0.25 under on
    this printer, so 3.4 lands near 3.15 against a 3.0 screw, and the rest of the
    design already moved to 3.6 for that reason. 213.8 mm3 removed, matching the
    prediction exactly; the mirrored right-hand part followed. Wall to the heatsink
    side is 1.71, which a nut loads in compression rather than expanding the way a
    heat-set insert would.
    That unblocks plate D. Renamed from _BLOCKED and i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
    [Gladiator_Master.20260920-092833.pre-drvclearance.FCStd, Gladiator_Master.FCStd, Gladiator_Master.step, Gladiator_P6_DriverMount_L_print-inverted.stl, Gladiator_P6_DriverMount_R_print-inverted.stl, Gladiator_PlateD_DRIVER-MOUNTS.3mf, Gladiator_PlateD_DRIVER-MOUNTS_BLOCKED.3mf, Gladiator_PlateF_ALL-COUPONS.3mf]
2026-09-20 Plate C was printed; flag the M2 self-tap gap that dropping coupon C leaves
    Jim confirms plate C (mast tube) was printed, so it is refiled from not-queued
    to done and that archive folder is gone.
    Coupon C was carrying two jobs and only one died with the nut decision. The
    driver mount pilots are genuinely moot - no self-tappers, so they became 3.6
    clearance holes and there is no thread to form.
    The second does not go away. The pan rotor still has M2 SELF-TAP pilots and
    there are no self-tapping screws in this build at all. No coupon settles it -
    coupon C tested M3 at 2.7/2.9/3.1 and was only ever a proxy for the M2 case. It
    is a design question for the head workstream: M2 clearance with nut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
2026-09-20 Stop writing a README into the print folder
    Jim deleted it and asked for it not to come back. The plate notes live in
    docs/print-plan.md; a second copy sitting in the print folder only goes stale.
2026-09-20 Power board has M2 mounting holes after all; screen active area; flag the coupon chamfer gap
    Corrections and new data from Jim, 2026-09-20.
    The power board DOES have four M2 mounting holes - the earlier note that it had
    none was wrong, so it does not need a cradle, it needs a bracket with standoffs.
    Two-reading pattern: c-t-c 34.5 across the width, 54.25 along the length, which
    cross-checks against the 60 x 40 outline as 2.75 and 2.875 of margin - near
    symmetric, which is what a sane layout looks like.
    The two directions derive different diameters though, 1.5 and 1.75, where the
    protocol says they must agree, and neither matches the stated M2 size. A true
    2.0 hole with that c-t-c predicts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
2026-09-20 Chamfer every bed-plane entrance on the coupons; fix a too-thin wall on coupon D
    Jim caught that the coupons had no entrance relief at all - the
    hole_entry_chamfer applied to the upper deck and mast base never reached the
    coupon geometry. On a fit coupon that is not cosmetic: a pinched entrance makes
    a screw refuse the screen gauge, or a bearing refuse a seat, and the coupon then
    reports the wrong answer to the exact question it exists to ask.
    0.5 at 45 degrees, up from the 0.35 on the deck, per Jim. Applied to every full
    circle lying in the bed plane, inside or outside - 18 edges across the plate:
    4 on the screen gauge, 4 on each GH44 piece, and 1 each on the three bearing
    seats and three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
    [Gladiator_CouponD_SmaBore_counterbore-DOWN.stl, Gladiator_Coupon_D_SmaBore.FCStd, Gladiator_PlateE_ALL-COUPONS.3mf, Gladiator_PlateF_ALL-COUPONS.3mf]
2026-09-20 Record servo sweep and the belt actually purchased
    Jim, 2026-09-20. Measured a real 160 degree sweep on the servos, which is
    comfortably more than the v0.1 candidate asks for (80 pan, 50 tilt).
    More consequential: the belts are bought and they are 180 mm CLOSED LOOPS, GT2
    2mm pitch, 6mm wide, five of them. That turns the pedestal centre distance from
    a free variable into a fixed one - for equal pulleys C = (180 - pi*d)/2, a
    single number once the pulley is chosen. The pedestal has to be built around it,
    and if the geometry wants something else the answer is a different belt or an
    idler, not a small adjustment.
    Still open: the tooth count and pitch diameter the design intends, which is what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
2026-09-20 Deck v2 spec: power board hangs on four through-holes, no underside features
    Started the v2 design. Not cutting geometry yet - two things still block it -
    but the power board mount is specified and the envelope is measured rather than
    assumed.
    Key numbers off the solids: 26.50 of headroom between the deck underside (Z 48)
    and the battery top (Z 21.5), and 59.75 of clear span across X between the rails.
    That last one settles the board orientation by itself - at 60 x 40 it needs 60
    along Y, because turning it to put 60 across X misses by a quarter millimetre.
    So it spans the battery lengthwise, which is exactly why it has to lift away
    with the deck.
    Checked the alternative properly before di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
2026-09-20 Reverse the power board mount: it sits on legs, it does not hang from the deck
    The previous spec had the board hanging under the deck on four M2 through-holes.
    That was wrong, and it was wrong because of an assumption I made rather than
    anything I measured - I took the board as free to face either way.
    It is not. Jim: everything plugs into the TOP of the power board, vertically,
    and it has to be comfortable to work JSTs and duponts in and out. A board hung
    under the deck has its top face 2-3mm from the deck underside. Connectors up and
    they hit the deck; connectors down and they point into the battery. Neither
    works.
    So the board keeps a leg mount and deck v2 goes back to one job, the S3 f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
2026-09-20 Plate G: everything currently unblocked. Pull plate B from the queue.
    Plate B should not be sliced. Two of its three parts are no longer printable:
    PowerShield known wrong as of today - its floor sits at Z 24..26 and its lip
    at 26..30, so a board resting on the lip has 4.0mm beneath it for
    6.0mm of solder. It was drawn before anyone knew the underside
    bulged that much. Needs a redesign, not a print.
    AntennaPost gated on coupon D, which is on plate F and not measured yet. Its
    SMA bore is still the extrapolated 6.75.
    MastBase fine - spigot 14.0, confirmed against the real deck hole by the
    peg test.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
    [Gladiator_PlateG_MASTBASE-AND-DRIVERS.3mf]
2026-09-20 Fix the GH44 receiver printing upside down; orientation now matched to a reference
    The female GH44 carrier came off plate F with its recess against the bed, so it
    printed with no recess at all. That was my regression, introduced when I moved
    those pieces from their pre-oriented STLs to their BREP sources so they could be
    chamfered.
    The rule I used was "lay the thinnest axis into Z". It does not say WHICH face
    ends up down, and a 180 degree flip satisfies it exactly as well. The blank
    carrier happened to land right way up; the receiver did not, and nothing in the
    pipeline could tell - the bounding box, the volume, the solid validity and the
    plate layout all checked out.
    Confirmed by compari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
    [Gladiator_PlateE_ALL-COUPONS.3mf, Gladiator_PlateF_ALL-COUPONS.3mf, Gladiator_REPRINT_GH44_Receiver_recess-UP.stl]
2026-09-20 Coupon D says 7.0 for the SMA bore; screen pattern confirmed; map the wire opening
    Plate F results from Jim, 2026-09-20.
    The SMA bulkhead wants the LARGEST bore, so ant_sma_dia goes 6.75 -> 7.0. The
    6.75 was my extrapolation from this printer's curve shrink against a 6.35 thread
    spec and it was one step small - which is exactly what the coupon was for.
    Removed 5.40 mm3, matching the prediction for a 2.0 deep web, and the shoulder
    the connector seats against is still 2.0 all round. The antenna post is now
    unblocked.
    The screen gauge fits the back of the board perfectly, so the 26.00 x 58.25 hole
    pattern is settled. Two things it did not cover are now recorded against the
    frame: the pin head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
    [Gladiator_Master.20260920-162718.pre-sma70.FCStd, Gladiator_Master.FCStd, Gladiator_Master.step, Gladiator_P2_AntennaPost_print-on-front-face.stl]
2026-09-20 Stop the exporters dumping into the printer queue; set the queue deliberately
    export_prints.py and build_plates.py wrote straight into the printer's incoming
    folder, so every re-export put all nine part STLs and all five plates back on top
    of a curated queue. That happened three times today and I mopped it up by hand
    each time. Both now write only to cad/print-ready.
    tidy_incoming.py becomes the one place the queue is set: it carries a LIVE list
    naming what is queued and why, copies those from the repo, and files everything
    else under _archive as done, superseded, blocked or single-parts. Still moves,
    never deletes.
    Queue is now exactly plate G and the GH44 receiver reprint.
    Co-Authored-B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
2026-09-20 Cut the wire pass-through; the S3 spacing question dissolves, the outline does not
    Wire opening cut per Jim's choice: centred on the mast axis, X 29.5..49.5,
    Y 90..98. 20 x 8, the largest that fits between the S3 board's rear edge at Y 89
    and the mast collar at Y 99. 609.1 mm3 removed against 609.1 predicted.
    Corners rounded R3 and both faces eased 0.8, because wires sit against these
    edges permanently and a printed edge will cut insulation over time. Insert bores
    and clearance holes all still present and the solid is valid.
    On Jim's challenge - "there is nothing we need to change about the S3 bosses
    width, so what is the question?" - he is right that the boss size is not the
    issue, and th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
    [Gladiator_Master.20260920-164222.pre-wireslot.FCStd, Gladiator_Master.FCStd, Gladiator_Master.step, Gladiator_P4_UpperDeck_print-flat-bosses-up.stl]
2026-09-20 Expander is 48 x 74; the 6.25 reading is impossible and the midpoint dodge is dead
    Jim measured the board with it in hand, and corrected how it has been described:
    there is no bare S3 board in this project, only the expander. It is 48 wide x 74
    tall. The recorded 42 width was wrong, 74 was right, the holes are large and in
    the corners, and the two boards do just fit side by side on the deck.
    Re-reading the two-reading spans against a real 48 x 74 settles the
    contradiction. The 6.25 candidate requires ZERO board material between the hole
    and the board edge across the width - a hole tangent to the edge, which cannot
    happen on a real PCB. So the O = 48.0 across the width was the board width
    it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
2026-09-20 Deck v2: expander pattern corrected to 40.10 x 64.10 and backed into the corner
    Jim measured about 1.6 of board material outside a hole against a prediction of
    1.65, which confirms the 4.6 hole diameter and settles the pattern at
    40.10 x 64.10. The deck as printed had 30.9 x 55.0, which is why the real board
    would not fit it.
    Backed into the left corner as far as the BOSSES allow rather than the board:
    left hole centre X 1.50, putting the boss outer edge flush with the deck edge at
    X -3. Y is unchanged, because moving it forward as well would land the
    front-left boss on the deck's 12 mm corner hole at (3, 6). Board now spans
    X -2.45..45.55, Y 15..89, and the rear boss clears the new wire op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
    [Gladiator_Master.20260920-165412.pre-s3pattern.FCStd, Gladiator_Master.FCStd, Gladiator_Master.step, Gladiator_P4_UpperDeck_print-flat-bosses-up.stl]
2026-09-20 Move the expander into its FRONT corner, and correct two wrong claims about the deck
    Jim: "you moved it the wrong way, I want it in its FRONT corner. You moved it
    closer to the mast side." He is right. The first pass moved it left and kept the
    Y centre fixed, so when the pattern grew from 55.0 to 64.10 the REAR boss moved
    4.55 toward the mast - the opposite of the intent.
    It was held back by a claim that the deck's 12 mm corner hole at (3, 6) blocked
    the move. That claim was wrong twice over.
    First, those dia-12 features are not holes. They are the deck's corner FILLETS,
    deck2_corner_r = 6, and the deck outline map confirms it: the plate runs
    X -0.3..79.4 at Y 1, widening to -3.0..82.1 by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
    [Gladiator_Master.20260920-170724.pre-s3front.FCStd, Gladiator_Master.FCStd, Gladiator_Master.step, Gladiator_P4_UpperDeck_print-flat-bosses-up.stl]
2026-09-20 Driver mount: drop the foot onto the deck plate instead of floating it on bosses
    The foot was a 13 x 49.5 plate at Z 58..62 resting only on the two dia-9 deck boss
    tops - about 107 mm2 of bearing carrying roughly 108 g on an 18 mm lever, with the
    bosses working as 6 mm cantilever pillars. Jim was right to be uneasy about it,
    though for a different reason than either of us first assumed.
    The foot now extends down to Z 52 and sits flat on the deck plate, pocketed
    around the bosses with 0.4 of clearance. Measured on the solid:
    bearing on the deck 107 -> 455.5 mm2, a 4.3x improvement
    bosses no longer cantilevers; they are shear pins in sockets
    inserts uncha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
    [Gladiator_Master.20260920-173827.pre-drvfoot.FCStd, Gladiator_Master.FCStd, Gladiator_Master.step, Gladiator_P6_DriverMount_L_print-inverted.stl, Gladiator_P6_DriverMount_R_print-inverted.stl]
2026-09-20 Plate H: a fast plate, and rebuild plate G with the flat-footed driver mounts
    Plate H is the quick one Jim asked for: upper deck v2 plus the corrected GH44
    receiver. Both flat and low - the deck is 14 tall with 8 mm2 of support, the
    receiver 4 tall with none - so no brim, no mixed-height stall, nothing tall
    enough to knock over. 137 x 140 of bed, 55.55 cm3 solid, validated for
    container, units, indices, on-bed placement and overlap.
    Also rebuilt plate G, which had gone stale. Its driver mounts were the version
    from before the foot change - the foot-on-bosses geometry, 2288 vertices. The
    last few commits ran export_step and export_prints but not build_plates, so the
    plate file kept the old m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
    [Gladiator_PlateD_DRIVER-MOUNTS.3mf, Gladiator_PlateG_MASTBASE-AND-DRIVERS.3mf, Gladiator_PlateH_DECK-AND-GH44.3mf]
2026-09-21 Driver mount: the board just turns around, and here is what limits fitting it
    Jim test-fitted a real driver and found the GPIO header lands on the outboard
    edge, where its wires would have to climb back over the heatsink to reach the
    S3. Checked it against the solid rather than the drawing.
    He is right about the problem and the mount already allows the fix. Measured in
    the PCB's own frame, the v=0 edge sits at X -8.39, Z 90 - inboard and high, 8.4
    mm outboard of the deck edge and just above the S3 envelope. The v=51 edge sits
    at X -33.89, Z 45.83, outboard and low over the track. The GPIO belongs at v=0.
    No mount change is needed to get there. The four PCB holes are a rectangle, and
    any fo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
2026-09-21 Correct the driver orientation finding: it is a face flip, not a rotation
    Jim pointed out that the previous conclusion was wrong. It was. 92ad7c9 said the
    board only needed turning 180 degrees in its own plane to move the GPIO
    inboard. An in-plane rotation cannot change which face points outboard, and the
    face is the whole problem. That section of components.md is replaced rather than
    appended to, so the wrong version does not stay in the repo.
    What the solid actually says. A 2 mm strip over both arms at v 10.75..42.25
    clashes with the frame by exactly 0.0 mm3. The relief pockets were cut to clear
    a 2 mm feature in that precise band, and the only thing 2 mm proud there is the
    solder tails f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
2026-09-21 Driver frame is four corner pads, and the window is bounded on the other axis
    Settled a disagreement between my note and measurements/components.md by
    sweeping the solid in global coordinates. Both were wrong.
    The frame does not touch the board in two strips. It touches at four corner
    pads - u 0..9 and 41..49.5 crossed with v 0..11 and 42..51 - and the four screw
    holes land exactly in them. Between the pads, at u 0..9 and 41..49.5 over
    v 11..42, is the 2 mm solder-tail relief. The genuinely clear opening is
    u 9..41 across all v, bounded in the 49.5 / global Y axis at 32 mm wide.
    Confirmed independently by the frame faces normal to Y at 89, 101, 128.5, 140.5.
    measurements/components.md comp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
2026-09-21 Driver mount v2: board on standoffs, GPIO inboard, fins in free air
    Jim's idea, worked up as a separate candidate. The board no longer bolts flat to
    the mount - it floats on four M3 male-female standoffs, so the mount only has to
    present four boss tops in the right places and get that load into the deck.
    The reason this is the better joint is not load spreading, it is the load path.
    A screw at 0.4 Nm develops about 667 N of preload and preload is what threatens
    PLA. With a male-female standoff the torqued joint is the board screw landing in
    the standoff's own metal thread; the plastic only ever sees a hand-tight stud in
    a heat-set insert. Bolting the board to the mount does not have that pr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
    [DriverMount_v2.FCStd, DriverMount_v2.step, DriverMount_v2_Left.stl, DriverMount_v2_Right.stl]
2026-09-21 Settle how the driver mount fastens: the deck pocket is an insert pocket
    Probed the deck boss a millimetre at a time instead of inferring. The D4.6
    feature at each boss is a blind pocket opening upward at the boss top, 7.5 mm
    deep, with 2.5 mm of deck slab closing it underneath. D4.6 is this printer's
    calibrated heat-set bore and 7.5 mm suits the 7.05 insert, so as printed the
    deck wants the insert in its own boss and the screw coming down from the mount.
    Jim remembered it the other way round - insert in the foot, screw up through the
    deck - and that is exactly why it never worked: neither direction was ever cut.
    It also explains v1's column above the boss being 95 percent solid. That is no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
2026-09-21 Driver mount v3: 45 degree wedge on the deck bosses as printed
    Jim's call: use the deck bosses that are already printed, which settles the
    fastening as Option A - heat-set into the deck boss, screw down through the
    mount. The mount now carries what v1 never had: a clearance hole from the foot
    top to the boss top, a pocket clearing the boss, and a column a driver can
    reach.
    Access measured against v1 as a control. A D4 hex key sees 41 mm3 of
    obstruction over 64 mm where v1 saw 513. A fat D7 screwdriver still rubs the
    plate edge at Z 78-86, so this wants a hex socket screw, and that is in the
    README rather than left to be discovered.
    Against v1: volume 33.4 -> 20.4 cm3, deck bearing 591 -> 1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
    [DriverMount_v3.FCStd, DriverMount_v3.step, DriverMount_v3_Left.stl, DriverMount_v3_Right.stl]
2026-09-21 Driver mount v4: split in two so the bosses can actually be supported
    Jim spotted that v3's top bosses had almost nothing behind them. Measured: the
    high pair had 0.0 mm3 of material in a ring around their base. Real defect.
    The cause is a conflict, not sloppiness. The board's high bosses land at X 14.54,
    Y 95 and 134.5; the deck screws are at X 14.5, Y 95 and 135. They want the same
    place. In one piece you choose between supporting the boss and reaching the
    screw, and v3 silently chose the screw.
    Two pieces removes the choice. The base bolts to the deck with open sky above
    it, then the wedge bolts to the base and can be solid straight through that
    region. Boss support is now 277 mm3 on th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
    [Base_Left.stl, DriverMount_v4.FCStd, DriverMount_v4.step, Wedge_Left.stl]
2026-09-21 Driver mount v5: interlock the joint, put the screws back into compression
    Jim called the wedge-to-base joint the weak point and he was right - v4 had four
    M3 in single shear with proud heads. v5 moves the load into the plastic.
    A 4 mm tongue runs the full Y length of the base's foot top with a matching
    groove in the wedge's seat plate. It engages by lowering the wedge on and it
    takes the outboard shear. The wedge beds on 633 mm2 of foot top and against the
    wall's outboard face - two full-length faces. The four M3 now run normal to the
    vertical seat, so they clamp the faces in compression rather than carrying shear.
    Heads are recessed in a D6.0 x 3.5 counterbore in the wall's inboard face;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
    [Base_Left.stl, DriverMount_v4.FCStd, DriverMount_v4.step, Wedge_Left.stl]
2026-09-21 Fins do not block the ToF; put driver v5 on the master to look at
    Checked before changing anything, because the fix Jim asked for would have cost
    a longer wedge. Swept the v0.3 head's 60x60 degree ToF cone over its full pan
    range at three tilts, 246 poses, against both sets of fins: zero intrusion.
    Re-ran it with a 400 mm apex-anchored cone in case the first pass was hiding a
    near-field gap. Still zero.
    The margin is comfortable rather than marginal. The ToF sits at Z 205, the fins
    top out at Z 115.3 and reach only about 50 mm from the mast axis. At the
    steepest ray - tilt -25 plus the cone's lower 30 degree edge, 55 degrees down -
    the ray is still near Z 134 at that radius, roughly 19 mm c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
    [DriverMount_v4.FCStd, DriverMount_v5.FCStd, DriverMount_v5.step, Gladiator_Master.20260920-213834.pre-drv-v5.FCStd, Gladiator_Master.FCStd, Gladiator_Master.step]
2026-09-21 cad: prepare driver v5 interlock print plate
    [Gladiator_DriverV5_Base_L.stl, Gladiator_DriverV5_Base_R.stl, Gladiator_DriverV5_Coupon_Groove.stl, Gladiator_DriverV5_Coupon_Tongue.stl, Gladiator_DriverV5_INTERLOCK-FIT-COUPON.3mf, Gladiator_DriverV5_Wedge_L.stl, Gladiator_DriverV5_Wedge_R.stl, Gladiator_PlateI_DRIVER-V5-INTERLOCK.3mf]
2026-09-21 cad: add supported power board cradle
    [PowerBoardCradle_v1.FCStd, PowerBoardCradle_v1.step, PowerBoardCradle_v1_installed.stl, PowerBoardCradle_v1_print-on-rear-face.stl]
2026-09-21 cad: expose power cradle service screws
    [PowerBoardCradle_v1.FCStd, PowerBoardCradle_v1.step, PowerBoardCradle_v1_installed.stl, PowerBoardCradle_v1_print-on-rear-face.stl]
2026-09-21 cad: correct cradle fasteners and rail joints
    [PowerBoardCradle_v1.FCStd, PowerBoardCradle_v1.step, PowerBoardCradle_v1_installed.stl, PowerBoardCradle_v1_print-on-rear-face.stl]
2026-09-22 cad: reinforce driver v5 interlock
    [Base_Left.stl, DriverMount_v5.FCStd, DriverMount_v5.step, Gladiator_DriverV5_Base_L.stl, Gladiator_DriverV5_Base_R.stl, Gladiator_DriverV5_Coupon_BaseSection.stl, Gladiator_DriverV5_Coupon_Groove.stl, Gladiator_DriverV5_Coupon_Tongue.stl]
2026-09-22 cad: tighten driver groove lead-in
    [DriverMount_v5.FCStd, DriverMount_v5.step, Gladiator_DriverV5_Coupon_WedgeSection.stl, Gladiator_DriverV5_INTERLOCK-FIT-COUPON.3mf, Gladiator_DriverV5_Wedge_L.stl, Gladiator_DriverV5_Wedge_R.stl, Gladiator_PlateI_DRIVER-V5-INTERLOCK.3mf, Wedge_Left.stl]
2026-09-22 cad: replace driver boss flares with pedestals
    [DriverMount_v5.FCStd, DriverMount_v5.step, Gladiator_DriverV5_Coupon_WedgeSection.stl, Gladiator_DriverV5_INTERLOCK-FIT-COUPON.3mf, Gladiator_DriverV5_Wedge_L.stl, Gladiator_DriverV5_Wedge_R.stl, Gladiator_PlateI_DRIVER-V5-INTERLOCK.3mf, Wedge_Left.stl]
2026-09-22 cad: close high boss support gap
    [DriverMount_v5.FCStd, DriverMount_v5.step, Gladiator_DriverV5_Coupon_WedgeSection.stl, Gladiator_DriverV5_INTERLOCK-FIT-COUPON.3mf, Gladiator_DriverV5_Wedge_L.stl, Gladiator_DriverV5_Wedge_R.stl, Gladiator_PlateI_DRIVER-V5-INTERLOCK.3mf, Wedge_Left.stl]
2026-09-22 cad: replace petal bosses with full wall columns
    [Base_Left.stl, DriverMount_v5.FCStd, DriverMount_v5.step, Gladiator_DriverV5_Base_L.stl, Gladiator_DriverV5_Base_R.stl, Gladiator_DriverV5_INTERLOCK-FIT-COUPON.3mf, Gladiator_DriverV5_Wedge_L.stl, Gladiator_DriverV5_Wedge_R.stl]
2026-09-23 cad: make driver v5 assemble and service with the mast fitted
    The 2026-09-22 boss pockets followed the 45 degree columns, so the wedge
    could not be lowered onto the base: up to 2.7 mm3 of interference between
    1 and 5 mm of travel. The pockets are now the exact volume swept straight
    up, and the build checks the drop-on path.
    The mount must come off for battery changes without removing anything
    else. The upper joint screws were in line with the mast tube (8.0 and
    11.5 mm of driver room); they are now splayed 22 degrees in plan, giving
    34.5 mm. The build now proves every joint screw, the wedge unit lift-out,
    deck-screw access and base lift-out against the robot, head candidate and
    mirrored mou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
    [Base_Left.stl, DriverMount_v5.FCStd, DriverMount_v5.step, Gladiator_DriverV5_Base_L.stl, Gladiator_DriverV5_Base_R.stl, Gladiator_DriverV5_Coupon_WedgeSection.stl, Gladiator_DriverV5_INTERLOCK-FIT-COUPON.3mf, Gladiator_DriverV5_Wedge_L.stl]
2026-09-23 docs: driver v5 removal is not needed for battery changes
2026-09-23 Add power board cradle v2: reinforced arm roots, +5mm overall length
    Both v1 arms sheared off where they met the main body: the arm-to-body
    joint had only a 1mm Y-overlap (about 4mm2 of bonded cross-section)
    carrying the full bending load of a 37mm cantilever. v2 replaces the
    single arm box with a root/taper/rail sequence tying into the existing
    wall mass, raising the bonded root cross-section to 78.8mm2 per arm
    (verified by direct solid query, not hand calculation).
    Overall tray length also increased by 5mm (2.5mm front, 2.5mm back) per
    request, split across the front floor/wall edge and the rear mounting
    tabs. The PCB standoff holes and the deck M2 anchors are unchanged --
    confirmed clash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
    [Gladiator_Master_20260923_111505_pre_cradle_v2.FCStd, PowerBoardCradle_v2.FCStd, PowerBoardCradle_v2.step, PowerBoardCradle_v2_installed.stl, PowerBoardCradle_v2_print-on-rear-face.stl]
2026-09-24 cad: open driver v5 base slots so the printed wedges seat
    The printed wedges would not seat because the upper cups struck the base
    slots, which had only 0.25-0.3 mm at the tilted exit edge. The cups
    locate nothing (the tongue and groove does), so only the base changes:
    1.45 mm clearance down and inboard, 1.05 mm along the cup axis and
    0.65 mm each side, limited by the joint screw counterbores (thinnest web
    now 1.71 mm, above the existing 1.63 mm counterbore wall).
    The relief is cut after the wedge is final, and the build refuses to
    save unless the rebuilt wedge matches the printed one, so the existing
    wedges and their inserts are reused. Adds Plate J (bases only).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
    [Base_Left.stl, DriverMount_v5.FCStd, DriverMount_v5.step, Gladiator_DriverV5_Base_L.stl, Gladiator_DriverV5_Base_R.stl, Gladiator_PlateI_DRIVER-V5-INTERLOCK.3mf, Gladiator_PlateJ_DRIVER-V5b-BASES-ONLY_deck-face-down.3mf]
2026-09-24 cad: cut the driver v5 base away behind the upper cups
    The v5b slot still let the base wall rise behind each upper heat-set
    cup, parallel to its 45 deg end face, and the printed joint stayed open
    by about a millimetre. That wall is not structural, so the slot now
    follows the cup's own bore down its axis and out through the inboard
    face, with everything above removed and the thin wall-end fins dropped.
    Seated clearance: 2.45 mm down, 3.5 mm along the axis, open inboard,
    0.65 mm toward the splayed upper screws. The floor stops 1.0 mm above
    the lower joint counterbore under each cup; that head seat is untouched.
    The rebuilt wedge still matches the printed one exactly, so only the
    bases are rep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
    [Base_Left.stl, DriverMount_v5.FCStd, DriverMount_v5.step, Gladiator_DriverV5_Base_L.stl, Gladiator_DriverV5_Base_R.stl, Gladiator_PlateI_DRIVER-V5-INTERLOCK.3mf, Gladiator_PlateJ_DRIVER-V5b-BASES-ONLY_deck-face-down.3mf, Gladiator_PlateJ_DRIVER-V5c-BASES-ONLY_deck-face-down.3mf]
2026-09-24 cad: keep the full wall over the driver v5 lower joint screws
    Jim does not want the lower joint screw's counterbore thinned to open
    room for the upper cups. The cup relief floor goes back to a 2.0 mm wall
    over that counterbore (Z73, was Z72 with 1.0 mm). The cup's lowest edge
    sits only 0.4 mm outboard of the counterbore, so this sets the cup's
    down clearance at 1.5 mm (printed v5: 0.3 mm). Everything else in the
    v5c relief is unchanged; the wedge still matches the printed one.
    [Base_Left.stl, DriverMount_v5.FCStd, DriverMount_v5.step, Gladiator_DriverV5_Base_L.stl, Gladiator_DriverV5_Base_R.stl, Gladiator_PlateI_DRIVER-V5-INTERLOCK.3mf, Gladiator_PlateJ_DRIVER-V5c-BASES-ONLY_deck-face-down.3mf]
2026-09-24 docs: correct driver v5c wall-end floor height
2026-09-27 cad: build 2 fixes - taller rails, front foot slot, taller mast, wider mast screws
    Findings from Jim's first physical build, applied to the master by
    scripts/apply_first_build_fixes.py (solid checks, refuses to save on failure):
    - Rails 6.5 taller: battery-to-soffit clearance 8.5 -> 15.0, rail top Z 54.5.
    Upper deck unchanged, lifted with everything that sits on it.
    - Front foot slot moved 3.5 rearward (screw Y 10 -> 13.5) so the right front
    screw finds the aluminium slit; foot/well lengthened, 2.5 kept to the battery.
    - 1.3 head relief in the front well: v1's M3 head fouled the outboard skin at
    every position over the slit.
    - Mast top Z 120 -> 130; head candidate and index flat follo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
    [Gladiator_Coupon_RailFrontFoot_R_v2_deck-face-down.stl, Gladiator_MastBase_v2-holes-42p5_print-spigot-UP.stl, Gladiator_MastTube_v2-Z130_print-vertical.stl, Gladiator_Master.FCStd, Gladiator_Master.step, Gladiator_SideRail_L_v2-tall_print-on-outboard-face.stl, Gladiator_SideRail_R_v2-tall_print-on-outboard-face.stl]
2026-09-27 cad: revert mast base screw widening; model the cells above the pack
    Jim clarified the real rear pilots are CLOSER together than the printed
    mast base holes (half of each pilot visible through them). The 42.5 spacing
    from 30d9c21 moved the holes the wrong way. mast_screw_spacing is held at the
    printed 41 until a caliper measurement lands, and the v2 mast base STL is
    withdrawn. PowerShield follows.
    Also adds BatteryCells (battery_cell_protrusion = 4, Jim): installed cells
    stand 4 above the holder, so the v2 rails clear the cells by 11.0, not 15.0.
    [Gladiator_MastBase_v2-holes-42p5_print-spigot-UP.stl, Gladiator_Master.FCStd, Gladiator_Master.step]
2026-09-27 cad: correct the rear deck pilots 1.2 outboard; mast base follows
    Jim, from the first build: the real rear M2 pilots are 3/4 of a pilot
    diameter (1.2) outboard of the printed mast base holes, and the Y128 pair is
    aligned with the Y111 pair. rear_pilot_outside_bias 0.5 -> 1.7 moves all four
    to X 17.8 / 61.2 (deck volume unchanged: holes moved, none added).
    mast_screw_spacing / mast_screw_y are now spreadsheet formulas on the deck
    pilot parameters, so the mast base (43.4 apart) and PowerShield cannot drift
    from the deck again. New mast base STL in cad/build2-20260927/.
    Consequence flagged in measurements/chassis.md: the Y128 pilots now sit under
    the rail rear feet, so the power board tray v2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
    [Gladiator_MastBase_v2-holes-43p4_print-spigot-UP.stl, Gladiator_Master.FCStd, Gladiator_Master.step]
2026-09-27 cad: power board tray v3 - deep arms, open board ends, clears the cells
    From Jim's first build (2026-09-27):
    - The rear pilot tabs could not reach the corrected pilots (now under the
    rail rear feet). They are dropped; the two rear slit bolts are the only deck
    fixings.
    - Stronger, not weaker: the arms, root, flares and rear posts grow upward in
    v2's plan footprint to Z 40, and the arm web rests on the mast collar rim.
    The arm section beside the mast goes from 21 mm2 / 6 deep to 82 mm2 / 20
    deep. Floor 1.0 -> 1.6.
    - v2's extra length was solid. It is now 2.9 of open wire space at each board
    end. The board and its holes are unmoved.
    - v2's floor sat 3.3 into the installed cells (4 a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
    [Gladiator_PowerBoardTray_v3_print-on-rear-face.stl, PowerBoardTray_v3.FCStd, PowerBoardTray_v3.step, PowerBoardTray_v3_installed.stl]
2026-09-30 cad: head coupons round 2; the printed v2 tube is the mast
    Five one-question coupons ahead of head v0.4:
    H1 belt centre distance on printed 60T + 40T pulleys (slotted bar),
    H2 neck collar on the real v2 mast (two key gaps plus the cap),
    H3 circlip + 6804 on a printed post, H4 M2 pilots, H5 M3 nut sockets.
    9 pieces, 21.4 cm3, no supports. Each piece is checked as a single
    solid, with probed orientation, bed contact and manifold 0.01 mm meshes.
    The 3MF plate is re-read after writing.
    Drop the buy-a-tube suggestion from the print plan and the design log
    (Jim, 2026-09-30). Add a head status note: v0.3 on hold, v0.4 goes
    60T on the servo and 40T on the head.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
    [Gladiator_HeadCoupons_R2.FCStd, Gladiator_HeadCoupons_R2.step, Gladiator_HeadR2_CouponPlate_ALL-9-pieces.3mf, Gladiator_HeadR2_H1a_BeltPulley-60T_flange-down.stl, Gladiator_HeadR2_H1b_BeltPulley-40T_flange-down.stl, Gladiator_HeadR2_H1c_BeltBar_flat.stl, Gladiator_HeadR2_H2a_NeckCollar_key-1notch-TIGHT_seat-disc-down.stl, Gladiator_HeadR2_H2b_NeckCollar_key-2notch-LOOSE_seat-disc-down.stl]
2026-09-30 docs: head coupon README lists only the measurements still missing
    Most of the original 15-item request was already recorded, in measurements/mast-head.md and in the Display section of measurements/components.md (screen holes 26.00 x 58.25 confirmed, visible area 51.2 x 25.6). The list is now six items, with a table of what is already known.
2026-10-01 measurements: commit the head records from 09-21/22; add the 10-01 screen and SG90 readings
    Commits the Codex-written records of Jim fit-coupon results (GH44, bearing/post, belt mesh), the pulley inventory, horn clarifications and the cross-horn hole count. These had sat uncommitted in measurements/mast-head.md since 2026-09-22.
    Adds Jim 2026-10-01: ST7789 visible area 6.2 from the left (pin-hole) edge and 1.5 from the top, header not soldered yet; SG90 spline 4 and about 15 from the body ends (conflicts with the old 8.3, flagged); an M2 screw does not thread into the spline. Cross-references the stale screen section to components.md.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
2026-10-01 cad: head coupon H6 horn pocket; record the SG90 cross horn measurements
    H6a/H6b: a plate with a pocket for the real cross horn, built from Jim calipers (long arms 36 tip to tip, 6.8 tapering to 4.8; short arms 19 by 3.8; hub 7.1; boss about 1 proud), at 0.15 and 0.30 per side. The 36 mm span exceeds the 60T tooth root (36.19), so v0.4 puts the pocket in a wider plate on the servo side of the drive pulley. The first nine coupons are byte-identical to what was printed. Arm thickness was not given, so the 1.2 pocket depth is an assumption and is flagged.
    Also corrects a misread: Jim wrote 7.1 5. where 5. was his list number, so the hub is 7.1, not 7.15. Adds the horn photo and notes the long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
    [Gladiator_HeadCoupons_R2.FCStd, Gladiator_HeadCoupons_R2.step, Gladiator_HeadR2_CouponPlate_ALL-11-pieces.3mf, Gladiator_HeadR2_H6a_HornPocket_1notch-SNUG_pocket-up.stl, Gladiator_HeadR2_H6b_HornPocket_2notch-EASY_pocket-up.stl]
2026-10-01 measurements: SG90 body photo; narrow the open servo questions to three readings
    The photo supports reading the 4 and about 15 as lengthwise distances and puts the shaft near 6 from the near end, not the older 8.3. It also hints that the horn sits lower than the recorded 13.2 above the ear underside, which would decide belt-groove alignment. Flagged as an estimate (+-1 mm, hand-held), not a measurement; the README now asks for spline-top, boss-top and ear-underside heights plus the body length.
2026-10-01 measurements: SG90 heights and body length; supersede the old 13.2 and 8.3
    Jim, measured: spline top 32, case boss top 28.5, ear underside 17.5, body length 22.7 (ears not counted). A seated horn underside is then about 11.0-11.5 above the ear underside, so the recorded 13.2 cannot be a seated horn. Shaft centre is about 5.9 +-0.6 from the near end, not 8.3. v0.3 modelled the servo about 1-2 mm short. The 17. 5mm reply is read as 17.5 and flagged.
    Also fixes the H6 instructions: the horn goes in the pocket boss-DOWN, since the round recess is cut into the floor.
2026-10-01 cad: power tray v4 with snap-in rear bases; correct the cell height in the master
    Power board tray v4 (cad/power-board/v4-tray/, scripts/build_power_tray_v4.py):
    - Two bolt-once rear bases (M3 slit bolts); the tray's 1 mm smaller rear pegs drop into
    sockets with a click bump, so a battery change is lift out, swap, drop in.
    - Floor 1.8 lower, board posts 7 -> 4.5: board 4.3 lower, 22.1 connector room.
    - 47 solid checks pass; fit coupon, bases and tray queued for print, nothing printed.
    Master: battery_cell_protrusion 4 -> 0.5 (Jim: cells are negligibly over the rim; 0.5 is a
    stand-in, not a measurement). STEP re-exported; backup in cad/master/drafts.
    Docs: dated corrections in the design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
    [Gladiator_Master.FCStd, Gladiator_Master.pre-cell-height.20261001-140205.FCStd, Gladiator_Master.step, Gladiator_PowerTray_v4_BaseLeft_print-tab-down.stl, Gladiator_PowerTray_v4_BaseRight_print-tab-down.stl, Gladiator_PowerTray_v4_FitCoupon_base-and-peg.stl, Gladiator_PowerTray_v4_print-on-rear-face.stl, PowerBoardTray_v4.FCStd]
2026-10-01 cad: clear superseded print plates and the v1 tray STL
    Jim cleared the old plates out of cad/print-ready (22 files deleted) and rebuilt the
    driver v5 base-section coupon; the v1 power tray STL is gone too. Everything stays in
    git history. Committed by Claude to consolidate the shared workspace.
    [Gladiator_CouponC_SelfTapPilots_flat.stl, Gladiator_CouponD_SmaBore_counterbore-DOWN.stl, Gladiator_Coupon_A_InsertBores.stl, Gladiator_Coupon_B_Fits.stl, Gladiator_DriverV5_Coupon_BaseSection.stl, Gladiator_P1_CouponA_InsertBores_flat.stl, Gladiator_P2_MastBase_print-spigot-UP.stl, Gladiator_P2_PowerShield_print-on-side.stl]
2026-10-01 cad: head drive coupon, and the v0.3 preprint hold note
    The 60T horn-slot fit coupon (cad/head/drive-coupons-20260922, built by
    scripts/build_head_drive_coupon.py) and the preprint hold banner on the v0.3 README
    (Codex review, 2026-09-22). Committed by Claude to consolidate the shared workspace.
    [Drive60_HornSlot_Fit_Coupon.FCStd, Drive60_HornSlot_Fit_Coupon.step, Drive60_HornSlot_Fit_Coupon_print-flat.stl]
2026-10-01 cad: antenna mount v3 with screw access
    cad/antenna/v3-screw-access and scripts/fix_antenna_screw_access.py. Committed by
    Claude to consolidate the shared workspace.
    [AntennaMount_v3_print-on-front-face.stl, AntennaMount_v3_screw-access.step, Gladiator_Master_antenna_v3_candidate.FCStd]
2026-10-01 cad: mast base short-spigot reprint, and the pre-edit master backups
    cad/mast-base/reprint-20260926 and scripts/build_mast_base_reprint.py, plus the three
    pre-edit master backups from 2026-09-27 that were left untracked. Committed by Claude
    to consolidate the shared workspace.
    [Gladiator_MastBase_spigot-3p5_chamfer-0p8_UP.stl, Gladiator_Master.pre-build2-fixes.20260927-092339.FCStd, Gladiator_Master.pre-mast-screw-revert.20260927-104413.FCStd, Gladiator_Master.pre-rear-pilots.20260927-105412.FCStd, Gladiator_Master_MastBase_short-spigot.FCStd]
2026-10-01 cad: driver v5 interlock preview images
    Committed by Claude to consolidate the shared workspace.
2026-10-01 docs: agent coordination files (AGENTS, CLAUDE, MICRO, docs/ai)
    These coordinate work between Jim, Claude, Codex and Micro. They do not replace the
    engineering documents, measurements or CAD, which remain the source of truth. Jim asked
    for a single master workspace, so they are now tracked.
2026-10-01 cad: INA226 cassette v1, a removable shelf on the power tray front wall
    cad/power-board/ina-cassette-v1, scripts/build_ina_cassette_v1.py. Board front-to-back with
    the header pins poking out the front, terminals at the rear; hangs on the v4 tray front wall
    (lip over the wall, tongue under the floor, friction bumps) and slides off forward, so the tray
    is untouched. Wings between the rail front posts locate it sideways. Validated on solids
    (slide-on, lift-out, screw and terminal access); not printed.
    The two M2 hole positions are inferred from Jim description (2.0 from the header edge and
    sides), not calipered. INA hole description recorded in measurements/components.md.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
    [Gladiator_INA226_Cassette_v1_print-upright.stl, INA226_Cassette_v1.FCStd, INA226_Cassette_v1.step, INA226_Cassette_v1_installed.stl]
2026-10-01 cad: power tray v4 strengthening pass - lighter arms, stronger base tabs
    Jim: the arms look overbuilt and the tabs look prone to breaking.
    - Arms: top scooped to 9 deep between the two collar contacts (tray 16.56 -> 15.62 cm3); root,
    flare and posts stay full depth.
    - Base: inboard wall 2.4, rear wall 2.0, tab runs past the walls with root fillets, rib behind
    the bump groove (it had left a 0.65 wall), r0.7 fillet at the peg root.
    - 47 solid checks pass; print meshes valid; no new overhangs. Not printed.
    [Gladiator_PowerTray_v4_BaseLeft_print-tab-down.stl, Gladiator_PowerTray_v4_BaseRight_print-tab-down.stl, Gladiator_PowerTray_v4_FitCoupon_base-and-peg.stl, Gladiator_PowerTray_v4_print-on-rear-face.stl, PowerBoardTray_v4.FCStd, PowerBoardTray_v4.step, PowerBoardTray_v4_installed.stl]
2026-10-01 measurements: round-2 coupon results so far (H5 nut pocket, H3 post too tight)
    H5: the 6.0 across-flats pocket takes an M3 nut. H3: the 20.20 post jammed a 6804, though the same modelled size fitted perfectly as plate F post 2 on 09-22. Cause not inferred; the notes ask for the measured post diameter and any settings change. Adds a plain START_HERE sheet beside the coupons, since Jim did not know what the collars and pulleys were for.
2026-10-01 cad: head coupon H4b (M2 pilots 2.3-2.5); record the H1, H2, H4 results
    Jim: the biggest H4 pilot (2.2) was clearly best for M2, maybe slightly bigger, so H4b brackets 2.3 / 2.4 / 2.5. H1: pulley shank centres 38.4 apart. That is 1.1 below the 39.486 a taut 180 mm belt needs, which would take pulleys 0.68 mm oversize or 2.1 mm of belt slack. Unresolved, flagged. H2: the 2-notch collar (looser key by the printed solids) grips tighter. Also unresolved. Possible link between H1 and H3: round external features may now print larger than the 0.25-under calibration. Not confirmed. Three caliper readings would test it.
    [Gladiator_HeadCoupons_R2.FCStd, Gladiator_HeadCoupons_R2.step, Gladiator_HeadR2_CouponPlate_ALL-12-pieces.3mf, Gladiator_HeadR2_H4b_M2Pilots-BIGGER_flat.stl]
2026-10-01 cad: final head coupon plate (bearing posts, M2 pilots, horn pockets); settle the v0.4 inputs
    Final plate: H3b x3 (post 19.95/20.05/20.15, replacing the 20.20 post that jammed a bearing), H4b (M2 pilots 2.3-2.5), H6a/H6b (horn pockets, now with a 3.4 centre hole so the horn screw head holds the plate). 6 pieces, 12.1 cm3, no supports. Only H6a/H6b changed among the earlier STLs, which were verified byte-identical.
    Records Jim follow-up: belt tightest about mid-slot (~39.75), 1-notch collar key wins, 60T flange 40.65 vs 40.689 modelled (so the 0.25 round-feature loss may depend on radius, not proven). DECISIONS.md lists the settled v0.4 inputs. Removes the superseded 11- and 12-piece plate f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
    [Gladiator_HeadCoupons_R2.FCStd, Gladiator_HeadCoupons_R2.step, Gladiator_HeadR2_CouponPlate_ALL-11-pieces.3mf, Gladiator_HeadR2_CouponPlate_ALL-12-pieces.3mf, Gladiator_HeadR2_FINAL-COUPON-PLATE_6-pieces.3mf, Gladiator_HeadR2_H3b1_BearingPost-1-notch-19.95_shoulder-down.stl, Gladiator_HeadR2_H3b2_BearingPost-2-notch-20.05_shoulder-down.stl, Gladiator_HeadR2_H3b3_BearingPost-3-notch-20.15_shoulder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]
2026-10-01 cad: head v0.4 stage 1, the pan stack, and print plate 1
    60T on the servo and 40T on the head (1.5x; 133 deg of servo for 200 of head), on a sliding servo
    carriage (37.0-40.4, nominal 39.75), with a horn plate in the drive pulley for the real SG90 cross
    horn. Built from the measured servo and horn numbers and the round-2 coupon results, re-based on
    the Z130 mast, and checked against the CURRENT master (19 solids).
    Checks: 13,432 head-pair + 56,088 robot + 8,360 carriage-end poses, 0 collisions; 0 ToF
    intersections; cable bore clear; master unchanged. The first run found 154 collisions, both
    causes my own modelling errors (a mirrored servo, a circlip cutting its groove), fixed.
    Service paths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
    [Gladiator_Head_v04_Neck_Clamp_Cap.stl, Gladiator_Head_v04_Neck_Main.stl, Gladiator_Head_v04_PLATE1_Pedestal-Retainer-Cap.3mf, Gladiator_Head_v04_PanStack.FCStd, Gladiator_Head_v04_PanStack.step, Gladiator_Head_v04_Pan_Drive_Pulley.stl, Gladiator_Head_v04_Pan_Raised_Pedestal.stl, Gladiator_Head_v04_Pan_Retainer.stl]
2026-10-01 cad: head v0.4 stage 2, the tilt side regenerated from code
    The tilt yoke, GH44 receiver, dual carrier and rear display frame were inherited from v0.3 with
    nominal holes. They are now built in build_head_v04.py:
    - yoke: servo window and M2 ear pilots for the measured SG90 (shaft 5.9 from the near end, long
    end up); the tilt pivot is an M3 bolt with a captive 6.0 nut in the tower, replacing a 4/3 bushing
    that is not in the parts bin
    - receiver: the tested register unchanged, 3.6 M3 holes, 6.0 nut pockets, and the same horn-plate
    pocket as the pan pulley, with a driver hole along the tilt axis
    - carrier: the tested key, calibrated holes; v0.1's generic sensor slots dropped (they ran thro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
    [Gladiator_Head_v04_GH44_Dual_Carrier.stl, Gladiator_Head_v04_GH44_Tilt_Receiver.stl, Gladiator_Head_v04_PanStack.FCStd, Gladiator_Head_v04_PanStack.step, Gladiator_Head_v04_Rear_Display_Frame.stl, Gladiator_Head_v04_Tilt_Yoke.stl]
2026-10-01 cad: head v0.4 released on three plates; final coupon results
    Jim's final coupon plate: H3b two-notch post wins (20.05), H6 one-notch snug horn pocket (0.15),
    H4b midway between 1 and 2 notches (M2 pilot 2.35). The generator now carries those values as
    settled. Rebuilt: only the rotor, servo carriage, tilt yoke and display frame changed (the pilots);
    still 0 collisions, 0 ToF, cable bore clear, master unchanged.
    Plates (none printed): 1 pedestal/retainer/cap (unchanged), 2 rotor/drive pulley/carriage
    (about 32 g, no supports), 3 tilt yoke/receiver/display frame (about 48 g, supports under the
    frame tabs). Held: Neck_Main, for one reading (ear underside to the top of the horn arms, model
    13.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
    [Gladiator_Head_v04_PLATE2_PanDrive_Rotor-Pulley-Carriage.3mf, Gladiator_Head_v04_PLATE3_Tilt_Yoke-Receiver-DisplayFrame.3mf, Gladiator_Head_v04_PanStack.FCStd, Gladiator_Head_v04_PanStack.step, Gladiator_Head_v04_Pan_Rotor.stl, Gladiator_Head_v04_Pan_Servo_Carriage.stl, Gladiator_Head_v04_Rear_Display_Frame.stl, Gladiator_Head_v04_Tilt_Yoke.stl]
2026-10-02 cad: INA226 cassette - 10 mm wire gap, 4 mm posts for 3 mm pin tails; ready to print
    Jim approved the 10 mm gap behind the terminals (6 was too tight for the wire bends) and
    measured about 3 mm between the bottom of the screw terminal and the board bottom, read as pin
    tails 3.0 below the PCB. Posts 3 -> 4 tall (1.0 clear). Board now hangs 12.2 past the deck front,
    pin tips 19.2. All checks pass; STL queued in the incoming folder, not printed. README gains print
    notes. components.md: the derived 2.2 tail is superseded.
    [Gladiator_INA226_Cassette_v1_print-upright.stl, INA226_Cassette_v1.FCStd, INA226_Cassette_v1.step, INA226_Cassette_v1_installed.stl]
2026-10-02 cad: head coupons round 3 - screen slice, sideways nut pocket, face-down GH44 register
    Three one-question checks (about 11 g) of features the released v0.4 parts rely on that no coupon tested: the real ST7789 in the frame pocket and window with the assumed hole offset; M3 nuts in 6.0 pockets printed sideways (neck collar, tilt pivot); the GH44 recess printed against the bed (the receiver prints face down). Dimensions copied from build_head_v04.py. All pieces single valid solids, orientation probed, meshes closed.
    [Gladiator_HeadR3_CouponPlate_3-pieces.3mf, Gladiator_HeadR3_R3a_ScreenSlice_notch-is-PIN-edge_bezel-face-down.stl, Gladiator_HeadR3_R3b_SidewaysNut_1notch-6.0_2notch-6.2_flat.stl, Gladiator_HeadR3_R3c_GH44Register_recess-DOWN.stl]
2026-10-03 cad: power tray v5 and INA226 cassette v2 - plain wells, thick walls, drop-on hook
    Jim printed v4 and the v1 cassette. The click bumps and 0.25 pegs were far too tight (the thin 1.0
    front wall tore off before a peg moved), the walls were far too weak, and the cassette pressure fit
    could not work. New versions; v4 and v1 stay as the record of what was printed.
    Tray v5 (52 checks): no bumps or grooves, plain wells; front, rear and floor 2.4 (floor grown downward,
    board height unchanged), 2x2 root gussets, 2.5 corner blocks, post-to-wall webs. Side walls stay 1.0
    (0.1 inside the rails). 19.29 cm3 (v4 15.62).
    Cassette v2 (28 checks): plate, lip over the wall top and two toes down the inside; d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
    [Gladiator_INA226_Cassette_v2_print-upright_SUPPORTS-from-bed.stl, Gladiator_PowerTray_v5_BaseLeft_print-tab-down.stl, Gladiator_PowerTray_v5_BaseRight_print-tab-down.stl, Gladiator_PowerTray_v5_FitCoupon_base-and-peg.stl, Gladiator_PowerTray_v5_print-on-rear-face.stl, INA226_Cassette_v2.FCStd, INA226_Cassette_v2.step, INA226_Cassette_v2_installed.stl]
2026-10-03 cad: power tray v5 arms back to the v3 design, opened 0.8 for the mast tube
    Jim: the new arm design does not clear the mast; go back to the v3 arm with the v4 dimensions.
    Measured on the solids: v3, v4 and the first v5 arms were all exactly 0.40 from the mast tube, so the
    scoop was never the difference; 0.4 is too tight for a printed part. v5 now has the v3 arm (full depth,
    no scoop) with the inner face opened 0.8 (29.1 -> 28.3): 1.2 to the tube, rim contact unchanged
    (50 mm2). 52 checks pass; not printed. Updated STLs replace the earlier v5 ones in the incoming folder.
    [Gladiator_PowerTray_v5_print-on-rear-face.stl, PowerBoardTray_v5.FCStd, PowerBoardTray_v5.step, PowerBoardTray_v5_installed.stl]
2026-10-03 cad: power tray v5 arms are exactly the v3 arm again
    Jim: the v4 lighter-arms pass turned the arm into a V; he only wanted more ceiling clearance and
    feet that go into a base, not an arm redesign. Reverts the V scoop and my 0.8 inner-face shave from
    the previous commit. A new check proves the taper, web and flare match v3 to 0.00 mm3 from the v3
    floor up. Mast gap 0.40 and rim contact as v3. 54 checks pass; not printed.
    [Gladiator_PowerTray_v5_print-on-rear-face.stl, PowerBoardTray_v5.FCStd, PowerBoardTray_v5.step, PowerBoardTray_v5_installed.stl]
2026-10-03 cad: power tray v5 - long arm beside the mast lowered to Z 34, same width
    Jim: the long arm beside the mast is too thick; chose "shorter (lower top)", same width. Its top
    comes down evenly from Z 40 to Z 34 (20 tall -> 14); a 45 degree ramp joins it to the full-height
    taper so it prints without support. The root block, taper, flare and post are proven identical to v3
    (0.00 mm3) and the arm was only lowered. 60 checks pass; not printed.
    [Gladiator_PowerTray_v5_print-on-rear-face.stl, PowerBoardTray_v5.FCStd, PowerBoardTray_v5.step, PowerBoardTray_v5_installed.stl]
2026-10-03 docs: round-3 coupon results - screen fits, sideways M3 nut pocket is the 1-notch 6.0
2026-10-04 docs: circlip fits; R3c GH44 recess prints about 1 mm shallow facing the bed
2026-10-04 cad: GH44 receiver register cut through the plate (R3c recess printed 1 mm shallow); R3d coupon
    [Gladiator_HeadR3d_CouponPlate_1-piece.3mf, Gladiator_HeadR3d_R3d_GH44Register_THROUGH-window_face-DOWN.stl, Gladiator_Head_v04_GH44_Tilt_Receiver.stl, Gladiator_Head_v04_PLATE3_Tilt_Yoke-Receiver-DisplayFrame.3mf, Gladiator_Head_v04_PanStack.FCStd, Gladiator_Head_v04_PanStack.step]
2026-10-04 docs: drop the R3d coupon at Jim request; through-window receiver is unproven until PLATE3 prints
    [Gladiator_HeadR3d_CouponPlate_1-piece.3mf, Gladiator_HeadR3d_R3d_GH44Register_THROUGH-window_face-DOWN.stl]
2026-10-05 Power switch holder v1: left rail, knob to rear, clips on the raceway floor
    Jim 2026-10-05: hold the slide power switch in the left rail rear leg space on the
    raceway floor; knob rear, pins forward, up = ON; clear of tray lift and upper deck.
    All solid checks pass. Switch calipered by Jim; knob width assumed <= 4.4. Not printed.
    [Gladiator_PowerSwitchHolder_v1_LEFT-rail_print-on-inboard-face_no-supports.stl, PowerSwitchHolder_v1.FCStd, PowerSwitchHolder_v1.step]
2026-10-05 Power switch holder v1b: mirrored onto the robot-left rail
    Jim: v1 fit the right leg, not the left. The master has the front at Y 0 and Z up, so
    low X (SideRailLeft) is physically the robot's right. v1b mirrors about X 39.5 and reruns
    every check against SideRailRight, the tray and Base right; all pass.
    Knob width 4.0 measured (5.0 window). v1 STL withdrawn. Not printed.
    [Gladiator_PowerSwitchHolder_v1b_robot-LEFT-rail_print-on-inboard-face_no-supports.stl, PowerSwitchHolder_v1b.FCStd, PowerSwitchHolder_v1b.step]
2026-10-06 cad: head-only master (Gladiator_Head_Master) built from the v05 head prototype
    Viewing file with the 26 head solids plus the mast tube, real robot coordinates,
    coloured, STEP and previews alongside. Generated by scripts/build_head_master.py;
    v05 and the chassis master are read only.
    [Gladiator_Head_Master.FCStd, Gladiator_Head_Master.step]
2026-10-06 cad: combined OrcaSlicer head plates with supports painted (A pan stack, B tilt and sensors, C neck)
    Three Orca projects with the EnderNeo / Generic PLA / 0.20 Standard settings embedded.
    Pedestal and display frame use manual support enforcers; Neck_Main is auto with blockers in
    the bores, tube-top lip and clamp-bolt ears, plus an 8 mm brim. Geometry is unchanged
    (all 13 parts match the released plates). Headless slices: 4h35 / 6h20 / 2h08, 144 g.
    [Gladiator_Head_ORCA-A_PanStack_Pedestal-Retainer-Cap_Rotor-Pulley-Carriage.3mf, Gladiator_Head_ORCA-B_TiltAndSensors_Yoke-Receiver-DisplayFrame-Carrier-ToF-Radar.3mf, Gladiator_Head_ORCA-C_Neck_Main_brim-and-supports.3mf]
2026-10-09 firmware: add Gladiator S3/C6 firmware, shared link code, host tests and tools
    Imported from the canonical C:\PlatformIO\Gladiator project under firmware/.
    Wi-Fi/OTA passwords are no longer in source: they live in the gitignored
    firmware/shared/secrets.h (template: secrets.example.h) and
    firmware/platformio_local.ini (template: platformio_local.ini.example).
    CAD artifacts and CAD generator scripts are left to the CAD tree.
    [partitions.csv]
2026-10-09 firmware: swap motor GPIO sides to match wiring
    [BoardConfig.h]
2026-10-09 Adopt mast-front frame across firmware, CAD, and notes
    Swap logical tracks and reverse both drive polarities; preserve physical GPIO wiring and trim calibration. Rebase derived IMU chassis orientation by 180 degrees, expose runtime orientation and pins, and preserve verified radio/heartbeat fixes. Record current frame in native CAD and front-facing head view without changing released print geometry. Verified S3 OTA and 80802 drive/trim plus 2025 quaternion cases. Exclude earlier uncommitted head-design work.
    [Gladiator_Head_Master.FCStd, Gladiator_Head_Master.step, Gladiator_Master.FCStd]
2026-10-21 Add v2 frame and shell: arch rails, deck v4.1, switch holder, INA mount, speaker, shell v2.8
    cad/v2/ holds the v2 frame and body work:
    - rails/v4-20261015: slim arch rails with deck pegs, direct heat-set inserts, shell hard points, switch foot
    - upper-deck/v4-20261016: deck v4.1 on the measured rail layout (confirmed fit); v3 kept as record
    - switch-enclosure/v3-20261016: open-rear switch holder, one M3, fits the rail foot or the hood cradle
    - ina-mount/v3-20261019: upright INA226 adapter that clips onto the printed power tray
    - speaker-mount/v1-20261020: shell-off speaker bracket on the left rail inserts
    - enclosure/v2-20261013: shell v2.8 (raised hood, rail-foot saddle, switch cradle, roof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
2026-10-22 Add M2 heat-set insert coupon and refresh v2 print plates
    - cad/coupons/m2-insert-v1: coupon M2-A, bores 2.8-3.8 nominal in an upright row and a sideways (bridged) row
    - print-plates: coupon plate CM2, regenerated plates, START_HERE updated
    - printer-calibration: M2 inserts adopted for all prints, bore pending the coupon
2026-10-22 Sync all outstanding work: drivers v5d/v5e, head v04/v05, camera service, ESP32-CAM case, notes
    Uploads everything that was sitting uncommitted on cad-lab so other agents can work from GitHub:
    - drivers: v5d head-relief and v5e countersink bases (scripts, validation, plate L, superseded plates)
    - head: v04 pan-stack updates, v05 sensor mounts, 2026-10-05 integration/review, camera service v2, ESP32-CAM case v4
    - reference/esp32-cam: ESP32-CAM STEP reference model
    - docs/ai: shared notes, decisions, handoff and agent logs (Claude and Codex)
    - measurements/mast-head.md and helper scripts
2026-10-22 Round 5 shell styling and print release, stronger shield emblems, M2 D3L3 coupons
    - cad/v2/enclosure/round5-20261021: Round 5 styling (curved scuta, tablets, aquila, head crest/clamps), derived additively from shell v2.8
    - cad/v2/enclosure/round5-print-20261022: print variant, Orca plates, SD release scripts and reports, fit-test seats
    - round5-print-20261022/emblem-v2: stronger white shield emblems (1.8 mm, recess-filling base, wider top, printed on the back), plate 04B
    - cad/coupons/m2-d3-l3-20261022 and m2-d3-l3-mini-20261022: M2 D3 L3 heat-set insert coupons
    - scripts/build_v2_orca_plates.py: emblem plate added; docs/ai notes and agent logs updated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
2026-10-23 Re-slice Round 5 print jobs on Jim's own Orca presets; commit pending Round 5 calibrated/mount-checked work
    Round 5 G-code had been sliced from hand-edited settings (0.20 first layer, 0.12-0.28 layers,
    slower walls, SAFE hook blank). All five jobs re-sliced with Jim's flattened presets, supports on
    where needed. SAFE guard, bed bounds, SD pause replay and fastener-path support checks included.
    Also commits Codex's pending calibrated-28 / mount-checked sources, reports and CAD (bulk ignored).
2026-10-23 Final Gladiator print set: emblem cradle, M600 colour changes, normal supports on shell
2026-10-23 Gladiator shell at 0.28 mm layers: hood 9h39, panels 7h24
2026-10-23 Gladiator silk job with 5 mm brim
